phageweb/dron/spec/realna_stavba_dronu/README.md

# Reálná stavba OpenIPC cinewhoopu

Tato větev popisuje fyzickou stavbu plánovaného 3" cinewhoopu. Je oddělená od obecné ROS 2 části, protože hardware má jiné otázky: mechanika, napájení, firmware, pájení, bezpečnost a postupné oživování.

## Cílová konfigurace

- Rám: GEPRC CineLog30 V3
- Typ: 3" ducted cinewhoop
- Konfigurace: quad X
- Motory: 4x GEPRC SPEEDX2 1404 3850 KV
- Vrtule: 3", přibližně 76.2 mm
- FC/ESC: MicoAir H743 V2 45A AIO
- Firmware: cílově ArduPilot
- Baterie: 4S LiHV Tattu 750 mAh
- RC: ExpressLRS, SpeedyBee ELRS Nano RX
- Video: RunCam WiFiLink 2 s OpenIPC
- Indoor senzory: MicoAir MTF-02P optical flow + downward rangefinder/lidar
- Přední obstacle senzor: **LDRobot LD06**, 360° 2D lidar, vybraný kvůli SLAM
  ([rozhodnutí](../../workflow/decisions.md)). Není volitelný a není zadarmo —
  s ním je sestava 294 g a v ní pak není místo na palubní počítač, který by sken
  dostal do ROS 2; rozbor je v
  [Kudy se sken dostane do ROS 2](./09_kudy_do_ros.md)

**Druhý drak.** Ta hmotnost vedla k nacenění alternativního rámu: tentýž náklad
na **BetaFPV Pavo20 Pro** ve 4S provedení vyjde na 219 g a o 3 423 Kč levněji.
Díly z Rotoramy CZ jsou už koupené, viz [Nakoupeno](./13_nakoupeno.md).
Létá v simulaci proti stejným checkům. Viz [Pavo20 jako nosič LD06](./10_pavo20.md)
a [Kusovník Pavo20 Pro](./11_kusovnik_pavo20.md).

## Cíl reálné větve

Postavit fyzický dron tak, aby:

- bezpečně letěl jako ručně ovladatelný cinewhoop
- měl ArduPilot na reálném flight controlleru
- poskytoval data použitelná pro ROS 2 companion computer
- měl stejné nebo snadno remapovatelné ROS topics jako simulace
- umožnil pozdější SLAM, VIO, OpenCV a OpenIPC experimenty

## Co sem nepatří

- obecné učení ROS graphu
- obecné publisher/subscriber demo
- čistě simulační Gazebo fyzika
- Nix flake jako jediný problém

Tyto věci jsou ve větvi [ROS 2 na NixOSu](../ros2_nixos/README.md).

## Bezpečnostní zásada

Všechny bench testy flight controlleru, ESC, motorů, ArduPilot konfigurace a ROS komunikace se dělají bez vrtulí. Vrtule se nasazují až po ověření směru motorů, failsafe, arm/disarm, RC linku a základního režimu letu.

## Dokumenty této větve

- [Plán stavby](./01_plan_stavby.md) - fáze od potvrzení komponent po první let
- [Rozhraní simulace vs. reálný dron](./02_rozhrani_sim_real.md) - co se nesmí lišit
- [Tabulka komponent](./03_komponenty.md) - hmotnosti, napětí, konektory, datová rozhraní
- [Bench checklist bez vrtulí](./04_bench_checklist.md) - celé oživení až po první nasazení vrtulí
- [Díly pro CAD model](./05_cad_dily.md) - geometrie a montáž, na rozdíl od kusovníku
- [Kde se co koupí](./06_nakup.md) - nákupní seznam, ceny a dostupnost
- [Alternativy a zkušenosti](./07_alternativy_a_zkusenosti.md) - k čemu se dá u každého dílu sáhnout a co s tím lidé zažili
- [Kalkulace dopravy](./08_kalkulace_dopravy.md) - co se vyplatí dovézt a co ne, CZ vs AliExpress vs Allegro
- [Kudy se sken dostane do ROS 2](./09_kudy_do_ros.md) - cesty ven, které padly, a co zbývá: OSD na koupených čipech
- [Pavo20 jako nosič LD06](./10_pavo20.md) - co by stálo dostat lidar i video pod 250 g
- [Kusovník Pavo20 Pro](./11_kusovnik_pavo20.md) - co koupit, kde a za kolik, rozdělené na dvě etapy
- [Nakoupeno](./13_nakoupeno.md) - co už je zaplacené, za kolik, a co z kusovníku chybí
- [Postup stavby Pavo20 Pro](./14_postup_stavby_pavo20.md) - od firmwaru po první let, s piny a parametry
- [Test linky pro sken](./15_test_linky_skenu.md) - OSD Walksnailu a Bluetooth modul: co se měří a co kam zapojit; AIO vlastní Bluetooth nemá

## Návaznost na simulaci

Reálná stavba má držet stejné logické rozhraní jako simulace:

```text
/openipc_cinewhoop/imu
/openipc_cinewhoop/range/down
/openipc_cinewhoop/scan/front
/openipc_cinewhoop/camera/image_raw
/openipc_cinewhoop/odom
/ap/*
```

Detaily jsou v [rozhraní simulace vs. reálný dron](./02_rozhrani_sim_real.md).
