phageweb/dron/model/stazene/README.md

# Stažené modely

Podklady pro TPU věž Pavo20 s Walksnail Ascent Lite+ (viz
[kusovník](../../spec/realna_stavba_dronu/11_kusovnik_pavo20.md#co-se-musí-vyrobit)).
Ani jeden nesedí na Lite+ beze změny. Staženo z Printables 12. 10. 2026.
Cockpit (ASCII STL, 43 MB) není v gitu, při potřebě stáhnout znovu z odkazu.
Pořadí a další kandidáti jsou v `nejvhodnejsi_modely.txt`.

| Složka | Model | Autor | Licence | K čemu |
|---|---|---|---|---|
| `pavo20-ascent-cockpit/` | [Pavo20 Ascent Cockpit](https://www.printables.com/model/1689368-pavo20-ascent-cockpit) | Kurukuru | Open Community License v1 | Na rám Pavo20 Pro a kameru Ascent. Díry pro VTX jsou 25 mm (Lite), Lite+ potřebuje 20 × 20. ~8 g, tvrdý plast, 8 M2 zalisovaných vložek. |
| `pavo-20-pro-canopy-fenouil/` | [Pavo 20 pro canopy](https://www.printables.com/model/1577601-pavo-20-pro-canopy) | Fenouil | CC Public Domain | Pro O4 Lite. Obsahuje **STEP**, takže je to základ pro vlastní věž: úchyty k rámu, sklony kamery 7–47°. |
| `walksnail-ascent-lite-tinywhoop-canopy/` | [Walksnail Ascent Lite Tinywhoop Canopy](https://www.printables.com/model/1525645-walksnail-ascent-lite-tinywhoop-canopy) | P3D | CC BY-SA | Obecný pro whoopy, ne pro Pavo20. TPU, 0,76 g, sklon 25°. |
