phageweb/dron/spec/realna_stavba_dronu/14_postup_stavby_pavo20.md

# Postup stavby Pavo20 Pro

Celý postup od krabic na stole po první let, pro díly, které jsou opravdu
koupené — viz [Nakoupeno](./13_nakoupeno.md). Obecná pravidla a stop podmínky
jsou v [bench checklistu](./04_bench_checklist.md); tenhle soubor je jeho
konkrétní pořadí pro tuhle sestavu, s piny a parametry.

Pravidlo platí i tady: **když krok neprojde, další se nezačíná.** A vrtule se
nasazují až v kroku 9.

Parametry jsou ověřené z dokumentace ArduPilotu a karty MicoAir k 2. 10. 2026,
ne na kusu. Kde to tak není, je to napsané.

## Stav na stole k 21. 10. 2026

Deska 2 (`49002F…`), ArduCopter 4.7.1 (git `dbe79216`, ověřeno 21. 10. přes
`AUTOPILOT_VERSION`), zdroj 14–16 V nebo baterie 4S.
Parametry jsou v
[`deska2_na_stole_2026-10-21.parm`](../../firmware/params/deska2_na_stole_2026-10-21.parm),
po motor testu, BDShot, gainech a baterii v
[`deska2_po_motorech_2026-10-21.parm`](../../firmware/params/deska2_po_motorech_2026-10-21.parm).

Hotovo a vyzkoušené:

- **XR1 na UART6** (`SERIAL6_PROTOCOL 23`, `RSSI_TYPE 3`), spárovaný s TX15,
  16 kanálů, RSSI 254. Kalibrace RC v QGC; QGC sám obrátil pitch
  (`RC2_REVERSED 1`).
- **Přepínače na TX15:** **SE** → CH5 → arm/disarm (`RC5_OPTION 153`),
  **SA** → CH6 → režimy (`FLTMODE_CH 6`): nahoře Stabilize, uprostřed
  AltHold, dole Loiter. CH7 a CH8 zatím bez funkce.
- **Akcelerometr** v 6 polohách. `AHRS_TRIM_X` vyšel 3,5°, deska ještě nebyla
  v rámu — **Level Horizon zopakovat po přišroubování**.
- **Arm/disarm** přepínačem SE, motory na volnoběhu (`MOT_SPIN_ARM 0.1`).
- **Failsafe:** vypnutý TX15 → `Radio Failsafe - Disarming`.
- **Baterie 4S:** `BATT_LOW_VOLT 14.0`, `BATT_CRT_VOLT 13.2`,
  `BATT_FS_LOW_ACT 1`, `BATT_FS_CRT_ACT 1`. Battery failsafe zůstává
  zapnutý až do restartu FC, i když napětí vystoupá.
- **ESC (AM32 2.19)** srovnaná na stejné hodnoty a **směry motorů** ověřené,
  viz krok 5.

Dočasně vypnuto, aby šel arm bez GPS a lidaru. Při zapojování vrátit:

| Parametr | Teď | Původně |
| --- | --- | --- |
| `GPS1_TYPE` | 0 | 1 |
| `COMPASS_ENABLE` | 0 | 1 |
| `PRX1_TYPE` | 0 | 15 (lidar přes Lua skript) |
| `EK3_SRC1_POSXY` / `VELXY` / `YAW` | 0 / 0 / 0 | 3 / 3 / 1 |

Bez zdroje polohy poletí jen Stabilize a AltHold, do Loiteru FC nepřepne.

Nesoulad s rozvržením UARTů níže: lidar má Scripting na **SERIAL4**
(`SERIAL4_PROTOCOL 28`), SERIAL5 je vypnutý — UART4 je přitom určený pro
MTF-02P. Ověřit, na kterém padu lidar fyzicky je.

## 0. Příprava

- [ ] Každý díl zvážit (váha s rozlišením 0,01 g) a hmotnost zapsat do
      [Nakoupeno](./13_nakoupeno.md). Žádná hmotnost v projektu ještě zvážená
      není — teď je jediná chvíle, kdy jde vážit díly jednotlivě.
- [ ] Baterie: změřit napětí článků, nabít na storage (LiHV kolem 3,85 V na
      článek), uložit v lipo bagu.
- [ ] Laboratorní zdroj: kabel zakončený XT30 samicí, polarita ověřená
      multimetrem.

## 1. Firmware — jen přes USB

Deska se napájí z USB, baterie ani zdroj nejsou potřeba.

- [ ] Target **`MicoAir743v2`** (MicoAir pro desku *MicoAir743v2-AIO-45A*;
      ArduPilot ho podporuje od 4.6.0). Firmware:
      `firmware.ardupilot.org/Copter/stable-4.7.1/MicoAir743v2/`.
- [ ] Nahrát ArduCopter 4.7.1 podle [`firmware/`](../../firmware/README.md) —
      flake s připnutým firmwarem a nástroji:

      ```sh
      nix run ./firmware#flash      # na desce už je ArduPilot
      nix run ./firmware#flash-dfu  # Betaflight z výroby: držet BOOT, připojit USB
      ```
- [ ] `FRAME_CLASS 1`, `FRAME_TYPE 1` (quad X), restart.
- [ ] Parametry uložit do souboru **před** jakoukoli další změnou.
- [ ] Gyro v klidu kolem nuly, barometr reaguje na zvednutí ze stolu.
      Akcelerometr až v kroku 6, v sestaveném dronu — holá deska na USB se
      do bočních poloh nedá postavit, konektor ji podpírá a vypadává.

## 2. Mechanika nasucho

- [ ] Rám složit bez pájení. **Ověřit, že je to Pavo20 Pro, ne Pro II**
      ([rozdíl](./10_pavo20.md#pro-versus-pro-ii)).
- [ ] Motory A1204 na ramena (díry 9 mm, M2). **Protočit rukou a změřit
      mezeru zvonu proti ductu** — A1204 je o 1,2 mm širší než 1104, na který
      je rám dělaný. Drhne-li, dál se nejde.
- [ ] Délka šroubů motoru: šroub nesmí sáhnout do vinutí. Změřit, ne odhadnout.
- [ ] AIO na soft-mountech, šipkou nahoru. Díry 26 × 26 v karbonu a vložky
      v ductu tvoří kosočtverec (vpředu, vzadu, po stranách), takže deska je
      **natočená o 45°**. USB-C šikmo dozadu vlevo, k motoru 2: pady baterie
      pak míří dozadu vpravo, konektor HD VTX dopředu vpravo a šipka vlevo
      dopředu, tedy `AHRS_ORIENTATION 7` (Yaw315). Odvozeno z výkresů BetaFPV
      a MicoAir, ověřit na kusu. USB-C musí být v sestaveném rámu dostupný.
- [ ] Šroub M2×14 shora: karbon, matka, tlumič AIO delším koncem nahoru, AIO,
      kratší konec, matka, mosazná vložka v ductu. Pod spodní maticí aspoň
      3–4 mm závitu, jinak spodní matku vynechat.
- [ ] Zkusmo umístit: XR1, GPS, MTF-02P (dolů, **mimo půdorys baterie**),
      kameru Lite+ a VTX. Kde co bude, rozhoduje o délkách vodičů v kroku 3.
- [ ] Baterii 750 mAh zasunout do slotu a zkontrolovat, že sedí a nic netlačí.

## 3. Pájení napájení a motorů

- [ ] XT30 přívod a kondenzátor (oboje přibalené k AIO) na hlavní pady.
      Polarita podle desky, ne podle barvy kabelu.
- [ ] Motorové vodiče zkrátit na délku a připájet na pady M1–M4. Pořadí
      vodičů jednoho motoru je jedno — směr se nastaví softwarově v kroku 5.
- [ ] Vizuálně: žádný cínový můstek, nic se nedotýká karbonu.
- [ ] **Multimetrem mezi + a − XT30: žádný zkrat** (pod ~10 Ω = stop).
- [ ] První napájení z **laboratorního zdroje: 16 V, limit 0,3–0,5 A**. Proud
      v klidu jsou desetiny ampéru; skočí-li hned na limit a napětí spadne,
      je zkrat — odpojit a hledat.
- [ ] Změřit **5V BEC** (5,0 V ± 0,2) a **12V BEC**. Hodnotu 12V BEC zapsat —
      podle ní se v kroku 7 rozhodne, jestli na něj smí Lite+ (strop 12,6 V).

## 4. Přijímač XR1 Nano

| XR1 | AIO |
| --- | --- |
| 5V | 5V |
| GND | GND |
| TX | RX6 |
| RX | TX6 |

- [ ] Parametry: `SERIAL6_PROTOCOL 23` (RCIN), `RSSI_TYPE 3`.
- [ ] Stejná hlavní verze ELRS v TX15 a v XR1. Binding phrase nastavit v obou
      (XR1 přes WiFi: ~60 s bez spojení, pak `10.0.0.1`).
- [ ] Kalibrace RC. Roll, pitch, throttle, yaw jdou správným směrem.
- [ ] Kanál na arm/disarm (`RCx_OPTION 153`) a na letové režimy
      (`FLTMODE_CH`): Stabilize, AltHold, Loiter.
- [ ] `FS_THR_ENABLE 1`. **Vypnout TX15 → FC musí hlásit failsafe.** Bez toho
      dál ne.

## 5. Motory bez vrtulí

Teď už z baterie (nebo ze zdroje s limitem zvýšeným na 2–3 A). Dron přidržet.

- [x] `MOT_PWM_TYPE 6` (DShot600). Bidirectional DShot (`SERVO_BLH_BDMASK 15`,
      `SERVO_BLH_POLES 14`) jen pokud ho target na výstupech 1–4 umí —
      počet pólů ještě ověřit spočítáním magnetů ve zvonu. Umí (`BIDIR` na
      TIM1 v hwdef) a funguje, zapnuto 21. 10. Dvě pasti:
      - AM32 pozná bidirectional režim jen při svém startu. Po změně
        `SERVO_BLH_BDMASK` nestačí restart FC, musí se odpojit baterie i USB.
      - Se sinusovým rozběhem hlásí AM32 na nízkém plynu otáčky 0 (motor
        běží naslepo, bez back-EMF). Na 5 % nula, na 15 % motor test
        5 040–5 510 ot./min na všech čtyřech, s nulovou chybovostí v logu
        (`ESC.Err`). Telemetrie v `ESC_TELEMETRY_1_TO_4` je podle výstupů:
        A = 1, C = 2, D = 3, B = 4.
- [x] Motor test v QGC/Mission Planneru, 5–10 % plynu: test A musí roztočit
      **přední pravý**, B zadní pravý, C zadní levý, D přední levý (ArduPilot
      testuje po obvodu). Nesedí-li to, přeházet `SERVO1..4_FUNCTION`
      (33–36), ne pájet znovu. Sedí s výchozími `SERVO1..4_FUNCTION`
      33–36 (21. 10., z baterie 4S, 7 % po 2 s a po 10 s, pymavlink
      `MAV_CMD_DO_MOTOR_TEST`).
- [x] Směry: přední pravý a zadní levý **CCW**, přední levý a zadní pravý
      **CW** (pohled shora). Pravidlo, které platí i při pohledu zespodu:
      lopatky na předku i na zadku dronu jdou **ke středové ose**.
      `SERVO_BLH_RVMASK` na AM32 2.19 nefunguje (zkoušeno 21. 10.), otáčí se
      v ESC: **Reverse Rotation na M3 a M4** (výstup 3 = přední levý D,
      výstup 4 = zadní pravý B).
- [x] ESC srovnaná na výrobní hodnoty + sinusový rozběh, na všech čtyřech:
      Complementary PWM ☑, Stuck Rotor Protection ☑, Sinusoidal Startup ☑,
      Variable PWM ☑, Timing 14,06, KV 5220, 14 pólů, Startup Power 100.
      Dřív se lišila (M2 bez Complementary PWM se točil znatelně rychleji).
      Webové configuratory AM32 2.19 neumí, jen desktopový ESC Config Tool
      1.97 (`appimage-run`); po jeho zavření zůstane FC v passthrough a
      potřebuje restart napájení.
- [x] `MOT_SPIN_ARM` a `MOT_SPIN_MIN` z motor testu: nejnižší hodnota, kdy se
      všechny čtyři točí spolehlivě, + rezerva. Bez vrtulí se to zjistit
      nedá: 21. 10. se všechny čtyři točily plynule i na 1 % (po 6 s), AM32
      se sinusovým rozběhem roztočí motor bez zátěže skoro na čemkoli.
      Zůstává výchozí `MOT_SPIN_ARM 0.10`, `MOT_SPIN_MIN 0.15`; snížit až
      podle logu z letu (klesání, desync).
- [ ] Nic se nepřehřívá, nedrhne, nehrká.

## 6. Senzory

**Akcelerometr** (dron složený, AIO na soft-mountech, bez baterie, jen USB):

- [ ] Kalibrace v 6 polohách na hranách rámu, pak level na rovném stole.
      Bez ní ArduPilot neodjistí (`3D Accel calibration needed`).
- [ ] Natočení desky sedí s `AHRS_ORIENTATION`: při nose-down ukazuje
      umělý horizont nos dolů, při náklonu doprava náklon doprava.

**MTF-02P** (optical flow + dolní rangefinder):

- [ ] Nejdřív v MicoAssistant změnit `mav_id` na 200 — od ArduPilotu 4.5
      ho jinak nemusí poznat.
- [ ] Zapojit na UART4: 5V, GND, TX → RX4, RX → TX4.
- [ ] `SERIAL4_PROTOCOL 1`, `SERIAL4_BAUD 115`, `FLOW_TYPE 5`,
      `RNGFND1_TYPE 10`, `RNGFND1_MIN 0.01`, `RNGFND1_MAX 6`,
      `RNGFND1_ORIENT 25`. Od 4.7 `MAV4_OPTIONS 2`, dřív `SERIAL4_OPTIONS 1024`.
- [ ] Výška nad stolem sedí s pravítkem ve dvou výškách; flow reaguje na ruční
      posun; při točících se motorech (bez vrtulí) nevypadává.

**GPS M181 s kompasem:**

- [ ] UART3: 5V, GND, TX → RX3, RX → TX3; kompas na SDA/SCL.
- [ ] `SERIAL3_PROTOCOL 5`. Kompas nakalibrovat **v sestaveném dronu**.
- [ ] Rozhodnout, co s kompasem uvnitř: checklist říká vypnout, jenže EKF bez
      kompasu nemá yaw pro Loiter na flow. Pro první lety (Stabilize,
      AltHold) to jedno je — **otevřená otázka**, zapsat výsledek.

## 7. Video Walksnail Lite+

- [ ] **Napájení: nikdy z baterie.** 12V BEC jen pokud v kroku 3 naměřil
      nejvýš ~12,3 V. Jinak řešit (dioda, samostatný BEC) dřív, než se pájí.
- [ ] Zapojit na UART2: 12V, GND, TX → RX2, RX → TX2 (OSD).
- [ ] `SERIAL2_PROTOCOL 42` (DisplayPort), `SERIAL2_BAUD 115`, `OSD_TYPE 5`,
      `MSP_OPTIONS 4` (Betaflight fonty).
- [ ] Spárovat s **VRX Pro**, obraz přes HDMI na monitor/brýle. **Anténu
      připojit vždy dřív, než se VTX zapne.**
- [ ] Kameru a VTX upevnit — dočasně, dokud není [TPU věž](./11_kusovnik_pavo20.md#co-se-musí-vyrobit).

## 8. Baterie a failsafe

Hodnoty ze simulace (`ardupilot_params_pavo20.parm`):

- [ ] `BATT_MONITOR 4`; napětí na desce porovnat s multimetrem, případně
      opravit `BATT_VOLT_MULT`. Proud ověřit až za letu.
- [x] `BATT_LOW_VOLT 14.0`, `BATT_CRT_VOLT 13.2`, `BATT_FS_LOW_ACT 1`,
      `BATT_FS_CRT_ACT 1`, `BATT_LOW_TIMER 10` — přistát, ne vracet se.
- [x] Rate gainy ze simulace (`ATC_RAT_RLL/PIT_P 0.060` atd.) brát jako
      **strop**, ne startovní hodnotu: simulace nemá šum gyra ani rezonance
      rámu. **Nepřebírat** `MOT_PWM_MIN/MAX`, `MOT_THST_EXPO 1.0` a `SIM_*` —
      to jsou hodnoty modelu, ne dronu. Nastaveno 21. 10. místo výchozích:
      roll/pitch P 0,060, I 0,060, D 0,0005 (bylo 0,135 / 0,135 / 0,0036),
      yaw P 0,023, I 0,0023 (bylo 0,18 / 0,018).
- [x] `BATT_CAPACITY 750` (bylo 3300; s 550mAh baterií procenta nesedí).
      Kompenzace napětí pro LiHV 4S: `MOT_BAT_VOLT_MAX 17.4`,
      `MOT_BAT_VOLT_MIN 13.2`.
- [x] Pro spektrum po prvním letu: `INS_LOG_BAT_MASK 1`,
      `INS_LOG_BAT_OPT 4` (gyro před filtrem i po něm).

## 9. Vrtule a první let

- [ ] **42g maketa LD06** na místě lidaru — ladí se jednou, s ní.
- [ ] Vrtule Gemfan 2218 podle směrů z kroku 5.
- [ ] Venku nebo ve velké místnosti, nikdo v dosahu. Arm ve Stabilize, krátký
      visení nízko. Kmitá-li, přistát a snížit `ATC_RAT_*_P`.
- [ ] Failsafe znovu za letu: vypnout TX15 v metru nad zemí.
- [ ] Teprve pak AltHold, pak AutoTune, pak Loiter na flow.
- [ ] Po letu: log, harmonic notch (`INS_HNTCH_*`) podle spektra, výdrž proti
      odhadu 4,0 min.

## 10. Etapa B — LD06

- [ ] Kabel ZH1.5T-4P → AIO, jen TX lidaru → RX5 (nebo RX8), 5V, GND.
- [ ] `SERIAL5_PROTOCOL 11` (Lidar360), `SERIAL5_BAUD 230`, `PRX1_TYPE 16`,
      `PRX1_ORIENT 0`.
- [ ] Přeměřit 5V větev při rozběhu lidaru (300 mA).
- [ ] Maketu vyměnit za lidar; hmotnost a těžiště se nemění, gainy zůstávají.

## Rozvržení UARTů

| UART | Výchozí v ArduPilotu | Tady |
| --- | --- | --- |
| 1 | MAVLink2 | volný (telemetrie, palubní počítač) |
| 2 | DisplayPort | Walksnail Lite+ OSD |
| 3 | GPS | M181 |
| 4 | MAVLink2 | MTF-02P |
| 5 | — | LD06 (etapa B) |
| 6 | RCIN | XR1 Nano |
| 8 | — | volný |

Mapování UARTů je z karty MicoAir; **které pady na desce jsou který UART,
ověřit na potisku a pinoutu desky** dřív, než se pájí.
