phageweb/dron/spec/realna_stavba_dronu/11_kusovnik_pavo20.md

# Kusovník Pavo20 Pro

Co koupit na indoor mapovací cinewhoop postavený na rámu **BetaFPV Pavo20 Pro**
ve 4S provedení, se stejnou nosností jako CineLog30 V3 — LD06, MTF-02P — a
s videem **Walksnail Ascent Lite+** místo původního EMAX Wyvern. Úvaha, proč
zrovna tenhle drak a co to stojí, je vedle v
[Pavo20 jako nosič LD06](./10_pavo20.md); tenhle soubor je jen nákupní seznam.

Ceny a skladovost ověřené **13. 9. 2026** přímo z karet zboží. Kurzy ČNB
11. 9. 2026: 1 € = 24,26 Kč, 1 $ = 20,93 Kč. **Hmotnosti jsou publikované,
žádná není zvážená.**

Etapa A jsou **dvě české objednávky plus Walksnail Ascent Lite+**, který
Rotorama CZ k 28. 9. 2026 nevede (má jen obyčejný Ascent Lite Kit) — cena je
zatím výrobcova. Dovoz je jinak potřeba jen na lidar, protože 2D lidar v téhle
váhové třídě se v ČR nevede vůbec.

**Rotorama CZ je zaplacená** a koupila se v ní jiná baterie, než tu stálo —
co přesně přišlo, je v [Nakoupeno](./13_nakoupeno.md). Tabulky níž počítají
s tím, co se opravdu koupilo.

## Etapa A — létající stroj

| Díl | Ks | Hmotnost | Cena | Kde | Stav |
| --- | ---: | ---: | ---: | --- | --- |
| [BetaFPV Pavo20 Pro, rám pro O3](https://www.hobbydrone.cz/cs/frame-betafpv-pavo20-for-o3-air-unit-clear-grey/) | 1 | 28,70 g | 353 Kč | hobbydrone.cz | koupeno |
| [Flashhobby A1204 5200KV](https://www.rotorama.cz/product/flashhobby-a1204-5200kv) | 4 | 24,80 g | 1 076 Kč | Rotorama CZ | koupeno |
| [Gemfan 2218-3, 12 ks](https://www.rotorama.cz/product/gemfan-2218) | 1 | 2,32 g | 179 Kč | Rotorama CZ | koupeno |
| [MicoAir H743 V2 45A AIO](https://www.rotorama.cz/product/micoair-h743-v2-45a-aio-am32) | 1 | 10,00 g | 2 090 Kč | Rotorama CZ | koupeno |
| [Radiomaster XR1 Nano ELRS](https://www.rotorama.cz/product/radiomaster-xr1-nano-elrs-dual) | 1 | 1,60 g | 349 Kč | Rotorama CZ | koupeno |
| MicoAir MTF-02P | 1 | 1,50 g | 499 Kč | Rotorama CZ | koupeno |
| [Walksnail WS-M181 GPS s kompasem](https://www.rotorama.cz/product/walksnail-ws-m181-gps-s-kompasem) | 1 | 4,30 g | 429 Kč | Rotorama CZ | koupeno |
| [Walksnail Ascent HD Lite+ Kit](https://www.caddxfpv.com/products/walksnail-ascent-hd-lite-plus-kit), kamera + VTX | 1 | 10,50 g | 837 Kč | caddxfpv.com | objednáno, 39,99 $ |
| [Tattu R-Line 750 mAh 4S 95C HV, XT30](https://www.rotorama.cz/product/tattu-r-line-750mah-4s-95c-hv) | 1 | 69,00 g | 529 Kč | Rotorama CZ | koupeno |
| [Tattu 550 mAh 4S 95C HV, XT30](https://www.rotorama.cz/product/tattu-550mah-4s-95c-hv), záložní | 1 | — | 419 Kč | Rotorama CZ | koupeno |
| TPU věž pro Lite+ a stožár lidaru | 1 | 11,00 g | — | tiskárna | odhad |
| Kabeláž, šrouby, pásek | — | 13,36 g | — | dílna | odhad |
| **Etapa A** | | **177,08 g** | **6 760 Kč** | 3 zásilky | |

Hmotnost počítá s 750mAh packem, protože se s jedním letí. Cena je za oba.
Původně tu byly tři 850mAh packy po 76 g; koupené jsou dva různé. S LD06 dá
750 mAh zhruba **4,0 minuty** užitečného letu, 550 mAh (57 g) **3,2 minuty** —
stejná metoda jako v [Pavo20 jako nosič LD06](./10_pavo20.md#tah-a-výdrž).
Při téhle výdrži je jeden pack jeden pokus, takže **třetí pack ještě chybí**.
Packy se liší o 12 g a tvarem, tedy i těžištěm — ladit na 750, na 550 jen
ověřit, že stroj drží.

## Etapa B — lidar, až stroj létá

| Díl | Ks | Hmotnost | Cena | Kde | Stav |
| --- | ---: | ---: | ---: | --- | --- |
| [LDRobot LD06](https://sunhokey.cn/products/dtof-lidar-ld06) | 1 | 42,00 g | 1 580 Kč | dovoz CN | až po kontrole štítku |
| **Finální stroj** | | **219,08 g** | **8 340 Kč** | 4 zásilky | |

**Do etapy A patří 42g maketa lidaru.** Bez ní letí stroj na 177,1 g s tahem
k váze 4,6; s lidarem na 219,1 g a 3,7. To je o pětinu jiný stroj, jiné
těžiště, jiná setrvačnost, jiné gainy. S maketou se ladí jednou.

## Textově za sebou

Rám Pavo20 Pro bez držáku O3 28,70 g · motory 4× Flashhobby A1204 5200KV
24,80 g · vrtule Gemfan 2218 (sada) 2,32 g · MicoAir H743 V2 45A AIO 10,00 g ·
Walksnail Ascent Lite+ 10,50 g · Radiomaster XR1 Nano ELRS 1,60 g ·
MicoAir MTF-02P 1,50 g · Walksnail WS-M181 GPS 4,30 g · TPU věž a stožár
11,00 g · kabeláž, šrouby a pásek 13,36 g · baterie Tattu 750 mAh 4S LiHV
69,00 g — **etapa A 177,08 g**; plus LDRobot LD06 42,00 g —
**celkem 219,08 g**.

## Objednávky

| Zásilka | Co v ní je | Zboží | Doprava | Sazba |
| --- | --- | ---: | ---: | --- |
| Rotorama CZ | motory, vrtule, AIO, přijímač, MTF-02P, GPS, 2× baterie | 5 570 Kč | 49 Kč | **zaplaceno** |
| caddxfpv.com | Walksnail Ascent Lite+ | 837 Kč | ? | **objednáno**, doprava neznámá |
| hobbydrone.cz | rám Pavo20 Pro | 353 Kč | 99 Kč | odhad |
| Sunhokey, CN (etapa B) | LDRobot LD06 | 1 580 Kč | 419 Kč | odhad |
| **Celkem** | 4 zásilky, z toho 3 hned | **8 340 Kč** | **567 Kč** + Caddx | **8 907 Kč** + doprava Caddx |

Proti CineLogu, který v konsolidované variantě vychází na 12 330 Kč v **pěti**
zásilkách, je to o **3 423 Kč méně** (bez dopravy od Caddx) a o jednu zásilku. Těch
12 330 Kč je i s dopravou, takže se porovnávají s 8 907 Kč, ne se zbožím.
Vybavení dílny z téže objednávky (1 975 Kč) v tom není. Kusovník CineLogu tak, jak
byl napsaný, stojí 12 548 Kč v šesti — varianty a jejich rozpad jsou
v [Kalkulaci dopravy](./08_kalkulace_dopravy.md).

## Co se musí vyrobit

- **TPU věž** nesoucí Walksnail Lite+ a nahoře plošinu pro LD06: vpředu klec
  pro 14mm nano kameru se sklonem, uprostřed sloupky 20 × 20 M2 pro VTX, úchyt
  IPEX antény. Místo klece jde i hotový adaptér 14 → 19 mm do stock držáku
  kamery (19/20 mm). Nahrazuje 4,6g držák
  O3, který se stejně nepoužije. **Navrhnout dřív, než se cokoli objedná** — je
  to jediná věc, která o téhle stavbě ještě rozhoduje.
- **Maketa LD06** 38,6 × 38,6 × 33,3 mm dovážená na 42 g, pro etapu A.
- **Kabel LD06** z konektoru ZH1.5T-4P (rozteč 1,5 mm) na JST-SH 1,0 mm nebo
  přímo na pájecí plošky. Koupit protikus s vodiči a zakončení upravit.
- **Spodní držák MTF-02P** mimo půdorys baterie — ta visí zespodu ve slotu a
  18 mm široká by senzoru stála přesně ve výhledu dolů.

## Co nekupovat

- **Hotový Pavo20 Pro.** Stock F4 je 2-3S a AP_DDS na něm neběží. Kupuje se rám.
- **Motory 7200KV ani 7500KV.** Jsou na 3S; na 4S je upálíš a 3S stojí třetinu
  doletu.
- **1104 motory s roztečí 8,5 mm.** DarwinFPV Bling 1104 5000KV je skladem a KV
  sedí, ale má díry 8,5 mm M1,6 proti rámovým **9 mm M2**. Nepřišroubuje se.
- **Díly z Pavo20 Pro *II* k tomuhle rámu.** Je to jiný rám — rozvor 93,9 mm
  proti našim 93,7 — a BetaFPV sám píše, že s deskou z Pro II *„may cause the
  propellers to contact the duct during flight"*. Rozteč FC 26 × 26, motory
  9 mm M2 i slot baterie 20 mm mají oba stejné, takže se to plete snadno;
  u ductů a horní desky se to ale plést nesmí. Srovnání obou rámů je v
  [Pavo20 jako nosič LD06](./10_pavo20.md#pro-versus-pro-ii).
- **Palubní počítač** zatím ne — ale pozor: s Walksnailem **padá cesta poslat
  UART z LD06 dolů přes video jednotku**. Ascent přenáší jen obraz a OSD, IP ani
  datový kanál nemá. Zbývají znaky v OSD Walksnailu — na koupených
  čipech — nebo přikoupený Bluetooth modul — viz [Test linky pro sken](./15_test_linky_skenu.md) a
  [Kudy se sken dostane do ROS 2](./09_kudy_do_ros.md).
- **LD19 ani D300.** Ověřeno: LD19 je tentýž senzor jako LD06, jen s montážní
  deskou navíc — o 5 g těžší, jinak beze změny, a doběhový. D300 je LD19 plus
  USB deska. Ani jedno nepřináší nic.
  **Co koupit místo toho zvážit, je D500 (STL-19P)**: za stejnou cenu novější
  senzor, stejný půdorys i konektor, +4 g. Viz
  [alternativy](./07_alternativy_a_zkusenosti.md#lidar-rodina-ldrobot--ld06-ld19-d300-d500).

## Vybavení mimo letovou hmotnost

Balanční nabíječka s režimem **LiHV 4S** (koncové napětí 17,4 V) je koupená —
ToolkitRC M6AC umí LiHV 1–6S. Vysílačka taky: Radiomaster TX15 s vnitřním ELRS. Zbývá smoke stopper,
multimetr, páječka s tavidlem a tenkými vodiči a pozemní příjem
Walksnail Ascent: [Ascent VRX](https://www.rotorama.cz/product/walksnail-ascent-vrx)
za 2 549 Kč nebo Ascent Goggles za 3 990 Kč, obojí Rotorama CZ skladem k 28. 9.
2026. Starší brýle Walksnail Avatar s Ascentem nefungují. **Objednaný je
Ascent VRX Pro** od Caddx za 149 $, spolu s Lite+. Nic z toho není
započítané do ceny dronu.

**Lite+ nesmí na baterii.** Snese 3–12,6 V, tedy nejvýš nabitou 3S; 4S LiHV má
17,4 V. Napájet z **12V BEC H743** (2 A, podle karty MicoAir pro O3/O4) —
9–10V výstup deska nemá. 12 V je v rozsahu Lite+, ale jen 0,6 V pod jeho
stropem, takže před připojením VTX změřit, kolik BEC skutečně dává.

## Co je ověřené a co ne

| | |
| --- | --- |
| **Koupeno** | Všechno z Rotoramy CZ, viz [Nakoupeno](./13_nakoupeno.md). Hmotnost a rozměry 750 a 550mAh packu z jejich karet zboží k 2. 10. 2026. |
| **Ověřeno** | Ceny, skladovost, hmotnosti a rozměry z karet zboží Rotorama CZ a hobbydrone.cz k 13. 9. 2026, rám hobbydrone.cz znovu 29. 9. 2026. Sazba dopravy Rotoramy. Rozteč FC 26 × 26 ze tří nezávislých zdrojů. Že tenhle rám je **Pavo20 Pro, ne Pro II**, a v čem se ty dva liší — z katalogu BetaFPV a karty hobbydrone.cz k 14. 9. 2026. |
| **Publikováno** | Všechny hmotnosti jsou vendorové nebo prodejcovy, žádná zvážená. |
| **Odvozeno** | Tah 202 g/motor Flashhobby nepublikuje. Dopočítaný stejnou metodou jako v modelu: stejný Ct vrtule 2218, otáčky z KV při 61 % nezatížených. |
| **Odhad** | Doprava mimo Rotoramu, u Caddx neznámá. Cena Lite+ je výrobcova v dolarech, ne česká. TPU věž 11 g a kabeláž 13,36 g. |
| **Otevřené** | TPU věž není navržená. Kudy teď sken z LD06 do ROS 2, když Walksnail datový kanál nemá — kandidát OSD, záloha přikoupený Bluetooth, [test](./15_test_linky_skenu.md) neproběhl. Kolik skutečně dává 12V BEC H743, Lite+ má strop 12,6 V. Výdrž 4,0 a 3,2 min je ideální výkon poměrem proti referenci, bez spotřeby Lite+. A1204 je o 1,2 mm širší než 1104, na který je rám dělaný — patka sedí, zvon je potřeba přeměřit. Baterie trčí 28 mm pod ducty, takže na ní dron přistává; stock pack je menší. Těch 28 mm platilo pro 850mAh pack vysoký 32 mm — 750 má 28 mm, a 77 mm délky proti 73. |
| **Nezměřeno** | Spotřeba Walksnail Ascent Lite+ — Caddx ji nepublikuje a je to největší spotřebič mimo motory. |
