phageweb/dron/spec/realna_stavba_dronu/13_nakoupeno.md

# Nakoupeno

Co už je doma, nebo na cestě, k [Kusovníku Pavo20 Pro](./11_kusovnik_pavo20.md).
Ceny jsou z faktury, s DPH. Recyklační příspěvky (0,84 a 3,36 Kč/ks) jsou
v cenách už obsažené. **Hmotnosti jsou pořád publikované, ne zvážené.**

## Rotorama CZ — první objednávka

| Položka | Ks | Cena s DPH | Hmotnost | Patří do |
| --- | ---: | ---: | ---: | --- |
| Flashhobby A1204 5200KV | 4 | 1 076 Kč | 24,80 g | dron |
| Gemfan 2218-3, 12 ks, šedá | 1 | 179 Kč | 2,32 g | dron |
| MicoAir H743 V2 45A AIO AM32 | 1 | 2 090 Kč | 10,00 g | dron |
| Radiomaster XR1 Nano ELRS, 2,4 GHz | 1 | 349 Kč | 1,60 g | dron |
| MicoAir MTF-02P, optical flow a lidar 6 m | 1 | 499 Kč | 1,50 g | dron |
| Walksnail WS-M181 GPS s kompasem | 1 | 429 Kč | 4,30 g | dron |
| [Tattu R-Line 750 mAh 4S 95C HV](https://www.rotorama.cz/product/tattu-r-line-750mah-4s-95c-hv), XT30, 77 × 18 × 28 mm | 1 | 529 Kč | 69,00 g | dron |
| [Tattu 550 mAh 4S 95C HV](https://www.rotorama.cz/product/tattu-550mah-4s-95c-hv), XT30, 68 × 16 × 26 mm | 1 | 419 Kč | 57,00 g | dron |
| **Díly dronu** | | **5 570 Kč** | | |
| ToolkitRC M6AC 100/300 W, nabíječka | 1 | 1 529 Kč | — | dílna |
| Readytosky Lipo bag | 1 | 169 Kč | — | dílna |
| TESA textilní izolační páska | 1 | 139 Kč | — | dílna |
| Stahovací pásky 2,5 × 150 mm, 100 ks | 1 | 79 Kč | — | dílna |
| Rotorama štípací kleště | 1 | 59 Kč | — | dílna |
| **Vybavení** | | **1 975 Kč** | | |
| GLS Parcelshop/Alzabox | 1 | 49 Kč | — | doprava |
| **Celkem** | | **7 594 Kč** | | bez DPH 6 276,03 Kč, DPH 1 317,97 Kč |

## Caddx — video

Účtované v dolarech; v korunách přepočtené kurzem ČNB z 11. 9. 2026
(1 $ = 20,93 Kč), ne skutečnou částkou z výpisu. Doprava a případné DPH
a clo při dovozu nejsou známé.

| Položka | Ks | Cena | V Kč | Hmotnost | Patří do |
| --- | ---: | ---: | ---: | ---: | --- |
| Walksnail Ascent HD Lite+ Kit, kamera + VTX | 1 | 39,99 $ | 837 Kč | 10,50 g | dron |
| Walksnail Ascent FPV VRX Pro | 1 | 149,00 $ | 3 119 Kč | — | pozemní příjem |
| **Celkem** | | **188,99 $** | **3 956 Kč** | | + doprava, DPH |

## hobbydrone.cz — rám

| Položka | Ks | Cena | Hmotnost | Patří do |
| --- | ---: | ---: | ---: | --- |
| BetaFPV Pavo20 Pro, rám pro O3 | 1 | 353 Kč | 28,70 g | dron |

Přišel za cenu z kusovníku; dopravu neznám.

## Mimo objednávky

| Položka | Cena | Patří do |
| --- | ---: | --- |
| Radiomaster TX15, vnitřní ELRS 2,4 GHz | 4 000 Kč | vysílačka |
| Laboratorní zdroj, páječka, cín | už v dílně | dílna |

**Utraceno celkem zhruba 15 903 Kč** bez dopravy rámu a bez dopravy a DPH od
Caddx, z toho 6 760 Kč za díly dronu — přesně etapa A kusovníku.

## Co z kusovníku ještě chybí

| Díl | Cena | Kde | Poznámka |
| --- | ---: | --- | --- |
| LDRobot LD06, nebo D500 | 1 580 Kč | dovoz CN | etapa B |
| **Zbývá za díly** | **1 580 Kč** | | |

Vysílačka je doma: **Radiomaster TX15** s vnitřním ELRS 2,4 GHz, se kterým
se XR1 spáruje přes binding phrase — hlavní verze ELRS musí být na obou
stranách stejná. Pozemní příjem je objednaný taky (VRX Pro), takže na zemi
nechybí nic kromě obrazovky nebo brýlí, do kterých VRX pošle obraz.
Do příští objednávky do dílny:

- **Redukce XT60 → XT30** (samice XT60 na samec XT30), aby šel dron napájet
  z nabíječky M6AC v režimu zdroje — výstup nabíječky je XT60, ověřit na kusu.
- **Smoke stopper s XT30.** Laboratorní zdroj s proudovým limitem ho na stole
  zastoupí; vlastní stopper je pro první zapojení **baterie** po pájení.
- K laboratornímu zdroji **kabel s XT30 samicí** na banánky nebo krokosvorky.

## Kde se nákup od kusovníku liší

- **Baterie.** Kusovník chtěl 3× Tattu 850 mAh (76 g, 1 647 Kč). Koupeno je
  1× 750 mAh (69 g) a 1× 550 mAh (57 g) za 948 Kč. Lehčí stroj, kratší let a
  dva různé packy — viz přepočet v kusovníku. Třetí pack chybí.
- **Doprava Rotoramy** stála 49 Kč (GLS Parcelshop), ne 89 Kč.
- **Nabíječka** M6AC umí LiHV 4S, takže požadavek na koncové napětí 17,4 V
  je splněný.
