phageweb/dron/spec/realna_stavba_dronu/10_pavo20.md

# Pavo20 jako nosič LD06 a Wyvernu

[Rozhodnutí o H7](../../workflow/decisions.md) z 10. 9. 2026 nechalo Pavo20 Pro
zapsané jako cenu, kterou volba CineLogu stojí: *„asi 148 g proti 252 až 264 g,
zůstal by uvnitř 250g třídy. Zapsáno pro případ, že se odhad hmotnosti ukáže
jako problém."* Ten odhad se jako problém **ukázal** — s LD06 míří sestava na
294 g. Tohle je ta předpokládaná revize, spočítaná do konce.

Rešerše je z **13. 9. 2026**, značky důkazu stejné jako v
[Alternativách](./07_alternativy_a_zkusenosti.md): **[repo]** ověřeno tady,
**[dok]** výrobce, **[fórum]** zkušenost uživatelů.

## Odpověď napřed

**Ano, unese to — LD06 i Wyvern.** Tah ani 5V větev nejsou překážka. Co se za to
platí, je **výdrž**: na 3S, se kterým Pavo20 Pro počítá, vyjde zhruba **2,4
minuty** užitečného letu proti 3,5 minuty na CineLogu.

Jedna varianta ale mění zadání: **Pavo20 na 4S** unese stejnou 750mAh LiHV
baterii jako CineLog, vyjde na **239 g** a doletí **přesně stejně daleko**.

> **Pozor na jméno.** Tenhle odstavec původně říkal „Pavo20 Pro II ve 4S
> provedení", protože Pro II je hotový stroj, který se prodává jako 4S (LAVA
> 1104 5500KV), zatímco stock Pro je 2-3S na F4. Jenže se kupuje **jen rám** a
> celá elektronika se vyhazuje, takže 4S je vlastnost *téhle stavby*, ne toho
> rámu. Kusovník, model i CAD stojí na rámu **Pavo20 Pro** (rozvor 93,7 mm),
> který je skladem v ČR. Rozdíly obou rámů jsou [níž](#pro-versus-pro-ii). Menší disk a nižší hmotnost se v rovnici výdrže vyruší na tři platné
číslice. To je jediná konfigurace v celém projektu, která dostane lidar, video
i optický tok **pod 250 g** bez ztráty doletu.

A jakmile ze zadání vypadne simulace, **je to i lepší stavba než CineLog** —
levnější o 1 000 Kč, užší o 45 mm, lehčí o 55 g, se stejným doletem. Visí to na
jediné neověřené věci: jestli se 36mm deska vejde do rámu s 93,7mm rozvorem.
Proč to není jistota a co všechno se muselo opravit, než to takhle vyšlo, je
níž.

## Hmotnostní rozpočet

Základ je Oscarem **změřených 70,1 g** Pavo20 Pro bez baterie a bez FPV [fórum]
— na rozdíl od čísel v [tabulce komponent](./03_komponenty.md), která jsou
vendorová. Od nich se odečte stock deska a přičte to, co projekt potřebuje:

| Položka | Gramy |
| --- | ---: |
| Pavo20 Pro bez baterie a bez FPV, změřeno | 70,10 |
| − stock BetaFPV F4 2-3S 20A AIO V1 | −5,92 |
| + MicoAir H743 V2 45A AIO | +10,00 |
| + SpeedyBee ELRS Nano a anténa (stock deska měla RX v sobě) | +1,30 |
| + MicoAir MTF-02P | +1,50 |
| + EMAX Wyvern Link Alpha 200 mW | +13,76 |
| + LDRobot LD06 | +42,00 |
| + TPU stožár, držáky, kabeláž, šrouby (odhad jako u CineLogu) | +22,00 |
| **Nasucho** | **154,74** |
| + 3S 550 mAh | +50 |
| **Vzletová** | **≈ 205 g** |

## Tah a výdrž

LAVA 1104 7200KV s Gemfan 2218 dává **přes 230 g tahu na motor** [dok], tedy
920 g na stroj. Výdrž je počítaná stejnou metodou jako
[u CineLogu](./07_alternativy_a_zkusenosti.md#výdrž-kolik-toho-vlastně-nalítá):
ideální indukovaný výkon `W^1,5 / sqrt(2ρA)`, poměrem proti referenci, při stejné
účinnosti vrtulí a stejné avionice.

| Sestava | Vzletová | Disk | Energie | Ideální výkon | Tah/váha | Užitečný let |
| --- | ---: | ---: | ---: | ---: | ---: | ---: |
| **CineLog30 V3**, 4S LiHV 750 | 294 g | 182 cm² | 11,4 Wh | 23,2 W | 4,8 | **3,5 min** |
| Pavo20 Pro, 3S 550 | 205 g | 98 cm² | 6,1 Wh | 18,4 W | 4,5 | **2,4 min** |
| Pavo20 Pro, 3S 680 | 215 g | 98 cm² | 7,5 Wh | 19,8 W | 4,3 | **2,7 min** |
| **Pavo20 Pro, stavěné 4S**, LiHV 750 | 239 g | 98 cm² | 11,4 Wh | 23,2 W | 3,9 | **3,5 min** |

Dvě věci z té tabulky stojí za vytažení:

1. **Úspora 89 g nekoupí skoro žádnou výdrž.** Disk je poloviční (98 proti
   182 cm²), takže ideální výkon klesne jen o 21 %, zatímco baterie ubere 46 %
   energie. Menší dron s menší baterií neletí déle, letí kratčeji.
2. **Rozhoduje baterie, ne rám.** Jakmile Pavo20 dostane stejných 11,4 Wh, doletí
   stejně daleko. Celé „Pavo20 je kratší let" je ve skutečnosti „3S 550 mAh je
   půlka energie".

Fixní odběr to ještě zhoršuje: video a lidar stojí stejné watty na obou strojích
(RunCam u srovnatelné jednotky uvádí až **15 W** [dok]), ale na 6,1Wh baterii je
to dvojnásobný podíl.

## Co se musí přestavět

Pavo20 Pro se prodává s **F4 2-3S 20A AIO V1** [dok]. AP_DDS potřebuje H7, takže
ta deska musí ven — a s ní i integrovaný ELRS přijímač, který je na ní. To není
úprava, to je nová stavba kolem zakoupených ductů a motorů.

Přitom platí, že žádný **lehký** ArduPilotem podporovaný H7 AIO neexistuje.
Pravidlo H7 nutí na rám stavěný kolem 5,92g desky nasadit **10g desku s 45A ESC**
na motory, které berou špičkově 10,2 A [dok]. Sedmkrát předimenzovaný ESC se
tady platí gramy.

### Oprava proti tomu, co je zapsané v rozhodnutí

`workflow/decisions.md` tvrdí, že stock F4 sedí na *„stejné rozteči 25,5 × 25,5
jako několik ArduPilotem podporovaných H7 AIO"*. BetaFPV publikuje u desky
i u rámu Pavo20 Pro II rozteč **26 × 26 mm** [dok], stejně tak český prodejce
u rámu Pavo20 Pro, a MicoAir 25,5 × 25,5 s dírami ⌀3 mm [dok]. Prakticky to vyjde — 0,25 mm na stranu se v třímilimetrové díře
s silentblokem ztratí — ale **je to jiné číslo, ne stejné.**

## Tři věci, které to můžou zabít

1. **Vejde se 36 × 36 mm deska do rámu se 93,7mm rozvorem?** MicoAir H743 V2 má
   obrys 36 × 36 mm [dok], stock BetaFPV deska je kolem 30 mm.
2. **Kam LD06**, když je 38,6 × 38,6 mm a musí být celý nad rovinou vrtulí.
3. **Vyvážení.** LD06 je 20 % vzletové hmotnosti proti 14 % na CineLogu.

Všechny tři jsou dořešené [níž](#tři-otevřené-body-dořešené) — zbyl z nich
jeden a půl. Tenhle seznam tu zůstává proto, aby bylo vidět, s čím se začínalo.

Dva mechanické detaily naopak vycházejí **líp**, než se čekalo. Rám má držák
kamery s roztečí **Micro 19 mm** [dok], což je přesně rozměr objektivového modulu
Wyvernu z [dílů pro CAD](./05_cad_dily.md) — kamera se tedy uchytí bez
vymýšlení. A držák VTX bere Wyvernovu rozteč taky, viz
[jak je ten rám udělaný](#wyvern-se-uchytí-do-stock-držáku) — tvrzení o nutném
TPU adaptéru, které tu stálo dřív, bylo špatně.

Naopak **elektricky problém není.** MicoAir je 2-6S, takže 3S zvládne; 5V/2A
větev nese LD06, tok i přijímač se stejnou rezervou jako na CineLogu; Wyvern je
2-6S a 3S je uvnitř — a ve 4S provedení platí totéž s rezervou.

## Co to stojí mimo dron

První verze téhle úvahy tvrdila, že nejdražší položkou je **překalibrování
simulace** — rozvor 128 mm v URDF i SDF, tah z 1404 3850KV, gainy z poměru
autority 7,7, hmotnost 0,306 kg a `scripts/check_model_consistency.py`, který tu
shodu hlídá. **To bylo přeceněné a stálo za to si to přepočítat** [repo].

Celý demo stack je totiž na draku **nezávislý**. Uzly konzumují `LaserScan`
a publikují `cmd_vel`; napříč `obstacle_monitor`, `occupancy_mapper`,
`frontier_explorer` a `simple_indoor_autonomy` je jediný parametr, který o draku
skutečně něco ví, **`rotor_tip_half_width_m`**. Zbytek je buď mise (rychlosti,
vzdálenosti), nebo geometrie uchycení senzorů, která se musí změřit tak jako tak
— stožár pro lidar je otevřená otázka na **obou** rámech.

| | CineLog30 V3 | Pavo20 Pro |
| --- | ---: | ---: |
| Rozvor | 128,0 mm | 93,7 mm |
| `arm_xy_m` | 0,04525 | 0,03313 |
| Poloměr vrtule | 0,0381 | 0,02794 |
| **`rotor_tip_half_width_m`** | **0,08335** | **0,06107** |
| Šířka stroje | 166,7 mm | **122,1 mm** |
| Koridor, který si demo nárokuje | 667 mm | 622 mm |

Bez simulace je tedy změna draku **jeden řádek v `physical_params.yaml`, jeden
parametr ve dvou uzlech a nové naladění ArduPilotu na stole** — a to se dělá na
každém novém stroji tak jako tak, sim gainy jsou startovní bod, ne finální tuning.

A vypadl z toho nález, který mluví pro Pavo20: stroj je **o 45 mm užší**,
122 proti 167 mm. Koridor to zúží jen o 45 mm, protože v něm dominuje
`corridor_margin_m` 0,25 — ale fyzicky proletět dveřmi je s o čtvrtinu užším
strojem jiná úloha, a [coverage let](../../workflow/backlog.md) ukázal, že úzká
místa jsou skutečná překážka, ne baterie.

> **Doplněno po proletění v simulaci:** na dnešní pravidlo, kudy letět, je ten
> rozdíl marginální — oba stroje se do výklenku dostaly a dělí je 7 cm hloubky.
> Výhoda šířky je fyzická, ne algoritmická. Čísla jsou [níž](#naměřené-výsledky).

Peněžně naopak Pavo20 **není překážka, a to je oprava proti první verzi téhle
úvahy.** Hotové stroje jsou skutečně buď vyprodané, nebo v balíku s DJI O4 Pro
za 487,69 € [Rotorama] — což je video, které by se rovnou vyhodilo. Samotný rám
ale **je skladem v ČR**: hobbydrone.cz vede Pavo20 Pro rám pro O3 za **352 Kč**,
přes 5 kusů. A protože se stejně staví od nuly, je rám to jediné, co se z Pavo20
kupuje.

Rozdíl proti CineLogu je pak jen v rámu, motorech a vrtulích, zbytek košíku je
identický:

| | CineLog30 V3 | Pavo20 Pro, 4S |
| --- | ---: | ---: |
| Rám | 1 490 Kč | **352 Kč** |
| Motory 4× | 1 516 Kč (SPEEDX2 1404) | ~1 590 Kč (LAVA 1104 5500KV, 15,90 €/ks) |
| Vrtule, 3 sady | 237 Kč | ~300 Kč (Gemfan 2218) |
| **Celkem** | **3 243 Kč** | **~2 240 Kč** |

Pavo20 tedy vyjde asi o **1 000 Kč levněji**, ne dráž. Ale motory na 4S
(**LAVA 1104 5500KV**, ne 7200KV ze 3S provedení) se při kontrole v ČR nenašly —
nejbližší nabídka byla francouzská, takže se přičte doprava. Cena rozhodnutí
nemění, jen přestává být argumentem proti.

## Pro versus Pro II

Jsou to **dva různé rámy** a snadno se pletou, protože se shodují přesně v tom,
na čem tahle stavba visí. Ověřeno 14. 9. 2026 z katalogu BetaFPV a z karty
zboží hobbydrone.cz:

| | Pavo20 Pro *(kupuje se)* | Pavo20 Pro II |
| --- | --- | --- |
| Rozvor | **93,7 mm** | 93,9 mm |
| Rozteč FC | 26 × 26 mm | 26 × 26 mm |
| Motory | 4× M2, ⌀9 mm | 4-M2-⌀9 mm |
| Slot baterie | 20 mm | 20 mm |
| Hmotnost | 33,3 g s držákem O3 | 35,7 g s držákem O4 Pro |
| Dostupnost | hobbydrone.cz, 352 Kč, skladem >5 | BetaFPV, 11,99 $, dovoz |

Rozteč desky, vzorec motorů i slot baterie jsou **stejné**, takže volba
A1204 s roztečí 9 mm M2 i varování před 1104 s 8,5 mm platí pro oba rámy.

Co stejné není, a co BetaFPV píše samo:

> „Due to a slight wheelbase difference, using the Pavo20 Pro II carbon plate
> with the previous whoop duct may cause the propellers to contact the duct
> during flight." [dok]

Těch 0,2 mm tedy stačí na to, aby vrtule dřely o duct. **Ducty a horní desku
mezi Pro a Pro II nekřížit** — což je přesně ta chyba, která se udělá při
shánění náhradního dílu, ne při první objednávce.

Tohle není první záměna mezi oběma katalogy: oprava o 18 gramech v
[Bod 1 byl špatně položená otázka](#bod-1-byl-špatně-položená-otázka) vznikla
tím, že se horní deska a držák z katalogu Pro II započítaly k rámu Pro.

## Kdy Pavo20 vyhraje

Pavo20 je správná odpověď na **jednu** otázku: *„má stroj zůstat pod 250 g i
s lidarem?"* Tam vyhraje jasně, a ve 4S provedení bez ztráty doletu. CineLog se
294 g tam nedosáhne.

A [rozhodnutí z 10. 9. 2026](../../workflow/decisions.md) říká, že **žádná
váhová třída se nedrží** — hmotnost je cíl a rozhodčí mezi rovnocennými
variantami, ne limit. Jenže ve 4S provedení jsou ty dvě varianty **rovnocenné**:
stejný dolet, srovnatelný tah, stejná avionika. A tam, kde si jsou rovné,
rozhoduje podle toho pravidla hmotnost — a k ní se přidává, že Pavo20 je
o 1 000 Kč levnější a o 45 mm užší.

**Za předpokladu, že se 36mm deska do rámu vejde, je Pavo20 Pro na 4S lepší
stavba než CineLog30 V3.** To je obrat proti tomu, jak tenhle dokument začal,
a stojí za ním dvě opravy: rám je skladem v ČR za 352 Kč, ne vyprodaný, a změna
draku nestojí překalibrování celého projektu, ale jeden parametr.

## Tři otevřené body, dořešené

### 1. Deska se vejde — ale je to jiná deska

První verze tvrdila, že v 25,5 × 25,5 žádný jiný ArduPilotem podporovaný H7 AIO
není. **To bylo špatně.** Je:

| | MicoAir H743 V2 | **iFlight Beast H7 55A AIO** |
| --- | ---: | ---: |
| Obrys desky | 36 × 36 mm | **32,5 × 32,5 mm** |
| Rozteč | 25,5 × 25,5 | 25,5 × 25,5 |
| Hmotnost | 10 g | **8,5 g** |
| Vstup | 2-6S | 2-6S |
| BEC 5 V | 2 A | 2,5 A |
| UARTy | 7 | 5 |
| ESC | 45 A, AM32 | 55 A, BLHeli_S |

Beast H7 je **o 3,5 mm menší na stranu a o 1,5 g lehčí**, a pět UARTů proti našim
čtyřem potřebným (RX, MTF-02P, LD06, telemetrie k videu) vyjde s jedním volným
[dok]. Co se platí: BLHeli_S místo AM32 a ESC předimenzovaný pětinásobně místo
čtyřnásobně, což jsou obě věci, na kterých na tomhle stroji nesejde.

Jistotu to pořád nedává — je to **zmenšení rizika, ne důkaz**. Dva argumenty
navíc pro to, že rám tuhle třídu modulů nese: BetaFPV ho prodává s držákem
**DJI O3 Air Unit**, což je modul srovnatelné velikosti, a rozteč 26 × 26 se
s 25,5 × 25,5 v třímilimetrových dírách se silentbloky potkává.

**Rozhodne pořád maketa v ruce.** Ale pokud 36 mm nevyjde, není konec: zbývá
32,5 mm.

### 2. Termika není rozdíl mezi rámy

EMAX spotřebu **pořád nepublikuje** — manuál, prodejní stránka ani OpenIPC wiki
ji neuvádějí a ta otevřená položka platí dál. Ale otázka „unese to tepelně
2,2" duct" má odpověď i bez toho čísla, z toho, na co je rám stavěný:

| | Zátěž | Teplo | Bez ofuku |
| --- | ---: | ---: | --- |
| **DJI O3 Air Unit** (na co je rám navržený) | 12–16 W | 8–12 W | tepelná ochrana za 3–5 min [fórum] |
| **Náš Wyvern**, 200 mW OpenIPC | ~2W třída | — | neměřeno |

Srovnatelné SSC338Q jednotky se prodávají jako **2W** třída a váží 8,8 g bez
chladiče a 13,4 g s ním (Thinker), respektive 9,86 + 7,36 g chladič + 5,37 g
ventilátor (Mario) [dok]. Tepelná návrhová zátěž té šachty je tedy zhruba
**pětinásobek až osminásobek toho, co do ní dáme.** Šachta, která udrží O3
naživu, udrží 200mW OpenIPC.

A varování „přes 100 °C" z fóra je o provozu **na stole bez ofuku** — to platí
na CineLogu úplně stejně. Je to položka bench checklistu, ne argument pro volbu
draku. **Bod 2 se tím jako rozdíl mezi rámy ruší**; zůstává jako stejná otevřená
položka na obou, kterou zavře multimetr na stole.

### 3. Lidar se vejde a vyváží — se dvěma kompromisy

Spočítáno metodou z `cad_codex/drone.scad`, ověřenou tím, že na CineLogu
reprodukuje jeho vlastní výsledek (294,0 g a těžiště `z = 17,08` proti 17,1
v CADu) [repo].

| | CineLog30 V3 | Pavo20 Pro, 4S |
| --- | ---: | ---: |
| LD06 střed | x = +47 mm | **x = +36,4 mm** |
| LD06 spodek | z = 22 mm | **z = 18 mm** |
| Nad rovinou vrtulí | +7,2 mm | +5,5 mm |
| Optické okno nad deskou | 44,7 mm | 40,7 mm |
| Baterie střed | x = −28 mm | **x = −20,9 mm** |
| Těžiště | `[0, 0, 17,1]` | `[0, 0, 21,3]` |
| Celkem | 294 g | **221,6 g** |

Ta poslední hodnota je hmotnost modelu z téhle úvahy. Stroj, který se podle
[kusovníku](./11_kusovnik_pavo20.md) skutečně kupuje, váží **229,34 g** — rozdíl
jsou těžší díly, které jsou v ČR skladem. Geometrie výš tím dotčená není.

Vyváží se to přesně na osu. **Ale dvě věci jsou horší než na CineLogu:**

1. **Půdorysy lidaru a baterie se přesně dotýkají.** Lidar sedí od +17,1 do
   +55,6 mm, baterie od −58,9 do +17,1 mm. Na CineLogu je mezi nimi 17,7 mm
   rezervy, tady **nula** — a to znamená, že tlustší držák nebo o pár milimetrů
   delší baterie tu rovnici rozbijí a bude se muset couvnout s baterií a dovážit
   jinde.
2. **Těžiště je 8,8 mm nad rovinou vrtulí** proti 2,3 mm na CineLogu. To není
   blokátor — ArduPilot to uletí — ale je to tvrdší vazba mezi náklonem
   a posuvem a ostřejší tune. Je to další důvod, proč se gainy stejně budou
   ladit na stroji, ne přenášet.

Co se tím **nevyřešilo a ani vyřešit nedá:** čistých 360° nebude ani tady.
Okno je 40,7 mm nad deskou, baterie sahá od 24 do 52 mm — **zadní sektor stíní
baterie**, přesně jak to CAD README píše o CineLogu. Zvednout lidar nad baterii
by znamenalo okno ve výšce 76,7 mm a těžiště úplně jinde. Pro dnešní demo, které
se dívá do 60° dopředu, to nevadí; **pro SLAM, kvůli kterému byl LD06 vybraný,
to je skutečné omezení — a je stejné na obou rámech.**

## Jak je ten rám doopravdy udělaný

Body 1 a 3 stály na odhadech, protože nikdo se nepodíval, jak je Pavo20 Pro
postavený. Rozebrané fotky z recenze a katalogové řezy to mění — **a jedna věc
se tím zlepšila, jedna zhoršila a jedna se ukázala být špatně položená otázka.**
Zdroj jsou fotky Oscara Lianga z teardownu a boční pohled na osazený stroj,
plus katalogový rozpis rámu [fórum][dok].

### Není to placatý whoop

Skladba zezdola nahoru, jak ji ukazuje teardown:

1. **Sestava ductů** je samostatný vystřelený plastový díl — čtyři tenké
   prstence spojené do jednoho kusu, pásek baterie protažený skrz. Je úplně
   dole.
2. **Karbonová X deska** leží nad nimi a nese motory.
3. **FC** sedí uprostřed té desky na **silentblocích ⌀8 mm** — BetaFPV jich
   k rámu přikládá šest [dok]. Vrtule se nad ním **přetáčejí**.
4. **Plastová věž** nahoře nese kameru vpředu a HD VTX; na CineLogu je kamera
   drobný modul na nose, tady je to nosná konstrukce přes celý střed.
5. **Baterie se pásá navrch věže**, podélně po ose, nad rovinou vrtulí.

### Bod 1 byl špatně položená otázka

Ptal jsem se, jestli se 36mm deska „vejde". Geometrie říká, že se **žádná
nevejde**, a nevadí to. Motory jsou 46,85 mm od osy, vrtule mají poloměr
27,94 mm, takže střed má bez zametání vrtulí jen **kruh o poloměru 18,91 mm**:

| Deska | Poloviční úhlopříčka | Zásah pod disky |
| --- | ---: | ---: |
| stock BetaFPV F4, ~29 mm | 20,51 mm | +1,60 mm |
| iFlight Beast H7, 32,5 mm | 22,98 mm | +4,07 mm |
| MicoAir H743 V2, 36 mm | 25,46 mm | +6,55 mm |

**I stock deska má rohy pod vrtulemi** — a na fotce je přesně vidět, jak listy
přes FC přecházejí. Zástavba tedy není ano/ne otázka půdorysu, ale **výšky**.
A ta se ptá jinak: silentblok je 8 mm, MicoAir je 8 mm tlustý proti zhruba 6 mm
stock desky, takže jde o **2 mm navíc**, ne o 7 mm na stranu. To je mnohem menší
otázka, než na jakou to vypadalo, a Beast H7 zůstává zálohou pod ní.

### Wyvern se uchytí do stock držáku

Oprava proti tomu, co jsem psal výš o TPU adaptéru. BetaFPV u držáku pro O3
výslovně uvádí kompatibilitu s **Caddx Vista a RunCam Link** [dok] — což jsou
obě jednotky s roztečí 25,5 × 25,5, tedy přesně Wyvern. Držák je navíc dělaný
na modul **32,5 × 30,5 × 14,5 mm o 28 g** (rozměry O3 [dok]); Wyvern je menší
i lehčí. Těch 20 mm z katalogu je rozteč **kamery**, ne VTX.

### Bod 3 je horší, než model věděl

**Věž stojí přesně tam, kam výpočet posadil lidar.** Těžišťová rovnice dává LD06
střed na x = +36,4 mm, tedy tělo od +17 do +56 mm — a to je půdorys kamerové
věže. V modelu je kamera krabička 26 × 22 × 20 mm na nose, protože takhle
vypadá na CineLogu. Na Pavo20 to je nosník přes celý střed a **lidar by byl
uvnitř něj.**

Řešení z toho plyne samo a není to jen záplata: **Wyvern nahrazuje 28g O3 asi
14gramovou deskou, takže stock držák stejně odchází.** Místo něj TPU věž, která
nese Wyvern níž a **nahoře rovnou plošinu pro LD06**. Je to díl, který se musí
navrhnout tak jako tak — stožár lidaru je otevřená položka i na CineLogu.

**Oprava:** tvrdil jsem tu, že se tím z rámu sundá zhruba 18 g. To bylo špatně —
18 g je horní deska *plus* držák z katalogu Pro II. Karta zboží u rámu Pavo20 Pro
rozepisuje **duct 17,8 g a držák O3 jen 4,6 g** [dok]. TPU věž, která má nést
Wyvern i plošinu pro lidar, bude spíš 10 g, takže to není úspora, ale
**přírůstek kolem 5 g**.

**Co tím pořád není vyřešené:** jak vysoko ta plošina vyjde a co to udělá
s těžištěm. Model drží lidar 43,2 mm nad středem desky, což je číslo z výpočtu
vůle nad vrtulemi, ne z výšky věže. Výšky ductů jsou placeholder na **obou**
strojích a tohle je další v té řadě.

## A pak to skutečně letělo

Po tom všem se varianta postavila v simulaci a proletěla stejnými checky jako
CineLog. Model je `models_pavo20/`, parametry `ardupilot_params_pavo20.parm`,
spouští se přes `OPENIPC_AIRFRAME=pavo20` [repo].

### Co si simulace vyžádala

Překvapivě málo, a jedna věc z toho je výsledek sama o sobě.

**Gainy se přenesly beze změny.** Ladí je poměr momentu k setrvačnosti:

| | Moment při plném náklonu | Setrvačnost | Autorita |
| --- | ---: | ---: | ---: |
| CineLog30 V3 | 2 × 3,485 N × 0,04525 m = 0,3154 N·m | 0,000458 | 689 rad/s² |
| Pavo20, model z téhle úvahy | 2 × 2,253 N × 0,03313 m = 0,1492 N·m | 0,000218 | 684 rad/s² |
| Pavo20, model podle kusovníku | 2 × 1,980 N × 0,03313 m = 0,1312 N·m | 0,000225 | 583 rad/s² |

Z celého parametrového souboru se liší jediná hodnota, `MOT_THST_HOVER`.

> **Oprava, 14. 9. 2026.** Tenhle odstavec původně končil tím, že poměr autorit
> je **0,99**, a z toho vyvozoval, že se gainy přenesly shodou. Platilo to pro
> model postavený na téhle úvaze — LAVA 1104 5500KV, Beast H7, 750mAh pack,
> 221,6 g. Kusovník ale LAVA v ČR nenašel a kupuje **Flashhobby A1204 5200KV**,
> MicoAir H743 a 850mAh pack, tedy 229,34 g. Model teď sleduje kusovník, ne
> tuhle úvahu, a poměr autorit je **0,85**: A1204 je o 12 % slabší a díly
> skladem jsou těžší, takže moment klesl víc než setrvačnost.
> `MOT_THST_HOVER` je tím pádem **0,53** proti CineLogovým 0,46, ne 0,49.
>
> Gainy na 0,040 zůstaly, a teď je to **změřené, ne odvozené**:
> `OPENIPC_AIRFRAME=pavo20 scripts/sweep_rate_gains.sh` klade práh rozkmitání
> mezi 0,065 (přestřelení 4,3 %, 4 změny znaménka) a 0,080 (49,6 %, 162) — tedy
> do stejného pásma jako na CineLogu. Předpoklad, že o 15 % nižší autorita ten
> práh posune zhruba o tolik výš, se **nepotvrdil**; mřížka na to ale nestačí,
> jeden její krok je 23 %.

### Naměřené výsledky

| Check | CineLog30 V3 | Pavo20 Pro 4S |
| --- | ---: | ---: |
| Tahový stav, výstup na 5,0 m | 5,01 m | **5,04 m** |
| Guided takeoff, vrchol / ustálení | 2,08 / 2,02 m | **2,08 / 2,01 m** |
| Guided takeoff, nejhorší náklon | 15,6° | **15,5°** |
| Dopředný let, drží od zdi | 1,36 m | **1,39 m** |
| Dopředný let, vůle vrtule | 0,90 m | **0,93 m** |
| Coverage, volná podlaha pokoje | 93 % | **92 %** |
| Coverage, vnitřek výklenku | 92 % | **93 %** |
| Poloh uvnitř výklenku | 556 z 3664 (15 %) | **604 z 3654 (17 %)** |
| Jak hluboko dovnitř dolétl (x) | −2,42 m | **−2,49 m** |

Všechny checky prošly a baseline CI zůstala zelená.

### Co z toho plyne, včetně jedné opravy

**Letí to stejně.** Náklon 15,5 proti 15,6 stupně je ta nejsilnější věc v téhle
tabulce: potvrzuje výpočet autority na desetinu stupně, a to znamená, že
tvrzení „gainy se přenesou" není odhad, ale měření.

**Ale ten užší stroj coverage nepředělá, a to je oprava proti tomu, co jsem
u bodu o šířce tvrdil dřív.** Psal jsem, že proletět dveřmi je s o čtvrtinu
užším strojem „znatelně jiná úloha". Simulace říká, že není: dovnitř výklenku
šly oba, Pavo20 dolétlo o 7 cm hlouběji a strávilo uvnitř o 2 procentní body
letu víc. To je přesně to, co předpovídala geometrie — koridor je 622 proti
667 mm, protože v něm dominuje `corridor_margin_m` 0,25, ne šířka draku.
**Šířka je skutečná výhoda pro fyzický průlet dveřmi, ne pro dnešní pravidlo,
kudy letět.**

A protože jsou to jednotlivé běhy, rozdíl 15 proti 17 procentům poloh je nejspíš
uvnitř rozptylu mezi běhy. **Netvrdit z toho, že Pavo20 mapuje líp.** Tvrdit se
z toho dá to opačné a užitečnější: **nic se nezhoršilo.**

### Co simulace neuzavřela

- **Sweep gainů na tomhle draku.** Přenos je argument podepřený jedním měřením
  náklonu, ne `sweep_rate_gains.sh` proběhlý znovu.
- **Nic z bodu 1 a 3.** Simulace nezná obrys desky ani tloušťku držáku — ta
  nulová rezerva mezi lidarem a baterií je v modelu zadaná, ne ověřená. Výšky
  ductu jsou pořád placeholder na obou strojích.
- **Výdrž.** V simulaci není baterie, takže těch 3,5 minuty je pořád výpočet.

## Kde to po všem stojí

Ze tří bodů zbyl **jeden**, a je to jiný než ten, se kterým se začínalo.

- **Bod 1 se rozpustil.** Nebyla to otázka, jestli se deska vejde — pod
  vrtulemi je i ta stock. Je to otázka **dvou milimetrů výšky** proti 8mm
  silentbloku, a pod ní leží Beast H7 jako lehčí a nižší záloha.
- **Bod 2 přestal být argumentem.** Rám je stavěný na pětinásobnou tepelnou
  zátěž, než mu dáme, a ta otevřená otázka je stejná na obou strojích.
- **Bod 3 zůstal a fotky ho zhoršily.** Nejen že se půdorys lidaru a baterie
  dotýká bez rezervy — ještě tam stojí kamerová věž. **Tohle je jediná věc,
  která u Pavo20 zůstává objektivně horší než u CineLogu**, a je to důsledek
  toho, že stejně velký senzor jede na o 34 mm kratším rámu s vyšší nástavbou.

Zároveň se to ale změnilo z „neznámé" na **konkrétní kus práce**: TPU věž, která
nese Wyvern níž a lidar nahoře, místo stock držáku pro O3. Ten se stejně
nepoužije — ale váží jen 4,6 g, takže ta věž rozpočet o pár gramů zdraží, ne
zlevní.

**Co udělat dřív, než se cokoli objedná, se tím posunulo.** Maketa desky už není
první — geometrie ji odsunula. První je **výška věže a kam na ní sedne LD06**,
protože to je jediné, co pořád rozhoduje, a jediné, co se z fotek vyčíst nedá.
Pak teprve rám za 352 Kč, aby se to dalo změřit na plastu.

Simulace mezitím ukázala, že po letové stránce je Pavo20 rovnocenná náhrada —
stejné gainy, stejný náklon na desetinu stupně, stejné chování dema. **To, co ji
může zabít, je pořád mechanika, a je to teď jedna konkrétní mechanická otázka
místo tří mlhavých.**

## Zdroje

- [Oscar Liang: BetaFPV Pavo20 Pro review](https://oscarliang.com/betafpv-pavo20-pro/) — 70,1 g bez baterie a FPV, 108 g s O3
- [Oscar Liang: BetaFPV Pavo20 review](https://oscarliang.com/betafpv-pavo20-cinewhoop/) — 55 g rám, visení na 30 % plynu
- [BETAFPV: Pavo20 Pro](https://betafpv.com/products/pavo20-pro-brushless-whoop-quadcopter) — F4 2-3S 20A AIO, 3S, slot baterie 20 mm
- [BETAFPV: Pavo20 Pro II](https://betafpv.com/products/pavo20-pro-ii-brushless-whoop-quadcopter) — 4S provedení s LAVA 1104 5500KV
- [BETAFPV: Pavo20 Pro II frame](https://betafpv.com/products/pavo20-pro-ii-brushless-whoop-frame) — 93,9 mm rozvor, rozteč FC **26 × 26 mm**, 35,7 g, 11,99 USD
- [BETAFPV: LAVA 1104 motors](https://betafpv.com/products/lava-series-1104-brushless-motors) — přes 230 g tahu, špička 10,2 A
- [BETAFPV: F4 2-3S 20A AIO FC V1](https://betafpv.com/products/f4-2-3s-20a-aio-fc-v1) — 5,92 g, rozteč 26 × 26, BEC 9V/2A a 5V/3A
- [MicoAir743v2-AIO-45A](https://micoair.com/flightcontroller_micoair743v2_aio_45a/) — 36 × 36 × 8 mm, rozteč 25,5 × 25,5, 10 g
- [ArduPilot: iFlight Beast H7 55A AIO](https://ardupilot.org/copter/docs/common-iflight-beasth7AIO.html) — **32,5 × 32,5 mm**, rozteč 25,5 × 25,5, 8,5 g, 2-6S, 5 UARTů
- [OpenIPC: Thinker Air Unit](https://docs.openipc.org/hardware/openipc/vtx/fpv-thinker-aio/) — 8,8 g bez chladiče, 13,4 g s ním, 2-6S
- [Mads Tech Wiki: OpenIPC Mario AIO](https://fpvwiki.co.uk/openipc-mario-aio) — 9,86 g deska, 7,36 g chladič, 5,37 g ventilátor
- [Oscar Liang: DJI O3 Air Unit](https://oscarliang.com/dji-o3-air-unit-fpv-goggles-2/) — 12–16 W, tepelná ochrana bez ofuku za 3–5 min
- [Rotorama: Pavo20 Pro II O4 Pro 3S ELRS](https://www.rotorama.com/product/betafpv-pavo20-pro-o4-pro-2) — 487,69 €, vyprodáno
- [hobbydrone.cz: rám Pavo20 Pro pro O3](https://www.hobbydrone.cz/cs/frame-betafpv-pavo20-for-o3-air-unit-clear-grey/) — **352 Kč, skladem**, 33,3 g, rozteč FC 26 × 26, kamera Micro 19 mm, deska VTX 20 × 20
- [La Camera Embarquée: LAVA 1104 5500KV](https://www.lacameraembarquee.fr/en/motors/20496-motor-betafpv-lava-1104-5500kv-24mm-0795986632429.html) — 15,90 €/ks, 4S varianta motoru
- [Oscar Liang: Pavo20 Pro, teardown a boční pohled](https://oscarliang.com/betafpv-pavo20-pro/) — fotky, ze kterých je skladba rámu odečtená
- [DJI O3 Air Unit specifikace](https://www.dji.com/support/product/o3-air-unit) — vysílací modul **32,5 × 30,5 × 14,5 mm, 28 g**, na což je držák stavěný
