phageweb/dron/workflow/backlog.md

# Backlog

## Milestone 1: Generic ROS 2 Shell on NixOS

- [x] Create `flake.nix`
- [x] Add initial CI/CD pipeline
- [x] Verify `nix develop`
- [x] Verify `ros2 --help`
- [x] Verify `colcon --help`
- [x] Verify `gz sim --versions`
- [x] Verify `rviz2 --help`
- [x] Verify `python3 -c "import rclpy"`

## Milestone 2: Generic ROS 2 Demo

- [x] Create `ros_ws/src`
- [x] Create the first Python ROS 2 package
- [x] Add unit tests for the first Python package
- [x] Run Python tests in CI
- [x] Add a publisher
- [x] Add a subscriber
- [x] Verify `ros2 node list`
- [x] Verify `ros2 topic list`
- [x] Verify `ros2 topic echo`

## Milestone 3: TF and RViz2

- [x] Create a simple TF tree
- [x] Run `robot_state_publisher`
- [ ] Run RViz2 (launched by `display.launch.py`; needs a screen to confirm)
- [x] Save an RViz configuration (`cinewhoop.rviz`; visual check still needs a GUI)
- [x] Verify `tf2_tools view_frames`

## Milestone 4: Gazebo Harmonic

- [ ] Run `shapes.sdf`
- [x] Add a headless Gazebo CI smoke test
- [x] List `gz topic -l` (needs `GZ_PARTITION=openipc_cinewhoop`)
- [x] Create a small custom world
- [x] Add a simple sensor topic
- [x] Bridge sensor topics into ROS 2 with `ros_gz_bridge`

## Milestone 5: Cinewhoop Model

- [x] Enforce that the URDF and the SDF describe the same drone
      (`scripts/check_model_consistency.py`, in baseline CI). The airframe is
      written down twice and nothing linked the two files; the `rangefinder_link`
      rotation had already drifted between them

- [x] Create ROS package `openipc_cinewhoop_description`
- [x] Create ROS package `openipc_cinewhoop_gazebo`
- [x] Create ROS package `openipc_cinewhoop_demo`
- [x] Create a URDF/Xacro model for RViz2
- [x] Create an SDF model for Gazebo
- [x] Add `base_link`, sensors, and motors
- [ ] Verify scale and the TF tree

## Milestone 6: Sensors

- [x] Explain the static front-lidar reading: parked, the lidar sits 37 mm above
      the floor and the fan's lowest rays graze it, giving a constant-depth plane
      at h/phi. In flight the floor is out of range, so nothing is affected. The
      demo's 1.40 m stop distance and the 1.412 m floor return are closer than
      they look, which constrains raising either
- [x] Give the front lidar more ground clearance: the LD06's mast did it. Parked,
      it now reports the wall at 4.39 m rather than the floor at 1.41 m, so the
      stop distance is no longer bounded by an artefact

- [x] Add IMU
- [x] Add downward rangefinder
- [x] Add front lidar
- [x] Add camera
- [x] Verify ROS topics
- [ ] Verify RViz visualization

## Milestone 7: ArduPilot SITL

- [x] Verify SITL without Gazebo
- [x] Add repeatable local SITL/Gazebo smoke test (upstream build remains opt-in)
- [x] Verify the Iris smoke test with the Gazebo plugin
- [x] Connect the custom cinewhoop model
- [x] Verify motor mapping (matches the Iris reference; thrust path proven by `scripts/check_thrust_stand.sh`)
- [x] Redesign the rotor drive onto `MulticopterMotorModel` fed from the plugin's `COMMAND` type
- [x] Fix the ground-truth attitude offset: the IMU sensor was missing the 180 degree roll into aircraft convention
- [x] Track down the intermittent NaN that crashed SITL (gone with the force PID removed)
- [x] Raise rotor speed and thrust so the controller has attitude margin
- [x] Calibrate `motorConstant` and `momentConstant` against real 3 in propeller
      data; thrust to weight is now 5.9 instead of 3.0 by construction
- [x] Scale the attitude rate gains to this airframe's authority, which is 7.7
      times a ten-inch quad's; stock gains saturated the rate loop
- [ ] Confirm the calibration on a thrust stand with the exact ducted propeller,
      rather than from published motor figures and textbook coefficients
- [x] Tune the rate gains by a sweep rather than one authority-ratio calculation.
      Eleven flights put the oscillation onset between 0.044 and 0.05, where
      ringing goes from 5 sign changes per run to 141. `ATC_RAT_RLL_P` is 0.027,
      a little over half the onset (`scripts/sweep_rate_gains.sh`)
- [ ] Re-measure the onset on hardware. The simulation has no gyro noise, no
      frame resonance and no ESC lag beyond the motor model, so 0.027 is a
      ceiling to approach rather than a value to fly off the bench
- [x] Fly the Pavo20 variant with the parts that can actually be bought. The
      model was built from the airframe study in `10_pavo20.md`, which chose
      LAVA 1104 5500KV, an iFlight Beast H7 and a 750 mAh pack and worked out to
      0.2216 kg. Costing it found the LAVA is not sold in this country at all,
      so the bill of materials in `11_kusovnik_pavo20.md` buys Flashhobby A1204
      5200KV, a MicoAir H743 and an 850 mAh pack, and the machine is 0.22934 kg.
      The model now follows the bill of materials: `maxRotVelocity` 5950 -> 5580
      (5200 KV at the same 61 per cent loaded fraction), per-link masses off the
      itemised budget, and `MOT_THST_HOVER` 0.49 -> 0.53. Every figure the
      published parts list quotes now comes out of the model too - 202 g per
      motor, 808 g of thrust, thrust to weight 3.52, hover at 53 per cent.
      `check_model_consistency.py` passes for both airframes, and
      `check_guided_takeoff.sh` flies it: peak 2.08 m, settled 2.01 m against a
      2.00 m target, worst tilt 15.5 degrees. Those are the LAVA model's numbers
      to a tenth, which is a result rather than a stale run - the altitude
      controller holds the climb, not the thrust surplus, so this manoeuvre
      cannot see 15 per cent less authority. A rate sweep would
- [x] Sweep the Pavo20's rate gains rather than carrying the CineLog's answer
      across. `sweep_rate_gains.sh` was hardcoded to one airframe - the base
      parameter file and the model directory both - which is the substitution the
      parameter file was making an argument for; it now takes `OPENIPC_AIRFRAME`
      the same way `check_guided_takeoff.sh` does, and writes into
      `logs/rate_sweep/<airframe>-<stamp>/` so two frames' runs cannot be read as
      one. Its default gains were also centred on "the current 0.018" long after
      both files went to 0.040, so the default sweep could not have found an
      onset above the flown value. Measured on the pavo20: 0.065 is clean
      (overshoot 4.3 per cent, 4 sign changes), 0.080 is gone (49.6 per cent, 162),
      so the onset is in the same bracket as the CineLog's and 0.040 keeps the
      same 0.62 margin. **The prediction this was run to test did not survive:**
      15 per cent less authority should have moved the onset up by about as much,
      and it did not measurably - though one step of the grid is 23 per cent,
      wider than the 18 per cent being looked for, so this is a grid too coarse
      rather than evidence against. Nothing depends on which it is
- [x] The Pavo20's rate gains no longer transfer by a matching authority, which
      is what sent the sweep above looking. Roll authority is 583 rad/s^2 against
      the CineLog's 689, a ratio of **0.85** where it used to be 0.99: the A1204
      is 12 per cent weaker than the LAVA and the in-stock parts are heavier, so
      the moment fell further than the inertia did. The gains stay at 0.040, and
      the sweep rather than the ratio is now the reason
- [x] Verify guided arm/takeoff (`scripts/check_guided_takeoff.sh`)

## Milestone 8: ArduPilot DDS

- [x] Build and run Micro XRCE-DDS Agent (local source workspace; not packaged in current Nixpkgs)
- [x] Build SITL with `--enable-DDS` (local source workspace)
- [x] Verify `/ap/*` topics
- [x] Verify `/ap/*` services
- [x] Verify arm/mode/takeoff through ROS 2 services

## Milestone 9: Demo Nodes

- [x] Compensate the front scan for vehicle attitude in `simple_indoor_autonomy`.
      Returns are projected into a gravity-aligned frame using the pose's roll
      and pitch, and dropped when they work out to be the floor. The height comes
      from the downward rangefinder, and an unknown height discards nothing
- [ ] Decide where the ROS 2 nodes run, which is now a purchase and not only a
      question. AP_DDS publishes no LaserScan and no proximity topic at all, so
      on real hardware the scan has no way into ROS. The simulation hides it:
      there the scan comes from Gazebo straight into ROS through ros_gz_bridge.
      The four ways out are written up in `spec/realna_stavba_dronu/09_kudy_do_ros.md`;
      two of them are now closed on evidence rather than open:
      **the AP_DDS fork cannot reach SLAM** - `AP_Proximity` exposes eight
      distances 45 degrees apart, under a `static_assert(PROXIMITY_NUM_SECTORS == 8)`,
      so a publisher over it would carry eight numbers, not a scan; and
      **ROS on the ground on its own is not a path at all**, because nothing
      onboard can send the raw scan down once the autopilot only offers those
      eight sectors. The video-unit option fell with the Walksnail purchase.
      What is left is a companion computer, or the one link on parts already
      bought - the Walksnail OSD, below; the AIO has no Bluetooth after all -
      with a bought Bluetooth module behind it. An ESP32 bridge is out for
      good (2026-10-12): Wi-Fi range is too small.
      The bill of materials cannot be finished before this is decided
- [x] Check for Bluetooth on the MicoAir AIO. It has none. A seller listing
      said it does, and the MicoAir743v2 manual describes a module on UART8,
      but that manual is for the stand-alone FC; the AIO shares only the
      firmware target, which is why `SERIAL8` defaults to MAVLink2 at 115200.
      Two `bluetoothctl` scans on 2026-10-07 next to the board, one with BOOT
      held, found nothing, and MicoAir's own AIO page lists one BOOT0 button
      and UART8 on pads. Those pads are where a bought serial Bluetooth module
      would go if the OSD route below fails
- [ ] Test the Walksnail OSD as a downlink for the scan - the only link on parts
      already bought.
      The VTX relays MSP DisplayPort characters and the VRX Pro renders them, so
      a strip of OSD rows can carry a binned scan that a decoder reads back from
      the VRX Pro's UVC output. Estimate 4-8 scans/s at 2.5 degrees on the 50 x
      18 canvas ArduPilot reports. Downlink only, and `osd:write` for Lua is in
      master, not 4.7.1. Phase 2 of `15_test_linky_skenu.md` measures it with
      the notebook emulating the FC; it decides on whether the OSD reaches UVC
      at all
      15. 10. 2026, on the bench with the real FC, Lite+ and VRX Pro: it does.
      `osdvideo.py` reads 479 of 479 pictures with the rows, but only 1.9
      turns/s: the VRX shows ~5.7 distinct frames/s and a third of the
      pictures lack our rows (the second DRAW). Left: in flight, and faster.
- [ ] Fly or walk with the heading on: `scan_osd.lua` (81-character frames)
      is not on the board yet, so no recording has it
- [x] Send the vehicle's heading (and roll, pitch) with every turn, so the
      ground can stitch turns into a floor plan. 4 characters before the CRC,
      both lengths read; SITL 0 bad frames, and on a made-up flat the path
      with the heading comes back within 3.3 mm against 4.3 m without. A 51 s walk through the flat
      (VRX recording of 15. 10. 2026 01:51, 96 turns) stitched by ICP alone
      shows the path but the rooms in several rotated copies: between turns
      the heading changes by 30-100 degrees, with gaps of up to 3 s. With the
      FC's yaw only the translation is left to ICP
- [x] Put the stitching into the repo: `lidar/osd/stitch.py`, `nix run
      .#lidar-map`, point to line ICP. The lidar page's floor plan still has
      its own, without the heading, and drops points closer than 0.5 m
- [ ] Get more turns through: the VRX shows ~5.7 distinct frames/s, a third
      of the pictures lack our rows, and one lost frame loses the whole turn.
      Write the rows in the first DRAW too, or assemble turns from parts of
      neighbouring turns
- [ ] Read pictures with a bright background (the camera on a lit ceiling or
      the laptop screen): treat a cell unlike every glyph as an erasure, six
      unknown bits the CRC can solve for, instead of losing the picture
- [ ] Make `vrx.py` notice a capture that delivers no frames (the VRX's UVC
      wedged, `probe control -71`) and say so in the window, instead of a
      frozen picture
- [ ] Why the VRX switched to the Betaflight font after a restart on
      15. 10. 2026 is not known; `MSP_OPTIONS 4` pins it. An ArduPilot font
      on an SD card in the VRX (`userfont/`) is the other way, untried: the
      VRX has no card
- [x] Read the scan out of the VRX picture (`lidar/osd/osdvideo.py`, live in
      `vrx.py`, recordings into the lidar page with `--session`). The
      alphabet lost s-y, which the Walksnail font draws like b, d, f, h, j,
      l, n; the decoder fits an unknown font from the CRC alone
- [x] Write both ends of the OSD link before the VTX arrives (`lidar/osd/`).
      `scan_osd.lua` bins each turn into 144 x 2.5 degrees, codes the distance
      in 9 logarithmic bits and writes three 77-character CRC-checked frames a
      turn; `osdscan.py` reads them back from MSP DisplayPort. On real D500
      bytes the Lua frames equal the Python ones character for character, and
      the recorded sessions come back within 10 mm for 95 per cent of bins. In
      SITL the whole chain carries 3.17 turns/s of 3.33 possible, with no bad
      frames. Needs master for `osd:write`; reading the frames from UVC video
      waits for the VTX
- [x] Lean the vehicle in the simulator and assert the floor is not reported
      (`scripts/check_leaning_scan.sh`, in baseline CI). `leaning_test.sdf` holds
      the model static at 30 degrees nose-down and 0.60 m up, where the forward
      beams meet the floor at 1.17 m - inside the demo's 1.40 m stop threshold.
      Both nodes are run again with the rangefinder topic pointed at nothing,
      and that blind pair must stop for the floor; without that control the
      check would pass over an empty scan
- [x] Give `obstacle_monitor` the same compensation, so it no longer reports the
      floor as the nearest obstacle while the autonomy node ignores it
- [x] Make the demo latch why it is holding rather than that it is holding. A
      vehicle that stopped for a stale scan and then stayed stopped for a wall
      logged only the first reason, so the log said the lidar was dead long
      after it had recovered
- [x] Check that AP_DDS reports the attitude the vehicle really has, which the
      floor rejection trusts and nothing tested. `ramp_test.sdf` parks the
      vehicle on a slope tilted in both axes, and
      `scripts/check_attitude_estimate.sh` compares the world file, Gazebo's
      ground truth and `/ap/pose/filtered`: all three agree to 0.01 degrees.
      Parked rather than flying, because a steady attitude is two numbers
      instead of two streams to align during a transient
- [x] Stop the model pinning itself to one world. Its five sensors declared
      topics containing `/world/indoor_test/`, so in any other world
      `ArduPilotPlugin` could not find the IMU, never sent SITL a state frame,
      and SITL resent servos forever saying only "No JSON sensor message
      received". Sensors now declare no topic, `gz_bridge.yaml` is a template
      rendered from the launched world's own name, and
      `check_model_consistency.py` fails if a world name reappears in one
- [x] Guard the floor rejection's own two inputs for freshness. The scan had a
      staleness guard and the attitude and height did not, although neither
      arrives with the scan: the pose comes from the flight controller over DDS
      and the height from a different sensor, so either can stop while the lidar
      stays healthy. Both nodes now switch the rejection off and say why
      (`compensation_height`, `compensation_timeout_s`, default 0.5 s against a
      30 Hz pose and a 20 Hz rangefinder)
- [x] Correct the downward rangefinder for lean. It reports slant range, so at
      30 degrees it read 0.639 m where the sensor was 0.551 m up - 16 per cent,
      growing as 1/cos. `height_from_slant_range` undoes it, and
      `check_leaning_scan.sh` checks the result against where Gazebo says the
      link is rather than against the formula: 0.554 m against 0.551 m, inside
      the sensor's own 0.01 m range resolution
- [x] Exercise the roll term of the projection on a scan Gazebo produced.
      `banked_test.sdf` holds the vehicle at 25 degrees of roll and 20 of pitch,
      0.60 m up, where the floor arrives in the forward sector at 1.21 m off the
      right wing and 6.2 m off the left. `leaning_test.sdf` could not do this:
      the pitch term is even in the bearing, so a scan indexed the other way
      round the circle gives identical numbers there, while the roll term is odd
      and does not. With the roll sign flipped, `leaning_test` still passes and
      `banked_test` fails
- [x] Fly a circuit of the room. `simple_indoor_autonomy` gained a `TURN`
      state: blocked ahead, it yaws towards whichever side has more room and
      goes on. Off by default, because stopping for the wall is the behaviour
      `check_forward_flight.sh` verifies and flying past it is a second thing to
      ask for. `room_test.sdf` is a closed 8 by 6 m room and
      `scripts/check_room_circuit.sh` flies it: 630 degrees of turning, closest
      approach to a wall 0.75 m
- [x] Give the circuit something to produce. It flew a room and kept nothing;
      `occupancy_mapper` turns the scans into a 2D occupancy grid in the flight
      controller's local frame, published as `nav_msgs/msg/OccupancyGrid` on
      `/openipc_cinewhoop/map`. Log-odds rather than a flag, so repeated
      evidence accumulates and a single spurious return is not permanent, and
      unknown is kept distinct from fifty-fifty - which is the only thing that
      says where the vehicle has actually been. It skips a scan outright when
      the pose is stale or the floor rejection is off: the other two nodes can
      fall back on holding, and a wall drawn in the wrong place stays there
- [x] Check the map against the room rather than against itself.
      `scripts/check_room_mapping.sh` flies the same circuit with the mapper
      running and measures the result against the walls read out of the world
      file: all four walls mapped along 100 per cent of their length, wall cells
      0.050 m off the wall at the median and the 90th percentile - exactly the
      half-cell that quantisation costs - and no occupied cell anywhere in the
      middle of an empty room. That one comparison covers the scan's angular
      convention, the yaw the returns are turned by, the ray casting and the
      EKF's own position, which nothing had checked before: every earlier check
      asked about attitude or about a distance the vehicle did not need to know
      where it was to get right
- [x] Root the TF tree in the world. `pose_tf_broadcaster` publishes
      `map` -> `base_link` from `/ap/pose/filtered`, which is what the occupancy
      map was stamped in and nothing reached. `sitl_gazebo.launch.py` starts it
      and `check_unified_launch.sh` fails without it, so the launch that claims
      to serve TF now serves a tree attached to something
- [x] Ignore `/ap/pose/filtered`'s own `header.frame_id`, which says `base_link`
      and is wrong: AP_DDS fills the body from
      `get_relative_position_NED_home` swapped into ENU, so the content is where
      base_link is relative to home. A pose saying where base_link is cannot be
      expressed in base_link or it would be zero for ever, and anything
      believing the label pins every mapped return to the vehicle
- [x] Check the EKF's position and yaw against ground truth, neither of which
      anything had done. `check_attitude_estimate.sh` parks the vehicle on a
      ramp, and a parked vehicle at the origin says nothing about position;
      a ramp cannot be tilted in yaw either, so yaw was the one axis never
      compared against truth. `scripts/check_map_frame.sh` flies the circuit and
      compares `map` -> `base_link` against Gazebo: 0.012 m at the median,
      0.046 m at worst, yaw 0.01 degrees at the median. With the yaw sign
      flipped it fails at 179.5 degrees while the position half still passes
- [ ] Run the simulation on one clock. There are two: Gazebo's `/clock`, and
      every sensor message the bridge carries, count seconds from when the
      simulator started, while AP_DDS stamps `/ap/pose/filtered` with
      ArduPilot's UTC. Measured in the same instant: `/clock` 22.3 s, the front
      scan 22.3 s, the pose 1789156172. Nothing compares stamps across the two
      today - every node takes its ages from its own clock at the moment a
      message arrives - so nothing is broken, but anything that did would be
      wrong by 56 years. **Found, and it is one flag.** The `"/clock"` versus
      `"clock"` asymmetry this list used to point at is deliberate, not the bug:
      `AP_DDS_Client.cpp:1545` special-cases a leading slash to mean "skip the
      `ap` namespace", so the publisher lands on `/ap/clock` and the subscriber
      listens on the global `/clock` where Gazebo publishes. Both names are
      right. The real gate is `AP_DDS_Client.cpp:1601`, which skips creating the
      subscription unless `sitl->use_dds_sim_time`, and that is not an AP
      parameter - it defaults false in `SITL.h:287` and is written only from the
      SITL command line (`SITL_cmdline.cpp:399`). It cannot go in
      `ardupilot_params.parm`; it has to be `--use_sim_time true` on the launch
      line, which `build/sitl/bin/arducopter --help` confirms the built binary
      accepts. Downstream is already wired: `update_topic(Time&)` short-circuits
      to the external clock as soon as one arrives, so the flag is the whole fix.
      The skip prints a statustext, so the SITL log says which state you are in.
      Not applied yet - every script under `scripts/` launches without it, and
      turning it on moves every AP_DDS stamp from UTC to simulator seconds across
      the baseline, which wants a full CI run rather than a blind edit. Details
      in `workflow/troubleshooting.md`
- [ ] Confirm on a screen that RViz draws the occupancy map. The config has the
      display and the transform now exists, but the Fixed Frame is `base_link`
      so the room moves with the vehicle rather than standing still; `map` is
      the frame to watch it in, and changing the default would break
      `display.launch.py` on its own, where no `map` frame exists
- [x] Ask the coverage question somewhere it is a question. An empty convex room
      is the easy case: the LD06 sweeps the whole circle and reaches 12 m, so
      the vehicle maps 96 per cent of an 8 by 6 m room almost as soon as it is
      airborne, whatever path it flies. `cluttered_room.sdf` puts two things in
      the way - a pillar whose shadow sweeps across the room and fills itself in,
      and a dogleg enclosure whose pocket no ray through its door can reach - and
      `scripts/check_room_coverage.sh` flies the circuit and measures the
      enclosure's inside separately from the room. The current rule reads 90 per
      cent of the room and 77 to 80 of the enclosure, having never once gone
      inside it: closest approach 0.60 m in every run
- [x] Make that world actually occlude, which took three shapes and two
      measurements to get right. An alcove 4.5 m wide and 1.45 m deep read 94
      against the room's 96; a plain 2.8 m enclosure behind a 1.6 m door read 97
      against 94, *better* than the room it stands in, on a flight that never
      approached it. A doorway is an aperture rather than a pinhole: each point
      outside admits a different wedge, and their union over a circuit is very
      nearly everything. `inner_baffle` turns the inside into a dogleg and the
      figure falls to 77. The check asserts that too now - an enclosure over
      88 per cent on a flight that stayed outside fails, because the vehicle
      cannot have got better and the geometry can only have stopped hiding
- [x] A rule for where to fly that is better than "turn towards the roomier
      side". `frontier_explorer` reads the map for floor that touches unknown
      space and says which opening to head for; the demo steers at it and is
      otherwise unchanged. 96 per cent of the enclosure on both flights with it,
      against 80 for the reactive rule, which never went in at all. It took two
      further pieces, and each was named by the flight that failed without it:
      the clearance rule had to stop being a cone, and the explorer had to say
      how to get there rather than only where to go
- [x] Decide what is in the way by the swath the vehicle flies rather than by a
      cone. A 60 degree cone at the 1.7 m the demo wants clear is 1.7 m across,
      so no opening narrower than that could ever read clear - on a vehicle
      0.167 m wide. The explorer chose the 1.6 m door eight times in one flight
      and the demo turned away at 1.35 to 1.40 m every time, which was
      arithmetic and not bad luck. `nearest_in_corridor` reports the along-track
      distance of what lies within the rotor tips plus a margin, so a wall still
      stops the vehicle at the same distance and a doorjamb it would pass
      cleanly no longer does. The width is the model's own and
      `check_model_consistency.py` fails if either node's copy drifts from it
- [x] Give the explorer a way there, not only a destination. Publishing the
      frontier itself put the vehicle's nose on a line that crosses the wall
      beside the door, so it entered the enclosure in one flight out of two and
      that one was the line happening to pass through the opening. One
      breadth-first sweep over free cells, with the walls grown by what the
      vehicle needs, ranks openings by the distance actually flown and rules out
      the ones there is no way to; the published point is one stopping distance
      along the route. It also retired the timeout that used to guess an opening
      was "probably behind a wall", because the sweep answers that outright
- [x] Measure what the demo makes of a table, which is the everyday shape of
      what one scan plane misses. `table_room.sdf` and
      `scripts/check_table_height.sh`: the table is never a surface in the map -
      four to seven of the 126 cells it stands on, at either height - and what
      does come back is its outline, because a slice of a table is where the
      plane crosses its legs and its rim. The expected story, unseen at 1.00 m
      and seen at 0.50 m, is not what happens: the plane tips with the airframe,
      so at 0.90 m range 18 degrees of nose-down reaches a table the level plane
      passes 0.28 m over, and braking does that
- [ ] Give the vehicle a way to know a table is a table, which one plane cannot.
      A tilted or nodding lidar, or a depth camera, plus a map with more than
      one layer, plus frontier and clearance reasoning that works in it. That is
      a milestone rather than a task, and until it exists the demo can only say
      something stands about there
- [x] Make the floor rejection's margin an error bar rather than a flat
      clearance. It asked whether a return was low when the question is whether
      it is on the floor, and the two differ wherever a beam strikes something
      tall near its foot - which is what a leaning vehicle's forward beams do.
      It is now 0.10 m for what is wrong here plus two degrees of lean, which is
      0.035 m per metre of range. Measured on the way: the same flight puts
      fourteen cells of a table into the map where the flat bar put four, most
      of it having been discarded as ground
- [x] Put the vehicle down when the pack runs out. Nothing watched the battery
      at all and ArduPilot's own failsafe sat at its default, which is to do
      nothing, so a flight that ran the pack flat would have gone on hovering
      until it fell. The demo now lands deliberately at 3.5 V per cell and says
      why, and `BATT_FS_LOW_ACT` is the layer underneath that works whether or
      not ROS is alive. `scripts/check_low_battery_landing.sh` flies it
- [x] Write a document this could be rebuilt from.
      `spec/10_implementation_spec.md` carries every rule, constant and edge
      case, self-contained on purpose: `spec/05_demo_nody.md` was two nodes
      behind and named parameters the code never used, and the algorithms in
      the helper modules were in no document at all
- [x] `/ap/battery` was never being published and nobody noticed, because
      AP_DDS only publishes it for an instance the battery library calls
      healthy and `BATT_MONITOR` was unset. `BATT_MONITOR 4` is set now. Asked
      of every other publisher: exactly one more can go silent the same way.
      `/ap/navsat` is guarded by `if (update_topic(nav_sat_fix_topic, instance))`
      and that returns false whenever `gps.is_healthy(instance)` is false, which
      indoors is permanent - so anything that ever waits on it waits forever.
      Every other AP_DDS publisher writes unconditionally on its timer, so it is
      either present or the whole session is down, which is loud. Details in
      `workflow/troubleshooting.md`
- [x] Fix the header of `ardupilot_params.parm`, which said everything not set
      there comes from `copter.parm`. It does not - SITL is started with
      `--defaults` naming only our two files, so unset parameters sit at
      firmware defaults. **Audited: the claim is wrong but almost nothing is
      missing.** Of the 65 parameters `copter.parm` sets and we do not, the RC,
      compass, flight-mode and airspeed groups are irrelevant to a vehicle flown
      GUIDED over DDS; `FS_THR_ENABLE` is already 1 by firmware default;
      `FENCE_RADIUS` is inert with `FENCE_ENABLE` at 0; and `SIM_BARO_RND` has
      no definition anywhere in this checkout. Two things are worth knowing:
      **`MOT_BAT_VOLT_MIN/MAX` must not be inherited** - firmware default is 0.0,
      meaning voltage thrust-limiting off, while `copter.parm` carries 3S values
      of 9.6 and 12.8 that would be applied to this 4S pack, so making the header
      true requires pinning these two in the same commit; and the 18 `INS_ACC*`
      parameters are supplied by `libraries/SITL/SIM_JSON.cpp`'s `sim_defaults[]`
      table, not by any parm file, so **arming depends on `--model JSON`** and
      changing the model would fail with an INS error that does not mention the
      model. The header now says all of that. Details in
      `workflow/troubleshooting.md`
- [ ] Settle the two degrees on hardware. It is the whole error bar at range -
      0.28 m of the 0.38 m at 8 m - and SITL's EKF is fed a noiseless IMU, so
      the simulation would accept a tenth of it and prove nothing. This is the
      same open question as the attitude check being simulation agreeing with
      simulation, and the same flight would answer both
- [ ] The corridor is the swath of a vehicle going forwards, which is all this
      demo ever does. A sideways or diagonal command would need it pointed along
      the commanded velocity rather than along the nose, and nothing currently
      says so out loud
- [ ] `obstacle_monitor` still reports the nearest return in a cone while the
      demo decides on the corridor. That is defensible - one is a proximity
      warning and the other is a decision - but it means the log can say an
      obstacle is 0.9 m away while the vehicle correctly flies past it, and
      nothing in the monitor's output explains why
- [ ] Place each return with the pose the scan was taken at. The mapper uses the
      latest pose when the message arrives, and the two are tens of milliseconds
      apart; turning at 0.4 rad/s that is a couple of degrees, which at 4 m is
      the 0.15 m by which the worst wall cells overshoot while the median stays
      at the half-cell. Harmless in an empty room and the thing that smears a
      map built while turning faster
- [x] Give the rejection the lidar's height rather than the rangefinder's. The
      two are 26 mm apart along x and 66 mm along z, which level was 66 mm of
      height thrown away and leaning is less, because the offset rotates with
      the airframe. `body_point_height` is the third row written once and used
      twice, for a return in the scan plane and for the offset. The numbers are
      parameter defaults rather than a TF lookup, and
      `check_model_consistency.py` reads them out of the nodes and fails if the
      model moves either sensor - the same guard that keeps the URDF and the SDF
      together. Both worlds now assert the height against `front_lidar_link`
      rather than `rangefinder_link`, which is the property itself
- [x] Start `range_adapter` in the flight checks. Neither
      `check_forward_flight.sh` nor `check_room_circuit.sh` ever did, so
      `/openipc_cinewhoop/range/down` had no publisher, the demo node had no
      height, and every one of those flights ran with the floor rejection off.
      The forward flight check asserted the rejection never switched off during
      the flight and passed, because a rejection that was never on cannot be
      seen switching off; it now asserts it switched on first
- [ ] The attitude check is still simulation agreeing with simulation: SITL's
      EKF is fed a noiseless IMU, so it proves the convention rather than the
      accuracy. A real flight controller on a real ramp is what would test the
      estimate itself

- [x] Implement `obstacle_monitor.py`
- [x] Verify subscriber behavior on the front lidar (`scripts/check_front_lidar.sh`, now in CI)
- [x] Implement `trajectory_publisher.py`
- [x] Implement `simple_indoor_autonomy.py`
- [x] Guard against a stale scan; a dead lidar used to leave the last range in place
- [x] Give the demo node its own arm/mode/takeoff through the ArduPilot services
- [x] Verify slow 0.5 m/s forward flight (`scripts/check_forward_flight.sh`)
- [x] Find why DDS control cannot move the cinewhoop while MAVLink can and the Iris can
      (an orphaned demo node's `/ap/cmd_vel` replaced the GUIDED takeoff submode)
- [x] Stop with real clearance: the demo now decides at the wanted clearance plus
      the measured 0.6 m braking distance, which took the margin to the wall from
      0.16 m to 0.82 m. The braking itself is ArduPilot's deliberate motion
      shaping, so the decision moves earlier rather than the braking getting harder
- [x] Verify stop behavior below 0.8 m from an obstacle

## Milestone 11: Unified Launch

- [x] Bring Gazebo, both bridges, `robot_state_publisher`, RViz2, the Agent and
      SITL up from `sitl_gazebo.launch.py`
- [x] Make `sitl:=false` print how to run SITL in a separate terminal
- [x] Fix `display.launch.py`, where `rviz:=false` did not actually stop RViz2
- [x] Verify Gazebo and ArduPilot topics plus TF from one launch
      (`scripts/check_unified_launch.sh`)
- [ ] Confirm on a screen that RViz shows the model, TF and the lidar correctly

## Milestone 12: Swarm in Simulation

The task is `spec/roj/`, the plan is `spec/roj/07_plan_a_milniky.md`, and
these are the pieces of it that are not done. M0, M1, M3 and M4 are closed;
M2 is closed except the two items below; M5 is where the work is.

### Open, and blocking M5

- [x] Add each agent's start offset to the pose the coordinator reads.
      AP_DDS publishes a pose relative to that vehicle's own origin, so three
      machines 2 m apart report the same position and the safety filter stops
      them for ever. The offsets are in `generate_agent_models.py`
      (`START_POSES`); pass them to the coordinator as a parameter.
      Done in `openipc_swarm/frames.py`: `start_offsets` is required, the
      generator prints it and `check_swarm_mapping.sh` passes it on. Targets
      go back out in each agent's own frame.
- [x] Shift each agent's grid by the matching number of cells before merging,
      for the same reason: three grids centred on three different physical
      places are being overlaid as if they were one room, so the 83 to 84 per
      cent coverage reported so far is that overlay and not a measurement.
- [x] Re-fly `check_swarm_mapping.sh 3` once both are in, and compare against
      the baseline honestly: 89 to 93 per cent of the room, 92 to 94 of the
      enclosure, with a noise floor of 4 points on the room and 14 on one
      wall. **Bimodal, 2026-10-03.** With offsets, backoff and the agents
      cleared out of the planning map, four flights came out 92/94, 85/59,
      92/93 and 86/58 (room/enclosure). The good mode is the baseline, not
      better; the bad mode is the swarm in a jam - two agents without a
      target wander reactively into the same corner, stop each other, and
      the one let back off creeps without getting out. Clearing the agents
      out of the map is right in principle and made no measurable difference.
- [x] Decide what an agent without a target does: R5a, sent away from the
      others (`assignment.spread_targets`), never past a close neighbour.
- [x] Unjam the swarm. It took six things, each found in a flight's trace:
      every jammed group gets a backer, not only the first pair; a backer
      moves only if its target leads away from its neighbours (moving in any
      direction, v1 flew into v3 under d_safe); a backer headed away has the
      room to contact, not to d_safe; the slow band brakes only a pair
      closing faster than 5 cm/s (it held two hovering agents at 0.04 m/s for
      a whole flight); a held agent turns in place towards its target
      (`simple_indoor_autonomy` `constraint_topic`); and an agent held 2 s is
      sent away and stays so until it is clear of everyone, rather than
      flipping back to its opening after one tick.
- [x] Launch the swarm from one spot (R15 amended): a row 0.8 m apart, just
      outside d_safe, so the swarm has to spread itself out.
- [x] Let targets lie 0.2 m off a wall instead of 0.3 m, so the agents can
      look into the 0.5 m alley behind the enclosure.
- [x] Record a trace from the ground up (`trace_path`: positions, limits,
      targets every tick, map changes every second) and replay it
      (`scripts/replay_swarm_run.py`: slider, map discovered over time and
      scored against the world file). `scripts/watch_sim.sh` opens a Gazebo
      window onto a running flight once it is airborne.
- [ ] Thin walls get erased. A one-cell wall (the enclosure's, the pillar's
      middle) is marked free by rays whose end lands a few cm past its face;
      the replay shows them red. The mapper should not clear the cell a ray
      ends in, or should stop clearing a cell already well evidenced as
      occupied.
- [ ] The coverage figure counts the floor cell in front of every wall as
      floor, and the map draws the wall's face into it: about 6 points of
      the room that were seen. Count "seen" (free or occupied) as well as
      "free", or drop the cells a face runs along, and re-take the baseline
      the same way.
- [x] Measure time to coverage, not coverage at a fixed time:
      `replay_swarm_run.py` writes T50/T80/T90 for the room and the
      enclosure from the trace (`time_to_coverage.json`), on the floor-only
      mask, so the cells a wall's face runs along do not cap it.
- [x] Viewpoints instead of openings, and the allocators of reserseRoju 06
      and 07 behind one parameter (R5b, `allocation.py`): `iterative`,
      `hungarian`, `minpos`, `utility` (default), with `clusters` as the
      old R5. The point sent is the cell costed, the turn uses the real yaw,
      and changing target costs 1 m.
- [x] Compare the allocators and the filters on the same flights: 48
      flights on 2026-10-05 in three worlds, every seed by `Gus/Guv/Gis/Giv`
      (`swarm_batch.py`). `utility` beat `iterative` to the enclosure's T90
      in 14 of 21 pairs (median 9 s, sign test p ~ 0.03) and stays the
      default; vector and scalar were level (10 to 8) and vector kept every
      pair at d_safe, so vector is the default now (R19a). Metres flown and
      ticks held were not compared.
- [x] Door reservation: off by default since 2026-10-05 (coordinator
      `reserve_passages`, `OPENIPC_RESERVE_PASSAGES`). In 43 valid
      flights with it and 4 without, two agents were never at one narrow
      place at once; in one it hurt - the holder dithered between two
      targets inside, a holder inside has no lease, and the other two stood
      outside for the rest of the flight (enclosure 69 %).
- [ ] Before reservation is switched on again: a holder that makes no
      progress inside a passage loses it; the detector stops calling
      everything under ~1.58 m narrow (clearance is 0.4 m, not 0.25) and
      stops merging a door with the corridor behind it. Then fly it in a
      world where the work behind a 1.2 m door needs more than one agent.
- [ ] An agent occasionally drifts to 0.10-0.20 m of a wall with no
      neighbour near: into the pillar while turning in place after
      overshooting its target, round the enclosure's corner (one flight in
      ~100, scalar and vector alike; `wall_m` in the batch results).
- [ ] Record which agent saw which cell first, so overlap and each agent's
      share can be measured (07 section 6); the merged map alone cannot say.
- [x] Door reservation and waiting outside it (07 section 4.3, E3):
      `passages.py`, `reserve_passages:=true`. Not flown where it matters:
      the test world's doors are 1.6 m and two agents pass in them.
- [x] A world with a door narrower than ~1.3 m, to fly the reservation:
      `cluttered_room_narrow_doors.sdf`, the enclosure's door and the gap
      past its baffle both 1.0 m, the enclosure region unchanged.
      `scripts/door_conflicts.py` says how long two agents were at one
      narrow place at once.
- [x] Check the barrier's sideways motion against walls: the arbiter makes
      a half-plane of each nearby wall from the agent's 360° scan
      (`velocity_barrier.wall_half_planes`), loosened to whatever the
      autonomy itself asked for, and the sideways allowance goes from 0.15
      to 0.25 m/s while the scan is fresh. The batch records the closest
      any agent came to a wall (`wall_m`).
- [x] Barrier filter (CBF, right-hand rule) as R19a, opt-in:
      `velocity_barrier.py`, arbiter `filter_mode:=vector`, coordinator
      `safety_filter:=vector`. Found AP_DDS reads base_link y as right.
- [x] The scalar filter let a backer creep along its nose into its
      neighbour (0.07 m). A backer now moves only if its target and its nose
      both lead away: 8 valid flights, none under 0.77 m.
- [x] Barrier gamma 2 closed a head-on pair to 0.39 m in flight (latency and
      lag); 0.7: 6 valid flights, never under 0.75 m, enclosure mean 86 %.
- [x] One agent fails to arm in SITL in about one flight in four (7 of 28
      on 2026-10-03, always "waiting for the vehicle to become armable").
      It never asked: ArduPilot's STATUSTEXT (now logged per agent,
      `v<i>/statustext.log`) has no arming attempt and no PreArm refusal
      from the agent that stayed down. A prearm_check request or reply lost
      over XRCE-DDS left the autonomy's one pending call pending for good.
      Calls unanswered for `service_timeout_s` (3 s) are now dropped and
      asked again; the first flight after the fix lost one and flew.
- [x] The check now fails a run in which not every agent got airborne,
      instead of measuring the agents that did.
- [ ] Altitude sags during a swarm flight, from about 0.97 m to 0.45 m over
      200 s. Find out whether it is the SITL battery or the commands.
- [x] The swarm check timed 130 s after a fixed 90 s wait, while the agents
      are up in 10 s: every swarm figure before this afternoon is after some
      220 s. It now starts at take-off (R3 amended).
- [ ] Re-take the single-drone baseline and the swarm the same way: the
      baseline's 130 s include its take-off, the swarm's do not.
- [x] Work out why no agent is ever assigned a target. It was the frame bug:
      with the offsets in, one agent is assigned on every tick. Only one,
      because of 13 openings in the merged map only one was reachable at
      flying clearance - the enclosure door - and greedy gives one opening
      to one agent. That is the rule working, not a bug; the coordinator log
      now carries the opening count and every agent's cell to tell the two
      apart (`frontier_clusters`, `agent_cells`), and the check saves the
      last merged map as `merged_map.json` for an offline replay.
- [x] Break the stop deadlock. A stop is a scalar speed limit of zero, so a
      pair inside the stop line could never open the gap: v2 and v3 stood
      1.39 m apart against a 1.41 m line on every tick of the first flight
      with offsets, 1901 stops. `deadlock_backoff` already picked who gives
      ground and nothing called it; `backoff_limit` now lets that one move as
      fast as still stops it short of d_safe from everyone, who are stopped.

### Open, not blocking

- [ ] Per-agent acceptance runs: fly each of the three through the
      single-drone checks rather than trusting that three work because one
      does. `spec/roj/02_vrstva_drona.md` section 4 lists them.
- [ ] TF prefixes: `map -> v<i>/base_link`, one `pose_tf_broadcaster` per
      agent. Nothing consumes them yet, which is why this is not blocking.
- [ ] Contract tests from `spec/roj/04_rozhrani.md` section 6 - swapped
      identities, a coordinator that goes quiet, a stale state, a restarted
      instance. These need machines running, which they now are.
- [ ] Decide the conflict-cell threshold before the first scored swarm run,
      as R17 asks. The merge already counts conflicts and the log carries the
      fraction; nobody has said what value is too many.
- [ ] Re-measure the CineLog's coverage baseline. Everything recorded for it
      was measured while it was standing in for the Pavo20, so its own
      numbers are sound, but they were taken with the old guided timeout.

### Follow-ups from what was found on 2026-09-20

- [ ] `check_room_coverage.sh` still derives the room geometry inline, while
      `scripts/room_geometry.py` now holds the same derivation for the swarm
      check. Point the older check at the module so the two cannot drift.
- [ ] `check_model_consistency.py` compares geometry, mass, the throttle
      scale and the hover throttle. It does not compare the rate gains in the
      parameter file against anything, and the gains are now per airframe.
- [ ] The swarm runs leak nothing now, but the leak that was found - one
      `parameter_bridge` per agent surviving every run, two hours' worth of
      them - suggests every opt-in check deserves the same audit.

## Milestone 10: Real Drone Build

- [x] Fill in the exact component table, and do it for three airframes rather than
      one, so the choice is a comparison instead of an assumption
      (`spec/realna_stavba_dronu/03_komponenty.md`)
- [x] Settle the airframe: CineLog30 V3 with the MicoAir H743 V2 stands, after
      comparing lighter alternatives. AP_DDS needs an H7 and no OpenIPC air unit
      runs on 1S. The project has no lightweight fallback as a result
- [x] Verify connectors and supply voltages from the datasheets; physically
      measuring them is step 2 of the bench checklist
- [x] Prepare a bench checklist without propellers
      (`spec/realna_stavba_dronu/04_bench_checklist.md`)
- [ ] Weigh individual components, which needs the parts on a scale. The
      Rotorama CZ half of the Pavo20 list has arrived
      (`spec/realna_stavba_dronu/13_nakoupeno.md`); the frame, the Walksnail
      Lite+ and the lidar have not
- [ ] Bring `models_pavo20/` down to what was bought. The model flies the
      850 mAh pack at 0.22934 kg; the order brought a 750 mAh pack at 69 g
      instead of 76, and the video unit is now the 10.5 g Walksnail Lite+
      rather than the 13.76 g Wyvern. The bill of materials says 0.21908 kg,
      thrust to weight 3.7. Hover throttle and gains need re-running, and the
      57 g 550 mAh spare should at least be checked to hold altitude
- [ ] Plan mechanical sensor placement, which needs the frame dry-fitted
- [x] Choose the front obstacle sensor: LDRobot LD06, imported. Nothing else in the build is blocked on a
      single decision this hard: LD06 is the only candidate that gives a real
      `LaserScan` but weighs about as much as half the airframe, while a
      VL53L5CX-class sensor keeps the mass but halves the range. The simulated
      front lidar has to be re-specified to it. Czech shops stock 360 degree
      lidars only in the RPLidar class, which starts at 110 g, so it is an import
- [x] Re-specify the simulated `front_lidar` to the LD06: the full 360 degrees at
      1 degree resolution, 10 Hz, 0.02 to 12 m, on a mast above the propellers.
      The demo nodes take a forward sector instead of the whole scan, because
      the real sensor reports what is behind the vehicle too
- [x] Raise the model mass to match the bill of materials: 0.306 kg, with the
      LD06's 42 g on `front_lidar_link` where it actually hangs. Hover throttle
      went to 0.46 and the rate gains had to be measured again, because the mast
      roughly doubles the pitch inertia
- [ ] Re-measure the gains once more if the video unit changes. The 0.306 kg
      assumes a RunCam WiFiLink 2; the EMAX Wyvern Link Alpha would make it
      about 294 g
- [ ] Dry-fit the LD06. It has to see forward past the ducts without meeting a
      propeller on a 128 mm frame, and that can still kill the choice
- [x] Revisit the 0.240 kg the simulation flies on. The published bill of
      materials sums to 238 g, but that omits wiring, screws and TPU, and the
      stock airframe's own dry weight puts the real figure nearer 264 g before
      any front sensor. Thrust to weight would go from 5.9 to about 5.3
- [x] Reconcile the wheelbase: 126 mm was an assumption, GEPRC publish 128 mm.
      Motor coordinates moved from 0.04455 m to 0.04525 m in both model files.
      The rate gains were deliberately not re-derived: the authority ratio moves
      from 7.7 to 7.8, which is inside the accuracy of the method that set them
- [ ] Order a ZH1.5T-4P to JST-SH adapter with the LD06, or plan to reterminate
      its cable. The lidar's connector is 1.5 mm pitch and AIO UART headers are
      usually 1.0 mm
- [ ] Watch the 5 V rail. The LD06 is a brushed motor drawing 300 mA at startup
      on the same BEC as the flow sensor and the receiver. Current is not the
      problem; noise might be
- [ ] Settle whether ArduPilot's LD06 driver takes the STL-19P. The D500 kit's
      sensor speaks the same frame (0x54, 12 points, same CRC) at the same
      230400, and the ROS 2 package runs it off `ld19.launch.py` - so Lidar360
      with `PRX1_TYPE` 16 should just work. Should is doing the work in that
      sentence; nobody has plugged one in. This is the last thing between the
      comparison and buying the D500 instead of the LD06
- [ ] Re-do the 5 V budget if the D500 is bought. STL-19P draws 540 mA at
      startup and 290 mA running, against the LD06's 300 and 180. Still under a
      third of the 2 A BEC, but the capacitor that was already advised stops
      being optional
- [x] Verify LD19 against LD06, which the alternatives chapter had recommended
      as the newer and cheaper default. It is neither: LD19 is the same sensor
      with a bottom mounting plate, 5 g heavier, and youyeetoo list it as
      discontinued. Its own spec table maps `FHL-LD19` to device `LDS06`. D300
      is that same LD19 plus a CP2102 USB board, which is dead weight when the
      scan goes out over UART. The one genuinely different sensor of the four is
      the D500's STL-19P
- [ ] Confirm the EMAX Wyvern Link Alpha over the RunCam WiFiLink 2. It is 11 to
      16 g lighter for the same job, which the mass goal prefers, but EMAX publish
      neither power draw nor range where RunCam quote up to 15 W. Those two
      figures are what is missing
- [x] Decide what to do about the 250 g class: there is no class to stay inside.
      Mass is a standing goal and a tie-breaker between equals, not a gate. It
      was silently deciding the front sensor by arithmetic, which is the wrong
      way round
- [ ] Close build phase 8, OpenIPC stream to `sensor_msgs/msg/Image`, with the
      WiFiLink 2 on a desk rather than on an airframe
- [x] Prepare mapping from simulation topics to real sensors; the mapping was
      already specified, so this verified it against the implementation
      (`scripts/check_topic_remap.sh`, in baseline CI)
- [x] Make the ArduPilot service names parameters, which the build spec requires
      and the node had hardcoded
- [x] Fix `trajectory_publisher`'s QoS: a RELIABLE subscription never matched
      AP_DDS's BEST_EFFORT pose publisher
- [x] Close the rest of the sim-to-hardware transition checklist, which turned up
      four defects that only real hardware would have shown
- [x] Give the Gazebo sensors `gz_frame_id`: the lidar, rangefinder and camera
      stamped scoped names that are not in the TF tree, so RViz could not draw
      them and a real driver would publish something else
- [x] Publish `/openipc_cinewhoop/range/down` as `sensor_msgs/msg/Range` through
      `range_adapter`, and make the simulated sensor a 15 degree fan, since a
      time-of-flight rangefinder returns the nearest surface in its cone
- [x] Bridge an unrotated IMU: the ArduPilot-facing sensor is in aircraft
      convention, so ROS was reading -9.81 on z where REP 103 and AP_DDS give
      +9.81
- [x] Make `use_sim_time` a launch argument; hardcoded true would have frozen
      the demo nodes' clocks on hardware and silently disabled the stale-scan guard
- [x] Verify the safe state on sensor dropout (`scripts/check_sensor_dropout.sh`)
- [x] Add `scripts/check_sensor_interface.sh` to baseline CI, which checks the
      shape of the sensor data rather than the names on the graph
