phageweb/dron/workflow/research_rotor_simulation.md

# Research: Simulating Small Rotors for ArduPilot SITL in Gazebo

Written 2026-09-10 while the custom cinewhoop would arm and produce thrust but
flip within about 1.5 s of throttle-up. Everything below is external material
plus arithmetic against our own measurements; anything not verified in this
repository is marked as such.

## The question

Our rotors are driven by `ArduPilotPlugin`'s `<control>` blocks with
`type=VELOCITY` and `useForce=1`, and lift comes from eight `LiftDrag` surfaces,
copied from the Iris reference. At the real inertia of a 3 in propeller
(izz 8.0e-07) that velocity loop changes rotor speed by 168 % of its target in a
single physics step. Raising the inertia stabilises the loop but stores real
angular momentum, so spin-up reaction yaws our 0.00038 kg m^2 airframe at
thousands of deg/s. Is there a better primitive?

## Finding 1: Gazebo has a purpose-built rotor system

`gz-sim` ships `MulticopterMotorModel`, which is designed for exactly this and
avoids the velocity PID entirely. It commands the joint velocity directly and
computes thrust and reaction torque analytically:

```
realMotorVelocity = jointVelocity * rotorVelocitySlowdownSim
thrust            = turningDirection * sign(v) * v^2 * motorConstant
dragTorque        = -turningDirection * thrust * momentConstant
```

The reaction torque is applied to the parent link, so yaw authority is explicit
and always consistent with thrust, rather than emerging from blade drag.

### Parameters, with defaults from the implementation

| Parameter | Default | Meaning |
|---|---|---|
| `motorConstant` | 8.54858e-06 | thrust coefficient, N/(rad/s)^2 |
| `momentConstant` | 0.016 | reaction torque per unit thrust, m |
| `maxRotVelocity` | 838.0 | command saturation, rad/s |
| `timeConstantUp` | 1/80 s | first-order spin-up lag |
| `timeConstantDown` | 1/40 s | first-order spin-down lag |
| `rotorDragCoefficient` | 1.0e-4 | air drag scaling |
| `rollingMomentCoefficient` | 1.0e-6 | rolling moment scaling |
| `rotorVelocitySlowdownSim` | 10.0 | velocity rescale for numerical stability |
| `turningDirection` | required | `cw` or `ccw` |
| `actuator_number` | required | index into the `Actuators` velocity array |

### `rotorVelocitySlowdownSim` is the answer to our stability problem

The joint turns ten times slower than the modelled rotor, and the thrust
computation multiplies the speed back up before squaring. Physics therefore
never sees the high angular rate that makes our loop diverge, while thrust and
torque stay correct. This is a default, not an exotic setting, which suggests
everyone building small rotors in Gazebo hits our problem.

Note that `ArduPilotPlugin` reads the same-named `<rotorVelocitySlowdownSim>`,
while both Iris and our model write `<controlVelocitySlowdownSim>`. The plugin
therefore silently uses its default of 1. Harmless today because 1 is what those
models want, but it means the knob we needed was never actually connected.

## Finding 2: `ArduPilotPlugin` can drive a topic instead of a joint

Alongside `VELOCITY`, `POSITION` and `EFFORT`, the plugin supports
`type=COMMAND`, which publishes a `gz.msgs.Double` to `cmd_topic` and touches no
joint at all. Verified in our own checkout at `src/ArduPilotPlugin.cc:629` and
`:1317`. Community examples point `cmd_topic` at things like
`/model/<name>/joint/<joint>/cmd_vel` and at thruster topics for underwater
vehicles.

This gives two clean architectures that both remove the PID:

- **COMMAND to `JointController`** - kinematic velocity, exact tracking, but no
  motor reaction torque, so yaw authority would have to come from blade drag
  alone. We measured that a kinematic velocity command does drive our rotors to
  exactly the commanded speed and lifts the airframe on the thrust stand.
- **COMMAND to `MulticopterMotorModel`** - needs a small adapter, because the
  plugin publishes one `Double` per joint while the motor model subscribes to a
  single `Actuators` array indexed by `actuator_number`. Roughly thirty lines of
  Python or a tiny Gazebo system.

The second is the better target: it gives thrust, explicit yaw torque and motor
lag, with no joint force loop anywhere.

## Finding 3: ArduPilot's default gains are for a much larger vehicle

The ArduPilot MethodicConfigurator tuning guide states plainly that the default
PID gains target a **9 to 12 inch propeller** vehicle, and that smaller props
need lower than default rate gains. Our `ardupilot_params.parm` sets only
`FRAME_CLASS` and `FRAME_TYPE`, so every gain is a default meant for a vehicle
roughly five times our size.

Concrete anchors from the official tuning page:

- `INS_GYRO_FILTER` 80 Hz for 5 in props (higher for smaller)
- `MOT_THST_EXPO` 0.55 for 5 in props
- `ATC_RAT_*_FLTD` and `ATC_RAT_*_FLTT` at `INS_GYRO_FILTER / 2` on roll and
  pitch, `INS_GYRO_FILTER / 4` on yaw

The LiftDrag thread on ArduPilot Discourse ends with the reporter resolving very
similar instability purely by iterating `ATC_RAT_RLL_P/I`, `ATC_RAT_PIT_P/I` and
`ATC_RAT_YAW_P/I`, which supports tuning as a real part of the fix rather than a
distraction from the model.

## Finding 4: `AHRS_EKF_TYPE 10` separates vehicle dynamics from estimation

Recommended on the same thread and documented as the SITL AHRS type, this makes
ArduPilot use simulator ground truth instead of running the EKF. It removes the
whole class of failures we burned time on today - "Check mag field", "Accels
inconsistent", "Gyros inconsistent" and repeated EKF resets - none of which were
what we were trying to measure. It should be the default for any run whose
purpose is validating the airframe rather than the estimator.

**Tried here, and it does not work yet.** With `AHRS_EKF_TYPE 10` the estimator
noise does disappear - reported gyro rates drop to zero and the EKF messages
stop - but ArduPilot then reports the airframe as pitched about -90 degrees
while it sits level in Gazebo, and prearm refuses to arm a vehicle it believes
is on its side. Our `modelXYZToAirplaneXForwardZDown` and `gazeboXYZToNED` are
identical to the Iris reference, and the plugin does send ground-truth pose
through those transforms (`CreateStateJSON`), so the fault is somewhere in that
composition rather than in the parameter. The parameter is deliberately not in
`ardupilot_params.parm`; resolving the attitude offset is its own task, and the
Iris reference is the obvious control experiment.

## Finding 5: this is a known hard spot with no published answer

Two Discourse threads describe our exact situation on custom ardupilot_gazebo
models: one where the model arms but will not take off, and one where it arms
and then flips during takeoff. Neither received a working answer. There is also
an open `gz-sim` issue (#2657, October 2024) reporting that yaw direction is
inverted in `MulticopterVelocityControl`, so sign conventions around
`turningDirection` deserve an explicit test rather than trust.

Practical consequence: verify rotation sense by measurement on our own rig
before assuming any convention, and keep the Iris reference run as the control.
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
