phageweb/dron/dps/aio/AUTOMATIZACE.md

# Automatický postup a reference MicoAir V2

**Aktuální směr 21. 10. 2026:** rešerše a návrh přesunů jsou v
[RESERSE_LAYOUTU_V2.md](./RESERSE_LAYOUTU_V2.md), provedení v
[PREDAVKA_LAYOUTU_V2.md](./PREDAVKA_LAYOUTU_V2.md). Níže popsané nástroje zůstávají
k dispozici, ale před dalším trasováním je nutné řešit rozmístění a uvedené
limity kontrol, zejména chybějící courtyard a zúžení silových spojů routerem.

Rozhodnutí uživatele z 19.–20. 10. 2026: znovu projít vznik DPS, co nejvíc kroků
automatizovat a co nejvíc se řídit **MicoAir743v2-AIO-45A**. Rozmístění ani měď ESC
nejsou nedotknutelné; změna má mít technický důvod a ověřený výsledek. Starý cíl
„za každou cenu dokončit zbývajících 22 spojů na stávajícím layoutu“ tomu ustupuje.
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
