phageweb/dron/cad_claude/drone.png

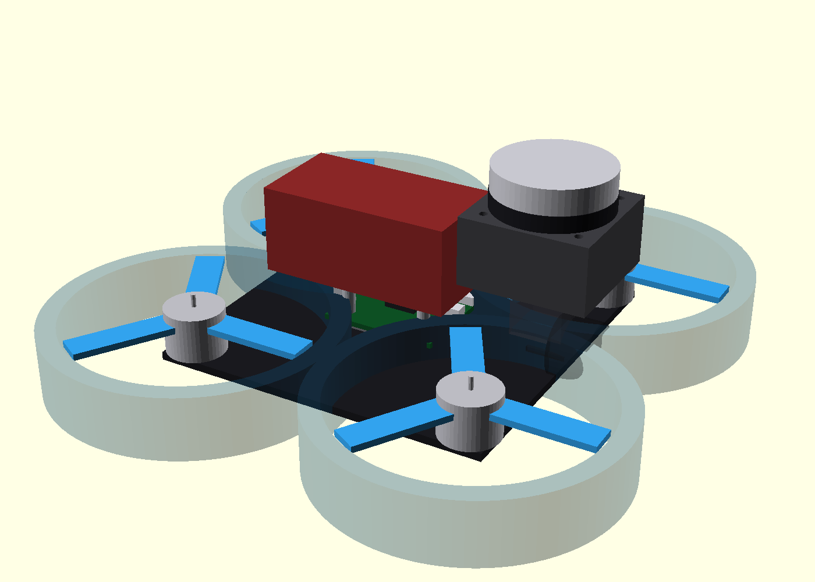
cad_claude/drone.png
