phageweb/dron/cad_claude/drone_side.png

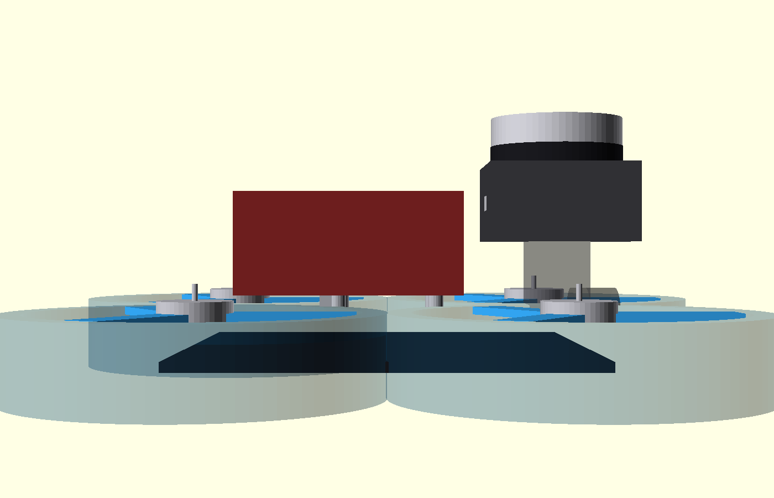
cad_claude/drone_side.png
