phageweb/dron/cad_claude/drone_top.png

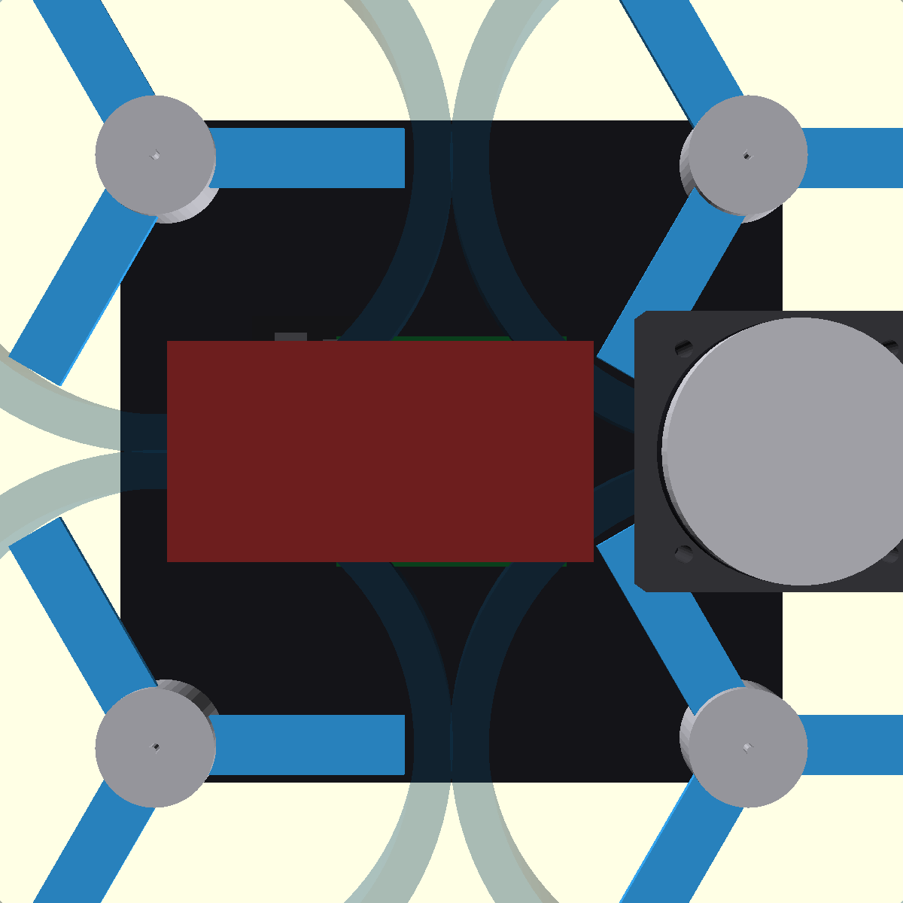
cad_claude/drone_top.png
