phageweb/dron/cad_claude/electronics.png

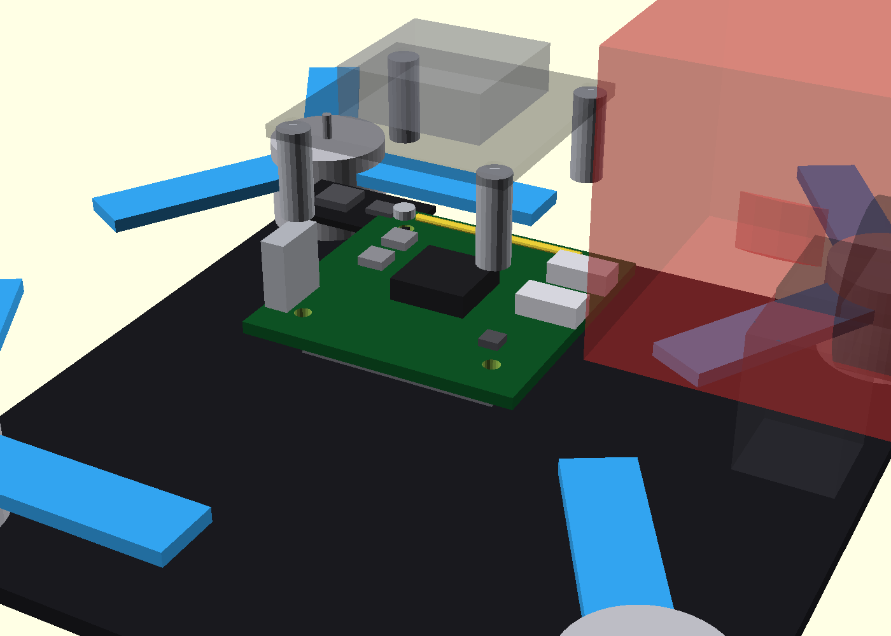
cad_claude/electronics.png
