phageweb/dron/cad_codex/isometric.png

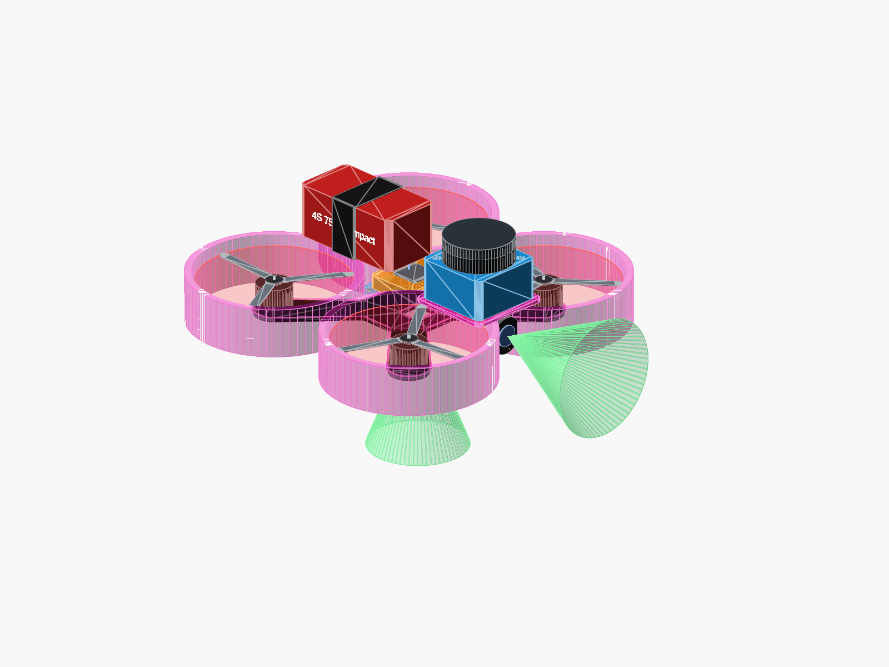
cad_codex/isometric.png
