phageweb/dron/cad_codex/side.png

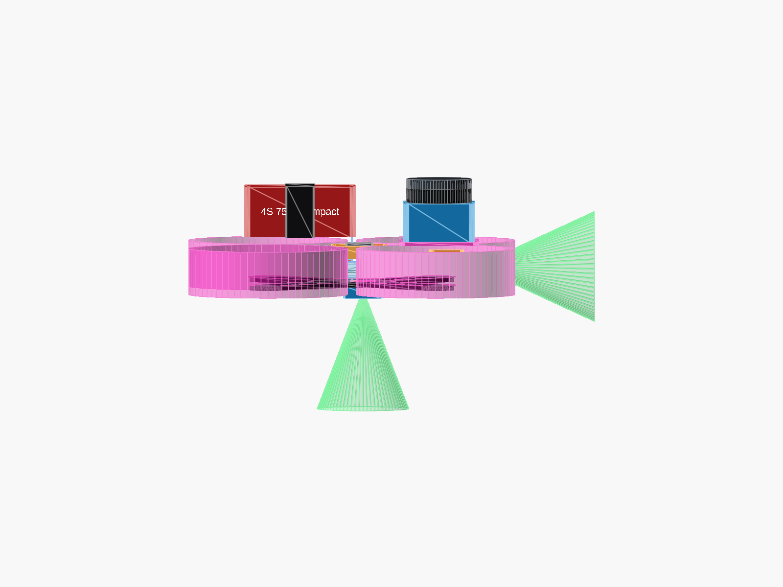
cad_codex/side.png
