phageweb/dron/cad_codex/top.png

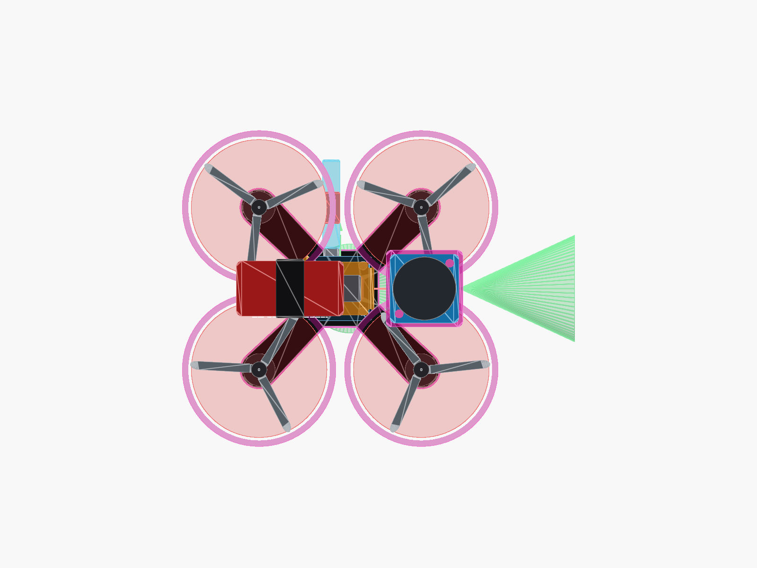
cad_codex/top.png
