phageweb/dron/dps/aio/reference/H743V2-AIO.webp

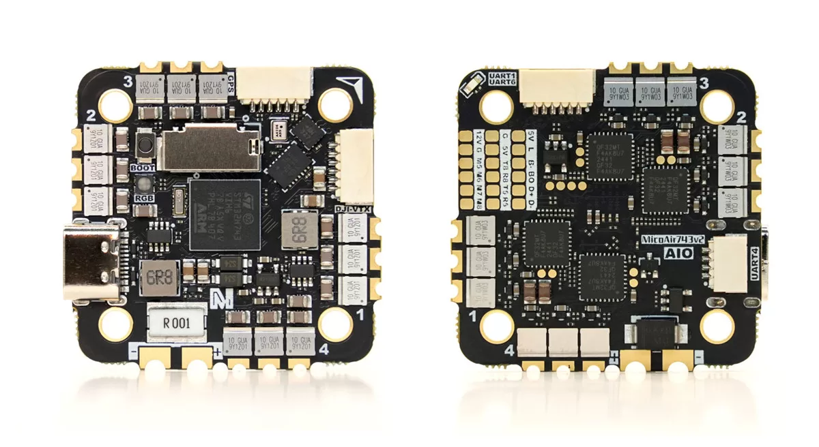
dps/aio/reference/H743V2-AIO.webp
