phageweb/dron/model/drone_without_d500.png

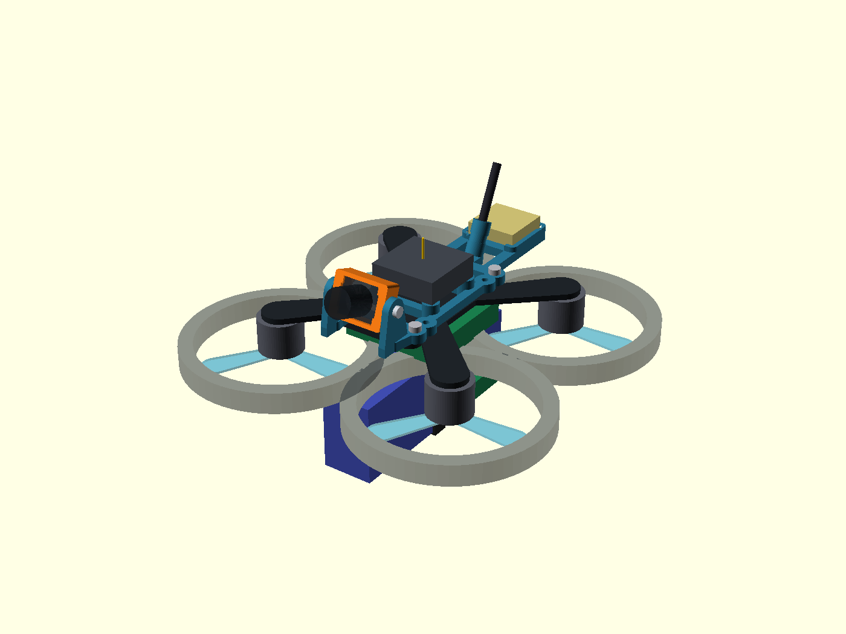
model/drone_without_d500.png
