phageweb/dron/model/holder_rear.png

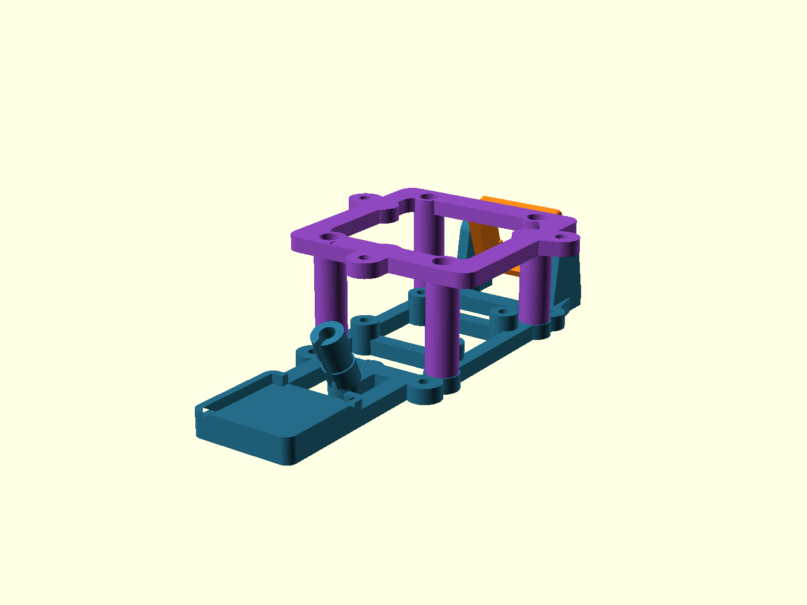
model/holder_rear.png
