phageweb/dron/model/2-camera_insert.stl

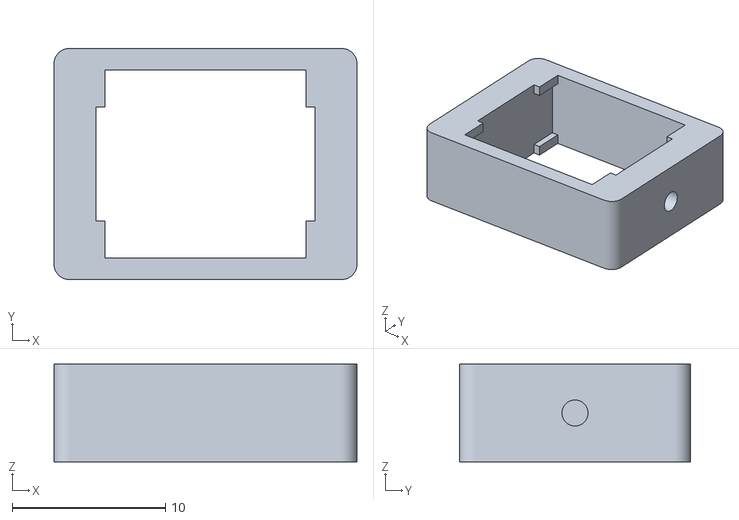
[picture p12: CAD file, 2026-10-13]
model/2-camera_insert.stl
19.8 x 15.1 x 6.40
