phageweb/dron/model/stazene/pavo-20-pro-canopy-fenouil/canopy-pavo20pro.step

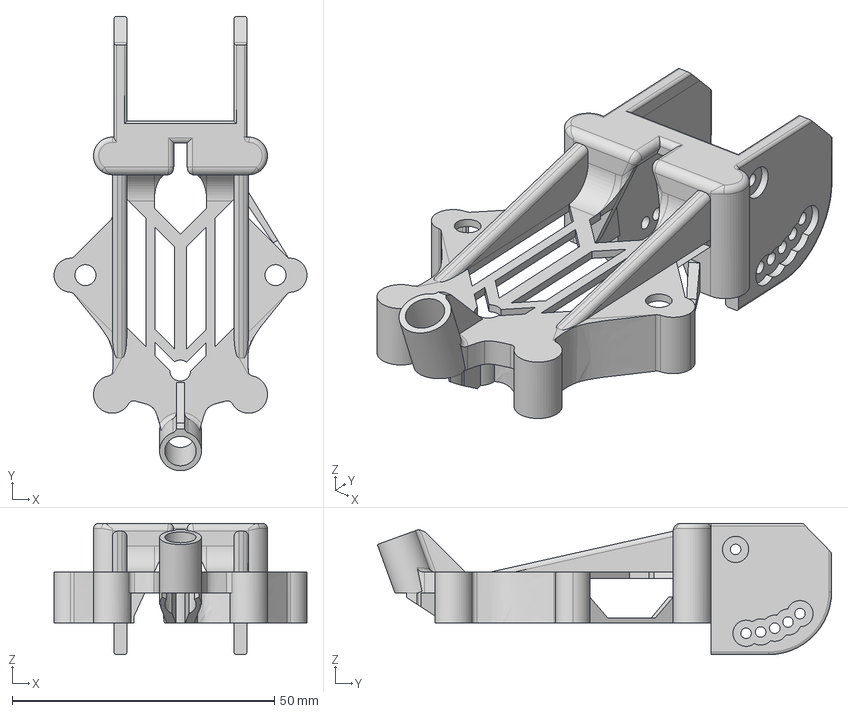
[picture p13: CAD file, 2026-10-13]
model/stazene/pavo-20-pro-canopy-fenouil/canopy-pavo20pro.step
48.3 x 86.7 x 25.1 mm
