phageweb/dron/model/stazene/walksnail-ascent-lite-tinywhoop-canopy/walksnail_ascent_lite_canopy.stl

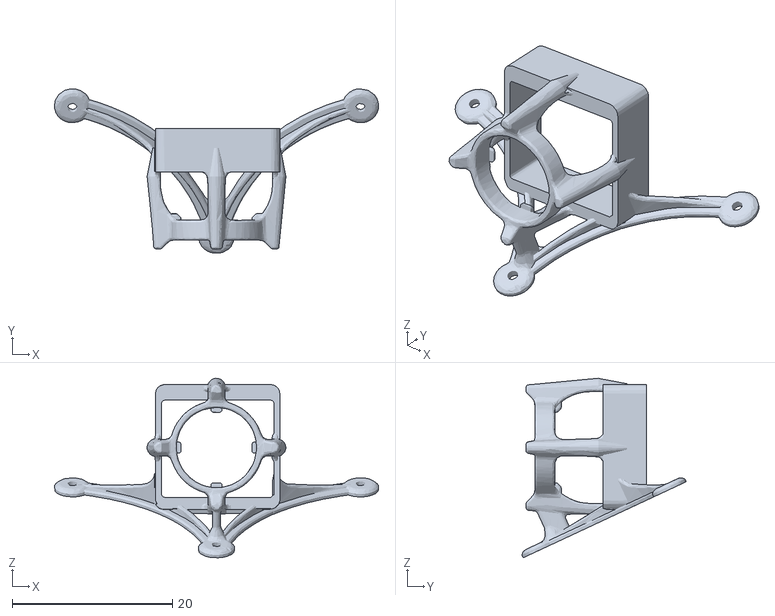
[picture p14: CAD file, 2026-10-13]
model/stazene/walksnail-ascent-lite-tinywhoop-canopy/walksnail_ascent_lite_canopy.stl
40.4 x 20.5 x 22.4
