phageweb/dron/model/1-base.stl

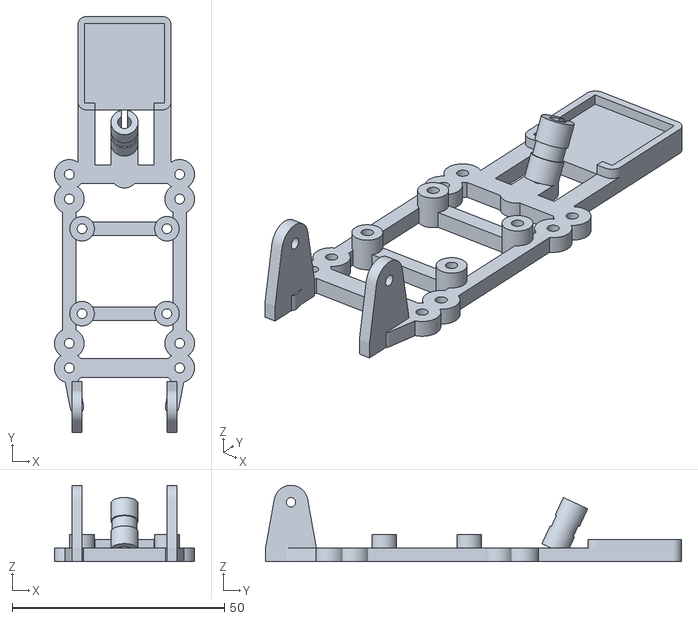
[picture p15: CAD file, 2026-10-13]
model/1-base.stl
33.0 x 98.0 x 18.0
