phageweb/dron/model/stazene/pavo-20-pro-canopy-fenouil/canopy-pavo-20-provrom.stp

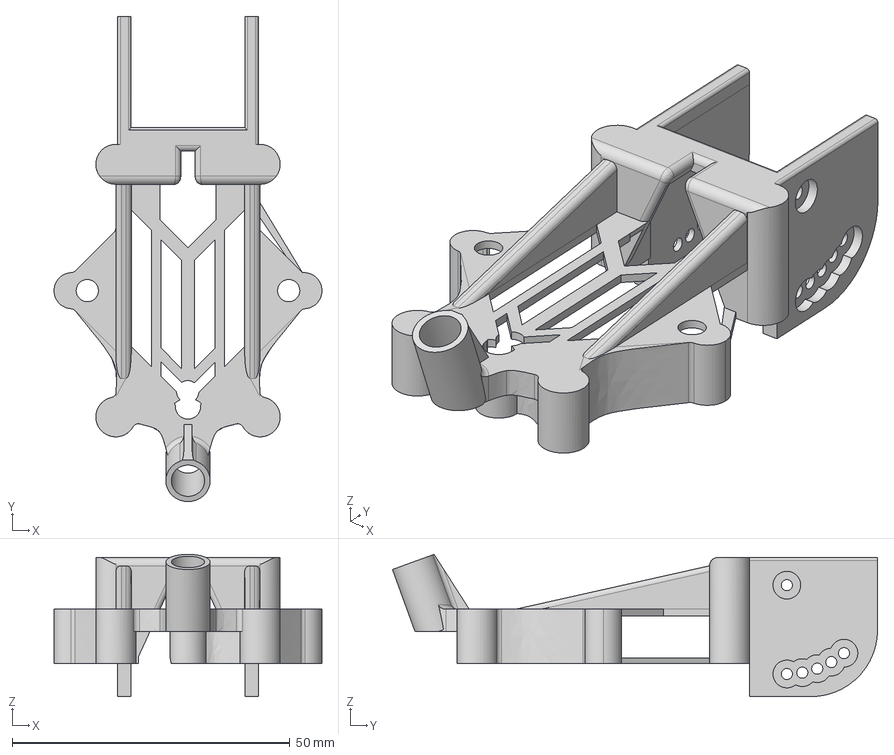
[picture p16: CAD file, 2026-10-13]
model/stazene/pavo-20-pro-canopy-fenouil/canopy-pavo-20-provrom.stp
48.3 x 87.4 x 25.6 mm
