phageweb/dron/model/3-d500_module.stl

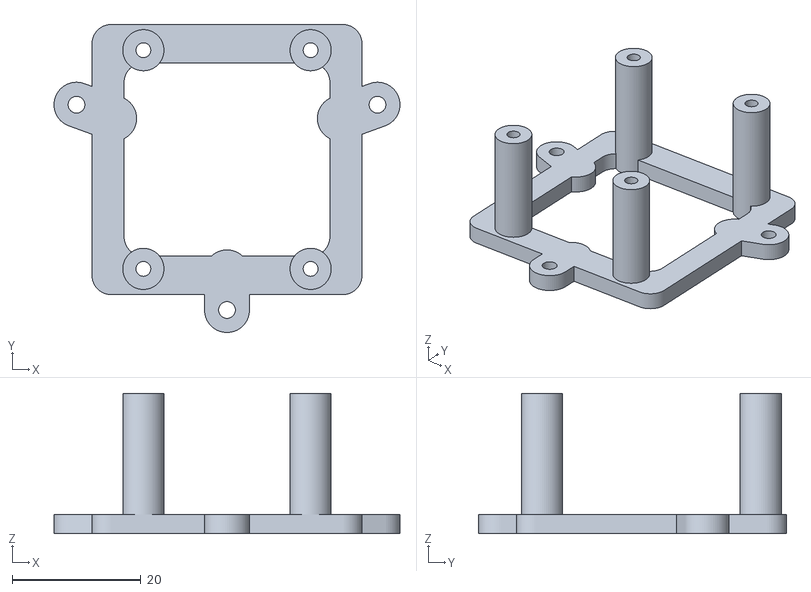
[picture p17: CAD file, 2026-10-13]
model/3-d500_module.stl
53.8 x 47.9 x 21.8
