phageweb/dron/model/archiv/pavo20_pro_walksnail_lite_plus_19mm.stl

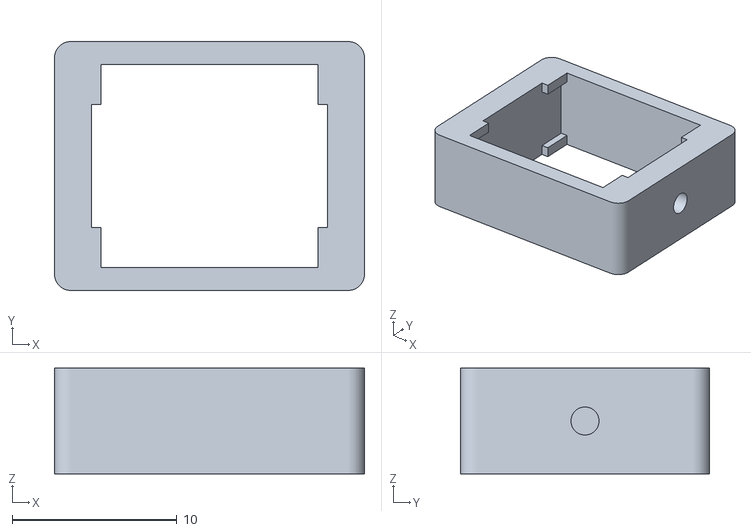
[picture p18: CAD file, 2026-10-13, an earlier design]
model/archiv/pavo20_pro_walksnail_lite_plus_19mm.stl
18.8 x 15.1 x 6.40
