phageweb/dron/model/pavo20_pro_walksnail_lite_plus.scad

// Main entry point: complete Pavo20 Pro, Lite+ and removable D500.
include <pavo20_pro_assembly.scad>
-
