phageweb/dron/model/print_mass_properties.scad

// Generated by refresh_model.py; do not edit. STL print coordinates.
base_volume_mm3 = 5908.3274;
base_print_cg = [0.0, 13.72201, 2.98528];
insert_volume_mm3 = 784.2796;
insert_print_cg = [0.0, 0.0, 3.2];
lidar_volume_mm3 = 4790.8959;
lidar_print_cg = [-0.0, -0.08474, 6.29451];
