phageweb/dron/(list of files, cad)

Other CAD files:
model/archiv/pavo20_pro_walksnail_lite_plus_20mm.stl
model/stazene/pavo-20-pro-canopy-fenouil/canopy-pavo-20-pro-vrom.3mf
model/stazene/pavo-20-pro-canopy-fenouil/canopy-pavo20pro.3mf
