phageweb/dron/dps/aio/reference/WiringDiagram.webp

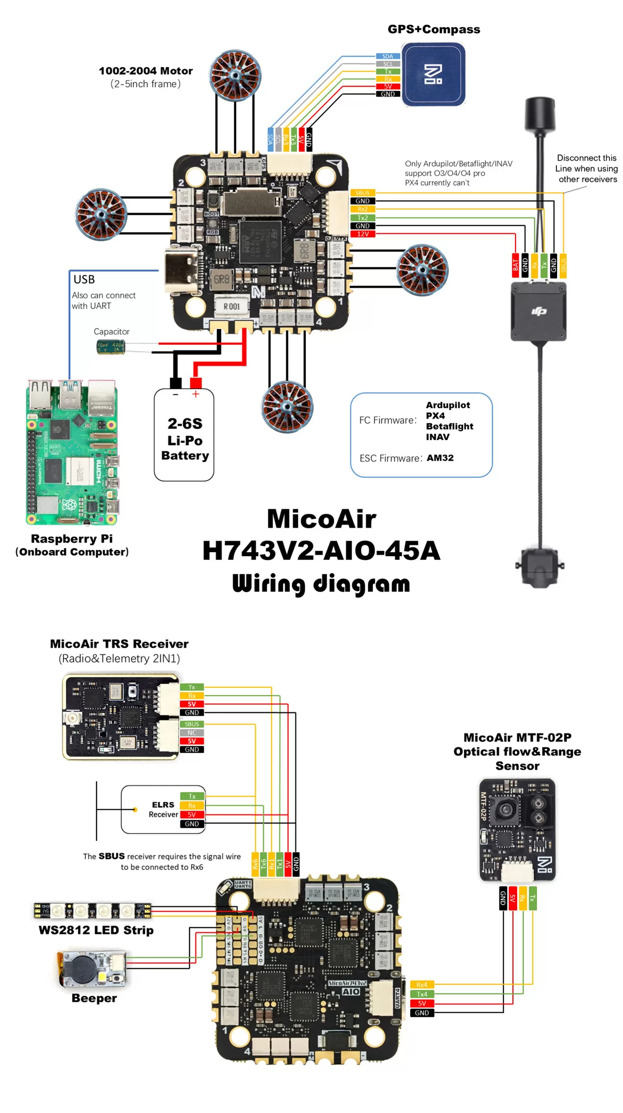
dps/aio/reference/WiringDiagram.webp
