phageweb/dron/workflow/troubleshooting.md

# Troubleshooting

This file will be updated continuously during implementation.

## Template

```text
Problem:
Symptom:
Where it appeared:
Diagnostic commands:
Root cause:
Fix:
Verification after fix:
```

## Gazebo Transport Returns Nothing

Symptom:

- `gz topic -l` lists no topics at all while Gazebo is demonstrably running
- `gz topic -e -t <topic>` blocks and never delivers a message
- the ROS bridge works, so the simulation looks healthy from ROS

Root cause:

`gazebo.launch.py` pins the simulator and the bridge to `GZ_PARTITION=openipc_cinewhoop`
so that Transport discovery stays reliable on a host with several interfaces.
Gazebo Transport only discovers peers inside the same partition, so a CLI started
from an ordinary shell sees an empty graph. This is a configuration mismatch, not
a headless or rendering limitation.

Fix:

```bash
GZ_PARTITION=openipc_cinewhoop GZ_IP=127.0.0.1 gz topic -l
GZ_PARTITION=openipc_cinewhoop GZ_IP=127.0.0.1 gz topic -e -t <topic> -n 1
```

Verification after fix:

Without the partition `gz topic -l` returned 0 topics; with it the same command
returned 25, including `/world/indoor_test/model/openipc_cinewhoop/joint_state`
and the front-lidar scan topic.

## Readings Taken From a Crashed Vehicle Are Not Evidence

Symptom:

- `joint_state` reports rotor speeds that look wrong: reversed signs, one joint
  frozen at a constant value, or all four alternating between the same small
  positive and negative number
- the numbers do not change when model parameters change

Root cause:

The vehicle had already tipped over and crashed before the sample was taken.
A free quadrotor that cannot hold attitude flips within one to two seconds of
throttle-up, so anything measured after that describes a wreck. The recurring
`+-61.8 rad/s` alternation is a sampling artefact of this state, not a speed.

Fix:

Measure thrust with the airframe on the virtual thrust stand, where attitude
cannot change and the reading means something:

```bash
nix develop -c scripts/check_thrust_stand.sh
```

Correlate any free-flight rotor reading with attitude and time. A sample taken
more than about a second after throttle-up on a free airframe is worthless
until attitude control is working.

Verification after fix:

The stand check measures a 60 m climb, so the servo path, rotor joints and lift
surfaces all work. That result held both before and after an earlier change to
the rotor damping and torque ceiling, which is how the change was shown to be
unnecessary and, because it lowered the torque ceiling, actively worse.

## Vehicle Flips Immediately After Throttle-Up

Symptom:

- ArduPilot arms, GUIDED and takeoff are accepted
- the airframe rolls or pitches past 40 degrees within about 1.5 s and crashes
- with the same model on the thrust stand, the climb is fine

Diagnostics so far:

Two prerequisites were found and fixed while investigating. ArduPilot's output
range defaulted to 1000-2000 while the SDF maps 1100-1900, so a disarmed
vehicle drove its rotors backwards, turned slowly on the floor and failed the
compass check; `MOT_PWM_MIN`/`MOT_PWM_MAX` now match the model. `MOT_THST_EXPO`
is 1.0 because the simulated thrust curve is exactly quadratic.

The actuation and aerodynamics are not the cause. On the stand the same model
climbs 60 m under real ArduPilot control with symmetric throttle. The channel
map, rotation directions, `modelXYZToAirplaneXForwardZDown` and `gazeboXYZToNED`
are all identical to the Iris reference that flies.

The rotor model itself is the obstacle, and parameter nudging does not resolve
it. Three constraints conflict:

- The physical inertia of a 3 in propeller (izz 8.0e-07) makes the plugin's
  explicit velocity loop change rotor speed by 168 % of its target in a single
  step at the configured torque ceiling. The disarmed airframe tumbles at over
  1000 deg/s from that alone.
- Raising the rotor inertia stabilises the loop, but the rotor then stores real
  angular momentum: spin-up reaction reaches 0.36 N m per rotor, and a ten per
  cent asymmetry gives the 0.00038 kg m^2 airframe 5500 deg/s^2 in yaw.
- Lowering the joint damping twentyfold to cut yaw authority does not help,
  because the reaction above comes from inertia rather than damping.

A coherent redesign of the rotor drive is needed rather than further tuning.
The most promising direction is kinematic velocity control (`useForce` 0), which
removes the PID and its reaction torque entirely, paired with explicit yaw
torque so the airframe still has authority about the vertical axis.

What also remains is attitude tuning. `ardupilot_params.parm` sets only `FRAME_CLASS`
and `FRAME_TYPE`, so every gain comes from `copter.parm`, which targets a
vehicle of one to two kilograms. This airframe is 0.240 kg with a roll inertia
of 0.00022 kg m^2. Open item; see the backlog.

> **Two things in that paragraph stopped being true, and both are written up
> below.** Nothing is inherited from `copter.parm` at all - SITL is launched
> with `--defaults` naming only our own files, which the audit in
> [What the Parameter File Only Claims to Inherit](#what-the-parameter-file-only-claims-to-inherit)
> works through parameter by parameter. And the airframe is no longer 0.240 kg:
> with the LD06 on its mast the CineLog is **0.306 kg** and the Pavo20 variant
> **0.229 kg**. The gains were tuned by a measured sweep rather than left at
> defaults; the parameter files carry the numbers and the reasoning.

## AP_DDS Topics Never Appear in ros2

Symptom:

- the Agent log shows AP_DDS connecting and creating publishers and repliers
- `ros2 topic list` shows only `/parameter_events` and `/rosout`
- the check fails with "AP_DDS services did not appear"

Root cause:

`micro_ros_agent` has no domain option and does not follow `ROS_DOMAIN_ID`, so
it always joins the default domain. Setting `ROS_DOMAIN_ID` for a DDS test only
moves `ros2` away from the Agent and hides every `/ap/` topic.

Fix:

Do not set `ROS_DOMAIN_ID` in a test that talks to the Agent. Isolate concurrent
runs with the Agent's UDP port instead (`DDS_UDP_PORT`, see `dds_smoke.parm`).

Verification after fix:

`scripts/check_iris_dds_control.sh` had been given a ROS domain for isolation
and could no longer see the services. With the domain removed it passes again
and measures 584.19 m to 586.18 m.

## DDS Control Accepts Everything and the Cinewhoop Stays Put

Symptom:

- `/ap/prearm_check`, `/ap/mode_switch`, `/ap/arm_motors` and
  `/ap/experimental/takeoff` all return success
- `/ap/status` confirms `armed: true`
- commanded rotor speed reaches only the arm idle (260 rad/s) and falls back to
  zero, and Gazebo ground truth shows the airframe never leaves z = 0.03 m
- the same airframe takes off over MAVLink, and the Iris takes off over these
  same DDS services

Cause:

A leftover `simple_indoor_autonomy` node from an earlier run was still
publishing `/ap/cmd_vel`. `ros2 run` is a wrapper whose child does not die with
it, so killing the recorded PID left the node alive; it then commanded GUIDED
velocity into the *next* run's vehicle.

That is enough to prevent takeoff entirely. A velocity command replaces the
GUIDED TakeOff submode, and the position-control submodes call
`make_safe_ground_handling()` while `land_complete` is still true, so throttle
output stays at exactly zero. Every service still answers success, which is why
this reads as a vehicle or DDS fault rather than a stray process.

Diagnostics that settle it:

```bash
# Is anything already driving the vehicle?
ros2 node list | grep simple_indoor_autonomy
ros2 topic echo /ap/cmd_vel --once
```

The decisive evidence is in SITL's own dataflash log, which records the guided
target every cycle:

```bash
# GUIP Type=4 with a non-zero vX/vY is a velocity target, not a takeoff.
# CTUN ThO=0.000 with DAlt pinned at the ground altitude confirms the
# position controller was never given a climb.
python3 - external/ardupilot/ArduCopter/logs/<latest>.BIN <<'EOF'
from pymavlink import mavutil
m = mavutil.mavlink_connection(__import__("sys").argv[1])
while (msg := m.recv_match()) is not None:
    if msg.get_type() in ("GUIP", "CTUN", "MSG"):
        print(msg)
EOF
```

Fix:

- `scripts/check_forward_flight.sh` now `pkill`s the node and the ROS/Gazebo
  bridge by their full install paths, and refuses to start while a
  `/simple_indoor_autonomy` node is still in the ROS graph.
- `scripts/check_ros_graph.sh` had the same leak with `trajectory_publisher`.
  It was harmless in itself but ran in baseline CI, leaving one orphan per run.

Do not trust a service reply as proof that a command took effect. The demo node
now re-requests takeoff when the altitude does not actually rise, which is also
what finally made the sequence survive a slow EKF start.

## A Level Lidar Sees Nothing Above a Low Obstacle

Symptom:

- the autonomy demo takes off and then logs `Holding: no valid range in the scan`
- the bridged `LaserScan` is all `inf` in flight, but reads correctly on the ground

Cause:

`front_obstacle` stood exactly 1.0 m tall while the demo cruises at 1.0 m, so
the level front lidar passed over its top, and the world has no walls inside the
8 m maximum range. The node was right to hold: it genuinely could not see.

Fix:

Both obstacles in `indoor_test.sdf` now stand taller than the cruise altitude.
When adding geometry to that world, check it against the flight altitude rather
than only against the vehicle's resting height.

## A Healthy Sensor Topic That RViz Refuses to Draw

Symptom:

- `ros2 topic echo` on a bridged sensor shows real data at the expected rate
- the matching RViz display stays empty, with no error on the topic itself

Cause:

A Gazebo sensor stamps its messages with its own scoped name unless the model
sets `gz_frame_id`, so the front lidar published
`openipc_cinewhoop/front_lidar_link/front_lidar`. That frame is not in the tree
`robot_state_publisher` serves from the URDF, so every TF-using consumer has
nothing to transform into the fixed frame and quietly shows nothing.

The same mismatch is a simulation-only behaviour: a real driver publishes URDF
link names, so a node tuned against the simulation would meet a different frame
on hardware.

Fix:

Every sensor in `model.sdf` sets `gz_frame_id` to its URDF link, and
`scripts/check_sensor_interface.sh` fails if a bridged frame cannot be
transformed into `base_link`. Check the frame before the display settings:

```bash
ros2 topic echo --once --field header /openipc_cinewhoop/scan/front
ros2 run tf2_tools view_frames
```

## A Rotated Sensor Frame Points the Measurement the Wrong Way

Symptom:

- a downward rangefinder's reading appears in front of the drone in RViz
- the IMU reads -9.81 m/s^2 on z at rest instead of +9.81

Cause:

Two different conventions meet in this model. ArduPilotPlugin reads its IMU in
aircraft convention, x forward, y right, z down, so the sensor carries a 180
degree roll; ROS and AP_DDS use REP 103, x forward, y left, z up. Bridging the
aircraft-convention sensor gave ROS an inverted y and z that only hardware would
have revealed. Separately, both downward sensors measure along +X of their own
frame, so a frame left level with `base_link` describes a beam pointing forward.

Fix:

The model carries a second, unrotated `imu_ros` sensor for the bridge, and
`rangefinder_link` and `optical_flow_link` are pitched 90 degrees in the URDF to
match the SDF. Gravity at rest is the cheap test, and the interface check makes
it:

```bash
ros2 topic echo --once --field linear_acceleration /openipc_cinewhoop/imu
```

## A Parked Front Lidar Measures the Floor, Not the Room

Symptom:

- with the vehicle parked at the origin and no ArduPilot running, the front lidar
  reports 1.41 m straight ahead
- the world's only thing ahead is the front obstacle, whose face is 4.37 m from
  the lidar
- the same 1.41 m was reported before that obstacle was moved from x = 1.8 to
  x = 4.5, when its face was 1.67 m away, so the reading does not track the wall

Cause:

The lidar is grazing the floor. Parked, `front_lidar_link` sits 37 mm above the
floor surface, and the rendered fan is not perfectly flat: its lowest rays fall
by a small angle. For a sensor at height h whose rays depress by an angle phi,
the floor is struck at range `r = (h / phi) / cos(theta)`, which is a plane of
constant depth - exactly the shape measured. From h = 0.037 m and a depth of
1.412 m, phi comes out at 0.026 rad, about 1.5 degrees.

Evidence, in the order that settled it:

- the returns lie on a plane of constant depth, not at a constant range, so it
  is a surface perpendicular to the view axis rather than a ring
- the vehicle really is at the origin and level, and `gz model` confirms the
  loaded scene has the wall at x = 4.5 with the floor at the origin
- the reading is identical at 5 s and at 25 s, so it is not a half-loaded scene
- an obstacle moved to x = 1.0 is measured exactly right, at 0.867 m, which is
  1.0 less the 0.06 half-thickness and the lidar's own 0.073 m offset. Near
  geometry is fine; the floor return simply arrives before anything further
- spawning the vehicle higher moved the plane from 1.412 m to 1.267 m rather
  than removing it, which is `h / phi` changing, not a fixed clip distance

Consequences:

- **In flight nothing is affected.** At the demo's 1 m altitude the floor would
  be struck at about 38 m, far past the sensor's 8 m maximum, so no return comes
  back at all. `check_forward_flight.sh` measures a stop at x = 3.37 m with
  0.99 m of rotor clearance, summing to the 4.44 m where the world puts the wall.
- `scripts/check_front_lidar.sh` runs parked, so the range it sees is the floor.
  It proves the bridge delivers a finite range to the demo node, which is what it
  was written for, and it is not evidence about the room.
- The margin is thinner than it looks. The demo stops below 1.40 m and the parked
  floor return sits at 1.412 m. Raising the stop distance, or hovering much below
  0.3 m, would let the floor read as an obstacle.

Resolved, and by something else entirely. Choosing the LD06 put the sensor on a
mast above the propeller plane, 50 mm up instead of 2 mm, and `h / phi` grew with
it until the floor return fell past the sensor's range. Parked, the front lidar
now reports 4.39 m, which is the wall face at 4.44 m less the sensor's own 46 mm
offset. The diagnosis is left here because it predicts the same thing on
hardware: LDROBOT give the LD06 a pitching angle of 0 to 2 degrees, so a real
unit sitting 35 mm off the ground will see the floor somewhere between 1 and 4 m,
and only altitude takes it out of range.

## In Flight the Floor Becomes a Wall When the Drone Leans

The parked case above has a sibling that has not been dealt with, and it is the
more dangerous one. The LD06 is bolted to the airframe, so its scan plane leans
with the vehicle. Nose down by an angle, and the forward beams point at the
floor; the floor then returns a range like any wall would.

Where that lands, for a scan plane pitched by theta at height h, is the slant
range `h / sin(theta)` - the sensor reports distance along its own beam, which
is what the demo's threshold is compared against:

| Lean | at 1.0 m | at 0.5 m | at 0.3 m |
| ---: | ---: | ---: | ---: |
| 5° | 11.5 m | 5.7 m | 3.4 m |
| 10° | 5.8 m | 2.9 m | 1.7 m |
| 20° | 2.9 m | **1.5 m** | 0.9 m |
| 30° | 2.0 m | 1.0 m | 0.6 m |
| 35° | 1.7 m | 0.9 m | 0.5 m |

The demo stops below 1.40 m, so the bold cell is where the vehicle stops for the
ground. At its 1 m cruise it takes about 45 degrees of lean to get there, which
is far more than 0.5 m/s asks for. **Halve the altitude and 22 degrees is
enough**, and 22 degrees is not an aggressive manoeuvre.

The simulation reproduces it faithfully, because the Gazebo sensor is rigidly
attached in exactly the same way, which made it testable before it was ever
flown. `leaning_test.sdf` holds the model static at 30 degrees nose-down with the
lidar 0.588 m above the floor, and the simulated LD06 reports the floor straight
ahead at 1.175 m, rising to 1.352 m at the edge of the 60 degree forward sector -
close to the 1.18 m the table's `h / sin(theta)` predicts, and inside the demo's
1.40 m stop threshold. `scripts/check_leaning_scan.sh` asserts both that and the
rejection.

What the options were, worst to best; the last one is what was built:

- **A gimbal.** Correct, and out of the question at 42 g of lidar on a 306 g
  aircraft.
- **Cap the lean angle.** Cheap, and it only moves the problem: it caps speed
  too, and says nothing about flying low.
- **Tilt the mount up a few degrees.** Buys margin nose-down and spends it
  nose-up, where the ceiling then arrives instead.
- **Transform the scan and filter by height.** Every return becomes a point in a
  gravity-aligned frame using the vehicle's attitude, and anything below a
  height threshold is dropped as ground. This is the real answer, it handles
  roll as well as pitch, and the pieces already existed: the TF tree is correct
  and verified, and `/ap/pose/filtered` carries the orientation that
  `trajectory_publisher` already subscribes to. `scan_helpers.is_ground_return`
  does it, both demo nodes apply it, and the height comes from the downward
  rangefinder.

Two things about that answer are worth keeping in mind rather than forgetting:

- **An unknown height rejects nothing.** Without a rangefinder reading there is
  no way to tell a floor return from a wall, so the filter switches itself off
  rather than guessing. A dead MTF-02P therefore brings the leaning problem
  straight back, and the demo will stop for the ground again.
- **Low and leaning, a wall and the floor are the same measurement.** At 0.5 m
  and 20 degrees, a return 1 m out is aimed at a point 16 cm above the floor,
  which is both the floor and the base of a wall. No filter fixes that; the
  answer is to not fly like that.

Note that ArduPilot compensates proximity data with attitude in its own
avoidance layer, so if the LD06 is also wired to the flight controller, that path
and the ROS path handle this separately and can disagree.

## SITL Says "No JSON Sensor Message Received" Forever

Symptom:

- Gazebo starts, loads the model and reports no errors
- SITL starts and prints `No JSON sensor message received, resending servos`
  without stopping
- the Gazebo log fills with `ArduPilotPlugin: Duplicate input frame`
- no `/ap/` topic ever appears, so it looks like the Agent or the network

Cause:

The world is not called `indoor_test`.

A Gazebo sensor may declare its own `<topic>`, and the obvious thing to write
there is the name Gazebo would have generated - which contains the world's name.
The model's five sensors all did. Under any other world the sensors keep
publishing under the written name, while `ArduPilotPlugin` looks up the IMU and
subscribes to the topic the real world scopes it to. It finds nothing, so it
never sends SITL a state frame; SITL resends the same servo frame, the plugin
discards it as a duplicate, and the two sit there.

Nothing about the message points at a name. It was found by writing a second
world and then bisecting: the identical world file passed with
`<world name="indoor_test">` and deadlocked with `<world name="ramp_test">`.

Fix:

Declare no `<topic>` on any sensor and let Gazebo scope it. The generated names
are byte-identical to what was written, with the real world substituted, so
nothing changed for `indoor_test`. `config/gz_bridge.yaml` became a template
with `@world@` in it, rendered by `gazebo.launch.py` from the `<world name>` in
the world file actually being launched - read from the file rather than guessed
from its name, so a file and world that disagree fail loudly instead of bridging
nothing.

`scripts/check_model_consistency.py` now fails if any sensor topic in the SDF
names a world, which is the cheap guard against writing it back.

A related trap, in case a static model looks like a way to hold an attitude:
`ArduPilotPlugin` cannot produce state for a static model either, and the
symptom is exactly the same. `leaning_test.sdf` is static and deliberately runs
without SITL; `ramp_test.sdf` parks a live vehicle on a slope instead.

## A Velocity Command Is Not a Brake

Symptom:

- the autonomy demo stops for the wall exactly as designed, yet ends up far
  closer to it than the configured stop distance
- measured: it held 0.80 m from the obstacle and came to rest 0.16 m from it

Cause:

ArduPilot shapes horizontal motion on purpose. `PSC_NE_VEL_P` defaults to 2.0,
the acceleration limit `WPNAV_ACCEL` to 2.5 m/s^2 and the jerk limit to
5 m/s^3, which together coast about 0.6 m when a 0.5 m/s command drops to zero.
Measured from Gazebo ground truth at 59 Hz: speed decayed 0.50 to 0.15 m/s over
1.1 s, an effective 0.3 m/s^2, nowhere near the 2.5 m/s^2 limit.

This is not a defect. Smooth stops are the point of a camera platform, so the
fix is to decide earlier rather than to brake harder. `safe_forward_speed` now
takes a braking distance and stops at clearance plus braking distance, which
took the measured margin from 0.16 m to 0.82 m.

Worth knowing when measuring this: the vehicle also drifts about 0.35 m forward
during the guided takeoff itself, before any velocity command is published, so a
trajectory read after takeoff does not start at the origin.

## AP_DDS Ignores Gazebo's Clock and Nobody Says Why

Symptom: `/clock` and every bridged sensor topic count seconds from when the
simulator started, while `/ap/pose/filtered` carries ArduPilot's UTC. Measured
in the same instant: `/clock` 22.3 s, the front scan 22.3 s, the pose
1789156172 - a 56 year gap. `AP_DDS_CLOCK_SUB_ENABLED` defaults on for SITL, so
the subscription looks like it should be happening.

**The `"/clock"` versus `"clock"` asymmetry in `AP_DDS_Topic_Table.h` is not the
bug.** It is deliberate. `AP_DDS_Client.cpp:1545` special-cases a leading slash:

```cpp
if (topics[i].topic_name[0] == '/') {
    snprintf(topic_name_buf, AP_DDS_MAX_NAME_LEN, "rt%s", topics[i].topic_name);
} else {
    dds_format_name(topic_name_buf, dds_pubsub_prefix, sysid, topics[i].topic_name, use_sysid_ns);
}
```

`dds_format_name` builds `rt/ap/<name>`, so a bare name lands in the vehicle's
own namespace. The publisher `"clock"` becomes `/ap/clock`; the subscriber
`"/clock"` skips the namespace and listens on the global `/clock`, which is
exactly where Gazebo publishes. Both names are right.

The actual gate is a runtime skip in `AP_DDS_Client.cpp:1601`:

```cpp
SITL::SIM *sitl = AP::sitl();
if (strcmp(topics[i].topic_name, "/clock") == 0 && !sitl->use_dds_sim_time) {
    GCS_SEND_TEXT(MAV_SEVERITY_INFO, "%s Skipping subscription to /clock because use_sim_time is false", msg_prefix);
    continue;
}
```

The subscription is never created. `use_dds_sim_time` is **not an AP parameter**
- it is a plain member defaulting to false (`SITL.h:287`), written only from the
SITL command line (`SITL_cmdline.cpp:399`, `604`). So it cannot be set in
`ardupilot_params.parm` or `dds_params`; it has to go on the launch line:

```
--use_sim_time true
```

Confirmed against the binary this project actually runs:
`build/sitl/bin/arducopter --help` lists
`--use_sim_time <true|false>  use ROS2 simulation clock for DDS topics. Defaults to false`.

Downstream the mechanism is complete, so the one flag is the whole fix.
`AP_DDS_Client::update_topic(builtin_interfaces_msg_Time&)` is the single stamp
source for every published message, and it short-circuits to the external clock
the moment one arrives (`AP_DDS_Client.cpp:275-282`).

How to tell which state you are in: the skip prints a statustext. If the SITL log
carries "Skipping subscription to /clock because use_sim_time is false", the
vehicle is stamping UTC and no amount of ROS-side `use_sim_time:=true` changes
it - that parameter governs the ROS node's own clock, not the autopilot's.

**Not yet applied to this project's scripts.** Every script under `scripts/`
launches SITL without the flag; `use_sim_time` appears there only as a ROS node
parameter. Adding it flips every AP_DDS stamp from UTC to simulator seconds
across the whole baseline, which wants one full CI run to confirm, not a blind
edit.

## What the Parameter File Only Claims to Inherit

The header of `ardupilot_params.parm` says everything not set there comes from
`copter.parm`. It does not: SITL is launched with `--defaults` naming only our
two files, so unset parameters sit at **firmware defaults**, not at autotest's.
Audited 2026-09-13 against `copter.parm` in the checkout.

Our two files set 22 parameters. `copter.parm` sets 72. Of those, 65 are ones we
do not set, and they sort into one real trap and a lot of noise:

| Group | Count | What it means here |
| --- | ---: | --- |
| `INS_ACC*` | 18 | **Covered, but not by the parm file.** See below |
| `RC*_MIN/MAX/TRIM` | 25 | No RC in these runs; the vehicle flies GUIDED over DDS |
| `COMPASS_OFS*` | 9 | Cosmetic in SITL |
| `FLTMODE1-6` | 6 | RC switch positions; mode comes from DDS, not a switch |
| `MOT_BAT_VOLT_MIN/MAX` | 2 | **Do not "fix" this one.** See below |
| `ARSPD_PIN/BUS` | 2 | Airspeed on a copter |
| `FS_THR_ENABLE` | 1 | Firmware default is already 1 (`ALWAYS_RTL`) - identical, no gap |
| `FENCE_RADIUS` | 1 | `FENCE_ENABLE` defaults to 0, so the radius is inert either way |
| `SIM_BARO_RND` | 1 | That literal name has no definition anywhere in this checkout |

Five more we both set, and every difference is deliberate airframe tuning:
`FRAME_TYPE` 1 not 0, `MOT_THST_EXPO` 1.0 not 0.65, `MOT_THST_HOVER` 0.46 not
0.39, `ATC_RAT_YAW_P` 0.023 not 0.3, `ATC_RAT_YAW_I` 0.0023 not 0.02.

**`MOT_BAT_VOLT_MIN/MAX` is the one to leave alone.** The firmware default is
`0.0` for both, which means voltage-based thrust limiting is *disabled*.
`copter.parm` sets 9.6 and 12.8 - three-cell numbers. This airframe runs four
cells at `SIM_BATT_VOLTAGE 16.4`. So not inheriting is not an oversight here, it
is the correct outcome: making `copter.parm` load, as the header implies it
does, would apply a 3S compensation curve to a 4S pack and quietly change thrust
across every flight test. If the header is ever made true, these two have to be
pinned at the same time.

**Why arming works without the INS group.** `copter.parm` carries a comment that
small accel offsets are needed "so INS is recognised as being calibrated", and
that is real: `AP_InertialSensor::accel_calibrated_ok_all()` rejects an exactly
zero offset - "exactly 0.0 offset is extremely unlikely" - and the firmware
default is zero. We inherit nothing and set none of them, yet the vehicle arms.
The reason is the model, not the parameters: `libraries/SITL/SIM_JSON.cpp` has a
`sim_defaults[]` table that sets `INS_ACCOFFS_*` to 0.001, `INS_ACCSCAL_*` to
1.001, the matching `INS_ACC2*` pair, plus `INS_GYR_CAL 0` and `BRD_OPTIONS 0`.
We launch with `--model JSON`, so that table applies. **Switching the SITL model
away from JSON would break arming**, and the error would name the INS, not the
model.

### Which topics go silent rather than wrong

The battery taught this once: `/ap/battery` was absent for a year because
`BATT_MONITOR` was unset and AP_DDS skips an instance the battery library does
not call present. Asked of every other publisher, only one more behaves that way.

- `/ap/battery` - `update_topic()` fills the message, then
  `if (battery_state_topic.present) write_battery_state_topic();`. No monitor,
  no topic, no complaint. `BATT_MONITOR 4` is set now, so this one is closed.
- `/ap/navsat` - `if (update_topic(nav_sat_fix_topic, gps_instance))` guards the
  write, and `update_topic` returns false when `gps.is_healthy(instance)` is
  false. Indoors with no GPS that is permanent and expected, but anything that
  ever waits on `/ap/navsat` waits forever.

Every other AP_DDS publisher writes unconditionally on its timer, so it is
either there or the whole DDS session is down - which is loud. Those two are the
only ones that can be quietly missing.

## A Second Run Refuses to Start Because of a Node That Has Already Died

Symptom:

- `check_room_coverage.sh` runs green, and a second run started 16 s later
  refuses with "A simple_indoor_autonomy node is already running; it would
  command /ap/cmd_vel into this run's vehicle and prevent takeoff."
- `ps` shows no such process, and none of the run's other processes either

Cause:

The guard asks `ros2 node list`, which asks the `ros2` CLI daemon rather than
the network. That daemon caches the graph and keeps serving names for a while
after the node behind them is gone, so a back-to-back run reads the corpse of
the one before it. The guard itself is right and worth keeping: two autonomy
nodes on one `/ap/cmd_vel` would fight over the vehicle.

Fix: between sequential runs, `ros2 daemon stop` and wait. Measured: with a
stop and 20 s, three runs of the coverage check went through in a row; without
it, the second run died in 16 s.

Worth knowing before the swarm work: three agents mean three sets of nodes
appearing and disappearing in one graph, and the check for "is my agent
already flying" cannot be a question to a cache. See
[the swarm task](../spec/roj/README.md).

## A Velocity Command Cancels the Takeoff, and Nothing Says So

Symptom:

- a script arms, commands a guided takeoff, and every call reports success
- the vehicle stays on the ground at zero throttle, and a whole measurement
  sortie produces a table of zeros rather than an error

Cause:

In GUIDED, a velocity command replaces the takeoff submode. A node that starts
publishing `/ap/cmd_vel` the moment it is constructed - even zeros, even a
timer that has nothing to say yet - therefore cancels the climb it was about to
measure. `check_forward_flight.sh` already guards against the other shape of
this, a leftover node from an earlier run; this is the same mechanism arriving
from the script's own process.

Fix: publish nothing until the climb is confirmed. `measure_dynamic_limits.py`
keeps its publisher silent until `start()`, and watches Gazebo ground truth for
80 per cent of the target altitude before calling it, failing loudly if the
vehicle never climbed.

Worth knowing: the failure is silent in the direction that matters. Zeros look
like data. The first run of that script measured a braking distance of 0.00 m,
which in `d_safe` would have meant three machines flying inside each other.

## The Airframe Switch Did Not Switch the Airframe

Symptom:

- `OPENIPC_AIRFRAME=pavo20 scripts/check_*.sh` runs green and reports Pavo20
  numbers
- the numbers keep coming out suspiciously like the CineLog's - "the LAVA
  model's numbers to a tenth", as one log entry put it, and rate gains that
  "transfer unchanged"

Cause:

`model://` is resolved by sdformat through **SDF_PATH**, not through
GZ_SIM_RESOURCE_PATH. The dev shell in `flake.nix` exports both, and its
SDF_PATH points at `ros_ws/src/openipc_cinewhoop_gazebo/models` - the CineLog.
`gazebo.launch.py` knows this and sets SDF_PATH to the selected airframe's
directory; the fourteen shell check scripts set only GZ_SIM_RESOURCE_PATH. So
every `check_*.sh` run with `OPENIPC_AIRFRAME=pavo20` loaded the CineLog model
and flew it under the Pavo20's parameter file.

Measured, with exactly the environment those scripts build for pavo20:

```text
SDF_PATH as inherited: .../dron/models:.../openipc_cinewhoop_gazebo/models:
model actually loaded:  .../openipc_cinewhoop_gazebo/models/openipc_cinewhoop/model.sdf
```

Fix: every script that exports GZ_SIM_RESOURCE_PATH now exports SDF_PATH with
the same airframe directory in front. With that line, the same command loads
`models_pavo20/openipc_cinewhoop/model.sdf`.

What it invalidates: every pavo20 measurement taken through a shell check
before 2026-09-20 - the M0 coverage baseline, the M1 dynamic limits and so
`d_safe`, the rate sweep, guided takeoff and forward flight. Those are CineLog
numbers with a Pavo20 label. They have to be taken again.

And one thing it reveals: **the Pavo20 model has never actually flown.** Loaded
properly, with SDF_PATH pointing at it, it ramps throttle to 46 per cent and
does not leave the ground. That is now the first thing to diagnose, and it is
a real defect rather than a measurement artefact.

## A Renamed Model Does Not Turn Its Rotors

Symptom:

- a Gazebo model that flies is copied, renamed, and stops flying
- it arms, accepts a guided takeoff, and the autopilot ramps throttle to 99 per
  cent while ground truth altitude never changes and climb rate stays 0.00 m/s
- all four rotor command topics carry healthy values, the motor topic has one
  publisher and four subscribers, and the model's rotor links do not rotate:
  `rotor_0`'s orientation is identical across 0.6 s

Narrowed to, by four variants of one model file:

| variant | flies |
| --- | --- |
| unchanged, at an offset pose, in a generated world | yes |
| `<model name>` + model.config + world uri renamed to `openipc_cinewhoop_v1` | no |
| the same renamed to `alpha` | no, so it is not the chosen name |
| model directory and uri renamed, model file untouched, instance renamed with `<include><name>v1</name>` | no, 3 runs |
| **everything unchanged, only `<include><name>v1</name>` added** | **yes, 2 runs** |
| unchanged directory, byte-identical files, included by absolute path instead of `model://` | no |
| two of those, included by absolute path, one commanded | no |

**Correction, 2026-09-20.** An earlier version of this entry concluded "it is
the entity's name and not where the name came from". That is wrong, and the
fifth row is why: renaming the instance alone, with the resource untouched,
flies. The failing variants all renamed the *resource* - the directory, the
model.config `<name>` and the `model://` uri - or replaced the uri with a
filesystem path. The claim was made from a variant that changed both at once.

Ruled out, each by measurement rather than by argument: the world edit and the
offset start pose; `<robotNamespace>` (restored, with the bridge pointed at the
matching topic); the IMU lookup and the state feed (both variants report level
attitude on the ground and find `imu_link::imu`); a duplicate model in the
world; stray processes from an earlier run; the entity's name (the fifth row);
and non-determinism (3 runs failing, 2 flying, no crossover).

Also ruled out, 2026-09-20, between a flying setup and a failing one whose
model directories are byte-identical (`diff -r` clean):

- the model is fully simulated either way - teleported 1.5 m up, both fall
  back to the floor in the same 1.5 s, so nothing is pinning it;
- the entity tree is identical, down to the entity ids, so the model is not
  being nested inside another when it is included differently;
- four motor plugins load in both and log the same subscription topic at
  verbosity 4, and neither log contains a single error line;
- the motor topic has one publisher and four subscribers in both.

Two methods that measure nothing here, so that nobody repeats them:

- `joint_state` publishes no velocities at all, flying or not.
- Driving the motors with a standing Actuators command and no ArduPilot plugin
  lifts **neither** model, so it cannot separate the motor plugin from the
  autopilot's. The isolation is the thing that fails, not the model. Confirmed
  against a control case: gz-sim's own `multicopter_velocity_control.sdf`
  example does not lift either when its `/X3/gazebo/command/motor_speed` is
  driven the same way. A method that fails on upstream's own example says
  nothing about ours, so any future attempt needs a driving method that is
  demonstrated on that example first.

**Resolved, 2026-09-20, and it was a misdiagnosis.** There was no mechanism
because there was no phenomenon: `model://openipc_cinewhoop` was resolving
through SDF_PATH to the *CineLog* model every time, whatever
GZ_SIM_RESOURCE_PATH said. So every "flying" variant flew the CineLog, and
every "renamed" variant was the first time the Pavo20 model was actually
loaded. Renaming did not stop the rotors; it stopped the substitution. See
"The Airframe Switch Did Not Switch the Airframe" above, and note that the
Pavo20 model genuinely does not take off - which is the real defect this
chase was circling.

Why it mattered: three drones in one world need three distinct models, so it
blocked M2. **Cleared on 2026-09-20 and not by anything in this entry.** Once
the Pavo20 model's throttle multiplier was fixed, `check_agents_fly.sh`
passes: v1 climbs on command, v2 stays on the ground, then v2 climbs too, and
they hold 1.92 m apart. Nothing about naming had to change.

## Known Risks Before Implementation

### ROS 2 Packages on NixOS

Symptom:

- a package is missing in `nixpkgs`
- `nix develop` or `colcon build` fails on a missing dependency

Initial diagnostics:

```bash
nix develop
nix flake check
colcon build --symlink-install --base-paths ros_ws/src
```

First fix:

- use `nix-ros-overlay`
- if that is not enough, add a pinned source build or a local override

### Gazebo GUI / RViz2 Graphics

Symptom:

- the application crashes on startup
- OpenGL does not work
- the window is blank or visually broken

Initial diagnostics:

```bash
gz sim --versions
rviz2 --help
echo $DISPLAY
echo $WAYLAND_DISPLAY
```

First fix:

- add the required graphics libraries to the shell
- verify X11/Wayland environment variables
- on non-NixOS consider `nixGL`; on NixOS fix the system graphics configuration

### ArduPilot Gazebo plugin

Symptom:

- the Gazebo model loads, but SITL does not react
- SITL reports that it is waiting for the JSON backend
- motors do not react

Initial diagnostics:

```bash
gz topic -l
sim_vehicle.py -v ArduCopter --model JSON --console --map
echo $GZ_SIM_SYSTEM_PLUGIN_PATH
echo $GZ_SIM_RESOURCE_PATH
```

First fix:

- verify the `ardupilot_gazebo` build
- verify plugin paths
- run the Iris smoke test first

### Wrong Motor Mapping

Symptom:

- the drone flips during arm/takeoff
- hover is not possible
- roll/pitch/yaw reactions are swapped

Initial diagnostics:

- verify ordering of `motor_1` through `motor_4`
- verify rotation directions
- verify propeller torque signs
- compare the SDF plugin configuration with the ArduPilot quad X mixer

First fix:

- fix motor mapping in SDF
- retest takeoff at low altitude
