phageweb/dron/dps/aio/aio.kicad_pcb

## KiCad design dps/aio/aio.kicad_pcb (2026-10-19)

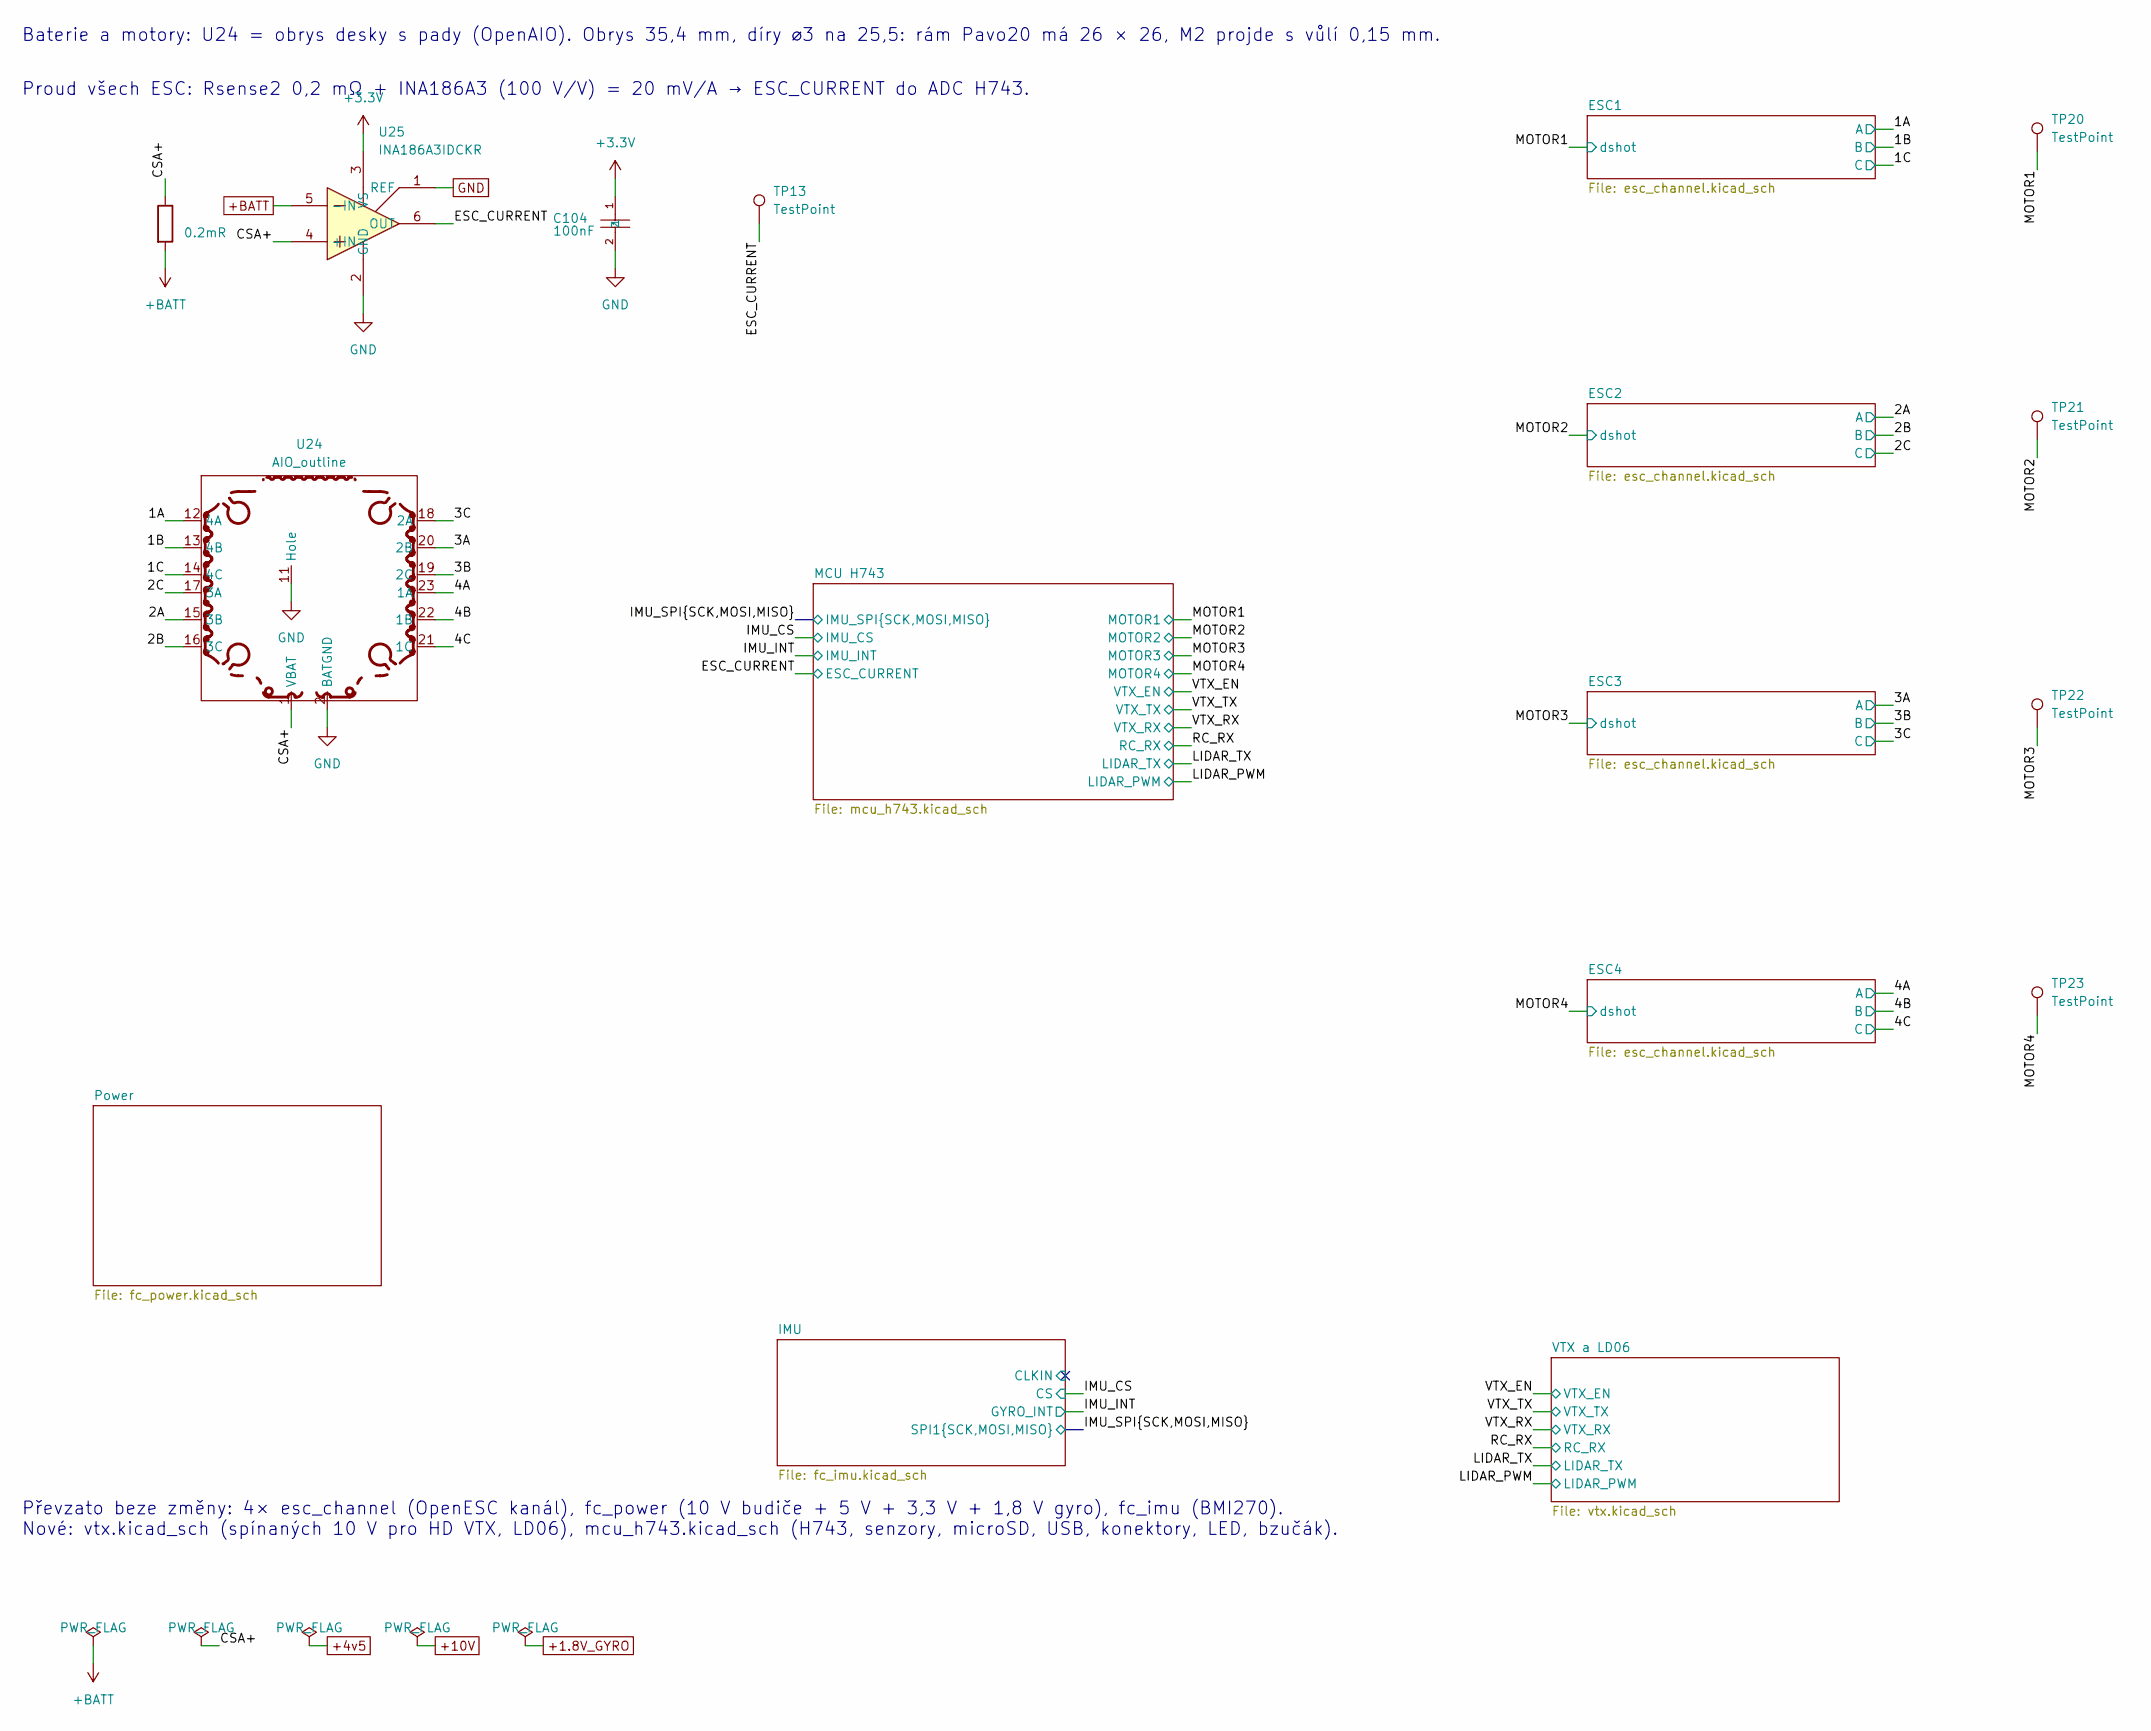
[picture p20: schematic aio.kicad_sch, AIO H743 pro Pavo20 Pro]

Parts:
C104: 100nF; C_0201_0603Metric; MPN GRM033R6YA104KE14D; LCSC C181043
Rsense2: 0.2mR; R_2512_6332Metric; MPN ASR-S-3-0.2F; LCSC C695806
TP13, TP20, TP21, TP22, TP23: TestPoint; TestPoint_Pad_D1.0mm
U24: AIO_outline
U25: INA186A3IDCKR; SOT-363_SC-70-6; MPN INA186A3IDCKR; LCSC C2058245

Connections:
+3.3V: C104.1, U25.3 (VS); also elsewhere on the board
+BATT: Rsense2.2, U25.5 (-IN); also elsewhere on the board
/1A: U24.12 (4A); also elsewhere on the board
/1B: U24.13 (4B); also elsewhere on the board
/1C: U24.14 (4C); also elsewhere on the board
/2A: U24.15 (3B); also elsewhere on the board
/2B: U24.16 (3C); also elsewhere on the board
/2C: U24.17 (3A); also elsewhere on the board
/3A: U24.20 (2B); also elsewhere on the board
/3B: U24.19 (2C); also elsewhere on the board
/3C: U24.18 (2A); also elsewhere on the board
/4A: U24.23 (1A); also elsewhere on the board
/4B: U24.22 (1B); also elsewhere on the board
/4C: U24.21 (1C); also elsewhere on the board
/CSA+: Rsense2.1, U24.1 (VBAT), U25.4 (+IN)
/ESC_CURRENT: TP13.1, U25.6 (OUT); also elsewhere on the board
GND: C104.2, U24.2 (BATGND), U24.11 (Hole), U25.1 (REF), U25.2 (GND); also elsewhere on the board

Notes on the sheet:
Baterie a motory: U24 = obrys desky s pady (OpenAIO). Obrys 35,4 mm, díry ⌀3 na 25,5: rám Pavo20 má 26 × 26, M2 projde s vůlí 0,15 mm.
Proud všech ESC: Rsense2 0,2 mΩ + INA186A3 (100 V/V) = 20 mV/A → ESC_CURRENT do ADC H743.
Převzato beze změny: 4× esc_channel (OpenESC kanál), fc_power (10 V budiče + 5 V + 3,3 V + 1,8 V gyro), fc_imu (BMI270). Nové: vtx.kicad_sch (spínaných 10 V pro HD VTX, LD06), mcu_h743.kicad_sch (H743, senzory, microSD, USB, konektory, LED, bzučák).

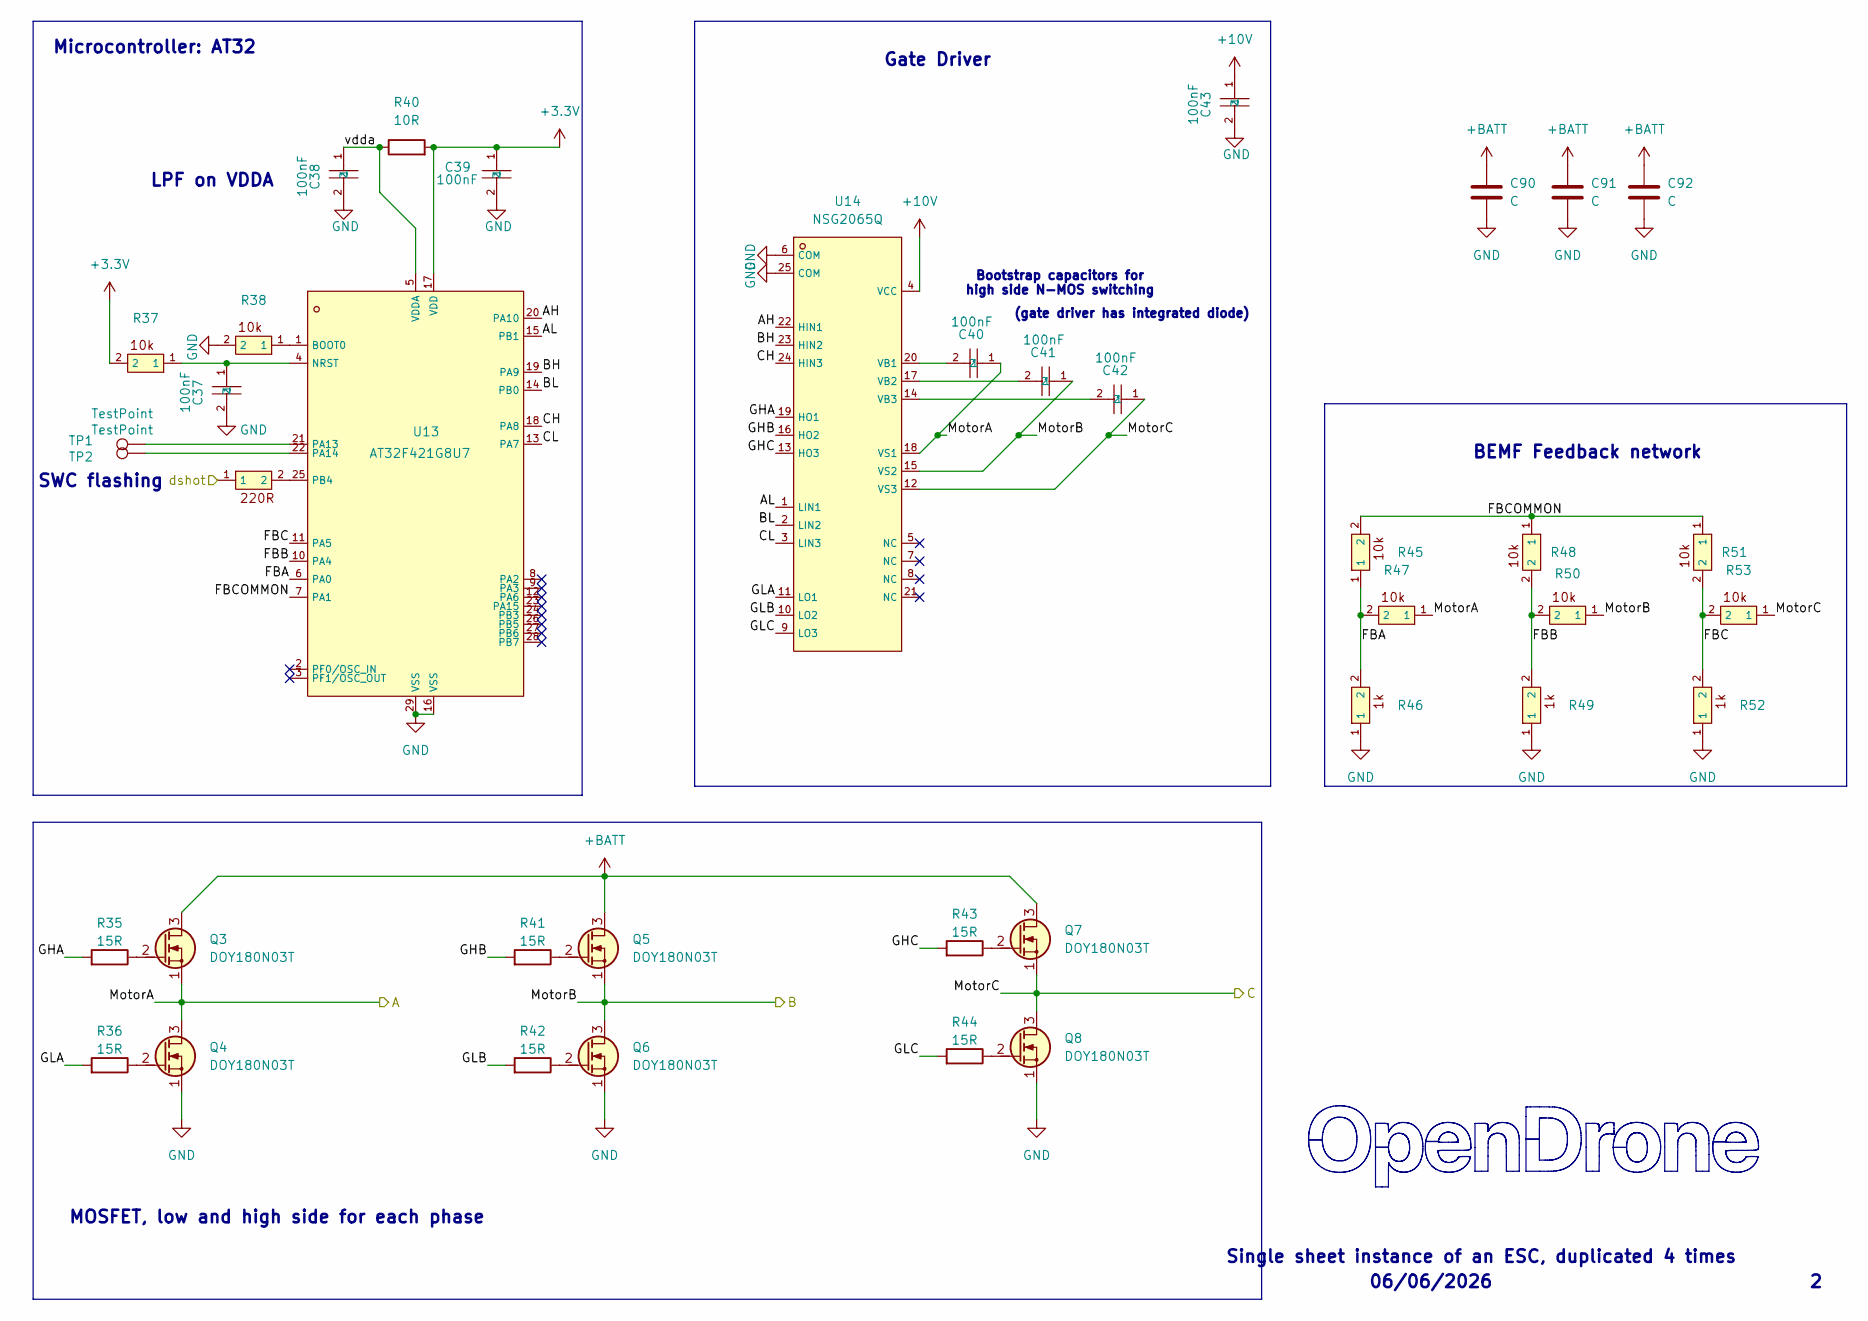
[picture p21: schematic esc_channel.kicad_sch]

Parts:
C37, C38, C39, C43: 100nF; C_0201_0603Metric; MPN GRM033R6YA104KE14D; LCSC C181043
C40, C41, C42: 100nF; C_0402_WIDE; MPN CL05B104KB54PNC; LCSC C307331
C90, C91, C92: C; C_0805_2012Metric
Q3, Q4, Q5, Q6, Q7, Q8: DOY180N03T; Diodes_PowerDI3333-8; MPN DOY180N03T; LCSC C49441966
R35, R36, R41, R42, R43, R44: 15R; R_0201_0603Metric; MPN 0201WMF150JTEE; LCSC C473542
R37, R38, R45, R47, R48, R50, R51, R53: 10k; R_0201_0603Metric; MPN RC0201FR-0710KL; LCSC C106225
R39: 220R; R_0201_0603Metric; MPN AC0201FR-07220RL; LCSC C226468
R40: 10R; R_0201_0603Metric; MPN RC0201FR-0710RL; LCSC C106226
R46, R49, R52: 1k; R_0201_0603Metric; MPN 0201WMF1001TEE; LCSC C270365
TP1, TP2: TestPoint; TestPoint_Pad_D1.0mm
U13: AT32F421G8U7; QFN-28_L4.0-W4.0-P0.40-TL-EP2.4; MPN AT32F421G8U7; LCSC C2765098
U14: NSG2065Q; QFN-24_L4.0-W4.0-P0.50-TL-EP2.8; MPN NSG2065Q; LCSC C41414478

Connections:
+3.3V: C39.1, R37.2, R40.2, U13.17 (VDD); also elsewhere on the board
+10V: C43.1, U14.4 (VCC); also elsewhere on the board
+BATT: C90.1, C91.1, C92.1, Q3.3 (D), Q5.3 (D), Q7.3 (D); also elsewhere on the board
/1A: C40.1, Q3.1 (S), Q4.3 (D), R47.1, U14.18 (VS1); also elsewhere on the board
/1B: C41.1, Q5.1 (S), Q6.3 (D), R50.1, U14.15 (VS2); also elsewhere on the board
/1C: C42.1, Q7.1 (S), Q8.3 (D), R53.1, U14.12 (VS3); also elsewhere on the board
/ESC1/AH: U13.20 (PA10), U14.22 (HIN1)
/ESC1/AL: U13.15 (PB1), U14.1 (LIN1)
/ESC1/BH: U13.19 (PA9), U14.23 (HIN2)
/ESC1/BL: U13.14 (PB0), U14.2 (LIN2)
/ESC1/CH: U13.18 (PA8), U14.24 (HIN3)
/ESC1/CL: U13.13 (PA7), U14.3 (LIN3)
/ESC1/FBA: R45.1, R46.2, R47.2, U13.6 (PA0)
/ESC1/FBB: R48.2, R49.2, R50.2, U13.10 (PA4)
/ESC1/FBC: R51.2, R52.2, R53.2, U13.11 (PA5)
/ESC1/FBCOMMON: R45.2, R48.1, R51.1, U13.7 (PA1)
/ESC1/GHA: R35.1, U14.19 (HO1)
/ESC1/GHB: R41.1, U14.16 (HO2)
/ESC1/GHC: R43.1, U14.13 (HO3)
/ESC1/GLA: R36.1, U14.11 (LO1)
/ESC1/GLB: R42.1, U14.10 (LO2)
/ESC1/GLC: R44.1, U14.9 (LO3)
/ESC1/vdda: C38.1, R40.1, U13.5 (VDDA)
/MOTOR1: R39.1; also elsewhere on the board
GND: C37.2, C38.2, C39.2, C43.2, C90.2, C91.2, C92.2, Q4.1 (S), Q6.1 (S), Q8.1 (S), R38.2, R46.1, R49.1, R52.1, U13.16 (VSS), U13.29 (VSS), U14.6 (COM), U14.25 (COM); also elsewhere on the board
unnamed: Q3.2 (G), R35.2
unnamed: Q4.2 (G), R36.2
unnamed: Q5.2 (G), R41.2
unnamed: Q6.2 (G), R42.2
unnamed: Q7.2 (G), R43.2
unnamed: Q8.2 (G), R44.2
unnamed: R38.1, U13.1 (BOOT0)
unnamed: C37.1, R37.1, U13.4 (NRST)
unnamed: TP1.1 (1_1), U13.21 (PA13)
unnamed: TP2.1 (1_1), U13.22 (PA14)
unnamed: R39.2, U13.25 (PB4)
unnamed: C40.2, U14.20 (VB1)
unnamed: C41.2, U14.17 (VB2)
unnamed: C42.2, U14.14 (VB3)

Parts of its further copies:
C44, C45, C46, C48, C50, C51, C52, C57, C58, C60, C64: 100nF; C_0201_0603Metric; MPN GRM033R6YA104KE14D; LCSC C181043
C47, C49, C53, C54, C55, C56, C59, C61, C62, C63: 100nF; C_0402_WIDE; MPN CL05B104KB54PNC; LCSC C307331
C93, C94, C95, C96, C97, C98, C99, C100, C101: C; C_0805_2012Metric
Q9, Q10, Q11, Q12, Q13, Q14, Q15, Q16, Q17, Q18, Q19, Q20, Q21, Q22, Q23, Q24, Q25, Q26: DOY180N03T; Diodes_PowerDI3333-8; MPN DOY180N03T; LCSC C49441966
R55, R60, R61, R62, R63, R73, R79, R80, R81, R82, R92, R93, R98, R99, R100, R101: 15R; R_0201_0603Metric; MPN 0201WMF150JTEE; LCSC C473542
R56, R57, R64, R66, R67, R69, R70, R72, R75, R83, R85, R86, R88, R89, R91, R94, R95, R102, R104, R105, R107, R108, R110: 10k; R_0201_0603Metric; MPN RC0201FR-0710KL; LCSC C106225
R58, R77, R96: 220R; R_0201_0603Metric; MPN AC0201FR-07220RL; LCSC C226468
R65, R68, R71, R84, R87, R90, R103, R106, R109: 1k; R_0201_0603Metric; MPN 0201WMF1001TEE; LCSC C270365
R78, R97: 10R; R_0201_0603Metric; MPN RC0201FR-0710RL; LCSC C106226
TP3, TP4, TP5, TP6, TP7, TP8: TestPoint; TestPoint_Pad_D1.0mm
U15, U17, U19: AT32F421G8U7; QFN-28_L4.0-W4.0-P0.40-TL-EP2.4; MPN AT32F421G8U7; LCSC C2765098
U16, U18, U20: NSG2065Q; QFN-24_L4.0-W4.0-P0.50-TL-EP2.8; MPN NSG2065Q; LCSC C41414478

Connections of its further copies:
+3.3V: C46.1, C53.1, C60.1, R56.2, R75.2, R78.2, R94.2, R97.2, U15.17 (VDD), U17.17 (VDD), U19.17 (VDD); also elsewhere on the board
+10V: C50.1, C57.1, C64.1, U16.4 (VCC), U18.4 (VCC), U20.4 (VCC); also elsewhere on the board
+BATT: C93.1, C94.1, C95.1, C96.1, C97.1, C98.1, C99.1, C100.1, C101.1, Q9.3 (D), Q11.3 (D), Q13.3 (D), Q15.3 (D), Q17.3 (D), Q19.3 (D), Q21.3 (D), Q23.3 (D), Q25.3 (D); also elsewhere on the board
/2A: C47.1, Q9.1 (S), Q10.3 (D), R66.1, U16.18 (VS1); also elsewhere on the board
/2B: C48.1, Q11.1 (S), Q12.3 (D), R69.1, U16.15 (VS2); also elsewhere on the board
/2C: C49.1, Q13.1 (S), Q14.3 (D), R72.1, U16.12 (VS3); also elsewhere on the board
/3A: C54.1, Q15.1 (S), Q16.3 (D), R85.1, U18.18 (VS1); also elsewhere on the board
/3B: C55.1, Q17.1 (S), Q18.3 (D), R88.1, U18.15 (VS2); also elsewhere on the board
/3C: C56.1, Q19.1 (S), Q20.3 (D), R91.1, U18.12 (VS3); also elsewhere on the board
/4A: C61.1, Q21.1 (S), Q22.3 (D), R104.1, U20.18 (VS1); also elsewhere on the board
/4B: C62.1, Q23.1 (S), Q24.3 (D), R107.1, U20.15 (VS2); also elsewhere on the board
/4C: C63.1, Q25.1 (S), Q26.3 (D), R110.1, U20.12 (VS3); also elsewhere on the board
/ESC2/AH: U15.20 (PA10), U16.22 (HIN1)
/ESC2/AL: U15.15 (PB1), U16.1 (LIN1)
/ESC2/BH: U15.19 (PA9), U16.23 (HIN2)
/ESC2/BL: U15.14 (PB0), U16.2 (LIN2)
/ESC2/CH: U15.18 (PA8), U16.24 (HIN3)
/ESC2/CL: U15.13 (PA7), U16.3 (LIN3)
/ESC2/FBA: R64.1, R65.2, R66.2, U15.6 (PA0)
/ESC2/FBB: R67.2, R68.2, R69.2, U15.10 (PA4)
/ESC2/FBC: R70.2, R71.2, R72.2, U15.11 (PA5)
/ESC2/FBCOMMON: R64.2, R67.1, R70.1, U15.7 (PA1)
/ESC2/GHA: U16.19 (HO1); also elsewhere on the board
/ESC2/GHB: R60.1, U16.16 (HO2)
/ESC2/GHC: R62.1, U16.13 (HO3)
/ESC2/GLA: R55.1, U16.11 (LO1)
/ESC2/GLB: R61.1, U16.10 (LO2)
/ESC2/GLC: R63.1, U16.9 (LO3)
/ESC2/vdda: C45.1, U15.5 (VDDA); also elsewhere on the board
/ESC3/AH: U17.20 (PA10), U18.22 (HIN1)
/ESC3/AL: U17.15 (PB1), U18.1 (LIN1)
/ESC3/BH: U17.19 (PA9), U18.23 (HIN2)
/ESC3/BL: U17.14 (PB0), U18.2 (LIN2)
/ESC3/CH: U17.18 (PA8), U18.24 (HIN3)
/ESC3/CL: U17.13 (PA7), U18.3 (LIN3)
/ESC3/FBA: R83.1, R84.2, R85.2, U17.6 (PA0)
/ESC3/FBB: R86.2, R87.2, R88.2, U17.10 (PA4)
/ESC3/FBC: R89.2, R90.2, R91.2, U17.11 (PA5)
/ESC3/FBCOMMON: R83.2, R86.1, R89.1, U17.7 (PA1)
/ESC3/GHA: R73.1, U18.19 (HO1)
/ESC3/GHB: R79.1, U18.16 (HO2)
/ESC3/GHC: R81.1, U18.13 (HO3)
/ESC3/GLA: U18.11 (LO1); also elsewhere on the board
/ESC3/GLB: R80.1, U18.10 (LO2)
/ESC3/GLC: R82.1, U18.9 (LO3)
/ESC3/vdda: C52.1, R78.1, U17.5 (VDDA)
/ESC4/AH: U19.20 (PA10), U20.22 (HIN1)
/ESC4/AL: U19.15 (PB1), U20.1 (LIN1)
/ESC4/BH: U19.19 (PA9), U20.23 (HIN2)
/ESC4/BL: U19.14 (PB0), U20.2 (LIN2)
/ESC4/CH: U19.18 (PA8), U20.24 (HIN3)
/ESC4/CL: U19.13 (PA7), U20.3 (LIN3)
/ESC4/FBA: R102.1, R103.2, R104.2, U19.6 (PA0)
/ESC4/FBB: R105.2, R106.2, R107.2, U19.10 (PA4)
/ESC4/FBC: R108.2, R109.2, R110.2, U19.11 (PA5)
/ESC4/FBCOMMON: R102.2, R105.1, R108.1, U19.7 (PA1)
/ESC4/GHA: R92.1, U20.19 (HO1)
/ESC4/GHB: R98.1, U20.16 (HO2)
/ESC4/GHC: R100.1, U20.13 (HO3)
/ESC4/GLA: R93.1, U20.11 (LO1)
/ESC4/GLB: R99.1, U20.10 (LO2)
/ESC4/GLC: R101.1, U20.9 (LO3)
/ESC4/vdda: C59.1, R97.1, U19.5 (VDDA)
/MOTOR2: R58.1; also elsewhere on the board
/MOTOR3: R77.1; also elsewhere on the board
/MOTOR4: R96.1; also elsewhere on the board
GND: C44.2, C45.2, C46.2, C50.2, C51.2, C52.2, C53.2, C57.2, C58.2, C59.2, C60.2, C64.2, C93.2, C94.2, C95.2, C96.2, C97.2, C98.2, C99.2, C100.2, C101.2, Q10.1 (S), Q12.1 (S), Q14.1 (S), Q16.1 (S), Q18.1 (S), Q20.1 (S), Q22.1 (S), Q24.1 (S), Q26.1 (S), R57.2, R65.1, R68.1, R71.1, R84.1, R87.1, R90.1, R95.2, R103.1, R106.1, R109.1, U15.16 (VSS), U15.29 (VSS), U16.6 (COM), U16.25 (COM), U17.16 (VSS), U17.29 (VSS), U18.6 (COM), U18.25 (COM), U19.16 (VSS), U19.29 (VSS), U20.6 (COM), U20.25 (COM); also elsewhere on the board
unnamed 171: Q9.2 (G); also elsewhere on the board
unnamed: Q10.2 (G), R55.2
unnamed: Q11.2 (G), R60.2
unnamed: Q12.2 (G), R61.2
unnamed: Q13.2 (G), R62.2
unnamed: Q14.2 (G), R63.2
unnamed: Q15.2 (G), R73.2
unnamed 178: Q16.2 (G); also elsewhere on the board
unnamed: Q17.2 (G), R79.2
unnamed: Q18.2 (G), R80.2
unnamed: Q19.2 (G), R81.2
unnamed: Q20.2 (G), R82.2
unnamed: Q21.2 (G), R92.2
unnamed: Q22.2 (G), R93.2
unnamed: Q23.2 (G), R98.2
unnamed: Q24.2 (G), R99.2
unnamed: Q25.2 (G), R100.2
unnamed: Q26.2 (G), R101.2
unnamed: R57.1, U15.1 (BOOT0)
unnamed: C44.1, R56.1, U15.4 (NRST)
unnamed: TP3.1 (1_1), U15.21 (PA13)
unnamed: TP4.1 (1_1), U15.22 (PA14)
unnamed: R58.2, U15.25 (PB4)
unnamed: C47.2, U16.20 (VB1)
unnamed: C48.2, U16.17 (VB2)
unnamed: C49.2, U16.14 (VB3)
unnamed 211: U17.1 (BOOT0); also elsewhere on the board
unnamed: C51.1, R75.1, U17.4 (NRST)
unnamed: TP5.1 (1_1), U17.21 (PA13)
unnamed: TP6.1 (1_1), U17.22 (PA14)
unnamed: R77.2, U17.25 (PB4)
unnamed: C54.2, U18.20 (VB1)
unnamed: C55.2, U18.17 (VB2)
unnamed: C56.2, U18.14 (VB3)
unnamed: R95.1, U19.1 (BOOT0)
unnamed: C58.1, R94.1, U19.4 (NRST)
unnamed: TP7.1 (1_1), U19.21 (PA13)
unnamed: TP8.1 (1_1), U19.22 (PA14)
unnamed: R96.2, U19.25 (PB4)
unnamed: C61.2, U20.20 (VB1)
unnamed: C62.2, U20.17 (VB2)
unnamed: C63.2, U20.14 (VB3)

Notes on the sheet:
Bootstrap capacitors for high side N-MOS switching
Gate Driver
MOSFET, low and high side for each phase
Single sheet instance of an ESC, duplicated 4 times
Microcontroller: AT32
SWC flashing
(gate driver has integrated diode)
06/06/2026
BEMF Feedback network
LPF on VDDA

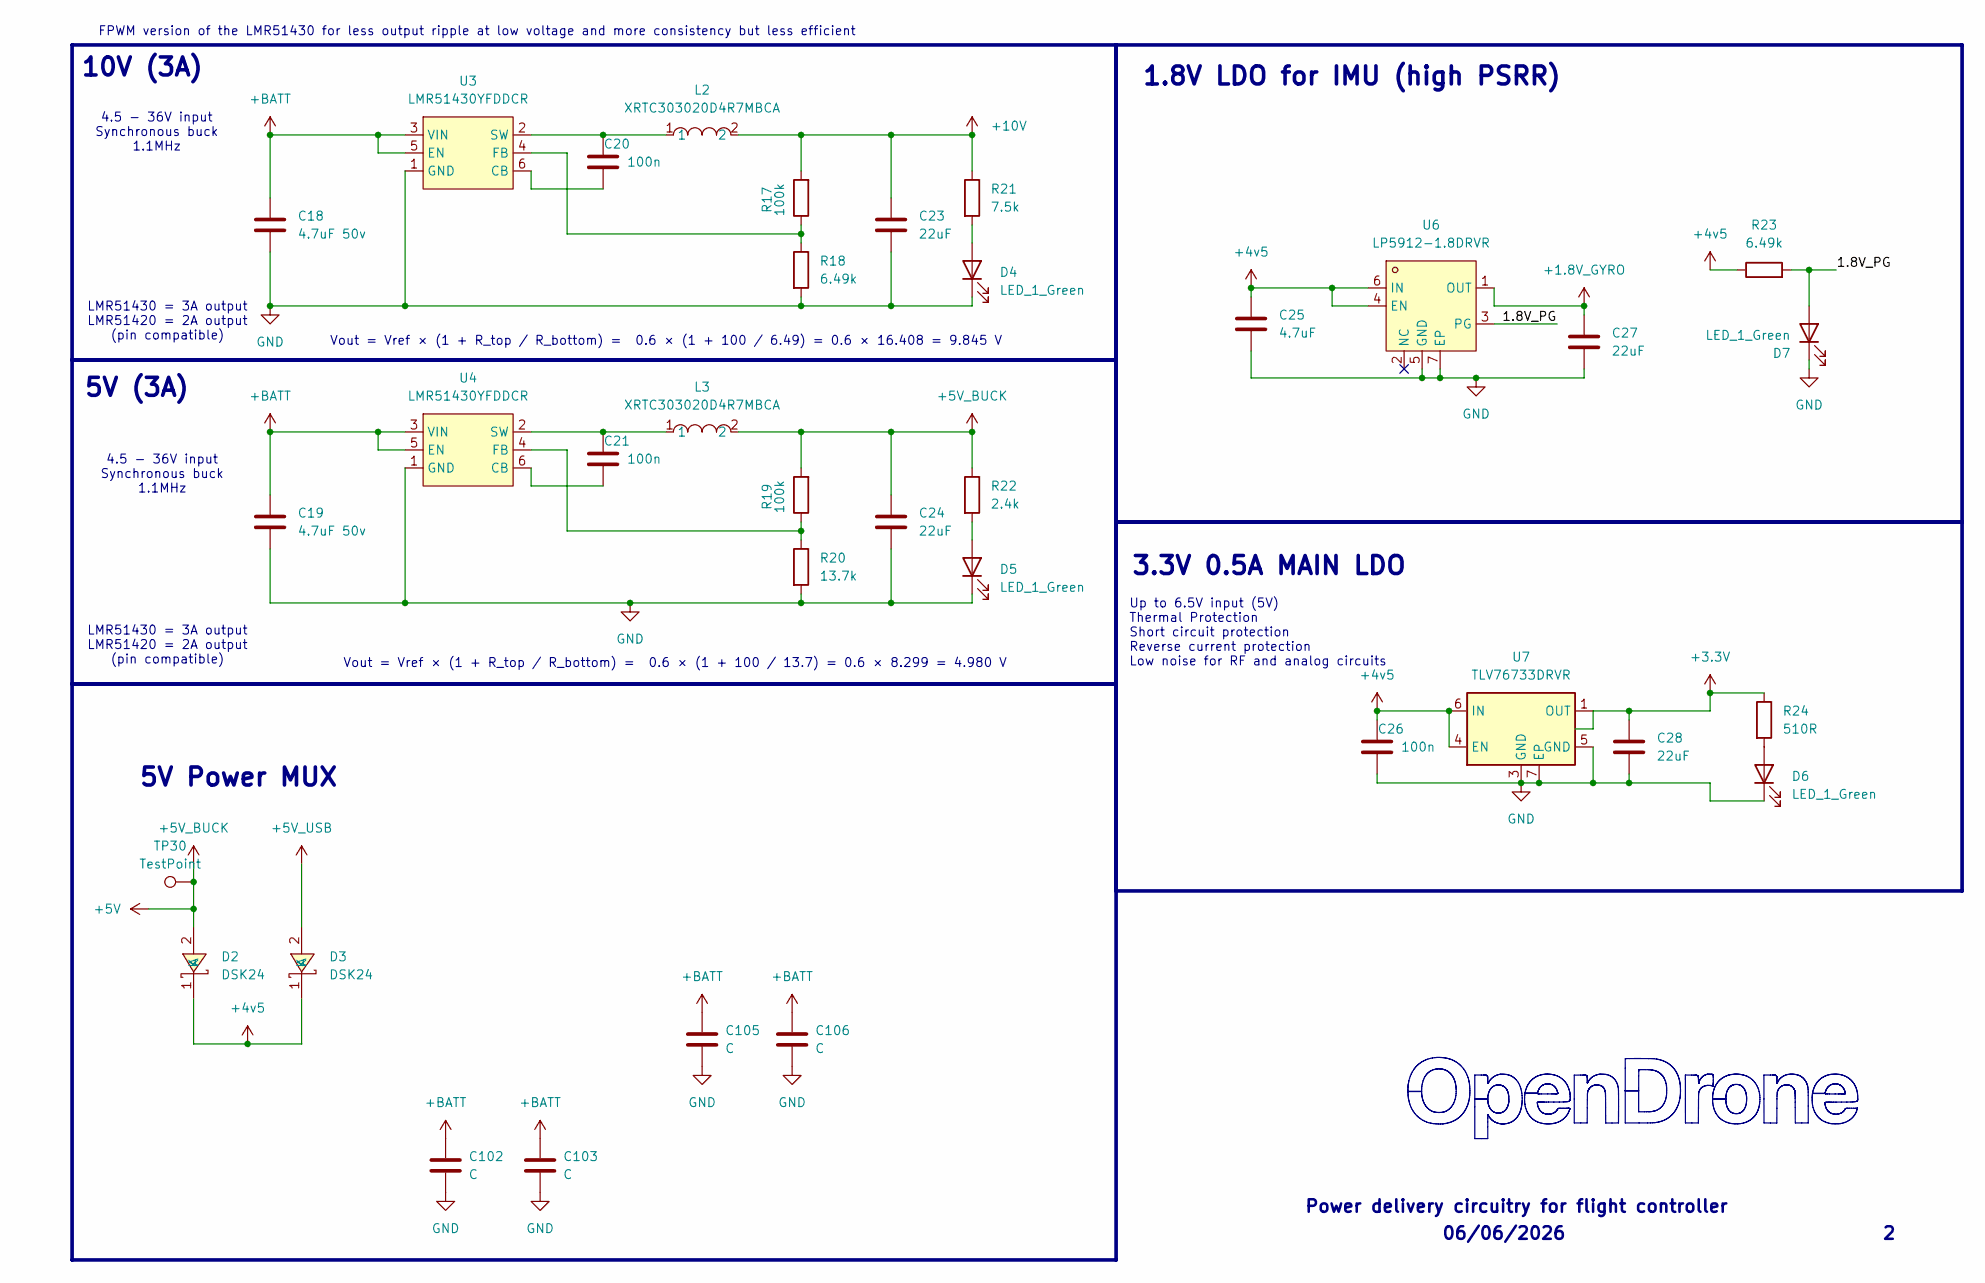
[picture p22: schematic fc_power.kicad_sch]

Parts:
C18, C19: 4.7uF 50v; C_0805_2012Metric; MPN CL21A475KBQNNNE; LCSC C98192
C20, C21, C26: 100n; C_0201_0603Metric; MPN GRM033R61E104KE14D; LCSC C76939
C23, C24: 22uF; C_0603_1608Metric; MPN CL10A226MO7JZNC; LCSC C2762594
C25: 4.7uF; C_0402_1005Metric; MPN CL05A475MP5NRNC; LCSC C23733
C27, C28: 22uF; C_0402_1005Metric; MPN GRM155R60J226ME11D; LCSC C415703
C102, C103: C; C_0805_2012Metric
C105, C106: C; C_1206_3216Metric
D2, D3: DSK24; SOD-123_L2.8-W1.8-LS3.7-RD; MPN DSK24; LCSC C64890
D4, D5, D6, D7: LED_1_Green; LED_0402_1005Metric; MPN XL-1005UGC; LCSC C965793
L2, L3: XRTC303020D4R7MBCA; IND-SMD_L3.0-W3.0_AFE303020S; MPN XRTC303020D4R7MBCA; LCSC C39846837
R17, R19: 100k; R_0201_0603Metric; MPN 0201WMF1003TEE; LCSC C270364
R18, R23: 6.49k; R_0201_0603Metric; LCSC C2107920
R20: 13.7k; R_0201_0603Metric; MPN RC-01W1372FT; LCSC C320695
R21: 7.5k; R_0201_0603Metric; LCSC C474437
R22: 2.4k; R_0201_0603Metric; LCSC C166281
R24: 510R; R_0201_0603Metric; LCSC C57784
TP30: TestPoint; TestPoint_Pad_D1.0mm
U3, U4: LMR51430YFDDCR; SOT-23-6_L2.9-W1.6-P0.95-LS2.9-BL; MPN LMR51430YFDDCR; LCSC C5219261
U6: LP5912-1.8DRVR; WSON-6-1EP_2x2mm_P0.65mm_EP1x1.6mm_ThermalVias; MPN LP5912-1.8DRVR; LCSC C2876234
U7: TLV76733DRVR; WSON-6-1EP_2x2mm_P0.65mm_EP1x1.6mm; MPN TLV76733DRVR; LCSC C2848334

Connections:
+1.8V_GYRO: C27.1, U6.1 (OUT); also elsewhere on the board
+3.3V: C28.1, R24.1, U7.1 (OUT), U7.2 (SNS); also elsewhere on the board
+4v5: C25.1, C26.1, D2.1 (K), D3.1 (K), R23.1, U6.4 (EN), U6.6 (IN), U7.4 (EN), U7.6 (IN)
+5V: C24.1, D2.2 (A), L3.2, R19.2, R22.1, TP30.1; also elsewhere on the board
+5V_USB: D3.2 (A); also elsewhere on the board
+10V: C23.1, L2.2, R17.2, R21.1; also elsewhere on the board
+BATT: C18.1, C19.1, C102.1, C103.1, C105.1, C106.1, U3.3 (VIN), U3.5 (EN), U4.3 (VIN), U4.5 (EN); also elsewhere on the board
/Power/1.8V_PG: D7.2 (A), R23.2, U6.3 (PG)
GND: C18.2, C19.2, C23.2, C24.2, C25.2, C26.2, C27.2, C28.2, C102.2, C103.2, C105.2, C106.2, D4.1 (K), D5.1 (K), D6.1 (K), D7.1 (K), R18.2, R20.2, U3.1 (GND), U4.1 (GND), U6.5 (GND), U6.7 (EP), U7.3 (GND), U7.5 (GND), U7.7 (EP); also elsewhere on the board
unnamed: D4.2 (A), R21.2
unnamed: D5.2 (A), R22.2
unnamed: D6.2 (A), R24.2
unnamed: C20.2, U3.6 (CB)
unnamed: R17.1, R18.1, U3.4 (FB)
unnamed: C20.1, L2.1, U3.2 (SW)
unnamed: C21.2, U4.6 (CB)
unnamed: R19.1, R20.1, U4.4 (FB)
unnamed: C21.1, L3.1, U4.2 (SW)

Notes on the sheet:
Vout = Vref × (1 + R_top / R_bottom) = 0.6 × (1 + 100 / 13.7) = 0.6 × 8.299 = 4.980 V
1.8V LDO for IMU (high PSRR)
4.5 - 36V input Synchronous buck 1.1MHz
5V Power MUX
10V (3A)
3.3V 0.5A MAIN LDO
Up to 6.5V input (5V) Thermal Protection Short circuit protection Reverse current protection Low noise for RF and analog circuits
Vout = Vref × (1 + R_top / R_bottom) = 0.6 × (1 + 100 / 6.49) = 0.6 × 16.408 = 9.845 V
06/06/2026
FPWM version of the LMR51430 for less output ripple at low voltage and more consistency but less efficient
5V (3A)
LMR51430 = 3A output LMR51420 = 2A output (pin compatible)
Power delivery circuitry for flight controller

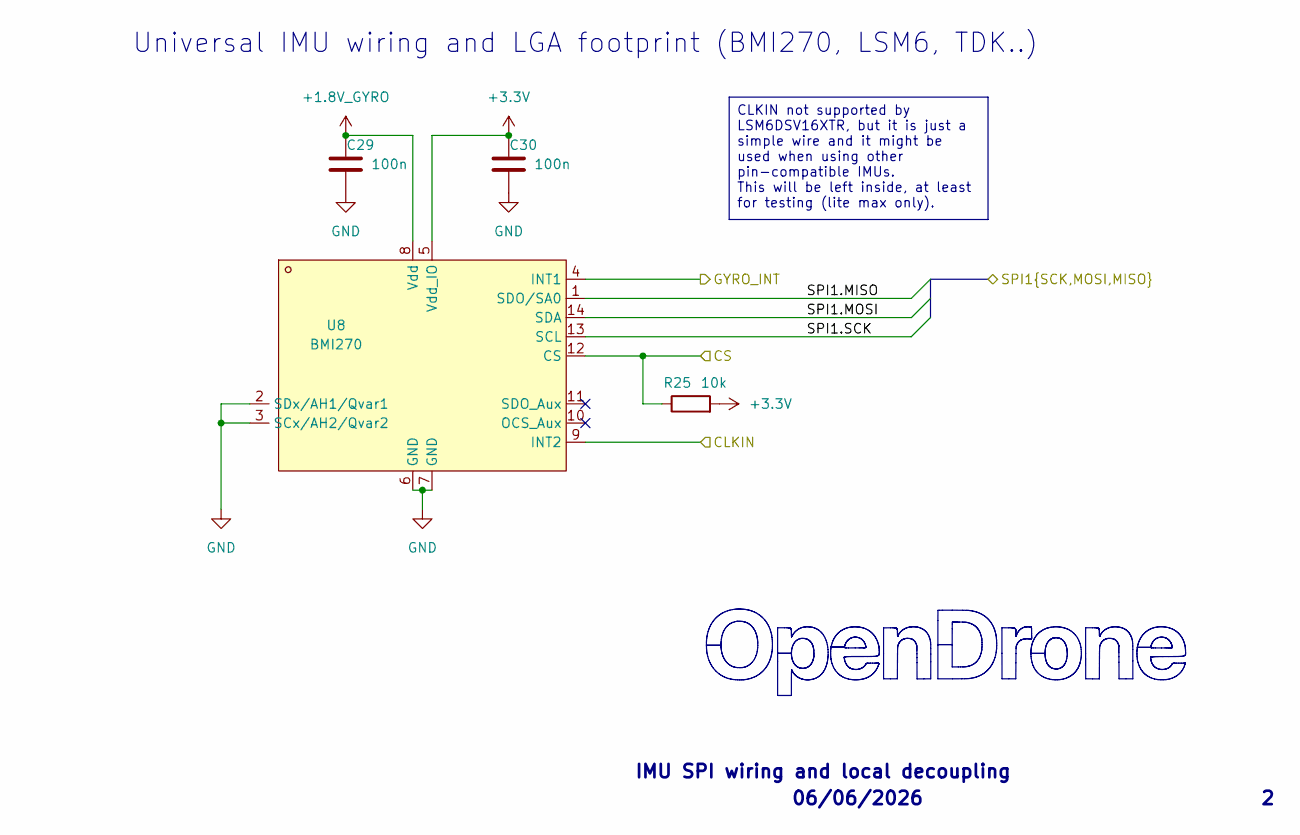
[picture p23: schematic fc_imu.kicad_sch]

Parts:
C29, C30: 100n; C_0201_0603Metric; MPN GRM033R61E104KE14D; LCSC C76939
R25: 10k; R_0201_0603Metric; MPN RC0201FR-0710KL; LCSC C106225
U8: BMI270; LGA-14_L3.0-W2.5-P0.50-BR; MPN BMI270; LCSC C2836813

Connections:
+1.8V_GYRO: C29.1, U8.8 (Vdd); also elsewhere on the board
+3.3V: C30.1, R25.2, U8.5 (Vdd_IO); also elsewhere on the board
/IMU/CLKIN: U8.9 (INT2)
/IMU_CS: R25.1, U8.12 (CS); also elsewhere on the board
/IMU_INT: U8.4 (INT1); also elsewhere on the board
/IMU_SPI.MISO: U8.1 (SDO/SA0); also elsewhere on the board
/IMU_SPI.MOSI: U8.14 (SDA); also elsewhere on the board
/IMU_SPI.SCK: U8.13 (SCL); also elsewhere on the board
GND: C29.2, C30.2, U8.2 (SDx/AH1/Qvar1), U8.3 (SCx/AH2/Qvar2), U8.6 (GND), U8.7 (GND); also elsewhere on the board

Notes on the sheet:
06/06/2026
Universal IMU wiring and LGA footprint (BMI270, LSM6, TDK..)
IMU SPI wiring and local decoupling
CLKIN not supported by LSM6DSV16XTR, but it is just a simple wire and it might be used when using other pin-compatible IMUs. This will be left inside, at least for testing (lite max only).

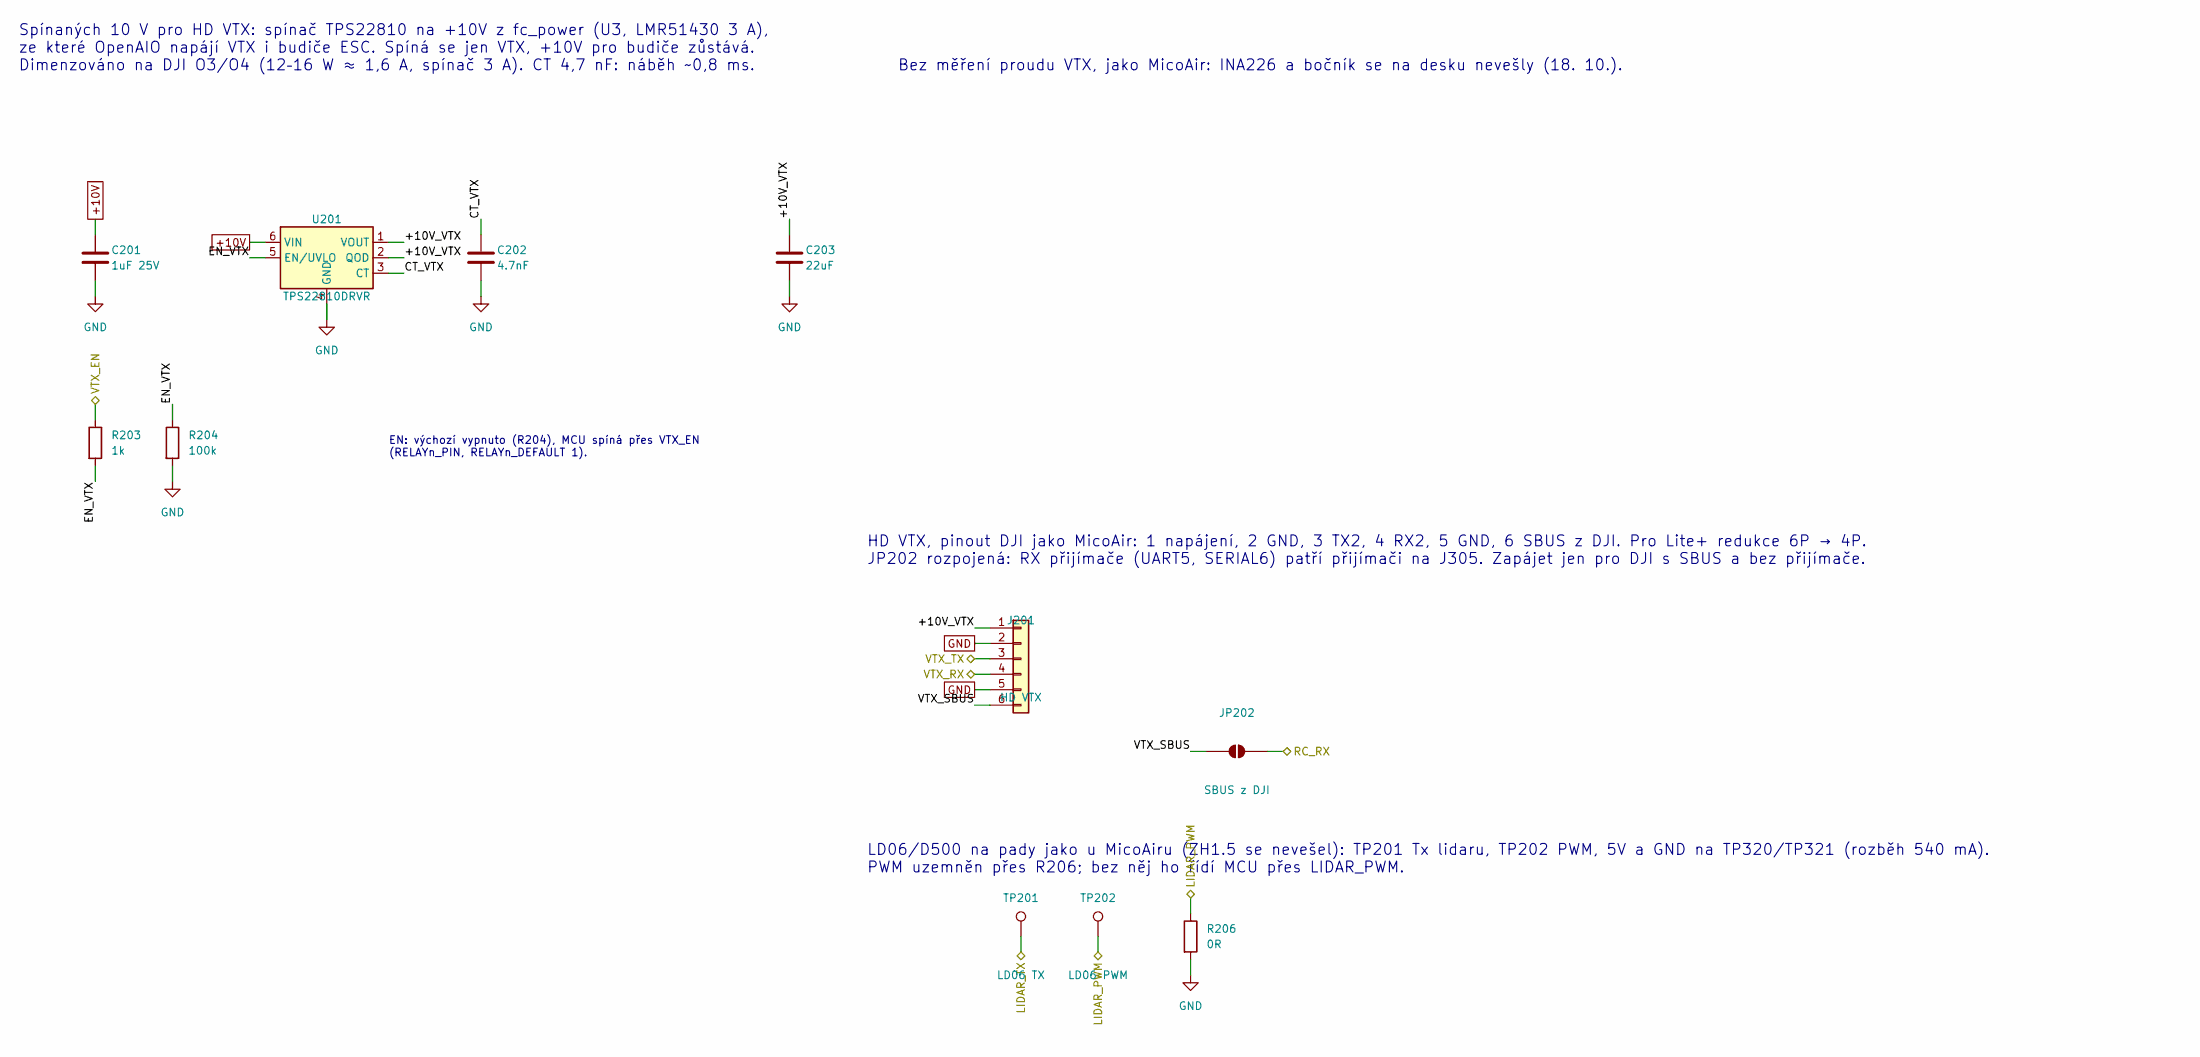
[picture p24: schematic vtx.kicad_sch, VTX a LD06]

Parts:
C201: 1uF 25V; C_0402_1005Metric
C202: 4.7nF; C_0201_0603Metric
C203: 22uF; C_0603_1608Metric; LCSC C2762594
J201: HD VTX; JST_SH_SM06B-SRSS-TB_1x06-1MP_P1.00mm_Horizontal; LCSC C160405
JP202: SBUS z DJI; SolderJumper-2_P1.3mm_Open_Pad1.0x1.5mm
R203: 1k; R_0201_0603Metric
R204: 100k; R_0201_0603Metric; LCSC C270364
R206: 0R; R_0201_0603Metric
TP201: LD06 TX; Pad_1.0x1.4mm
TP202: LD06 PWM; Pad_1.0x1.4mm
U201: TPS22810DRVR; WSON-6-1EP_2x2mm_P0.65mm_EP1x1.6mm

Connections:
+10V: C201.1, U201.6 (VIN); also elsewhere on the board
/LIDAR_PWM: R206.1, TP202.1; also elsewhere on the board
/LIDAR_TX: TP201.1; also elsewhere on the board
/RC_RX: JP202.2 (B); also elsewhere on the board
/VTX a LD06/+10V_VTX: C203.1, J201.1, U201.1 (VOUT), U201.2 (QOD)
/VTX a LD06/CT_VTX: C202.1, U201.3 (CT)
/VTX a LD06/EN_VTX: R203.2, R204.1, U201.5 (EN/UVLO)
/VTX a LD06/VTX_SBUS: J201.6, JP202.1 (A)
/VTX_EN: R203.1; also elsewhere on the board
/VTX_RX: J201.4; also elsewhere on the board
/VTX_TX: J201.3; also elsewhere on the board
GND: C201.2, C202.2, C203.2, J201.2, J201.5, R204.2, R206.2, U201.4 (GND), U201.7 (GND); also elsewhere on the board

Notes on the sheet:
Spínaných 10 V pro HD VTX: spínač TPS22810 na +10V z fc_power (U3, LMR51430 3 A), ze které OpenAIO napájí VTX i budiče ESC. Spíná se jen VTX, +10V pro budiče zůstává. Dimenzováno na DJI O3/O4 (12–16 W ≈ 1,6 A, spínač 3 A). CT 4,7 nF: náběh ~0,8 ms.
EN: výchozí vypnuto (R204), MCU spíná přes VTX_EN (RELAYn_PIN, RELAYn_DEFAULT 1).
Bez měření proudu VTX, jako MicoAir: INA226 a bočník se na desku nevešly (18. 10.).
HD VTX, pinout DJI jako MicoAir: 1 napájení, 2 GND, 3 TX2, 4 RX2, 5 GND, 6 SBUS z DJI. Pro Lite+ redukce 6P → 4P. JP202 rozpojená: RX přijímače (UART5, SERIAL6) patří přijímači na J305. Zapájet jen pro DJI s SBUS a bez přijímače.
LD06/D500 na pady jako u MicoAiru (ZH1.5 se nevešel): TP201 Tx lidaru, TP202 PWM, 5V a GND na TP320/TP321 (rozběh 540 mA). PWM uzemněn přes R206; bez něj ho řídí MCU přes LIDAR_PWM.
