phageweb/dron/dps/aio/aio.kicad_pcb

## KiCad design dps/aio/aio.kicad_pcb (continued)

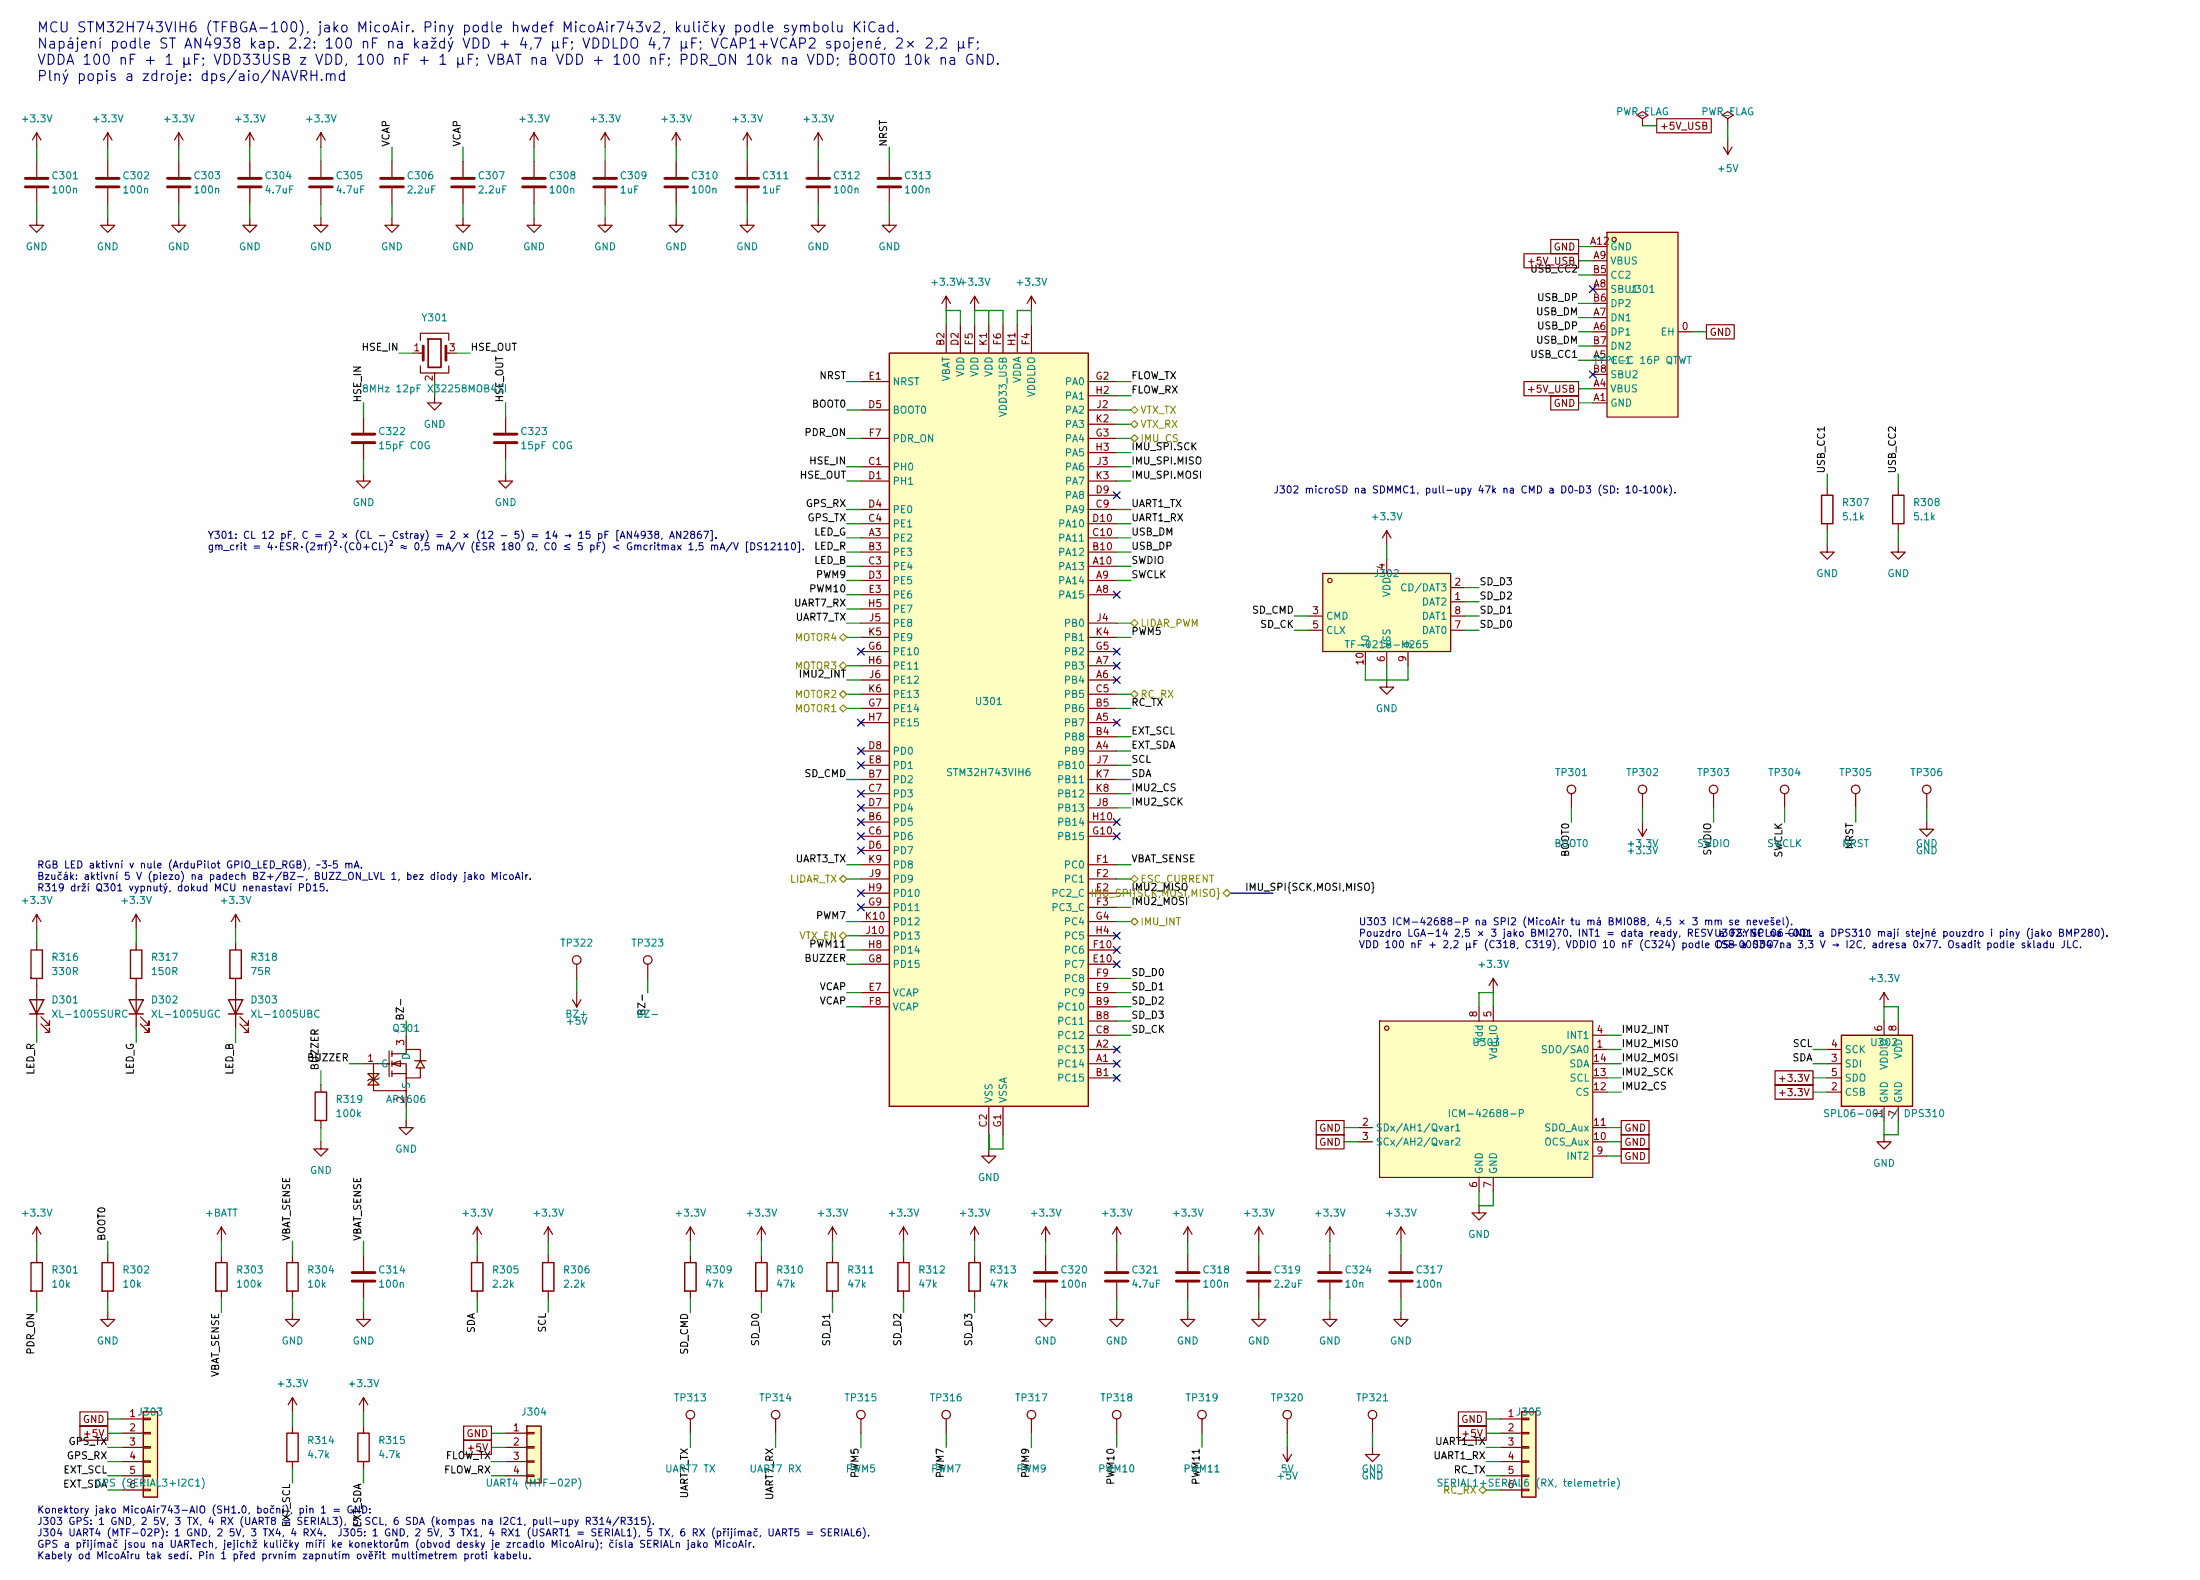
[picture p25: schematic mcu_h743.kicad_sch, MCU STM32H743]

Parts:
C301, C302, C303, C308, C310, C312, C313, C314, C317, C318, C320: 100n; C_0201_0603Metric; LCSC C76939
C304, C305, C321: 4.7uF; C_0402_1005Metric; LCSC C23733
C306, C307: 2.2uF; C_0402_1005Metric
C309, C311: 1uF; C_0402_1005Metric
C319: 2.2uF; C_0201_0603Metric
C322, C323: 15pF C0G; C_0402_1005Metric
C324: 10n; C_0201_0603Metric
D301: XL-1005SURC; LED_0402_1005Metric; LCSC C965790
D302: XL-1005UGC; LED_0402_1005Metric; LCSC C965793
D303: XL-1005UBC; LED_0402_1005Metric; LCSC C22355736
J301: TYPE-C 16P QTWT; USB-TYPE-C-SMD_TYPE-C-16P-QTWT; LCSC C5187472
J302: TF-021B-H265; TF-SMD_TF-021B-H265; LCSC C498185
J303: GPS (SERIAL3+I2C1); JST_SH_SM06B-SRSS-TB_1x06-1MP_P1.00mm_Horizontal; LCSC C160405
J304: UART4 (MTF-02P); JST_SH_SM04B-SRSS-TB_1x04-1MP_P1.00mm_Horizontal
J305: SERIAL1+SERIAL6 (RX, telemetrie); JST_SH_SM06B-SRSS-TB_1x06-1MP_P1.00mm_Horizontal; LCSC C160405
Q301: AP1606; DFN-3L_L1.0-W0.6-P0.65-BR; LCSC C2849580
R301, R302, R304: 10k; R_0201_0603Metric
R303, R319: 100k; R_0201_0603Metric; LCSC C270364
R305, R306: 2.2k; R_0201_0603Metric
R307, R308: 5.1k; R_0201_0603Metric; LCSC C270344
R309, R310, R311, R312, R313: 47k; R_0201_0603Metric
R314, R315: 4.7k; R_0201_0603Metric
R316: 330R; R_0201_0603Metric
R317: 150R; R_0201_0603Metric
R318: 75R; R_0201_0603Metric
TP301: BOOT0; Pad_1.0x1.4mm
TP302: +3.3V; Pad_1.0x1.4mm
TP303: SWDIO; Pad_1.0x1.4mm
TP304: SWCLK; Pad_1.0x1.4mm
TP305: NRST; Pad_1.0x1.4mm
TP306, TP321: GND; Pad_1.0x1.4mm
TP313: UART7 TX; Pad_1.0x1.4mm
TP314: UART7 RX; Pad_1.0x1.4mm
TP315: PWM5; Pad_1.0x1.4mm
TP316: PWM7; Pad_1.0x1.4mm
TP317: PWM9; Pad_1.0x1.4mm
TP318: PWM10; Pad_1.0x1.4mm
TP319: PWM11; Pad_1.0x1.4mm
TP320: 5V; Pad_1.0x1.4mm
TP322: BZ+; Pad_1.0x1.4mm
TP323: BZ-; Pad_1.0x1.4mm
U301: STM32H743VIH6; TFBGA-100_8x8mm_Layout10x10_P0.8mm
U302: SPL06-001 / DPS310; Bosch_LGA-8_2x2.5mm_P0.65mm_ClockwisePinNumbering; LCSC C2684428
U303: ICM-42688-P; LGA-14_L3.0-W2.5-P0.50-BR
Y301: 8MHz 12pF X32258MOB4SI; Crystal_SMD_3225-4Pin_3.2x2.5mm; LCSC C2682775

Connections:
+3.3V: C301.1, C302.1, C303.1, C304.1, C305.1, C308.1, C309.1, C310.1, C311.1, C312.1, C317.1, C318.1, C319.1, C320.1, C321.1, C324.1, J302.4 (VDD), R301.1, R305.1, R306.1, R309.1, R310.1, R311.1, R312.1, R313.1, R314.1, R315.1, R316.1, R317.1, R318.1, TP302.1, U301.B2 (VBAT), U301.D2 (VDD), U301.F4 (VDDLDO), U301.F5 (VDD), U301.F6 (VDD33_USB), U301.H1 (VDDA), U301.K1 (VDD), U302.2 (CSB), U302.5 (SDO), U302.6 (VDDIO), U302.8 (VDD), U303.5 (Vdd_IO), U303.8 (Vdd); also elsewhere on the board
+5V: J303.2, J304.2, J305.2, TP320.1, TP322.1; also elsewhere on the board
+5V_USB: J301.A4 (VBUS), J301.A9 (VBUS); also elsewhere on the board
+BATT: R303.1; also elsewhere on the board
/ESC_CURRENT: U301.F2 (PC1); also elsewhere on the board
/IMU_CS: U301.G3 (PA4); also elsewhere on the board
/IMU_INT: U301.G4 (PC4); also elsewhere on the board
/IMU_SPI.MISO: U301.J3 (PA6); also elsewhere on the board
/IMU_SPI.MOSI: U301.K3 (PA7); also elsewhere on the board
/IMU_SPI.SCK: U301.H3 (PA5); also elsewhere on the board
/LIDAR_PWM: U301.J4 (PB0); also elsewhere on the board
/LIDAR_TX: U301.J9 (PD9); also elsewhere on the board
/MCU H743/BOOT0: R302.1, TP301.1, U301.D5 (BOOT0)
/MCU H743/BUZZER: Q301.1 (G), R319.1, U301.G8 (PD15)
/MCU H743/BZ-: Q301.3 (D), TP323.1
/MCU H743/EXT_SCL: J303.5, R314.2, U301.B4 (PB8)
/MCU H743/EXT_SDA: J303.6, R315.2, U301.A4 (PB9)
/MCU H743/FLOW_RX: J304.4, U301.H2 (PA1)
/MCU H743/FLOW_TX: J304.3, U301.G2 (PA0)
/MCU H743/GPS_RX: J303.4, U301.D4 (PE0)
/MCU H743/GPS_TX: J303.3, U301.C4 (PE1)
/MCU H743/HSE_IN: C322.1, U301.C1 (PH0), Y301.1
/MCU H743/HSE_OUT: C323.1, U301.D1 (PH1), Y301.3
/MCU H743/IMU2_CS: U301.K8 (PB12), U303.12 (CS)
/MCU H743/IMU2_INT: U301.J6 (PE12), U303.4 (INT1)
/MCU H743/IMU2_MISO: U301.E2 (PC2_C), U303.1 (SDO/SA0)
/MCU H743/IMU2_MOSI: U301.F3 (PC3_C), U303.14 (SDA)
/MCU H743/IMU2_SCK: U301.J8 (PB13), U303.13 (SCL)
/MCU H743/LED_B: D303.1 (K), U301.C3 (PE4)
/MCU H743/LED_G: D302.1 (K), U301.A3 (PE2)
/MCU H743/LED_R: D301.1 (K), U301.B3 (PE3)
/MCU H743/NRST: C313.1, TP305.1, U301.E1 (NRST)
/MCU H743/PDR_ON: R301.2, U301.F7 (PDR_ON)
/MCU H743/PWM5: TP315.1, U301.K4 (PB1)
/MCU H743/PWM7: TP316.1, U301.K10 (PD12)
/MCU H743/PWM9: TP317.1, U301.D3 (PE5)
/MCU H743/PWM10: TP318.1, U301.E3 (PE6)
/MCU H743/PWM11: TP319.1, U301.H8 (PD14)
/MCU H743/RC_TX: J305.5, U301.B5 (PB6)
/MCU H743/SCL: R306.2, U301.J7 (PB10), U302.4 (SCK)
/MCU H743/SDA: R305.2, U301.K7 (PB11), U302.3 (SDI)
/MCU H743/SD_CK: J302.5 (CLX), U301.C8 (PC12)
/MCU H743/SD_CMD: J302.3 (CMD), R309.2, U301.B7 (PD2)
/MCU H743/SD_D0: J302.7 (DAT0), R310.2, U301.F9 (PC8)
/MCU H743/SD_D1: J302.8 (DAT1), R311.2, U301.E9 (PC9)
/MCU H743/SD_D2: J302.1 (DAT2), R312.2, U301.B9 (PC10)
/MCU H743/SD_D3: J302.2 (CD/DAT3), R313.2, U301.B8 (PC11)
/MCU H743/SWCLK: TP304.1, U301.A9 (PA14)
/MCU H743/SWDIO: TP303.1, U301.A10 (PA13)
/MCU H743/UART1_RX: J305.4, U301.D10 (PA10)
/MCU H743/UART1_TX: J305.3, U301.C9 (PA9)
/MCU H743/UART3_TX: U301.K9 (PD8)
/MCU H743/UART7_RX: TP314.1, U301.H5 (PE7)
/MCU H743/UART7_TX: TP313.1, U301.J5 (PE8)
/MCU H743/USB_CC1: J301.A5 (CC1), R307.1
/MCU H743/USB_CC2: J301.B5 (CC2), R308.1
/MCU H743/USB_DM: J301.A7 (DN1), J301.B7 (DN2), U301.C10 (PA11)
/MCU H743/USB_DP: J301.A6 (DP1), J301.B6 (DP2), U301.B10 (PA12)
/MCU H743/VBAT_SENSE: C314.1, R303.2, R304.1, U301.F1 (PC0)
/MCU H743/VCAP: C306.1, C307.1, U301.E7 (VCAP), U301.F8 (VCAP)
/MOTOR1: U301.G7 (PE14); also elsewhere on the board
/MOTOR2: U301.K6 (PE13); also elsewhere on the board
/MOTOR3: U301.H6 (PE11); also elsewhere on the board
/MOTOR4: U301.K5 (PE9); also elsewhere on the board
/RC_RX: J305.6, U301.C5 (PB5); also elsewhere on the board
/VTX_EN: U301.J10 (PD13); also elsewhere on the board
/VTX_RX: U301.K2 (PA3); also elsewhere on the board
/VTX_TX: U301.J2 (PA2); also elsewhere on the board
GND: C301.2, C302.2, C303.2, C304.2, C305.2, C306.2, C307.2, C308.2, C309.2, C310.2, C311.2, C312.2, C313.2, C314.2, C317.2, C318.2, C319.2, C320.2, C321.2, C322.2, C323.2, C324.2, J301.0 (EH), J301.A1 (GND), J301.A12 (GND), J302.6 (VSS), J302.9, J302.10, J303.1, J304.1, J305.1, Q301.2 (S), R302.2, R304.2, R307.2, R308.2, R319.2, TP306.1, TP321.1, U301.C2 (VSS), U301.E4 (VSS), U301.E5 (VSS), U301.E6 (VSS), U301.G1 (VSSA), U301.J1 (VSS), U302.1 (GND), U302.7 (GND), U303.2 (SDx/AH1/Qvar1), U303.3 (SCx/AH2/Qvar2), U303.6 (GND), U303.7 (GND), U303.9 (INT2), U303.10 (OCS_Aux), U303.11 (SDO_Aux), Y301.2 (G), Y301.4 (G); also elsewhere on the board
unnamed: D301.2 (A), R316.2
unnamed: D302.2 (A), R317.2
unnamed: D303.2 (A), R318.2

Notes on the sheet:
MCU STM32H743VIH6 (TFBGA-100), jako MicoAir. Piny podle hwdef MicoAir743v2, kuličky podle symbolu KiCad. Napájení podle ST AN4938 kap. 2.2: 100 nF na každý VDD + 4,7 µF; VDDLDO 4,7 µF; VCAP1+VCAP2 spojené, 2× 2,2 µF; VDDA 100 nF + 1 µF; VDD33USB z VDD, 100 nF + 1 µF; VBAT na VDD + 100 nF; PDR_ON 10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
RGB LED aktivní v nule (ArduPilot GPIO_LED_RGB), ~3–5 mA. Bzučák: aktivní 5 V (piezo) na padech BZ+/BZ−, BUZZ_ON_LVL 1, bez diody jako MicoAir. R319 drží Q301 vypnutý, dokud MCU nenastaví PD15.
Y301: CL 12 pF, C = 2 × (CL − Cstray) = 2 × (12 − 5) = 14 → 15 pF [AN4938, AN2867]. gm_crit = 4·ESR·(2πf)²·(C0+CL)² ≈ 0,5 mA/V (ESR 180 Ω, C0 ≤ 5 pF) < Gmcritmax 1,5 mA/V [DS12110].
U302: SPL06-001 a DPS310 mají stejné pouzdro i piny (jako BMP280). CSB a SDO na 3,3 V → I2C, adresa 0x77. Osadit podle skladu JLC.
U303 ICM-42688-P na SPI2 (MicoAir tu má BMI088, 4,5 × 3 mm se nevešel). Pouzdro LGA-14 2,5 × 3 jako BMI270. INT1 = data ready, RESV a FSYNC na GND. VDD 100 nF + 2,2 µF (C318, C319), VDDIO 10 nF (C324) podle DS-000347.
J302 microSD na SDMMC1, pull-upy 47k na CMD a D0–D3 (SD: 10–100k).
Konektory jako MicoAir743-AIO (SH1.0, boční), pin 1 = GND: J303 GPS: 1 GND, 2 5V, 3 TX, 4 RX (UART8 = SERIAL3), 5 SCL, 6 SDA (kompas na I2C1, pull-upy R314/R315). J304 UART4 (MTF-02P): 1 GND, 2 5V, 3 TX4, 4 RX4. J305: 1 GND, 2 5V, 3 TX1, 4 RX1 (USART1 = SERIAL1), 5 TX, 6 RX (přijímač, UART5 = SERIA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

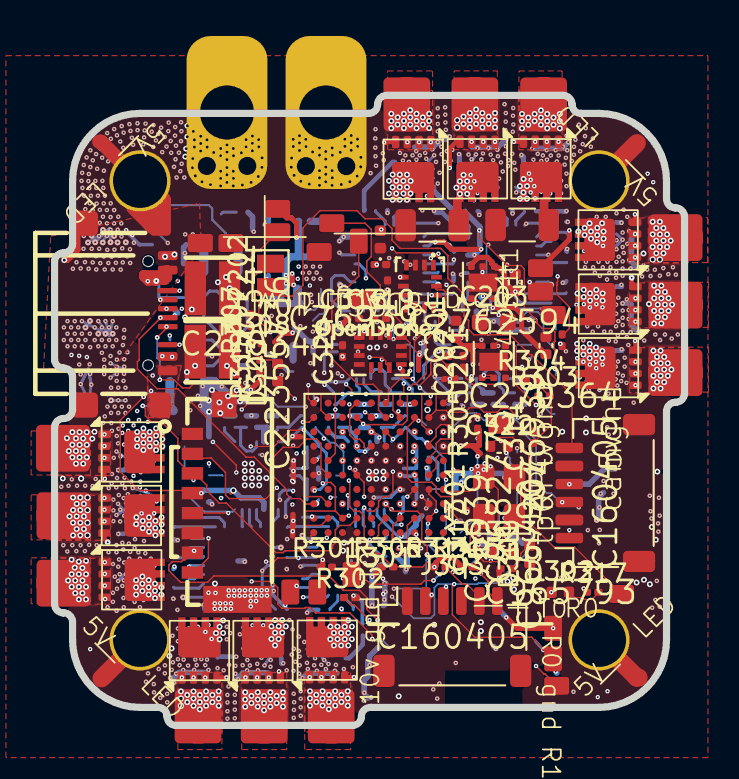
[picture p26: board aio.kicad_pcb from above]

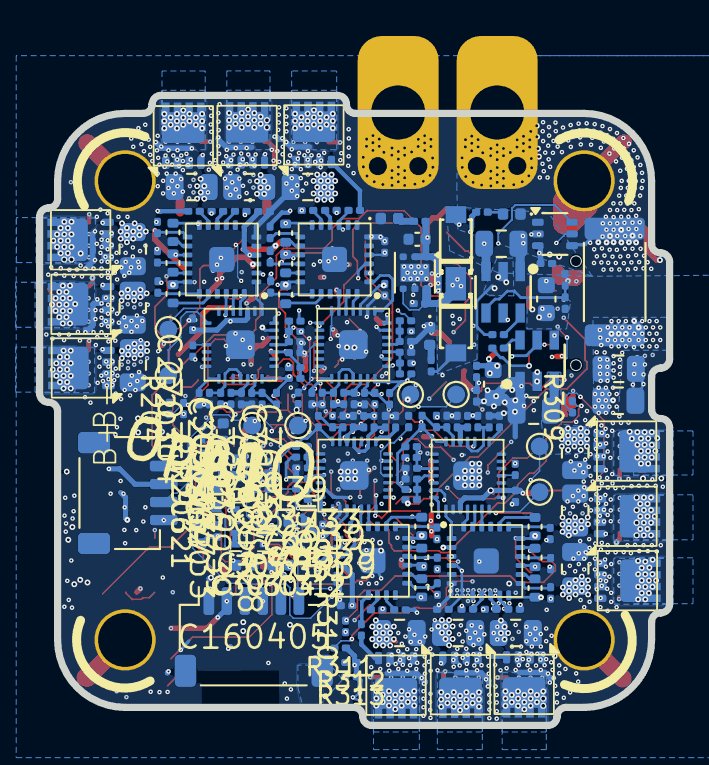
[picture p27: board aio.kicad_pcb from below]

Board: 8 copper layers, 35.0 x 35.0 mm, 280 parts (200 on the bottom side), 225 nets.

Other parts of the board:
R54, R74: 15R; R_0201_0603Metric
R59: 10R; R_0201_0603Metric
R76: 10k; R_0201_0603Metric

Their connections:
+3.3V: R59.2; also elsewhere on the board
/ESC2/GHA: R54.1; also elsewhere on the board
/ESC2/vdda: R59.1; also elsewhere on the board
/ESC3/GLA: R74.1; also elsewhere on the board
GND: R76.2; also elsewhere on the board
unnamed 171: R54.2; also elsewhere on the board
unnamed 178: R74.2; also elsewhere on the board
unnamed 211: R76.1; also elsewhere on the board
