phageweb/dron/ros_ws/src/openipc_cinewhoop_gazebo/config/ardupilot_params_pavo20.parm

FRAME_CLASS 1
FRAME_TYPE 1
MOT_PWM_MIN 1100
MOT_PWM_MAX 1900
MOT_THST_EXPO 1.0
MOT_THST_HOVER 0.53
ATC_RAT_RLL_P 0.060
ATC_RAT_RLL_I 0.060
ATC_RAT_RLL_D 0.0005
ATC_RAT_PIT_P 0.060
ATC_RAT_PIT_I 0.060
ATC_RAT_PIT_D 0.0005
ATC_RAT_YAW_P 0.023
ATC_RAT_YAW_I 0.0023
BATT_MONITOR 4
BATT_LOW_VOLT 14.0
BATT_CRT_VOLT 13.2
BATT_FS_LOW_ACT 1
BATT_FS_CRT_ACT 1
BATT_LOW_TIMER 10
