phageweb/dron/dps/aio/hwdef/Pavo20AIO/defaults.parm

# Board defaults for the Pavo20 AIO: only what follows from the wiring.

# VTX_EN on PD13 (PWM8, GPIO 57): the switched 10 V for the HD VTX, on at boot
SERVO8_FUNCTION -1
RELAY1_FUNCTION 1
RELAY1_PIN 57
RELAY1_DEFAULT 1
