phageweb/dron/dps/aio/web/obsah.py

"""Texty interaktivní stránky: bloky každého listu, co dělají, proč a odkud.

Stav bloku: prevzato | dokument | volba | otevrene (viz NAVRH.md, úroveň jistoty).
`refs` určují oblast na listu (obálka symbolů), `rect` ji dá ručně v mm listu,
`ramecek` vezme rámeček nakreslený v listu kolem dané součástky. `dalsi` jsou díly
bloku, které leží jinde na listu: patří do seznamu, ne do oblasti.
"""

ZDROJE = {
    "Z1": ("OpenAIO 986ce1e", "https://github.com/OpenDrone-hw/OpenAIO"),
    "Z2": ("OpenESC-20x20 dba7828", "https://github.com/OpenDrone-hw/OpenESC-20x20"),
    "Z3": ("OpenFC-Lite-Mini d8a10ee", "https://github.com/OpenDrone-hw/OpenFC-Lite-Mini"),
    "Z4": ("ST AN4938 rev 6, kap. 2.2, 5.2, tab. 8–9",
           "https://www.st.com/resource/en/application_note/an4938-getting-started-with-stm32h74xig-and-stm32h75xig-hardware-development-stmicroelectronics.pdf"),
    "Z5": ("ArduPilot 8b9ea70, hwdef MicoAir743v2",
           "https://github.com/ArduPilot/ardupilot/blob/master/libraries/AP_HAL_ChibiOS/hwdef/MicoAir743v2/hwdef.dat"),
    "Z6": ("TI LMR51430", "https://www.ti.com/product/LMR51430"),
    "Z7": ("TI INA226", "https://www.ti.com/product/INA226"),
    "Z8": ("TI INA186", "https://www.ti.com/product/INA186"),
    "Z9": ("MicoAir743v2-AIO-45A", "https://micoair.com/flightcontroller_micoair743v2_aio_45a/"),
    "Z10": ("KiCad 10, standardní knihovny", "https://www.kicad.org/libraries/"),
    "Z11": ("BETAFPV Pavo20 Pro II frame", "https://betafpv.com/products/pavo20-pro-ii-brushless-whoop-frame"),
    "Z12": ("spec/10_pavo20.md, termika (DJI O3 12–16 W)", ""),
    "Z13": ("spec/11_kusovnik_pavo20.md (Lite+ 3–12,6 V)", ""),
    "Z14": ("spec/15_test_linky_skenu.md (LD19, D500)", ""),
    "Z15": ("Goertek SPL06-001", "https://media.digikey.com/pdf/Data%20Sheets/Goertek%20Microelectronics%20PDFs/SPL06-001.pdf"),
    "Z16": ("Infineon DPS310", "https://files.seeedstudio.com/products/101020812/res/DPS310-datasheet.pdf"),
    "Z17": ("Bosch BMI088 rev 1.9", "https://www.bosch-sensortec.com/media/boschsensortec/downloads/datasheets/bst-bmi088-ds001.pdf"),
    "Z18": ("YXC X32258MOB4SI, JLC C2682775", "https://jlcpcb.com/partdetail/2777872-X32258MOB4SI/C2682775"),
    "Z19": ("ST DS12110, STM32H743 datasheet", "https://cdn.sparkfun.com/assets/e/4/e/c/a/STM32H743VI_Datasheet.pdf"),
    "Z20": ("MicoAir MTF-02P", "https://micoair.com/optical_range_sensor_mtf-02p/"),
    "Z21": ("Caddx WS-M181", "https://www.caddxfpv.com/products/walksnail-ws-m181gps"),
    "Z22": ("RadioMaster XR1 Nano, manuál", "https://images.amainhobbies.com/images/resources/RM-BR0157.XR1-900/Manuals/1-RM-BR0157.XR1-900_RadioMaster_XR1_Nano_Multi-Frequency_ELRS_Receiver%20-%20Manual.pdf"),
    "Z27": ("ArduPilot: MicoAir743-AIO, README a obrázek portů", "https://github.com/ArduPilot/ardupilot/tree/8b9ea70/libraries/AP_HAL_ChibiOS/hwdef/MicoAir743-AIO"),
    "Z23": ("ArduPilot AP_Notify: PixRacerLED.cpp, Buzzer.cpp", "https://github.com/ArduPilot/ardupilot/tree/8b9ea70/libraries/AP_Notify"),
    "Z24": ("XINGLIGHT XL-1005SURC, JLC C965790", "https://jlcpcb.com/partdetail/XINGLIGHT-XL1005SURC/C965790"),
    "Z25": ("AP1606, JLC C2849580", "https://jlcpcb.com/partdetail/C2849580"),
    "Z28": ("TI TPS22810 SLVSDH0C", "https://www.ti.com/lit/ds/symlink/tps22810.pdf"),
    "Z29": ("TDK ICM-42688-P DS-000347",
            "https://product.tdk.com/system/files/dam/doc/product/sensor/mortion-inertial/imu/data_sheet/ds-000347-icm-42688-p-v1.6.pdf"),
}

STAVY = {
    "prevzato": ("převzato", "zkopírované z vyrobeného návrhu beze změny"),
    "dokument": ("podle dokumentu", "nakreslené podle datasheetu, aplikační poznámky nebo hwdefu"),
    "volba": ("naše volba", "rozhodli jsme sami, důvod je u bloku"),
    "otevrene": ("otevřené", "nenakreslené, rozhodne se ručně"),
}

LISTY = [
    {
        "id": "koren", "nazev": "Kořen", "svg": "aio.svg", "soubor": "aio.kicad_sch",
        "uvod": "Vstup baterie, měření proudu všech ESC, obrys desky s pady a odkazy na ostatní listy. "
                "Klikni na rámeček listu a přejdeš na něj.",
        "bloky": [
            dict(id="obrys", refs=["U24"], stav="prevzato", nazev="Obrys desky, pady baterie a motorů",
                 kratce="U24 z OpenAIO. Pady sedí, rozměr a díry je potřeba upravit.",
                 co="Footprint `lib:AIO_outline` nese obrys desky, díry a pady: 1 baterie +, 2 GND, 11 díry na GND, 12–23 fáze motorů (1A–4C).",
                 proc="Pady jsou součást obrysu, aby seděly s převzatým layoutem ESC. Fáze vedou do listů ESC přes sítě 1A–4C.",
                 jak="Převzato z OpenAIO [Z1] beze změny: 35,4 × 35,4 mm, díry ⌀3 na 25,5 × 25,5. Rám Pavo20 má 26 × 26 [Z11], šroub M2 projde s rezervou 0,15 mm jako u MicoAiru [Z9]. Oválné díry by zasáhly 8 prokovů přívodu baterie.",
                 zdroje=["Z1", "Z9", "Z11"]),
            dict(id="proud", refs=["Rsense2", "U25", "C104", "TP13"], stav="prevzato", nazev="Proud všech ESC",
                 kratce="Shunt 0,2 mΩ a INA186A3: 20 mV/A do ADC H743.",
                 co="Rsense2 0,2 mΩ (2512) v přívodu baterie, U25 INA186A3 se zesílením 100 V/V, výstup ESC_CURRENT, testovací bod TP13.",
                 proc="ArduPilot potřebuje proud pro failsafe a odhad kapacity. 0,2 mΩ × 100 = 20 mV/A, při 3,3 V na ADC to je 165 A rozsah.",
                 jak="Převzato z OpenAIO [Z1], zapojení podle TI INA186 [Z8]. V hwdefu `HAL_BATT_CURR_SCALE 50.0` (A/V), pin PC1.",
                 zdroje=["Z1", "Z8"]),
            dict(id="tp", refs=["TP20", "TP21", "TP22", "TP23"], stav="prevzato", nazev="Testovací body DShot",
                 kratce="MOTOR1–4 na testovacích bodech pro osciloskop.",
                 co="TP20–TP23 na sítích MOTOR1–MOTOR4 mezi H743 a vstupy ESC.",
                 proc="Při oživení se na nich ověří, že H743 posílá DShot a ESC odpovídá (bidirectional DShot).",
                 jak="Převzato z OpenAIO [Z1].", zdroje=["Z1"]),
        ],
    },
    {
        "id": "esc", "nazev": "ESC", "svg": "aio-ESC1.svg", "soubor": "esc_channel.kicad_sch",
        "uvod": "Jeden kanál ESC, na desce je čtyřikrát (ESC1–ESC4, stejný list). Reference platí pro ESC1, "
                "ostatní mají vlastní čísla. Převzato beze změny z OpenAIO, původem OpenESC-20x20.",
        "bloky": [
            dict(id="at32", refs=["U13", "C37", "C38", "C39", "R37", "R38", "R40", "TP1", "TP2"], stav="prevzato",
                 nazev="Procesor ESC AT32F421 (AM32)",
                 kratce="AT32F421G8U7 s firmwarem AM32, stejný čip jako MicoAir.",
                 co="U13 AT32F421G8U7, blokování, R40 + C38 filtr VDDA, R37/C37 reset, R38 BOOT0, TP1/TP2 SWD pro nahrání AM32.",
                 proc="AM32 je otevřený firmware ESC s bidirectional DShot. MicoAir AIO má stejný procesor (firmware AM32_F4A_4IN1_F421) [Z9], OpenESC má hotový target OPENESC_20 [Z2].",
                 jak="Převzato z OpenAIO / OpenESC [Z1][Z2] beze změny.", zdroje=["Z1", "Z2", "Z9"]),
            dict(id="dshot", refs=["R39"], stav="prevzato", nazev="Vstup DShot",
                 kratce="MOTORn z H743 přes 220 Ω na PB4 AT32.",
                 co="R39 220 Ω mezi sítí MOTOR1 a PB4 procesoru ESC.",
                 proc="Sériový rezistor tlumí odrazy a chrání piny obou procesorů, když se DShot otáčí na obousměrný.",
                 jak="Převzato [Z1].", zdroje=["Z1"]),
            dict(id="budic", refs=["U14", "C40", "C41", "C42", "C43"], stav="prevzato", nazev="Budič NSG2065Q",
                 kratce="Trojfázový budič hradel, napájený z +10V.",
                 co="U14 NSG2065Q, bootstrap kondenzátory C40–C42 pro horní MOSFETy, C43 na +10V.",
                 proc="Budič potřebuje 8–20 V, proto existuje větev +10V v listu Power, a ta se nesmí vypínat [Z1].",
                 jak="Převzato [Z1][Z2].", zdroje=["Z1", "Z2"]),
            dict(id="mosfety", refs=["Q3", "Q4", "Q5", "Q6", "Q7", "Q8", "R35", "R36", "R41", "R42", "R43", "R44"],
                 stav="prevzato", nazev="Můstek 6× DOY180N03T",
                 kratce="Tři půlmosty, 30V MOSFETy, hradlové rezistory 15 Ω.",
                 co="Q3–Q8 DOY180N03T (PowerDI3333-8), R35/R36/R41–R44 15 Ω do hradel. Výstupy jsou fáze 1A, 1B, 1C.",
                 proc="Na 4S LiHV (17,4 V) mají 30V MOSFETy rezervu. Je to holý můstek bez paralelních kusů, menší už být nemůže, proto se nezmenšuje na potřebných 10 A.",
                 jak="Převzato [Z1][Z2]. OpenESC je vyrobený a v prodeji.", zdroje=["Z1", "Z2"]),
            dict(id="bemf", refs=["R45", "R46", "R47", "R48", "R49", "R50", "R51", "R52", "R53"], stav="prevzato",
                 nazev="Zpětné EMF",
                 kratce="Děliče 10k/1k z fází do komparátoru AT32.",
                 co="R45–R53: dělič každé fáze (FBA, FBB, FBC) a společný bod FBCOMMON.",
                 proc="AM32 bez senzorů pozná polohu rotoru z napětí volné fáze. Dělič ho stáhne do rozsahu 3,3 V.",
                 jak="Převzato [Z1][Z2].", zdroje=["Z1", "Z2"]),
            dict(id="bulk", refs=["C90", "C91", "C92"], stav="prevzato", nazev="Kondenzátory na +BATT",
                 kratce="Keramika u můstku, hodnota v OpenAIO nevyplněná.",
                 co="C90–C92 na +BATT u MOSFETů (0805).",
                 proc="Krátké proudové špičky můstku se berou z nich, ne z kabelu baterie.",
                 jak="Převzato [Z1]. OpenAIO u nich nemá hodnotu ani LCSC (`AGENTS.md`), doplnit.",
                 zdroje=["Z1"]),
        ],
    },
    {
        "id": "power", "nazev": "Napájení", "svg": "aio-Power.svg", "soubor": "fc_power.kicad_sch",
        "uvod": "Převzato beze změny z OpenAIO, původem OpenFC-Lite-Mini. Z baterie dělá +10V pro budiče ESC, "
                "+5V a z nich 3,3 V a 1,8 V. Spínaná větev pro VTX je v listu VTX.",
        "bloky": [
            dict(id="b10", ramecek="U3", refs=["U3", "L2", "C18", "C20", "C23", "R17", "R18", "R21", "D4"], stav="prevzato",
                 nazev="+10V pro budiče ESC",
                 kratce="LMR51430, 9,84 V, stále zapnutý.",
                 co="U3 LMR51430, L2 4,7 µH, dělič R17 100k / R18 6,49k → 9,84 V, C18 4,7 µF 50 V na vstupu, C23 22 µF na výstupu, LED D4.",
                 proc="Budiče NSG2065Q chtějí 8–20 V. Větev je stále zapnutá, protože bez ní nejedou motory. VTX z ní bere proud až za spínačem v listu VTX, takže jde vypnout sám.",
                 jak="Převzato [Z1][Z3], LMR51430 do 36 V a 3 A [Z6].", zdroje=["Z1", "Z3", "Z6"]),
            dict(id="b5", ramecek="U4", refs=["U4", "L3", "C19", "C21", "C24", "R19", "R20", "R22", "D5", "TP30"], stav="prevzato",
                 nazev="+5V, 3 A",
                 kratce="LMR51430, 4,98 V pro periferie a lidar.",
                 co="U4 LMR51430, L3 4,7 µH, dělič R19 100k / R20 13,7k → 4,98 V, C19 4,7 µF 50 V na vstupu, C24 22 µF, LED D5, TP30.",
                 proc="Napájí LD06/D500 (rozběh 540 mA [Z14]), GPS, MTF-02P, přijímač a přes +4v5 celou logiku. 3 A je víc než 2 A na MicoAiru [Z9].",
                 jak="Převzato [Z1][Z3].", zdroje=["Z1", "Z3", "Z6", "Z14"]),
            dict(id="or", ramecek="D2", refs=["D2", "D3", "C25", "C26", "C102", "C103", "C105", "C106"], stav="prevzato", nazev="USB nebo baterie → +4v5",
                 kratce="Dvě Schottkyho diody, USB napájí logiku bez baterie.",
                 co="D2 z +5V, D3 z +5V_USB (konektor v listu MCU), společně +4v5, C25/C26 blokování. V rámečku jsou i C102–C106 na +BATT (hodnota v OpenAIO nevyplněná).",
                 proc="Na stole jde H743 napájet z USB. Diody brání tomu, aby USB tlačilo proud do +5V a do periferií.",
                 jak="Převzato [Z1].", zdroje=["Z1"]),
            dict(id="ldo33", ramecek="U7", refs=["U7", "C28", "R24", "D6"], stav="prevzato", nazev="+3.3V, 1 A",
                 kratce="TLV76733 z +4v5 pro H743, AT32 a senzory.",
                 co="U7 TLV76733 (1 A), C28 22 µF, LED D6.",
                 proc="Jedna 3,3V větev pro H743, čtyři AT32F421, INA186 a IO BMI270.",
                 jak="Převzato [Z1].", zdroje=["Z1"]),
            dict(id="ldo18", ramecek="U6", refs=["U6", "C27", "R23", "D7"], stav="prevzato", nazev="+1.8V pro gyro",
                 kratce="LP5912-1.8, oddělené tiché napájení BMI270.",
                 co="U6 LP5912-1.8, C27 22 µF, R23 a D7 na PG.",
                 proc="Šum z napájení se v gyru projeví jako šum v úhlové rychlosti. Vlastní nízkošumové LDO ho odděluje.",
                 jak="Převzato [Z1].", zdroje=["Z1"]),
        ],
    },
    {
        "id": "imu", "nazev": "IMU", "svg": "aio-IMU.svg", "soubor": "fc_imu.kicad_sch",
        "uvod": "BMI270 na SPI, převzato beze změny z OpenAIO. K H743 je připojený podle hwdefu MicoAiru.",
        "bloky": [
            dict(id="bmi", refs=["U8", "C29", "C30", "R25"], stav="prevzato", nazev="BMI270",
                 kratce="Gyroskop a akcelerometr na SPI3, CS PA15, INT1 PB7.",
                 co="U8 BMI270, VDD z +1.8V_GYRO, VDDIO z +3.3V, R25 pull-up na CS. INT2 (pin CLKIN listu) je nezapojený.",
                 proc="ArduPilot BMI270 umí a MicoAir ho má jako druhou IMU [Z5][Z9]. Na SPI3 jsou stejné piny jako na MicoAiru, takže hwdef zůstane.",
                 jak="Převzato [Z1], připojení podle hwdefu [Z5]. Orientaci zapsat do hwdefu podle layoutu.",
                 zdroje=["Z1", "Z5", "Z9"]),
        ],
    },
    {
        "id": "vtx", "nazev": "VTX a LD06", "svg": "aio-VTX a LD06.svg", "soubor": "vtx.kicad_sch",
        "uvod": "Nový list: spínaných 10 V pro video vysílač dimenzovaných na DJI O3/O4, "
                "konektor HD VTX s pinoutem DJI a pady lidaru.",
        "bloky": [
            dict(id="buck", refs=["C201", "U201", "C202", "C203"], stav="dokument",
                 nazev="Spínač 10 V pro VTX",
                 kratce="TPS22810 za +10V z U3: 3 A, 79 mΩ. DJI O3 bere 1,6 A.",
                 co="U201 TPS22810DRVR (WSON 2 × 2), vstup +10V s C201 1 µF, výstup +10V_VTX s C203 22 µF, C202 4,7 nF na CT, QOD spojený s VOUT.",
                 proc="+10V z listu Power napájí budiče ESC a vypínat se nesmí, proto se odpíná jen VTX. Tak to má i OpenAIO, jen bez spínače. CT dává náběh ~0,8 ms, aby náraz do kondenzátorů VTX nesrazil +10V pod budiči. QOD vybije výstup po vypnutí. Do 18. 10. tu byla kopie bucku U3, ale s cívkou 3 × 3 mm se nevešla na desku.",
                 jak="Zapojení a tabulka náběhu podle datasheetu [Z28], tepelná ploška na GND jako na EVM TI. 10 V z U3 [Z1] je v rozsahu Lite+ [Z13] i DJI [Z12].", zdroje=["Z28", "Z1", "Z12", "Z13"]),
            dict(id="en", refs=["R203", "R204"], stav="volba", nazev="Zapínání VTX",
                 kratce="Výchozí vypnuto, H743 zapíná přes PD13.",
                 co="R204 100k stahuje EN k zemi, R203 1k z VTX_EN (PD13).",
                 proc="VTX se bez ofuku přehřívá, takže na stole má jít vypnout. V ArduPilotu `RELAY1_PIN 57`, `RELAY1_DEFAULT 1`, takže po startu je zapnutý. Propojka pro trvalé zapnutí se na desku nevešla a MicoAir ji nemá.",
                 jak="Naše volba. Práh EN 1,23 V podle datasheetu TPS22810 [Z28].", zdroje=["Z28"]),
            dict(id="j201", refs=["J201", "JP202"], stav="dokument", nazev="Konektor HD VTX",
                 kratce="SH1.0-6P s pinoutem DJI: O3/O4 přímo, Lite+ přes redukci.",
                 co="1 +10V_VTX, 2 GND, 3 VTX_TX (PA2), 4 VTX_RX (PA3), 5 GND, 6 SBUS z DJI přes propojku JP202 na RC_RX (PC7). JP202 je standardně rozpojená.",
                 proc="Stejný pinout mají MicoAir [Z5] i OpenAIO [Z1], takže sedí kabely ke všem DJI jednotkám. Lite+ má 4pinový konektor a potřebuje redukci 6P → 4P, pořadí ověřit multimetrem. RX6 patří přijímači XR1. Kdyby na něj byl natvrdo připojený i pin 6, dva vysílače by se na jedné lince praly, proto propojka.",
                 jak="Pinout DJI podle hwdefu a OpenAIO.", zdroje=["Z5", "Z1"]),
            dict(id="j202", refs=["TP201", "TP202", "R206"], stav="dokument", nazev="Pady LD06 / D500",
                 kratce="ZH1.5-4P: Tx → UART5 RX, PWM přes 0R na zem.",
                 co="TP201 Tx lidaru → LIDAR_TX (PB5), TP202 PWM, 5V a GND z padů TP320/TP321. R206 0R uzemňuje PWM.",
                 proc="Jako u MicoAiru na pady: konektor ZH1.5 se na desku nevešel. PWM musí být uzemněné, pokud se otáčky neřídí. Bez R206 je řídí H743 přes LIDAR_PWM (PB0, časovač TIM3).",
                 jak="Pinout podle manuálu LD19 [Z14].", zdroje=["Z14"]),
        ],
    },
    {
        "id": "mcu", "nazev": "MCU H743", "svg": "aio-MCU H743.svg", "soubor": "mcu_h743.kicad_sch",
        "uvod": "STM32H743VIH6 s krystalem, barometrem, druhou IMU a microSD, podle AN4938, datasheetů a hwdefu "
                "MicoAiru, konektory periferií, RGB LED a spínač bzučáku.",
        "bloky": [
            dict(id="u301", refs=["U301"], stav="dokument", nazev="STM32H743VIH6",
                 kratce="TFBGA-100, piny podle hwdefu MicoAir743v2. Klikni pro mapu pinů.",
                 co="U301, symbol a footprint ze standardní knihovny KiCadu (TFBGA-100 8 × 8 mm, rozteč 0,8 mm). Každý pin má štítek s funkcí.",
                 proc="Stejný čip i piny jako MicoAir [Z9][Z5]. Vlastní hwdef pak vznikne úpravou jeho hwdefu, ne od nuly. TFBGA se vejde na místo jádra OpenAIO, LQFP-100 ne.",
                 jak="Kuličky ze symbolu KiCadu [Z10], ne přepsané ručně. Funkce pinů z hwdefu [Z5].",
                 zdroje=["Z5", "Z9", "Z10"], piny=True),
            dict(id="blok", refs=[f"C{n}" for n in range(301, 314)], stav="dokument", nazev="Blokování napájení",
                 kratce="100 nF na každý VDD, 4,7 µF, VCAP 2× 2,2 µF, VDDA a USB 100 nF + 1 µF.",
                 co="C301–C303 100 nF (VDD D2, F5, K1), C304 4,7 µF, C305 4,7 µF (VDDLDO), C306/C307 2,2 µF (VCAP1+VCAP2 spojené), C308/C309 VDDA, C310/C311 VDD33USB, C312 VBAT, C313 NRST.",
                 proc="Přesně podle AN4938 kap. 2.2. VCAP jsou výstupy vnitřního LDO jádra a bez 2,2 µF s nízkým ESR čip nenaběhne. ERC hlásí spojené VCAP jako chybu, je to ale doporučené zapojení.",
                 jak="ST AN4938 [Z4].", zdroje=["Z4"]),
            dict(id="boot", refs=["R301", "R302"], stav="dokument", nazev="BOOT0 a PDR_ON",
                 kratce="BOOT0 10k na zem, PDR_ON 10k na 3,3 V, DFU spojením TP301–TP302.",
                 co="R302 drží BOOT0 dole (start z flash). R301 drží PDR_ON nahoře (vnitřní napěťový dozor zapnutý). Pady TP301 BOOT0 a TP302 +3.3V jsou u SWD.",
                 proc="DFU je potřeba jen pro první nahrání bootloaderu ArduPilotu. Pak se flashuje přes USB a tlačítko je zbytečná váha.",
                 jak="AN4938 kap. 5.2 a tab. 9 [Z4].", zdroje=["Z4"]),
            dict(id="swd", refs=["TP301", "TP302", "TP303", "TP304", "TP305", "TP306"], stav="dokument", nazev="SWD a DFU",
                 kratce="Pady pro ST-Link a BOOT0 pro první nahrání přes DFU.",
                 co="TP301 BOOT0, TP302 +3.3V, TP303 SWDIO (PA13), TP304 SWCLK (PA14), TP305 NRST, TP306 GND. DFU: spojit TP301 s TP302 při zapnutí.",
                 proc="Záchrana, když se nepovede bootloader, a ladění při oživení.",
                 jak="Piny podle hwdefu [Z5].", zdroje=["Z5"]),
            dict(id="vbat", refs=["R303", "R304", "C314"], stav="dokument", nazev="Napětí baterie",
                 kratce="Dělič 100k/10k do PC0, BATT_VOLT_MULT 11.",
                 co="R303 100k z +BATT, R304 10k k zemi, C314 100 nF, výstup VBAT_SENSE do PC0 (ADC1).",
                 proc="Při 25,2 V (6S) je na pinu 2,29 V, bezpečně pod 3,3 V. Pro 4S zbývá rozlišení dost. V hwdefu `HAL_BATT_VOLT_SCALE 11.0`.",
                 jak="Dělič jako OpenAIO [Z1], pin podle hwdefu [Z5].", zdroje=["Z1", "Z5"]),
            dict(id="i2c", refs=["R305", "R306"], stav="volba", nazev="Pull-upy I2C2",
                 kratce="2,2k na SDA a SCL vnitřní sběrnice.",
                 co="R305, R306 2,2k na +3.3V. Na I2C2 (PB11/PB10, v ArduPilotu bus 0) je baro.",
                 proc="I2C potřebuje pull-upy právě jednou na sběrnici. 2,2k je obvyklá hodnota pro 400 kHz s krátkými spoji.",
                 jak="Naše volba, piny podle hwdefu [Z5].", zdroje=["Z5"]),
            dict(id="usb", refs=["J301", "R307", "R308"], stav="prevzato", nazev="USB-C",
                 kratce="Konektor a 5,1k na CC z OpenAIO, D+/D− přímo na PA12/PA11.",
                 co="J301 TYPE-C 16P (C5187472), R307/R308 5,1k na CC1/CC2, VBUS → +5V_USB → D3 v listu Power.",
                 proc="5,1k na CC je podmínka, aby USB-C zdroj vůbec pustil 5 V. Sériové 30 Ω z OpenAIO jsou vynechané, patřily k RP2354, OTG_FS je nepotřebuje.",
                 jak="Převzato z OpenAIO [Z1], piny podle hwdefu [Z5].", zdroje=["Z1", "Z5"]),
            dict(id="krystal", refs=["Y301", "C322", "C323"], stav="volba", nazev="Krystal 8 MHz",
                 kratce="YXC X32258MOB4SI, CL 12 pF, kondenzátory 15 pF.",
                 co="Y301 8 MHz 3225 (C2682775) na PH0/PH1, C322 a C323 15 pF C0G k zemi.",
                 proc="ArduPilot čeká 8 MHz (`OSCILLATOR_HZ`). C = 2 × (CL − Cstray) = 2 × (12 − 5) = 14 → 15 pF. Strmost krystalu gm_crit ≈ 0,5 mA/V je pod mezí H743 1,5 mA/V. S krystalem 20 pF by vyšla přes 1 mA/V, proto nízké CL.",
                 jak="Výpočet podle AN4938 a AN2867 [Z4], mez Gmcritmax z datasheetu H743 [Z19], krystal [Z18].",
                 zdroje=["Z4", "Z18", "Z19"]),
            dict(id="baro", refs=["U302"], dalsi=["C317"], stav="dokument", nazev="Barometr SPL06 nebo DPS310",
                 kratce="Jedna ploška pro oba, I2C na 0x77. Osadí se podle skladu.",
                 co="U302 v pouzdru LGA-8 2 × 2,5 mm (symbol a footprint BMP280, stejné piny), CSB a SDO na 3,3 V → I2C s adresou 0x77, C317 blokování.",
                 proc="Obě čidla mají stejné pouzdro, piny i adresy a stejnou relativní přesnost ±0,06 hPa. DPS310 má o něco menší šum. Mají ale i stejné ID čipu, takže ArduPilot je nerozezná: v hwdefu je SPL06 (jako MicoAir), pro DPS310 se vymění jedna řádka.",
                 jak="Datasheety SPL06-001 [Z15] a DPS310 [Z16], ovladače AP_Baro [Z5].", zdroje=["Z15", "Z16", "Z5"]),
            dict(id="icm", refs=["U303"], dalsi=["C318", "C319", "C324"], stav="dokument", nazev="Druhá IMU ICM-42688-P",
                 kratce="SPI2 jako MicoAir, pouzdro 2,5 × 3 mm jako BMI270.",
                 co="U303 ICM-42688-P: SDO → MISO, CS PD4, INT1 → PC14. RESV a FSYNC na GND. VDD 100 nF + 2,2 µF, VDDIO 10 nF.",
                 proc="Dvě IMU dávají EKF zálohu. MicoAir tu má BMI088, ale ten (4,5 × 3 mm) se na desku nevešel. ICM-42688-P sedí na stejný footprint „universal IMU“ jako BMI270 a je od jiného výrobce, takže obě IMU nemají společnou vadu.",
                 jak="Piny a blokování podle datasheetu, tab. 9 a 10 [Z29], SPI2 podle hwdefu [Z5]. ArduPilot: IMU Invensensev3.", zdroje=["Z29", "Z5"]),
            dict(id="sd", refs=["J302"], dalsi=["R309", "R310", "R311", "R312", "R313", "C320", "C321"], stav="dokument",
                 nazev="microSD",
                 kratce="Slot z OpenAIO na 4bitovém SDMMC1, pull-upy 47k.",
                 co="J302 TF-021B-H265 (C498185), R309–R313 47k na CMD a D0–D3, C320 100 nF a C321 4,7 µF na napájení karty.",
                 proc="Logy se bez karty neladí. SDMMC jako MicoAir je rychlé a hwdef ho už má. Specifikace SD chce pull-upy 10–100k na CMD a datech.",
                 jak="Slot převzatý z OpenAIO [Z1], piny podle hwdefu [Z5].", zdroje=["Z1", "Z5"]),
            dict(id="periferie", refs=["J303", "R314", "R315", "J304", "J305"], dalsi=[f"TP{n}" for n in range(313, 322)],
                 stav="dokument", nazev="Konektory a pady periferií",
                 kratce="Konektory jako MicoAir: GPS, UART4, UART1+UART6. Pady UART8 a volných PWM.",
                 co="J303 GPS (1 GND, 2 5V, 3 TX3, 4 RX3, 5 SCL, 6 SDA), J304 UART4 pro MTF-02P (1 GND, 2 5V, 3 TX4, 4 RX4), J305 UART1+UART6 pro přijímač a telemetrii (1 GND, 2 5V, 3 TX1, 4 RX1, 5 TX6, 6 RX6), vše SH1.0 boční. R314/R315 pull-upy externí I2C. Pady TP313–TP321: UART8, PWM5, 7, 9, 10, 11, 5V a GND.",
                 proc="Stejné konektory a pořadí jako MicoAir743-AIO, aby seděly kabely z něj. Pin 1 = GND podle README ArduPilotu (u DJI je pin 1 = 12 V, poslední řádek tabulky). J303 a J305 se zatím na desku nevešly. Před prvním zapnutím ověřit pin 1 multimetrem.",
                 jak="Obrázek portů MicoAir743-AIO v ArduPilotu [Z27], MTF-02P [Z20], piny UARTů z hwdefu [Z5].",
                 zdroje=["Z27", "Z20", "Z5"]),
            dict(id="led", refs=["D301", "D302", "D303", "R316", "R317", "R318"], stav="dokument", nazev="RGB LED",
                 kratce="Tři LED 0402 svítící nulou, jak je ArduPilot řídí.",
                 co="D301 červená XL-1005SURC s R316 330R, D302 zelená XL-1005UGC s R317 150R, D303 modrá XL-1005UBC s R318 75R. Anody na 3,3 V, katody na PE3, PE2, PE4.",
                 proc="ArduPilot zapíná GPIO_LED_RGB nulou (HAL_GPIO_LED_ON 0), stejně jako na MicoAiru. Zelená a modrá jsou díly z OpenAIO, červená ze stejné řady. Proud 3–5 mA na barvu, mez pinu je 20 mA.",
                 jak="Polarita ze zdrojáků AP_Notify [Z23], díly XINGLIGHT [Z24].", zdroje=["Z23", "Z24"]),
            dict(id="bzucak", refs=["Q301", "R319", "TP322", "TP323"], stav="dokument", nazev="Spínač bzučáku",
                 kratce="AP1606 spíná aktivní 5V bzučák na padech BZ+ a BZ−.",
                 co="Q301 AP1606 (DFN 1,0 × 0,6 mm) mezi BZ− a zemí, hradlo z PD15, R319 100k ho drží vypnutý. Pady TP322 BZ+ (5 V) a TP323 BZ−.",
                 proc="BUZZ_ON_LVL je ve výchozím stavu 1, takže stačí spínač k zemi. Na desku se SMD bzučák nevejde, proto pady jako u MicoAiru. AP1606 je tranzistor z OpenAIO, sepne od 1,2 V; SOT-23 (AO3400A) se nevešel, 2N7002 by z 3,3 V spínal nejistě. Piezo bzučák diodu nepotřebuje.",
                 jak="Úroveň ze zdrojáků AP_Notify [Z23], MOSFET podle parametrů JLC [Z25].", zdroje=["Z23", "Z25"]),
        ],
    },
]

# odkazy z kořene na listy: název listu ve schématu → id stránky
ODKAZY = {"ESC1": "esc", "ESC2": "esc", "ESC3": "esc", "ESC4": "esc", "Power": "power", "IMU": "imu",
          "VTX a LD06": "vtx", "MCU H743": "mcu"}
