phageweb/dron/scripts/check_leaning_scan.py

#!/usr/bin/env python3
"""Assert that a leaning vehicle's front scan is the floor, and is rejected.

`scan_helpers` learned to drop returns that are really the ground, because the
LD06 is bolted to the airframe and leaning points its forward beams downwards.
That was written against unit tests. The flying check, `check_forward_flight.sh`,
cruises at 1 m with a gentle attitude, so the floor stays out of range there and
the rejection is never exercised by anything Gazebo produced.

This runs against `leaning_test.sdf`, where the model is held static at 30
degrees nose-down, 0.60 m up. It reads the scan the simulated lidar actually
publishes and asserts both halves of the property:

  * the raw forward sector is inside the demo's stop threshold, so an
    uncompensated vehicle would stop dead for the floor
  * with the attitude and the measured height applied, nothing in that sector
    is left, so the compensated vehicle has no obstacle to stop for

The second without the first would pass over an empty scan, which is why the
raw reading is asserted rather than only printed.
"""

import math
import sys

import rclpy
from geometry_msgs.msg import PoseStamped
from rclpy.node import Node
from rclpy.qos import qos_profile_sensor_data
from sensor_msgs.msg import LaserScan, Range

from openipc_cinewhoop_demo.scan_helpers import (
    compensation_height,
    nearest_in_sector,
    roll_pitch_from_quaternion,
)

SCAN_TOPIC = "/openipc_cinewhoop/scan/front"
RANGE_TOPIC = "/openipc_cinewhoop/range/down"
POSE_TOPIC = "/ap/pose/filtered"

# simple_indoor_autonomy's own defaults: 0.80 m of wanted clearance plus the
# 0.60 m it takes to stop from 0.5 m/s. A return closer than this is one the
# demo stops for.
STOP_THRESHOLD_M = 0.80 + 0.60
FORWARD_SECTOR_DEG = 60.0
GROUND_MARGIN_M = 0.25
# The demo nodes' own defaults, which check_model_consistency.py holds to the
# model: where the front lidar sits relative to the rangefinder.
LIDAR_AHEAD_M = 0.026
LIDAR_ABOVE_M = 0.066
# Nothing useful can be said about a scan taken while the vehicle is level; the
# whole point is the lean, so a pose that is not leaning is a setup failure.
# Measured as the total tilt off vertical rather than per axis, because a world
# may put the lean in roll, in pitch, or in both.
MIN_LEAN_DEG = 20.0
# How far the corrected height may sit from where Gazebo says the sensor is.
# The simulated rangefinder quantises to its 0.01 m range resolution and reads
# the nearest point of a 2 degree cone rather than a single ray, so a centimetre
# is the most the simulator can be held to.
HEIGHT_TOLERANCE_M = 0.015


class LeaningScanCheck(Node):
    def __init__(self):
        super().__init__("check_leaning_scan")
        self.scan = None
        self.slant = None
        self.pose = None
        self.create_subscription(
            LaserScan, SCAN_TOPIC, self._keep_scan, qos_profile_sensor_data)
        self.create_subscription(
            Range, RANGE_TOPIC, self._keep_range, qos_profile_sensor_data)
        self.create_subscription(
            PoseStamped, POSE_TOPIC, self._keep_pose, qos_profile_sensor_data)

    def _keep_scan(self, msg):
        self.scan = msg

    def _keep_range(self, msg):
        self.slant = (msg.range
                      if msg.min_range <= msg.range <= msg.max_range
                      else None)

    def _keep_pose(self, msg):
        q = msg.pose.orientation
        self.pose = roll_pitch_from_quaternion(q.x, q.y, q.z, q.w)

    def complete(self):
        return self.scan is not None and self.slant is not None and self.pose


def nearest_bearing(scan, sector_rad):
    """Where in the sector the nearest return is, which roll makes asymmetric.

    Printed rather than asserted: the world file says which side its floor
    arrives on, and a reader comparing the two is better served by the number
    than by this script repeating the world's own arithmetic.
    """
    best = None
    for index, value in enumerate(scan.ranges):
        if not math.isfinite(value) or not scan.range_min <= value <= scan.range_max:
            continue
        angle = scan.angle_min + index * scan.angle_increment
        angle = (angle + math.pi) % (2 * math.pi) - math.pi
        if abs(angle) > sector_rad / 2.0:
            continue
        if best is None or value < best[0]:
            best = (value, angle)
    return None if best is None else best[1]


def main():
    # Where the simulator says the downward sensor is, in metres above the floor
    # surface, passed in by the shell that has Gazebo to ask. Optional so the
    # check still runs, with that one assertion skipped, without it.
    true_height = float(sys.argv[1]) if len(sys.argv) > 1 else None
    # A world that means to test the roll term says so, so that zeroing its roll
    # fails here rather than passing as a second pitched-only run.
    min_roll_deg = float(sys.argv[2]) if len(sys.argv) > 2 else 0.0

    rclpy.init()
    node = LeaningScanCheck()
    deadline = node.get_clock().now().nanoseconds + 40e9
    while rclpy.ok() and not node.complete():
        if node.get_clock().now().nanoseconds > deadline:
            missing = [name for name, value in
                       (("scan", node.scan), ("range", node.slant),
                        ("pose", node.pose)) if value is None]
            node.destroy_node()
            rclpy.shutdown()
            sys.exit(f"No {', '.join(missing)} within 40 s.")
        rclpy.spin_once(node, timeout_sec=0.5)

    scan, slant = node.scan, node.slant
    roll, pitch = node.pose
    node.destroy_node()
    rclpy.shutdown()

    # Two things separate what the rangefinder reports from what the rejection
    # needs. It measures along its own axis, so leaning it gives slant and not
    # height; and it is not the sensor being projected - the lidar sits ahead of
    # it and above it. compensation_height undoes both, and the result is
    # checked against where the simulator says the lidar is rather than against
    # the formula that produced it.
    height, reason, _ = compensation_height(
        0.0, 0.0, 1.0, slant, roll, pitch, LIDAR_AHEAD_M, LIDAR_ABOVE_M)
    if height is None:
        sys.exit(f"No height to compensate with: {reason}.")

    sector = math.radians(FORWARD_SECTOR_DEG)
    raw_bearing = nearest_bearing(scan, sector)
    raw = nearest_in_sector(
        scan.ranges, scan.angle_min, scan.angle_increment,
        scan.range_min, scan.range_max, sector)
    compensated = nearest_in_sector(
        scan.ranges, scan.angle_min, scan.angle_increment,
        scan.range_min, scan.range_max, sector,
        roll, pitch, height, GROUND_MARGIN_M)

    print(f"  attitude: roll {math.degrees(roll):.1f} deg "
          "(banking right is positive, and drops the right wing), "
          f"pitch {math.degrees(pitch):.1f} deg (nose down is positive)")
    print(f"  rangefinder reports {slant:.3f} m of slant; the lidar is "
          f"{height:.3f} m up"
          + (f", truth {true_height:.3f} m" if true_height is not None else ""))
    if raw_bearing is not None:
        side = ("straight ahead" if abs(math.degrees(raw_bearing)) < 1.0
                else "off the left" if raw_bearing > 0 else "off the right")
        print(f"  the nearest raw return is {side}, at "
              f"{math.degrees(raw_bearing):+.0f} deg")
    print(f"  nearest in the forward {FORWARD_SECTOR_DEG:.0f} deg sector: "
          f"raw {raw if raw is None else f'{raw:.3f} m'}, "
          f"compensated {compensated if compensated is None else f'{compensated:.3f} m'}")

    if true_height is not None and abs(height - true_height) > HEIGHT_TOLERANCE_M:
        sys.exit(f"The corrected height is {height:.3f} m where the simulator "
                 f"puts the lidar {true_height:.3f} m above the floor. The raw "
                 f"reading was {slant:.3f} m; if that is the closer of the two, "
                 "the lean is not being undone, and if the gap is about 66 mm "
                 "it is the offset between the two sensors.")
    if true_height is not None and abs(slant - true_height) <= HEIGHT_TOLERANCE_M:
        sys.exit(f"The raw reading {slant:.3f} m already matches the true "
                 f"{true_height:.3f} m, so this attitude does not exercise the "
                 "slant correction and the check proves nothing about it.")

    # acos(cos roll cos pitch) is the angle between the airframe's own up and
    # the world's, which is what "leaning" means when it is spread over two axes.
    lean = math.degrees(math.acos(
        max(-1.0, min(1.0, math.cos(roll) * math.cos(pitch)))))
    if lean < MIN_LEAN_DEG:
        sys.exit(f"The vehicle is only leaning {lean:.1f} deg; this check needs "
                 "it leaning to mean anything.")
    if abs(math.degrees(roll)) < min_roll_deg:
        sys.exit(f"This run asked for at least {min_roll_deg:.0f} deg of roll "
                 f"and the vehicle is rolled {math.degrees(roll):.1f} deg. "
                 "Without roll the drop is even in the bearing and the scan's "
                 "angular handedness goes untested.")
    if raw is None:
        sys.exit("The raw forward sector is empty, so the lidar is not seeing "
                 "the floor and there is nothing here to reject.")
    if raw >= STOP_THRESHOLD_M:
        sys.exit(f"The raw forward sector reports {raw:.3f} m, past the "
                 f"{STOP_THRESHOLD_M:.2f} m the demo stops at. An uncompensated "
                 "vehicle would not have stopped for this, so the check proves "
                 "nothing; lean it further or fly it lower.")
    if compensated is not None:
        sys.exit(f"The floor survived compensation as an obstacle at "
                 f"{compensated:.3f} m.")

    print("  the floor would have stopped the demo; compensation removed it")


if __name__ == "__main__":
    main()
