phageweb/dron/scripts/nakup_calc.py

# -*- coding: utf-8 -*-
"""Nakupni kalkulace dronu: CZ/EU (vc. Allegro) vs AliExpress, s dopravou.
Kurzy CNB 11. 9. 2026."""

EUR, USD, PLN = 24.260, 20.927, 5.609

def kc(v, cur="CZK"):
    return v * {"CZK":1.0, "EUR":EUR, "USD":USD, "PLN":PLN}[cur]

# --- DOPRAVA (Kc za zasilku) -------------------------------------------
# overeno = z webu obchodu; odhad = typicka sazba, uprav podle kosiku
SHIP = {
    "Aerodrone CZ":  (99,  "odhad"),
    "Rotorama CZ":   (89,  "overeno: 89 adresa / 59 Zasilkovna, bez limitu zdarma"),
    "FPV24 DE":      (kc(9.90,"EUR"),  "odhad z jejich AT tarifu <100 EUR"),
    "RCTech DE":     (kc(12.00,"EUR"), "odhad; LiPo jen pozemni prepravou"),
    "Rotorama EU":   (kc(9.90,"EUR"),  "odhad - a nize ukazu, ze ji nepotrebujes"),
    "Import CN":     (kc(20.00,"USD"), "odhad pro LD06 ze Sunhokey"),
    "AliExpress":    (kc(3.00,"EUR"),  "odhad na prodejce; casto 0, ale pomalu"),
    "Allegro PL":    (kc(20.00,"PLN"), "odhad; nekteri prodejci do CZ draz"),
}
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
