phageweb/dron/(commit log)

2026-09-09 feat: add cinewhoop description, Gazebo and demo ROS 2 packages
    openipc_cinewhoop_description carries the URDF/Xacro model, physical
    parameters and the RViz display launch; openipc_cinewhoop_gazebo carries
    the indoor test world, the SDF model with sensors and four aerodynamic
    rotor joints, the ros_gz_bridge configuration and the SITL launch;
    openipc_cinewhoop_demo carries obstacle_monitor, trajectory_publisher
    and simple_indoor_autonomy.
    The stop/forward decision lives in scan_helpers so it is unit-testable
    without a running ROS graph.
    Claude-Session: https://claude.ai/code/session_01YXTSiePsQ1eE1swED2hvgV
    [ardupilot_params.parm, dds_smoke.parm, indoor_test.sdf, model.sdf, openipc_cinewhoop.urdf.xacro]
2026-09-09 test: add repeatable simulation, SITL and DDS smoke checks
    Baseline checks run in CI: ROS graph, TF tree and headless Gazebo with
    the bridged sensor topics.
    The remaining checks are opt-in because they need the ignored local
    upstream builds under external/: standalone and Gazebo-connected SITL,
    the Micro XRCE-DDS Agent, AP_DDS topic/service discovery, and the full
    arm/mode/takeoff service sequence on both the custom cinewhoop and the
    unmodified Iris reference.
    scripts/microxrceddsgen drops the preallocation flag that ArduPilot's
    waf rule still passes but the current generator no longer accepts.
    Claude-Session: https://claude.ai/code/se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
    [takeoff.py]
2026-09-09 docs: record progress through DDS-commanded Iris takeoff
    Log milestones 1-9, the CI/CD pipeline description and the testing
    strategy. The backlog distinguishes verified work from the two open
    items: the headless front lidar emits no scan in this environment, and
    the custom cinewhoop accepts DDS takeoff but does not gain altitude.
    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
2026-09-09 test: close front-lidar and gz topic items via GZ_PARTITION fix
    Both open observations traced back to one cause. gazebo.launch.py pins the
    simulator and bridge to GZ_PARTITION=openipc_cinewhoop, and Gazebo Transport
    only discovers peers inside the same partition, so a CLI started from an
    ordinary shell sees an empty graph: gz topic -l returns 0 topics without the
    partition and 25 with it. This was read as a headless Transport limitation.
    check_front_lidar.sh needed no change and passes; three consecutive runs each
    reported the same 1.41 m nearest obstacle, and the bridged scan carries 61
    finite ranges consistent with the world geometry. The earlier failure was an
    orphaned takeoff.py still h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
2026-09-09 fix: correct reversed cinewhoop rotors so lift is not silently lost
    Reading joint_state during an armed SITL takeoff showed all four rotors
    turning the same way at about -1958 rad/s, while the model configures
    +1600/+1600/-1600/-1600. gz-sim-lift-drag-system skips a surface whose
    blade travels opposite its <forward> vector, so the two reversed rotors
    produced exactly zero force. Roughly half the thrust disappeared with
    nothing logged as an error anywhere in the stack, which is why the
    vehicle accepted takeoff and never moved.
    The rotors did not track their command because the plugin's velocity
    loop is explicit and a 3 in propeller has ~210x less inertia than the
    Iris rotor these numbers wer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
    [model.sdf]
2026-09-09 Revert rotor damping change and correct its diagnosis
    The reversed-rotor root cause was wrong. It rested on a joint_state
    sample taken 25 s after launch, when the airframe had already flipped
    and crashed. That reading is an artefact: it reports the same +-61.8
    rad/s alternation whatever rotor speed is configured.
    A virtual thrust stand settles it. With base_link on a vertical
    prismatic joint, attitude cannot change and a measured climb means the
    whole thrust path works. The unmodified model climbs to the 60 m stop by
    t=8.5 s under real ArduPilot control; the model with the damping and
    torque-ceiling change reaches only 16 m in 13.5 s. The change was
    unnecessary and made thrust worse, so mod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
    [model.sdf]
2026-09-09 Match ArduPilot output range to the model and record tuning findings
    MOT_PWM_MIN/MAX now match the SDF's 1100-1900 servo range. ArduPilot
    defaulted to 1000-2000, so below 1100 the plugin computed a negative
    rotor speed: a disarmed vehicle sat turning itself on the floor and
    failed the compass field check. MOT_THST_EXPO is 1.0 because the
    simulated thrust curve is exactly quadratic. The thrust stand check
    still measures a 60 m climb with these.
    MOT_THST_HOVER stays at its default deliberately. Thrust-to-weight is
    only 1.13, so real hover is near 94 % throttle, and recording that would
    entrench a number that must change once rotor speed is realistic.
    Seven tuning iterations did not reach con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
    [ardupilot_params.parm]
2026-09-09 docs: add rotor simulation research and the path off the velocity PID
    Surveys how small rotors are actually simulated for ArduPilot SITL in
    Gazebo, because our own attempts kept trading one instability for
    another.
    gz-sim ships MulticopterMotorModel, which commands joint velocity
    directly and computes thrust and reaction torque analytically, with no
    velocity PID. Its rotorVelocitySlowdownSim default of 10 exists for
    exactly the numerical stability problem we hit. ArduPilotPlugin's
    COMMAND control type publishes to a topic rather than driving a joint,
    so the force loop can be bypassed without patching upstream.
    ArduPilot's tuning guide states the default gains target a 9-12 inch
    propeller v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
    [ardupilot_params.parm]
2026-09-09 fix: rotate the IMU sensor into ArduPilot's aircraft convention
    ArduPilotPlugin states in its own source that it assumes the IMU sensor
    already reports x-forward, y-right, z-down. A Gazebo body frame is
    x-forward, y-LEFT, z-UP, so without a 180 degree roll on the sensor the
    Y and Z axes of both gyro and accelerometer reach ArduPilot inverted.
    The Iris reference model carries exactly this rotation; ours never did.
    Found by control experiment: the Iris with AHRS_EKF_TYPE 10 arms at
    once, reports level, and climbs cleanly to 2.27 m, while our model
    reported itself pitched -90 degrees and refused to arm. Ground-truth
    AHRS works fine through the JSON path, so the offset was ours.
    This cannot ye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
    [model.sdf]
2026-09-09 feat: rebuild the rotor drive on MulticopterMotorModel - the cinewhoop flies
    Replaces the eight LiftDrag surfaces, the four ApplyJointForce systems
    and the plugin's joint force PID with one MulticopterMotorModel per
    rotor, driven through the plugin's COMMAND control type. Thrust is
    motorConstant * omega^2 and yaw torque is momentConstant * thrust, both
    analytic, so there is no velocity loop left to destabilise at a 3 in
    propeller's inertia.
    tools/ap_actuator_bridge adapts between the two: ArduPilotPlugin
    publishes one gz.msgs.Double per rotor, while MulticopterMotorModel
    reads a single gz.msgs.Actuators array indexed by actuator_number.
    Three consecutive guided takeoffs armed, climbed and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
    [model.sdf]
2026-09-09 feat: start the actuator bridge from sitl_gazebo.launch.py
    Without the bridge the rotors never turn, so the launch file could bring
    up Gazebo and SITL and then sit there. Adding it makes the launch a
    complete flying setup: launch, then scripts/takeoff.py arms and climbs.
    Verified end to end headless: guided mode, armed, takeoff accepted.
    Also drops the stale note about the rotor model needing calibration
    before it can fly.
    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
2026-09-10 feat: add the RViz displays the iteration plan asks for
    cinewhoop.rviz carried Grid, RobotModel, TF and the front scan, but the
    plan's phase 9 also lists the downward rangefinder, the trajectory and
    the camera. Added all three; topics match the bridge config and
    trajectory_publisher.
    Fixed frame stays base_link: nothing publishes map -> base_link in the
    standalone display launch, and wiring that up belongs with phase 12.
    The visual criteria still need a GUI to confirm.
    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
2026-09-10 fix: repair check_iris_dds_control.sh, which could not see the Agent
    micro_ros_agent has no domain option and does not follow ROS_DOMAIN_ID,
    so it always joins the default domain. The ROS_DOMAIN_ID=78 added for
    isolation moved ros2 away from the Agent and hid every /ap/ topic, so
    the check failed with "AP_DDS services did not appear". The isolation it
    needs is already there as the dedicated Agent UDP port.
    Two more faults in the same script: cleanup blocked on `wait` for an
    ArduCopter that ignores SIGINT, hanging the runner and leaving a stray
    SITL on UDP/9002; and printf '%.2f' rejected the parsed altitudes under
    a comma locale, printing "584,00" instead of the measured value.
    Now exits 0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
2026-09-10 feat: give the autonomy demo its own takeoff, and guard stale scans
    simple_indoor_autonomy now arms and climbs on its own through ArduPilot's
    ROS 2 services, as phase 11 of the iteration plan asks, instead of only
    publishing velocity and hoping something else flew the vehicle. It is a
    state machine: prearm, GUIDED, arm, a wait on /ap/status.armed, takeoff,
    climb to altitude, then cruise. ardupilot_msgs is imported lazily so the
    velocity-only mode and the unit tests still work without the opt-in DDS
    workspace.
    Also fixes a real defect. _last_scan_time was written and never read, so
    a lidar that stopped mid-flight left its last range in place and the
    vehicle would have carried on forward. sca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
2026-09-10 fix: the autonomy demo flies - a stray node was commanding cmd_vel
    Phase 11 passes end to end: the cinewhoop arms and takes off through
    ArduPilot's ROS 2 services, creeps forward and holds for the wall.
    The blocker was never in the vehicle or in AP_DDS. `ros2 run` is a
    wrapper whose child does not die with it, so every run that reached
    CRUISE left a `simple_indoor_autonomy` node alive, still publishing
    `/ap/cmd_vel`. One survivor is enough: a GUIDED velocity command
    replaces the TakeOff submode, and the position-control submodes call
    `make_safe_ground_handling()` while `land_complete` is still true, so
    throttle output stays at exactly zero while every service reports
    success. Five orphans w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
    [indoor_test.sdf]
2026-09-10 feat: bring the whole demo up from one launch
    Phase 12. `sitl_gazebo.launch.py` now starts the Gazebo world, the
    ROS/Gazebo bridge, the actuator bridge, `robot_state_publisher` with
    RViz2, the Micro XRCE-DDS Agent and DDS-enabled SITL. `rviz`, `agent`
    and `sitl` are switchable, and `sitl:=false` prints the command for a
    separate terminal.
    Two details it had to get right: SITL loads `dds_smoke.parm` alongside
    the airframe parameters, without which no `/ap/` topic appears, and the
    Agent runs through a shell that sources its own workspace, since that
    workspace carries its libraries.
    Fixed a defect the phase exposed. In `display.launch.py` the `rviz`
    argument gated `joint_state_publisher` but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
2026-09-10 feat: calibrate the rotors to real hardware and scale the gains
    The rotor constants were derived from a chosen thrust-to-weight ratio of
    3.0, not from a propeller. Recalibrated against the target hardware, 4x
    GEPRC SPEEDX2 1404 3850 KV on 4S with ducted 3 in props: maxRotVelocity
    2600 -> 3980, motorConstant 2.611e-07 -> 2.20e-07, momentConstant 0.005
    -> 0.013, and the plugin multiplier with it since that is the
    full-throttle rotor speed. Thrust to weight is now 5.9 and hover sits at
    41 % throttle instead of 94 %.
    GEPRC publish no table for that KV, so the figures come from RCINPOWER's
    same-class 1404 3850 KV and community measurements of ducted 3 in props
    on 1404 motors, cross-checked again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
    [ardupilot_params.parm, model.sdf]
2026-09-10 fix: stop the demo early enough to keep the clearance it asks for
    The demo stopped for the wall exactly as designed and still ended up
    0.16 m from it, because a velocity command is not a brake. Measured from
    Gazebo ground truth at 59 Hz, speed decays from 0.50 to 0.15 m/s over
    1.1 s, an effective 0.3 m/s^2 and nowhere near the 2.5 m/s^2
    acceleration limit: what binds is ArduPilot's horizontal motion shaping,
    PSC_NE_VEL_P 2.0 with a 5 m/s^3 jerk limit.
    That smoothness is the point on a camera platform, so the decision moves
    earlier rather than the braking getting harder. safe_forward_speed takes
    a braking distance and stops at clearance plus braking, defaulting to
    the measured 0.6 m. Clearan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
2026-09-10 fix: a RELIABLE pose subscriber never matched AP_DDS, and services were hardcoded
    Milestone 10's topic mapping was already specified, so the work was
    checking the implementation against it. Two real gaps.
    The build spec requires the ArduPilot service names to be parameters so
    that moving off SITL changes the launch rather than the algorithm. All
    four were hardcoded in simple_indoor_autonomy; they are parameters now.
    `scripts/check_topic_remap.sh` joins baseline CI and asserts each node
    honours remapped names with the defaults gone, so a node cannot quietly
    listen on both. `ros2 node info` does not list service clients, so the
    service half is verified behaviourally:
    `scripts/fake_ardupilot_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
    [fake_ardupilot_services.py]
2026-09-10 feat: make the bridged sensors present the interface hardware will
    Every sensor in the model stamped its messages with Gazebo's own scoped name,
    because none of them set gz_frame_id. Those frames are not in the tree
    robot_state_publisher serves, so RViz silently drew nothing and a real driver
    would have published different names. The lidar, rangefinder and camera now
    carry front_lidar_link, rangefinder_link and camera_optical_frame.
    The bridged IMU was the sensor ArduPilot reads, which the model deliberately
    rolls 180 degrees into aircraft convention, so it reported -9.81 on z where
    REP 103 and AP_DDS both give +9.81. Every ROS consumer would have found its y
    and z inverted on real hardware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
    [model.sdf, openipc_cinewhoop.urdf.xacro]
2026-09-10 feat: report and act on a sensor that stops answering
    obstacle_monitor only ever warned about a scan that arrived with no valid
    ranges, so a lidar that stopped entirely made it go quiet, and a monitor that
    goes quiet when its sensor dies is worse than no monitor. It has a watchdog now.
    demo.launch.py hardcoded use_sim_time true. On hardware there is no /clock, so
    those nodes would read the same instant forever, every message age would compute
    as zero, and the stale-scan guard that stops the vehicle would silently never
    fire. It is a launch argument, the same rule as the topic and service names.
    check_sensor_dropout.sh proves the safety property without a simulator at all:
    it publishes a sc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
2026-09-10 feat: enforce that the URDF and the SDF describe the same drone
    The airframe is written down twice, once as Xacro for RViz and once as SDF for
    Gazebo, and nothing linked the two files. The drift is silent when it happens:
    the simulation keeps flying and RViz keeps drawing, just not the same vehicle.
    It had already happened, with rangefinder_link pitched in one and level in the
    other.
    The check compares where each shared link sits relative to base_link, how it is
    rotated, and what the whole thing weighs. Mass needed care: the URDF lumps
    0.240 kg into base_link because it only has to look right, while the SDF spreads
    it over the links physics acts on, so only the totals are comparable. Links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
    [check_model_consistency.py]
2026-09-10 feat: measure the attitude rate gains instead of calculating them
    The gains were derived once, by dividing ArduPilot's defaults by the ratio
    between this airframe's control authority and a ten-inch quad's. That got it
    flying on the first attempt, which is evidence the number is in the right decade
    and no evidence that it is the right number.
    sweep_rate_gains.sh flies the same roll square wave at a list of gains, one
    fresh Gazebo and SITL per point, and rate_step_response.py commands the steps
    through SET_ATTITUDE_TARGET and reports overshoot, rise, settle, tracking error
    and ringing.
    Eleven gains from 0.009 to 0.14. Everything improves monotonically up to 0.044,
    then the loop falls off a c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
    [ardupilot_params.parm]
2026-09-10 feat: one command to fly the demo, in a room long enough to see it
    front_obstacle stood at x = 1.8, so its face was 1.74 m from the spawn while the
    demo decides at 0.80 m of wanted clearance plus 0.60 m of braking. The vehicle
    reached cruise and stopped almost immediately: correct, and impossible to watch.
    The room is 10 m along x now and the wall is at 4.5, which turns 0.78 m of
    forward flight into 3.37 m with 0.99 m of rotor clearance.
    check_forward_flight.sh had the wall face written into it as a constant. It
    reads the obstacle's pose out of the world file now, because a number kept in
    two places is the same defect the URDF and the SDF had.
    demo.sh starts the scene, waits until ArduPilo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
    [indoor_test.sdf]
2026-09-10 docs: settle the airframe, and write down what the build needs
    Compared three airframes rather than assuming the chosen one. Two are out: no
    OpenIPC air unit runs on 1S, and AP_DDS needs an H7, which neither the
    Meteor75's G473 nor the Pavo20's F4 is. CineLog30 V3 with the MicoAir H743 V2
    stands alone, and the project has no lightweight fallback as a result.
    The component table's useful result is not the table but the cross-check: the
    bill of materials sums to 238 g with the battery, which looks like a match for
    the 0.240 kg the model flies on, except it omits wiring, screws and TPU. The
    stock airframe's own dry weight puts the real figure nearer 264 g. The front
    obstacle sensor then decide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
2026-09-10 docs: the parked front lidar measures the floor, not the room
    Parked, the lidar sits 37 mm above the floor and the rendered fan's lowest rays
    graze it, which returns a plane of constant depth at h/phi rather than anything
    in the room. From h = 0.037 m and a depth of 1.412 m, phi is about 1.5 degrees.
    Settled by elimination: the returns lie on a plane of constant depth rather than
    at constant range; the vehicle is at the origin and level; the loaded scene has
    all four models with the wall at 4.5; the reading is the same at 5 s and 25 s;
    an obstacle moved to x = 1.0 measures exactly right at 0.867 m. Spawning the
    vehicle higher moved the plane from 1.412 m to 1.267 m instead of removing it,
    w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
2026-09-10 feat: a CAD model of the whole drone, and the parts list behind it
    The build has a bill of materials but no geometry, so nothing could answer where
    the LD06 goes. spec/realna_stavba_dronu/05_cad_dily.md separates the two: the
    component table carries masses, voltages and interfaces, this one carries
    dimensions, mounting and position, with the same X-forward Y-left Z-up
    convention as the ROS model so the numbers can move between them.
    cad_claude/drone.scad models the assembly in OpenSCAD - parametric, text, and
    diffable next to the rest of the repo. openscad is in the dev shell now so the
    renders are reproducible without a display.
    What the model already says:
    - the LD06 has to sit above th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
    [drone.scad]
2026-09-10 feat: model the electronics as boards rather than blocks
    The flight controller, video unit, receiver and flow sensor were plain cubes,
    which hid the things that actually constrain the build: where the mounting
    pattern sits, which edge the USB is on, and how tall the stack gets once
    components and standoffs are counted.
    Each board now has a substrate with its mounting holes really cut, its
    components, and its connectors. The video board stands on standoffs above the
    flight controller, so the stack height follows from them instead of a guessed
    gap. The receiver's antenna is drawn because where it ends up is a real
    constraint, and the flow sensor's optics are on the underside where they look.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
    [drone.scad]
2026-09-10 feat: model the LD06 from its datasheet instead of guessing it
    The lidar was the largest placeholder in the model and every clearance on the
    nose is measured against it, so the guess was the wrong thing to leave in. The
    mechanical drawing in LDROBOT's datasheet has all of it.
    Verified: 38.59 x 38.59 x 33.30 mm overall, a 35.29 mm rotating head 12.60 mm
    tall, mounted on a 28.20 mm square of 2.5 mm holes with two of them opened to
    4.8 mm. The optical window is a 6.0 mm band whose top sits 7.6 mm below the top
    of the unit, so its centre is 22.7 mm above the base - that is the height the
    scan actually leaves at, and the number the propeller clearance has to be argued
    against. Electrically: 4.5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
    [drone.scad]
2026-09-10 feat: take the frame's real mounting patterns from GEPRC
    The frame was the last big guess in the model. GEPRC's own V3 page gives the
    patterns: 128 mm wheelbase, 2.5 mm carbon, FC on 25.5 x 25.5, motors on 9 x 9,
    camera on 20 mm, VTX on either 20 x 20 or 25.5 x 25.5, and 78 g plus or minus 2.
    That last pair matters - the EMAX Wyvern Link's 25.5 mm pattern fits the frame
    as sold, so the video unit needs no adapter.
    It also confirms this morning's wheelbase change was right, which was worth
    checking because a retailer listing said 126 mm. That listing is for the older
    GEP-CL30, sold under a near-identical name with 126 mm between motors, 2.0 mm
    plates and a 62.6 g frame. Written into the part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
    [drone.scad]
2026-09-10 docs: check the electronics actually connect to each other
    Nothing had checked whether the parts fit together electrically, only that they
    existed. Against what the MicoAir H743 V2 provides - 2-6S in, 5 V/2 A and
    12 V/2 A out, seven UARTs, a 45 A ESC - everything fits with room to spare: the
    5 V rail carries about 360 mA of a 2 A budget, four of seven UARTs are used, and
    a 4S LiHV's 17.4 V is inside the video unit's 2-6S window.
    Three things fall out of it that are not free, and they are on the backlog:
    - the LD06's connector is a ZH1.5T-4P on 1.5 mm pitch, where AIO UART headers
    are usually JST-SH on 1.0 mm. An adapter has to be ordered with it.
    - the LD06 is a brushed motor drawing 300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
2026-09-10 feat: make the simulated front lidar an LD06, on the mast it needs
    The forward fan was 60 degrees out to 8 m, standing in for a sensor nobody had
    chosen. The LD06 is chosen, so the model is now its datasheet: the full 360
    degrees at 1 degree resolution, 10 Hz, 0.02 to 12 m. It also moved to where the
    CAD model says it has to go, 46 mm forward and 50 mm up, clear of the propeller
    discs its 38.6 mm body would otherwise meet.
    The 360 degrees is the part that matters. Taking the minimum over the whole scan
    stops the vehicle for a wall behind it, and that is not a simulation artefact -
    the real sensor reports those returns too, so the demo would have failed the
    same way on hardware and only ther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
    [drone.scad, model.sdf, openipc_cinewhoop.urdf.xacro]
2026-09-10 feat: fly the mass the bill of materials actually says
    The model flew on 0.240 kg, which was the figure the requirement asked for
    rather than one anything was weighed against. The bill of materials with the
    LD06 says 0.306 kg, so that is what it flies on now, and the lidar's 42 g sits
    on front_lidar_link rather than in base_link because Gazebo composes the body
    inertia from where the links are and the whole point is that this mass hangs on
    a mast.
    That is not a number change. 42 g at 46 mm forward and 50 mm up adds about
    1.9e-4 to pitch inertia, as much again as the entire airframe had before, taking
    roll inertia from roughly 0.00028 to 0.00045. Hover throttle moved from 0.41 to
    0.46 and th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
    [ardupilot_params.parm, model.sdf, openipc_cinewhoop.urdf.xacro]
2026-09-10 docs: where each part is actually bought
    The component table said what the parts do, not where to get them. The useful
    finding is that one Czech shop, Rotorama, carries most of the bill of materials:
    frame, flight controller, motors, propellers, receiver, flow sensor and the
    RunCam video unit. Verified prices for four of those come to 226.63 EUR.
    Two practical things fall out. The frame is listed as on the way and the motors
    are out of stock, and they are the two items nothing can start without. And the
    LD06 is the one part that cannot be bought in the Czech Republic at all - TME
    lists it as withdrawn and the local 360 degree lidars start at 110 g - so it is
    an import, and the ZH1.5T-4P to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
2026-09-10 docs: price the whole build, including what the bill of materials leaves out
    The drone itself comes to 288.58 EUR from one Czech shop, video and lidar aside.
    Prices verified today against each product page rather than estimated.
    Two things worth having found. The video unit is sold two ways: 137.99 EUR at
    Rotorama for the camera and VTX alone, or 181.50 EUR at HobbyDrone for the same
    thing plus the USB WiFi card that receives it. The extra 43.51 EUR is the ground
    station, and without it no video reaches anything, so it gets bought either way.
    And OpenIPC needs no goggles - the stream is RTSP to a laptop, which is where
    this project wants it anyway, since the image has to end up as a ROS Ima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
2026-09-10 docs: leaning the drone makes the floor look like a wall
    The parked floor-grazing case has a sibling that matters more and is not handled
    anywhere. The LD06 is bolted to the airframe, so its scan plane leans with the
    vehicle; nose down, and the forward beams return the floor at h/tan(theta).
    At the demo's 1 m cruise it takes 35 degrees of lean before that reaches the
    1.40 m stop threshold, which is a wide margin for the gentle attitude 0.5 m/s
    needs. At 0.5 m altitude it takes 20 degrees, which is not an aggressive
    manoeuvre, and the vehicle would stop for the ground.
    The real fix is to transform returns into a gravity-aligned frame through TF and
    drop what is below a height threshold - it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
2026-09-10 docs: whether the ground station can keep up with the lidar
    It can, easily, and that is not where the difficulty is. The LD06 samples a
    fixed 4500 Hz, so at 10 rev/s it is 450 points per turn: 108 kbit/s raw, or
    288 kbit/s as a ROS LaserScan, which is 3.6 per cent of an 8 Mbit/s video
    stream. SLAM Toolbox on a laptop does not notice 450 points at 10 Hz, and at
    40 to 100 ms of link latency the vehicle moves 2 to 5 cm at demo speed.
    What actually decides it:
    - there is no data path planned. ELRS telemetry carries hundreds of bytes per
    second, so the scan has to ride the OpenIPC WiFi link beside the video.
    wfb-ng has a data channel; nobody has configured or measured it.
    - attitude. SLAM a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
2026-09-11 feat: stop the demo reporting the floor when the drone leans
    The lidar is bolted to the airframe, so leaning tips its scan plane and the
    forward beams find the floor, which returns a range like a wall does. At the
    demo's 1 m cruise it takes about 45 degrees to reach the 1.40 m stop threshold,
    but at 0.5 m it takes 22, and 22 degrees is not an aggressive manoeuvre.
    Returns are now projected into a gravity-aligned frame using the pose's roll and
    pitch and dropped when they work out to be the ground. The height comes from the
    downward rangefinder, and an unknown height discards nothing - an unknown
    altitude must not start throwing away real obstacles.
    The sign is the whole problem, so the geo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
2026-09-11 feat: stop the obstacle monitor reporting the floor when the drone leans
    The autonomy node already projected the front scan into a gravity-aligned
    frame and dropped returns that work out to be the ground. The monitor did
    not, so the two would have disagreed in flight: the monitor calling the
    floor the nearest obstacle at the same moment the autonomy node correctly
    ignored it, and the log contradicting the vehicle.
    Also fix what the demo says while it is stopped. It latched the fact of
    holding rather than the reason, so whichever reason came first was the only
    one ever logged - a vehicle that stopped for a stale scan and then stayed
    stopped because a wall appeared reported a dead lidar indef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
2026-09-11 test: lean the drone in Gazebo and check it does not stop for the floor
    The attitude compensation had eight unit tests behind it and no scan Gazebo
    had ever produced. `check_forward_flight.sh` cruises at 1 m with a gentle
    attitude, so the floor never enters the lidar's range there and the
    rejection was never exercised.
    `leaning_test.sdf` holds the model static at 30 degrees nose-down, 0.60 m
    up. Static is the point: `set_pose` does not reset velocity, so a falling
    model accelerates between teleports and the scan differs every run. Frozen,
    the lidar reports the floor straight ahead at 1.175 m and at 1.352 m on the
    edge of the forward sector, both inside the demo's 1.40 m stop threshold,
    iden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
    [leaning_test.sdf]
2026-09-11 fix: stop the model pinning itself to a world called indoor_test
    Each of the model's five sensors declared its own <topic>, and the obvious
    thing to write there is the name Gazebo would have generated - which
    contains the world's name. Under any other world the sensors kept
    publishing under the written name while ArduPilotPlugin looked up the IMU
    under the real one, found nothing, and never sent SITL a state frame. SITL
    resent the same servo frame forever, printing only "No JSON sensor message
    received", which reads like a network fault.
    Found by writing a second world and bisecting: the identical file passed as
    <world name="indoor_test"> and deadlocked as <world name="ramp_test">.
    The sen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
    [model.sdf]
2026-09-11 test: check ArduPilot reports the attitude the vehicle really has
    The floor rejection projects every lidar return using roll and pitch from
    /ap/pose/filtered, and nothing checked those are the vehicle's real
    attitude in the convention the projection assumes. A flipped sign there
    discards the ceiling and keeps the floor while every other test passes.
    ramp_test.sdf parks the vehicle on a slope tilted 20 degrees in pitch and
    10 in roll - both axes, so a roll/pitch swap cannot hide behind matching
    numbers - with friction well inside the 0.41 the slope asks for, so it
    settles instead of sliding. The check then compares three numbers that must
    agree: what the world file asks for, what Gazebo says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
    [ramp_test.sdf]
2026-09-11 feat: stop the demo trusting an attitude that stopped arriving
    The front scan had a staleness guard and the two things the floor rejection is
    run with did not, although neither arrives with the scan: the attitude comes
    from the flight controller over DDS and the height from a different sensor. So
    either can stop while the lidar stays perfectly healthy, and the node goes on
    projecting scans with a lean the vehicle no longer holds.
    Mostly that over-rejects, which holds the vehicle for nothing and blames the
    lidar in the log. It can also hide an obstacle: returns are dropped on
    `range * cos(bearing)`, so a lean removes a wall straight ahead before it
    removes a farther return at the sector edge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
2026-09-11 fix: read the rangefinder as slant range, which is what it measures
    The sensor points along the airframe's own z, so leaning it reports
    h / (cos roll cos pitch) rather than the height above the floor: 0.639 m in
    leaning_test.sdf where it is really 0.551 m up, an error of 16 per cent that
    grows as 1/cos. That is precisely the attitude at which the floor rejection is
    doing its work, and the reading is what the rejection calls a height.
    height_from_slant_range undoes it and compensation_height applies it, so what
    the nodes keep from a Range message is the slant it measured rather than a
    height it never was.
    Checked against the simulator rather than against the formula.
    gazebo_link_truth.py co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
    [check_leaning_scan.py, gazebo_link_truth.py]
2026-09-11 test: bank the drone, because a pitched world cannot see the roll term
    Everything that had ever produced a real scan was pitched and nothing was
    rolled, and those two are not equally tested. The drop a lean gives a return is
    `-sin(pitch) x + cos(pitch) sin(roll) y`: the pitch term is even in the bearing,
    so it is the same on both sides of the sector and a scan indexed the other way
    round the circle gives identical numbers. The roll term is odd. leaning_test.sdf
    therefore cannot see the scan's angular handedness at all, and a unit test
    cannot either - it writes both conventions itself.
    banked_test.sdf holds the model static at 25 degrees of roll and 20 of pitch,
    two different sizes so a roll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
    [banked_test.sdf]
2026-09-11 fix: project the floor from the lidar's height, not the rangefinder's
    The rangefinder is not the sensor whose beams are being projected. It sits
    26 mm behind the front lidar and 66 mm below it, so level the rejection was
    working with a height 66 mm too low - more than a quarter of the 0.25 m margin
    that was absorbing it. Leaning it is less, because the offset is bolted to the
    airframe and rotates with it: at 30 degrees nose-down the part ahead of the
    rangefinder swings down and gives some height back, leaving 44 mm.
    body_point_height is the third row of the rotation, written once and used twice:
    for a return in the scan plane, and for the offset between the two sensors. Two
    copies of those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
    [check_leaning_scan.py, check_model_consistency.py]
2026-09-11 feat: turn at the wall and fly on, instead of stopping there
    "Shouldn't it fly round the room?" - it can now, and it is a behaviour rather
    than a test. Blocked ahead, simple_indoor_autonomy yaws towards whichever side
    has more room and carries on. nearest_in_sector took a centre_rad so the same
    windowing and the same floor rejection answer what is off each wing; the
    rejection has to apply there too, because leaning, the floor is off the wing
    exactly as much as it is in front.
    Four decisions in it, each a way it could have gone wrong. Only an obstacle is a
    reason to turn: a stale or empty scan means the vehicle cannot see, and rotating
    on that is choosing a direction out of a picture it does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
    [room_test.sdf]
2026-09-11 feat: keep the room the vehicle flew round, instead of only flying it
    The circuit produced a flight and no result: the vehicle turned at each
    wall and kept nothing. occupancy_mapper ray-casts each accepted return
    from where the lidar was and publishes a 2D occupancy grid, in log-odds
    so repeated evidence accumulates and unknown stays distinct from
    fifty-fifty - which is the only thing that says where it has not been.
    It is stricter with itself than the other two nodes. They fall back on
    holding when the pose goes stale or the floor rejection switches off;
    this stops mapping, because their failure is a transient stop and its
    failure is a wall drawn where the vehicle never was, which stays.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
    [check_model_consistency.py]
2026-09-11 feat: root the TF tree in the world, so the map has somewhere to be
    robot_state_publisher served base_link and everything bolted to it, and
    nothing said where base_link was. The occupancy grid is stamped in a map
    frame that no transform reached, so nothing could place it.
    pose_tf_broadcaster publishes map -> base_link from /ap/pose/filtered.
    That message's header.frame_id says base_link and is wrong: AP_DDS fills
    the body from get_relative_position_NED_home swapped into ENU, so the
    content is where base_link is relative to home, and a pose saying where
    base_link is cannot be expressed in base_link. The label is ignored
    deliberately rather than silently.
    REP 105's map -> odom -> base_link i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
2026-09-11 fix: correct the clock finding, which was measured through a dead probe
    Last commit recorded that Gazebo publishes no clock topic at all. It
    publishes /clock, /stats and /world/<name>/clock. The probe that found
    "nothing" was missing GZ_IP and was not talking to Gazebo — it reported
    no dynamic_pose either, which every flight check reads every run.
    The conclusion survives, the cause does not. Measured in one instant:
    /clock 22.3 s, the bridged front scan 22.3 s, /ap/pose/filtered
    1789156172. Sim time from the simulator's start on one side, ArduPilot's
    UTC on the other, permanently. Nothing compares stamps across the two,
    so nothing is broken — except a consumer looking up map -> base_lin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
2026-09-11 feat: ask the coverage question where it is a question
    An empty convex room cannot answer it: the LD06 sweeps the whole circle
    and reaches 12 m, so a vehicle that is airborne at all has seen 96 per
    cent of an 8 by 6 m room whatever path it flew.
    cluttered_room.sdf puts two things in the way that differ on purpose - a
    pillar whose shadow sweeps across the room and fills itself in, and an
    enclosure with a pocket that has to be flown to. check_room_coverage.sh
    flies the circuit and measures the enclosure's inside separately from
    the room, and records the path as well as the map: a coverage figure
    alone cannot say whether the map is good because the path was good or
    because the room was easy.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
    [cluttered_room.sdf]
2026-09-12 fix: ask what is in the way, not what is in front
    way_is_clear took the nearest return in a 60 degree cone and wanted
    1.7 m of it. A 60 degree cone at 1.7 m is 1.7 m across, so an opening
    narrower than that could never read clear however well the vehicle was
    lined up on it - and the vehicle is 0.167 m wide. check_room_coverage.sh
    caught it as an explorer that chose the enclosure's 1.6 m door eight
    times in one flight while the demo turned away from it at 1.35 to
    1.40 m, eight times. That is arithmetic, not bad luck: no rule for
    choosing where to go could have got through that door.
    nearest_in_corridor asks about the swath the vehicle actually occupies -
    the rotor tips at 0.08335 m plus corr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
    [check_model_consistency.py]
2026-09-12 feat: go and look at what has not been seen, and work out a way there
    "Turn towards whichever side has more room" is enough to fly a room and
    not enough to cover one: it circles the open middle and passes a doorway
    all day, because the open middle is always the roomier side. Measured,
    that is 80 per cent of the enclosure in cluttered_room.sdf on a flight
    that never went in.
    frontier_explorer reads the published map for cells of known floor that
    touch unknown space, groups them into openings, and says which to head
    for. simple_indoor_autonomy steers at what it publishes and is otherwise
    the node it was: it still answers "may I move" and this answers "where
    to", and with the explorer stopped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
2026-09-12 feat: price the turn, so the explorer stops flying back and forth
    Nearest-by-distance oscillates by construction: fly to an opening, the
    opening is explored and stops being one, and the nearest of what is left
    is behind you. One coverage flight spent its whole second half doing
    nothing else - turns of 133, 143, 146, 171 and 172 degrees, one after
    another - and finished with the enclosure half done and 80 per cent on
    the board.
    A turn is not free and the vehicle knows exactly what it costs. Yawing
    at 0.4 rad/s while cruising at 0.5 m/s makes a radian of turn worth
    1.25 m of flying, so turning right round costs what four metres cost.
    route_cost_m adds that to the route's length and the cheape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
2026-09-12 feat: measure what the demo makes of a table, which is four dots
    The LD06 is one plane high - the datasheet sensor, not a simplification
    of it - so everything the vehicle knows about a room is a horizontal
    slice at the height it is flying. A table is the everyday shape of what
    that misses, and table_room.sdf puts one in the usual 8 by 6 m room so
    the question can be measured instead of argued about.
    The expected story was: fly at 1.00 m, pass 0.28 m over the top, see
    nothing; fly at 0.50 m, cut the legs, see it. Written that way the check
    failed, and it was right to. At 1.00 m the map held seven cells of the
    table anyway, because the plane is the airframe's and not the world's:
    it tips with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
    [table_room.sdf]
2026-09-12 fix: make the floor rejection an error bar, not a flat clearance
    ground_margin_m was 0.25 m of anything: a return computing out lower
    than that was floor. That answers "is this return low", and the question
    is "is this return on the floor". The two part company wherever a beam
    strikes something tall near its foot, which is exactly what a leaning
    vehicle's forward beams do - nose-down 5.7 degrees at 0.55 m, a wall 3 m
    away is struck 0.25 m up its face, and that return, the only evidence of
    the wall the vehicle is about to fly into, went in the bin as ground. A
    return's height is not an obstacle's height.
    An error bar grows with range, because an attitude wrong by an angle
    puts a return at ra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
    [table_room.sdf]
2026-09-12 feat: put it down when the pack runs out, and notice that nobody was watching
    Nothing read the battery at all. ArduPilot's own failsafe sat at its
    default, which is to do nothing, so a flight that ran the pack flat
    would have gone on hovering indoors until it fell out of the air over
    whatever was underneath it.
    Two layers, and the lower one is the one that matters when things go
    wrong. BATT_FS_LOW_ACT lands the vehicle at 3.5 V per cell whether or
    not ROS is alive; the demo node lands deliberately at the same point,
    stops commanding velocity and says why, so the flight ends as a decision
    rather than as a failsafe taking over mid-turn.
    The decision latches. A pack under load sags and recove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
    [ardupilot_params.parm]
2026-09-12 docs: write the specification this could be rebuilt from
    There was no document anyone could implement this from, and the one that
    looked like it would do the job was worse than absent.
    spec/05_demo_nody.md describes five nodes: frontier_explorer and
    range_adapter are not among them, simple_indoor_autonomy is a session
    behind, and it names parameters the code never had - target_altitude_m,
    turn_duration_s. A reimplementation working from it would build the
    wrong thing and have no way to find out.
    The algorithms are worse still. Everything that decides anything lives
    in the two helper modules - the corridor, the ground error bar, the
    frontier and its routing, the log-odds map, the turn cost -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
2026-09-12 docs: research the parts list, and find the hole in it
    Went through the bill of materials asking two questions it did not
    answer: what would you buy instead of each part, and what do people who
    already own them say. The second one turned up something the first was
    never going to.
    **The scan has no way into ROS on real hardware.** AP_DDS publishes
    eighteen topics and not one of them is a LaserScan or a proximity
    message - checked against the topic table in the tree, and the search
    found no pull request adding one. The simulation hides it completely,
    because there the scan comes out of Gazebo through ros_gz_bridge and
    never touches ArduPilot. On the real vehicle, obstacle_monitor,
    occupancy_m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
2026-09-13 feat: cost the Pavo20 Pro as an airframe, and fly it in simulation
    The H7 decision recorded the Pavo20 Pro as the fallback if the mass estimate
    became a problem. It did - with the LD06 the CineLog build is 294 g - so this
    is that revision, costed and then flown.
    On 3S the Pavo20 is worse and the reason is not the frame: halving the disc
    area takes only 21 per cent off induced power while the smaller pack takes 46
    per cent off the energy. On 4S with the same class of pack the two airframes
    match, at 229 g against 294 g and about 1 500 Kc less in three shipments rather
    than six.
    models_pavo20/ holds a model of the same name as the flown one, so all seven
    worlds and gz_bridge.yaml keep workin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
    [ardupilot_params_pavo20.parm, drone.scad, model.sdf, openipc_pavo20.urdf.xacro]
2026-09-19 docs: research the swarm, then research the machine under it
    Two literature reviews written the same day, kept as two folders because they
    are two storeys of the same building rather than competing drafts.
    reserseRoju/ asks how a group of these machines would be flown. Its conclusion
    is that ROS 2 must not reach the motors over the network: each drone keeps its
    own EKF, rate loop and failsafe locally, and the swarm layer above sends bounded
    position or velocity references. Hierarchical centralised control first,
    decentralisation only after two or three machines fly without collisions. The
    implementable part is 04 - data contracts, AP_DDS namespacing verified in the
    source rather than the do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
2026-09-19 docs: set the swarm task, and find the seam it has to be built along
    Three drones map cluttered_room.sdf in simulation, and the whole of spec/roj/
    is that one task: what gets built, what gets measured, and in what order. The
    world is the one the repository already scores, so the swarm has a number to
    beat rather than a demonstration to give.
    The task is stated as a split. One layer is a single machine that does not know
    a swarm exists; the other is a ground coordinator that may assume only what the
    contract in 04_rozhrani.md lists. Going through the open questions found where
    that seam actually is, and it is not where it would have been guessed:
    simple_indoor_autonomy already subscribes to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
2026-09-19 feat: align the model with what the shopping list actually buys
    The uncommitted work from 2026-09-14, landed as one commit because it is one
    piece of work: publishing the parts lists found that the simulation and the
    bill of materials had drifted apart, and everything here follows from closing
    that gap.
    models_pavo20/ was built from the airframe study, which chose LAVA 1104 5500KV,
    an iFlight Beast H7 and a 750 mAh pack at 0.2216 kg. The costing found the LAVA
    is not sold in this country at all, so the list buys Flashhobby A1204 5200KV, a
    MicoAir H743 and an 850 mAh pack, and the machine is 0.22934 kg. The model now
    follows the list rather than the study: maxRotVelocity 5950 -> 5580, per-li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
    [ardupilot_params.parm, ardupilot_params_pavo20.parm, model.sdf, openipc_pavo20.urdf.xacro]
2026-09-19 feat: measure the baseline the swarm has to beat, and how noisy it is
    M0 from spec/roj/07_plan_a_milniky.md: three runs of check_room_coverage.sh on
    the Pavo20, all green. The room reads 94, 93 and 93 per cent, the enclosure 96,
    95 and 94, and the vehicle went inside on every run.
    The spread is the point, not the coverage. Two points on the enclosure figure,
    four on a single wall, 16 cm on how deep the machine got inside. A swarm result
    inside that band is not a result, and this is the number M0 existed to produce
    - the check's own comment about a wall reading 47, 48 and 73 per cent across
    three runs was the warning that it can be much wider than this.
    Run 1 is the row worth keeping: the b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
2026-09-19 feat: measure the three terms of d_safe that were never measured
    M1 of spec/roj/07_plan_a_milniky.md. check_dynamic_limits.sh brings up the
    stack and measure_dynamic_limits.py flies one sortie in an empty room: three
    identical steps for the latency spread, steps at 0.25, 0.5 and 1.0 m/s for the
    braking distance, a ramp for tracking, and a stationary hover for drift.
    Measured on the Pavo20, two runs in agreement: coast 0.14, 0.33 and 0.78 m from
    those three speeds, latency from command to motion 0.340 to 0.392 s, ramp
    tracking 0.096 m/s RMS, drift 0.010 m over a 60 s hover. d_safe is 1.30 m plus
    a margin at 1 m/s, 0.58 m at 0.5 m/s. The script prints the sum with its terms
    and refuses to inv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
    [measure_dynamic_limits.py]
2026-09-19 feat: two autopilots on one ROS graph, neither wearing the other's name
    The first step of M2, and deliberately the one with no flight in it:
    check_multi_instance_dds.sh runs two SITL instances against one Agent on
    SITL's own quad model. No Gazebo, no actuator bridge, no propellers.
    It answers what spec/roj/05 listed as unverified: one Micro XRCE-DDS Agent
    serves both clients. 18 topics under /ap/v1/ and 18 under /ap/v2/, no bare
    /ap/time beside them, and both publishing rather than merely existing. The
    check also covers an acceptance item of M2 on its own - killing v2 leaves v1
    publishing, v2 returns as v2, and no third identity appears.
    --wipe writes eeprom.bin into the working directory,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
2026-09-20 feat: generate a model per agent, and record why they will not yet fly
    generate_agent_models.py writes one Gazebo model and one world per swarm
    agent into build/: the model renamed, its four <robotNamespace> entries and
    four rotor <cmd_topic> entries renamed with it, and fdm_port_in set to
    9002 + 10*index. Generation rather than hand-copying because the port is read
    only from SDF, and three hand-maintained copies would drift.
    The infrastructure works. Both autopilots reach the graph as /ap/v1 and /ap/v2,
    both models spawn at the poses spec/roj/08 R15 chose, and the
    identity-to-position mapping is right.
    The flight does not, and the reason is not in this repository: a renamed
    Gazebo model d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
    [generate_agent_models.py]
2026-09-20 docs: close off a line of attack by failing its control case
    The standing-Actuators method used to try to isolate the motor plugin from the
    autopilot does not lift gz-sim's own multicopter example either, driven the
    same way. So it measures nothing about our model, and the next attempt at this
    needs a driving method demonstrated on that example before it is pointed at
    our own.
2026-09-20 feat: build the coordinator's arithmetic, which needs no simulator
    M2 is blocked on a renamed Gazebo model not turning its rotors, and none of
    M4 depends on it: merging maps, assigning targets, keeping machines apart and
    tracking staleness are arithmetic, and arithmetic can be tested without a
    simulator. New package openipc_swarm with 40 tests, plus 9 for the arbiter in
    the demo package, both suites wired into ci.sh.
    The exploration arithmetic is reused, not rewritten. Frontier detection, the
    reachability sweep and the turn-aware route cost come from grid_helpers, which
    the single-drone explorer already uses and check_room_coverage.sh already
    measures - the same cost function on both sides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
2026-09-20 docs: correct the rename finding - it is the resource, not the entity
    Yesterday's entry concluded that a renamed Gazebo model stops turning its
    rotors and that "it is the entity's name". A control run refutes the second
    half: taking the flying setup and adding <include><name>v1</name>, with the
    model directory, model.config and uri all untouched, flies - twice. The
    earlier conclusion came from a variant that renamed the resource and the
    instance at once, and attributed it to the wrong one.
    What actually separates flying from not is how the world refers to the model:
    model://openipc_cinewhoop flies, model:// any other name does not, and an
    absolute path to a byte-identical directory does not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
2026-09-20 fix: make the airframe switch actually switch the airframe
    model:// is resolved by sdformat through SDF_PATH, not GZ_SIM_RESOURCE_PATH.
    The dev shell exports SDF_PATH pointing at the CineLog models; gazebo.launch.py
    overrides it per airframe, and the fourteen shell check scripts did not. So
    every check run with OPENIPC_AIRFRAME=pavo20 loaded models/openipc_cinewhoop -
    the CineLog - and flew it under the Pavo20's parameter file.
    Measured with exactly the environment those scripts build for pavo20: the
    model that loads is models/openipc_cinewhoop/model.sdf. With SDF_PATH added,
    the same command loads models_pavo20/openipc_cinewhoop/model.sdf. All fourteen
    scripts now export it.
    This invalida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
2026-09-20 docs: mark the d_safe terms as CineLog numbers, and log the substitution
    The table in spec/roj/03 kept its Pavo20 label after the airframe switch was
    found not to switch; the geometric term is the Pavo20's and the rest is not.
    workflow/log.md carries the finding, what it invalidates, and the retraction
    of the rename chase it explains.
2026-09-20 fix: give the Pavo20 model its own throttle scale, and fly it for the first time
    The ArduPilot plugin maps full throttle onto <multiplier> rad/s. The Pavo20
    model carried 3980, inherited from the CineLog where that is also the motor
    model's maxRotVelocity; the Pavo20's own maxRotVelocity is 5580. Full stick
    therefore reached 3980 rad/s, worth 1.79 times the airframe's weight, and
    hover would have needed 75 per cent throttle against the 53 its parameter file
    assumes. That is why it sat on the ground at 46 per cent and gave up.
    5580 is right, and the arithmetic says so three ways: 6.36e-8 * 5580^2 is
    1.980 N, which is 202 g per rotor and 807 g of thrust against the bill of
    materials' 202 g an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
    [model.sdf]
2026-09-20 feat: let the consistency check catch a model that cannot lift itself
    The check compared geometry and mass and passed the Pavo20 while its throttle
    scale made hover impossible. Two more numbers now have to agree, and nothing
    in the project made them agree before:
    - <multiplier>, the rotor speed full throttle asks for, against
    <maxRotVelocity>, the speed the motor model allows. Below it the airframe
    can never reach its rated thrust; above it the top of the range is clamped.
    - the hover throttle implied by the model - the speed needed to hold its own
    weight, over the multiplier - against MOT_THST_HOVER in that airframe's
    parameter file.
    Both airframes agree to 0.005 today, so the tol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
2026-09-20 feat: sweep the real Pavo20 and give it the gains it measures
    First sweep of this airframe that actually flew this airframe. With the
    throttle scale fixed and SDF_PATH no longer substituting the CineLog:
    0.020 never left the ground, 0.01 m of a 3.00 m target
    0.030 the same
    0.040 overshoot 8.1 %, rise 0.29 s, settle 0.82 s, rms 2.10 deg, 6 changes
    0.060 overshoot 7.6 %, rise 0.31 s, settle 0.91 s, rms 1.71 deg, 6 changes
    0.080 overshoot 8.4 %, rise 0.38 s, settle 1.08 s, rms 1.50 deg, 17 changes
    At the bottom of the range the Pavo20 is the opposite of the CineLog: too soft
    a rate loop and it cannot take off at all rather than wallowing up. At the top
    its 0.080 rings but sur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
    [ardupilot_params_pavo20.parm]
2026-09-20 feat: re-measure d_safe on the Pavo20 that actually loads
    With SDF_PATH fixed and the throttle scale corrected, M1 run again on the real
    airframe: coast 0.174, 0.426 and 1.001 m from 0.25, 0.5 and 1.0 m/s, latency
    0.324 to 0.408 s, drift 0.012 m over a 60 s hover. d_safe at 1 m/s is 1.56 m,
    against the 1.30 m recorded from what was actually the CineLog.
    The braking distance is 30 per cent worse and that is the whole of the
    difference. Latency and drift hardly move, which fits - one is the command
    path, the other the estimator, and neither belongs to the airframe.
    spec/roj/02 and /03 carry the new numbers in place of the invalidation
    notices, and test_safety.py follows them: D_SAFE_M 1.56,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
2026-09-20 feat: two agents fly in one world, and M2's blocker was never naming
    check_two_agents_fly.sh passes. Both autopilots reach the graph as /ap/v1 and
    /ap/v2, both models spawn where the generator puts them, v1 is told to climb
    and v1 alone climbs - the test a crossed fdm_port_in would fail - then v2, and
    they hold 1.92 m apart against a d_safe of 1.56.
    Nothing about naming had to change. The two days spent on "a renamed Gazebo
    model does not turn its rotors" were the Pavo20's inherited throttle
    multiplier, visible only in the renamed variants because those were the only
    ones that actually loaded the Pavo20 rather than the CineLog that SDF_PATH
    was substituting. The troubleshooting entry keeps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
2026-09-20 feat: fly three agents in one world, and measure what it costs
    check_two_agents_fly.sh becomes check_agents_fly.sh and takes a count, because
    a script named for two that flies three is a lie. One agent is allowed as the
    control case.
    Three fly. Each climbs on its own command with the others staying on the
    ground, and the closest approach between any pair while all three hold is
    1.94 m against a d_safe of 1.56. Real time factor is 1.0004 with one agent,
    1.0000 with two and 0.9991 with three, so M3's open question - what gets
    switched off when the simulator cannot keep up - has the answer "nothing", on
    this machine. On a slower one it is the first thing to measure again.
    Two bugs of my own i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
2026-09-20 feat: finish M0 on the Pavo20, and find the baseline is bimodal
    Three coverage runs on the airframe that now actually loads. Runs 1 and 2 read
    room 93 per cent, enclosure 94, 16 per cent of poses inside. Run 3 read 89, 92
    and 62 per cent inside: it went into the enclosure and stayed there, and the
    room outside paid for it - the x- wall fell from 93 and 97 to 83.
    The spread is the result. This policy on this airframe either commits to the
    enclosure or circles outside it, and which mode a run lands in dominates
    everything else, so the noise floor is 4 points on the room and 14 on a single
    wall rather than the 2 the CineLog showed. A swarm result smaller than that
    cannot be told from which mod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
2026-09-20 feat: cut the guided timeout from three seconds to the half second M1 derived
    At the default 3 s a machine that stops hearing commands at 1 m/s travels 3 m
    before it begins the 1.00 m it needs to stop, in a room 8 x 6 m. The swarm
    coordinator commands at 10 to 20 Hz, so 0.5 s tolerates five to ten lost
    messages and costs 0.5 m.
    It does not shorten a takeoff: the parameter covers velocity, attitude and
    rate control, and a guided takeoff is none of those. simple_indoor_autonomy
    publishes at 10 Hz through cruise and turns and deliberately publishes nothing
    while climbing, which is what keeps the takeoff submode alive.
    Reflown on the Pavo20, all three green and none of the numbers moved: guide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
    [ardupilot_params_pavo20.parm]
2026-09-20 feat: bring the CineLog onto the same half-second guided timeout
    Same reasoning as the Pavo20 and a shorter braking distance, so if 0.5 s is
    enough there it is enough here. Reflown: guided takeoff 2.08 m at 15.5 degrees
    of tilt, forward flight held 1.36 m off the wall with 0.89 m of rotor
    clearance, room coverage 94 per cent and enclosure 95 with 16 per cent of
    poses inside. Nothing moved.
    Both airframes now stop half a second after the commands stop rather than
    three, which is the property the swarm layer's separation argument leans on.
    [ardupilot_params.parm]
2026-09-20 feat: establish that the three agents share one EKF origin
    The last open risk in M2, and it needed no manoeuvre: the agents stand 2 m
    apart, so reading where each thinks it is answers it. v1 reports (-1.98,
    +0.49), v2 (+0.00, +0.49) and v3 (+2.00, +0.49) against ground truth of
    (+0.50, -2.00), (+0.50, 0.00) and (+0.50, +2.00). Each carries its spawn
    offset rather than reading zero, so the origin is the world's rather than each
    machine's own.
    That is what the merged map rested on. Three grids centred on the frame origin
    are centred on the same physical point, so merging them cell by cell is sound
    and R16 closes - the open-questions table in spec/roj/08 is now empty.
    The numbers also show th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
2026-09-20 feat: bridge each agent's sensors under its own namespace
    P3, and the last plumbing M2 needed. generate_agent_models.py derives one
    ros_gz_bridge config per agent from the single-drone template instead of the
    template growing placeholders: it substitutes the world, the model name and
    the ROS prefix, so /openipc_cinewhoop/scan/front becomes /v1/scan/front. The
    fourteen single-drone scripts that render the same template with sed on
    @world@ keep working untouched, which is why the substitution lives in the
    generator.
    /clock goes to the first agent only - three bridges forwarding one topic are
    three publishers on it, and that is a race, not redundancy.
    check_agents_fly.sh starts a bridge per a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
2026-09-20 feat: add the coordinator node, and keep it thin
    ros2 run openipc_swarm coordinator subscribes to each agent's pose and map and
    publishes a target and a speed constraint per agent, the merged map, and the
    assignment and safety logs. Smoke-tested: the graph comes up as expected and
    the node reports the d_safe it is holding.
    Everything it decides is decided by merge, assignment, safety and tracking,
    which have no ROS in them and 45 tests between them. What is left in the node
    is wiring - which is the part unit tests cannot reach, so there is as little
    of it as the job allows.
    One piece of arithmetic landed here and is tested with the rest: velocity by
    differencing consecutive poses, because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
2026-09-20 feat: stand up the whole swarm stack and close the loop
    check_swarm_mapping.sh brings up three agents in cluttered_room, each with its
    own ros_gz_bridge, occupancy mapper, autonomy and arbiter, plus the
    coordinator, and asserts the loop closes: every agent publishes a map, the
    coordinator publishes /swarm/map, and constraints come back to the agents.
    Checked by traffic rather than by a topic merely existing.
    Three copies of the demo stack is configuration, not a fork - every topic in
    those nodes is already a parameter - and the airframe's geometry is passed
    from check_model_consistency.py the way check_forward_flight.sh does it, so a
    variant cannot quietly fly the flown airframe's corridor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
2026-09-20 feat: fly the first swarm mapping run, and report it losing to one drone
    Three agents in cluttered_room, each with its own bridge, mapper, autonomy
    and arbiter, coordinated by the swarm node. The merged map calls 83 per cent
    of the room free and 86 per cent of the enclosure, against a single-drone
    baseline of 89 to 93 and 92 to 94. So the swarm currently covers less than one
    machine does, which spec/roj/01 named as a real possibility before any of this
    was written, and which is recorded rather than tuned away.
    The merge is sound and that is a separate fact: 7105 cells known in the merged
    map against 4194, 3651 and 3191 in the agents' own maps, so the union is
    genuinely larger than any singl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
2026-09-20 fix: derive separation from the flown speed, and find the frame bug under it
    Two reasons the swarm was stopping itself, and the second corrects an answer
    this repository recorded yesterday.
    The coordinator held the 1 m/s separation numbers while flying at 0.5 m/s, so
    d_safe plus the stopping room came to 2.96 m and three machines in a room 8 by
    6 m are never all that far apart: 3366 stops and not one slowdown. It now
    derives both from the speed it may fly, using M1's measured braking table -
    0.174, 0.426 and 1.001 m are not a v^2 curve, because most of a stop is the
    controller deciding rather than the airframe slowing. At 0.5 m/s that is
    d_safe 0.78 m and a stop line of 1.41 m.
    That alone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
2026-09-20 docs: put the swarm's unfinished work in the backlog, and stop leaking bridges
    The session recorded everything in workflow/log.md and spec/roj/ and nothing
    in the backlog, which is where unfinished work is supposed to be findable.
    Milestone 12 now lists it: the two frame bugs blocking M5, the per-agent
    acceptance runs and TF prefixes left from M2, the contract tests, the
    conflict threshold R17 asks for before a scored run, and the CineLog baseline
    that needs retaking under the new guided timeout.
    Also fixes a leak the tidy-up found: the swarm checks pkill'd parameter_bridge
    by a pattern built from the run directory, but the generated bridge configs
    live under build/, so the pattern matched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
2026-10-03 feat: flash the flight controller from a flake, and write the build down
    firmware/ is its own flake, apart from the ROS shell: ArduCopter 4.7.1
    stable for MicoAir743v2, pinned by hash, with `flash` for a board that
    already runs ArduPilot and `flash-dfu` for one that does not. The board
    came with ArduPilot 4.6.2, so it went over USB serial; the factory
    parameters, the ones right after the flash and the ones after setting the
    frame to quad X are kept in firmware/params/.
    The build procedure (14_postup_stavby_pavo20.md) points step 1 at it, and
    moves the accelerometer calibration to the assembled drone: a bare 26 mm
    board on USB cannot stand on its edges, the connector props it up and
    falls ou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
    [po_flashi_4.7.1_2026-10-02.parm, ramec_quadx_2026-10-02.parm, tovarni_2026-10-02.parm]
2026-10-03 docs: record what was bought for the Pavo20, and where it differs
    13_nakoupeno.md lists the Rotorama CZ order, the Walksnail video from
    Caddx and the frame from hobbydrone.cz, with prices off the invoices and
    the published weights marked as not yet weighed. The bill of materials, the
    components, the purchase plan and the alternatives chapter follow the
    purchase: a 750 and a 550 mAh pack instead of three 850s, the Walksnail
    Lite+ instead of the Wyvern, and the LD19, D300 and D500 compared against
    the LD06.
    The backlog gains what that leaves open on the build side: weighing, the
    model that still flies the 850 mAh pack, and whether ArduPilot's LD06
    driver takes the D500's sensor.
    Co-Authored-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
2026-10-03 fix: fly the swarm in the room's frame, and unjam the stop
    AP_DDS gives each agent's pose relative to where it started, so the
    coordinator saw three machines on one point and merged three rooms laid on
    top of each other. It now moves poses and maps into the room by each
    agent's start offset and sends targets back in the agent's own frame
    (frames.py). start_offsets is required, because zero is what the earlier
    flights used without knowing it; the generator prints it from START_POSES.
    That also explained "no agent ever assigned": now one is, because the
    merged map rarely holds more than one opening reachable at flying
    clearance. And it exposed a deadlock - a stop is a speed limit of zero, so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
    [generate_agent_models.py]
2026-10-05 feat: coordinate the swarm by viewpoints, filter it by barriers, and decide which by flying
    The coordinator work of 2026-10-03 to 10-05, from reserseRoju 06/07:
    - Viewpoints instead of openings and five allocators behind `allocator`
    (allocation.py), exploration memory (exploration.py), door reservation
    (passages.py), a barrier filter with the right-hand rule
    (velocity_barrier.py, R19a), and the enclosure-entry fixes of
    workflow/enclosure_fix.md.
    - The barrier's sideways motion is checked against walls from the
    agent's own 360-degree scan (wall_half_planes), loosened to what the
    autonomy itself asked for.
    - An agent that never armed: one lost prearm_check reply over XRCE-DDS
    le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
    [cluttered_room_complex.sdf, cluttered_room_corridors.sdf, cluttered_room_narrow_doors.sdf, cluttered_room_no_pocket.sdf]
2026-10-05 feat: measure where the swarm's time goes, and make turning a setting
    - The coordinator's turn cost follows the agents' turn rate
    (turn_yaw_rate_rps, max_speed / rate metres per radian) instead of a
    fixed 1.25; the swarm check takes OPENIPC_TURN_RATE and
    OPENIPC_STEER_MAX_OFF.
    - The replay writes map.wrong_cells (wall called free, floor called
    occupied) and the batch records it; batch versions T and T8.
    - 8 paired flights: turning at 0.8 rad/s instead of 0.4 brings the
    room's T90 3-4 s sooner but not the enclosure's, and costs a point of
    room coverage; 0.4 stays. With reservation off the narrow-door world's
    enclosure T90 is 25-29 s against a median 46 s with it.
    Co-Authored-By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
    [replay_swarm_run.py, swarm_batch.py]
2026-10-06 docs: record two tries at the swarm's time that made it slower
    - Turning in place only past 45 deg instead of 20 (T45, T845): a wide arc
    misses the 1.2 m door, enclosure T90 up to 84 s or never. 20 deg and
    0.4 rad/s stay.
    - Not counting climbing and turning agents as stalled (TS): the
    accidental spread after take-off goes, and the enclosure's T90 doubles
    in every pair. Reverted.
    [swarm_batch.py]
2026-10-13 feat: model the Pavo20 Pro holder for the Lite+ camera and a removable D500
    Parametric OpenSCAD assembly with printable base, TPU camera insert and
    a top bridge for the D500, plus the clearance, mesh and balance checks
    that regenerate the STLs and reports. The 43 MB downloaded cockpit STL
    stays out of git; its source link is in model/stazene/README.md.
2026-10-14 feat: pin an ArduCopter master build for osd:write, and keep the boards' parameters
    - firmware#firmware-master / flash-master / flash-dfu-master: the official
    4.8.0-dev nightly of 12. 10. 2026 (113108b) for the MicoAir743v2, which
    has Lua osd:write, flush and draw_screen; 4.7.x does not.
    - Nightlies vanish from the server after about a month, so the README says
    how to keep the files as a gcroot and how to move the pin.
    - Parameter dumps of both boards before and after flashing master.
2026-10-14 feat: record the D500 with the phone's camera, and play it back on the web
    - android/lidarcam: Pixel 9a app that records the rear camera and the D500
    on USB-C together and plays them back side by side; parser tests on real
    D500 bytes.
    - lidar/lidar_web.py + index.html: live view of the D500 over its CP2102,
    playback of the phone's recordings synced to their video, pulling new
    ones over adb, and a floor plan from point-to-line ICP of the turns.
    - Recordings, Gradle state and nix result links stay out of git.
2026-10-14 feat: show the VRX Pro on the PC with its OSD, and bridge it into ROS 2
    - vrx/vrx.py: the VRX's UVC picture (1080p MJPEG) in a window or headless,
    recording without re-encoding, an alarm on any VRX message not marked as
    fine, glass-to-glass latency, and the VRX's and Lite+'s temperatures over
    their USB serial port (otra.py, protocol in otra_protokol.md).
    - It also reads the lidar scan out of the OSD rows and draws it as a radar
    (L), with lidar/osd/osdvideo.py.
    - ros_ws/src/openipc_vrx: vrx_bridge publishes the picture, the scan from
    MSP DisplayPort and diagnostics; detector_node finds people with YOLO11n
    in ONNX. Not run yet: ROS 2 is not built on this machine.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
2026-10-14 feat: send the lidar scan through the Walksnail OSD, and read it back from the picture
    - scan_osd.lua bins each D500 turn into 144 x 2.5 deg, 9-bit log codes,
    three 77-character frames with CRC-16 on the bottom OSD rows; osdscan.py
    reads them from MSP DisplayPort (SITL: 3.1 turns/s, 0 bad frames).
    - The Walksnail font draws s-y exactly like b, d, f, h, j, l, n, so those
    seven symbols are now < > [ ] % @ / (same values).
    - osdvideo.py reads the frames out of the VRX picture: glyph templates
    learned from the VRX, a second guess for unsure cells and the CRC, linear
    over GF(2), to choose. A 25 s clip with the new alphabet: 479 of 479
    pictures read. --session makes a VRX recording int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
2026-10-14 docs: plan the scan's link through the Walksnail OSD, and start the custom boards
    - spec 15: how to get the LD06/D500 scan to the ground with the parts
    already bought (Bluetooth and OSD), and the bench result: the OSD reaches
    the VRX's UVC and the scan reads back at 1.9 turns/s.
    - spec 09/11/14 and README: the Walksnail appendix, parts and build steps
    updated; the ToolkitRC M6AC manual in Markdown.
    - dps/: research of open PCB projects, design, sources and requirements
    for custom boards for the Pavo20 Pro.
    - backlog: Bluetooth on the AIO checked (none), both ends of the OSD link
    written, and the OSD test's outcome.
2026-10-15 fix: read the scan in any VRX font, and pin the VRX to the Betaflight one
    - After a restart on 15. 10. 2026 the VRX drew the OSD with the Betaflight
    font: other arrows on a-o, a gauge on p, a thermometer on z, slashes for
    the packed decimals, and no scan read. MSP_OPTIONS 4 makes ArduPilot say
    BTFL to the VTX and send Betaflight symbol indexes, so the OSD is clean
    and the font the same every time.
    - osdvideo.py fits an unknown font from the CRC alone: cells grouped by
    shape, which shape is which character solved over GF(2), 16 equations a
    picture. A recording that mostly does not read is fitted first, and
    vrx.py does it live after 20 unreadable pictures. 01:51 walk: 871
    pictu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
2026-10-15 feat: send the FC's heading with every turn, and stitch the turns into a floor plan
    - scan_osd.lua puts the AHRS yaw (12 bits), roll and pitch (6 bits each)
    of the moment a turn finished before the CRC; a frame is 81 characters.
    osdscan.py and osdvideo.py read both lengths, the old 77 too (on screen
    by its four blank cells). SITL: 189 frames, 0 bad, 3.1 turns/s, with
    the simulator's heading.
    - stitch.py (nix run .#lidar-map) turns a recording into map.png: each turn
    rotated by the FC's heading, point-to-line ICP for the shift against the
    last 25 turns; without a heading it guesses the rotation from the turns.
    On a made-up flat with up to 90 degree turns between turns the path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
2026-10-17 feat: start our own H743 AIO from OpenAIO, with a switched VTX rail sized for DJI O3/O4
    - dps/flake.nix: KiCad 10 for the boards; `nix run ./dps#check` clones the
    OpenDrone projects at pinned commits and runs ERC/DRC on them.
    - dps/aio: one board instead of the MicoAir AIO. The 4 ESC channels, power
    and BMI270 sheets are taken from OpenAIO unchanged; a new sheet adds a
    switched 10 V buck for the HD VTX (its own, since +10V also feeds the gate
    drivers), INA226 on the VTX current, a DJI-pinout SH1.0-6P and the LD06
    ZH1.5-4P. The H743 core sheet is left empty with its interface, to be drawn
    by hand. The OpenAIO layout is kept, linked to the schematic, for F8.
    - docs: requirements an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
2026-10-17 feat: draw the clear part of the H743 core, document the AIO, and explain it on an interactive page
    - mcu_h743: STM32H743VIH6 (TFBGA-100) with supply and decoupling per ST
    AN4938 (100 nF per VDD + 4.7 uF, VDDLDO 4.7 uF, VCAP1+VCAP2 joined with
    2x 2.2 uF, VDDA and VDD33USB 100 nF + 1 uF, VBAT 100 nF), BOOT0 and
    PDR_ON, SWD/DFU pads, USB-C from OpenAIO, battery divider 100k/10k and
    I2C2 pull-ups; every pin labelled per the MicoAir743v2 hwdef. Crystal,
    baro, logging, second IMU and peripheral connectors stay open.
    - IMU INT2 (OpenAIO's CLKIN) left unconnected, as on the MicoAir; +5V_USB
    joins the power sheet; ERC is down to 17 errors, all explained.
    - NAVRH.md: every sheet and block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
2026-10-17 feat: describe the AIO to ArduPilot, derived from MicoAir743v2
    - dps/aio/hwdef/Pavo20AIO: firmware and bootloader hwdef with the same pins
    as MicoAir743v2 (the target the MicoAir AIO 45A runs), private board ID
    25026, battery scales for our divider and INA186, external compass only,
    OSD over MSP DisplayPort without the AT7456E, SPL06 and DPS310 probed
    until the baro is chosen, IMU rotations left for the layout.
    - defaults.parm: the VTX relay on PD13 (GPIO 57, on at boot) and the INA226
    on I2C2 as BATT2.
    - ArduPilot's hwdef generator accepts both files (pins, I2C, SPI, ADC, DMA);
    the firmware run stops only for the missing bootloader binary.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
2026-10-17 feat: build the bootloader and ArduCopter from the AIO's hwdef
    - dps#firmware: a devShell with the ARM compiler, make and waf's Python;
    mkShellNoCC, because mkShell's host CC/CXX win over arm-none-eabi in waf.
    - sestav.sh builds in a hard-linked copy of external/ardupilot (its waf lock
    files removed, so the SITL build keeps its board) and copies the .apj, the
    hex with bootloader and the bootloader into build/pavo20aio/. It checks for
    the bootloader itself, since build_bootloaders.py exits 0 on failure.
    - On ArduPilot 8b9ea70 both build: bootloader 20 kB with -Werror, ArduCopter
    1.44 MB with 268 kB of flash free. Not flashed: the board does not exist.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
2026-10-17 feat: add the crystal, baro, BMI088 and microSD to the AIO's H743 sheet
    - Y301 YXC X32258MOB4SI 8 MHz, CL 12 pF, with 15 pF load caps per
    AN4938/AN2867; gm_crit ~0.5 mA/V against the H743's 1.5 mA/V limit.
    - U302: one LGA-8 footprint for SPL06-001 or DPS310 (same package, pins and
    addresses as the BMP280), I2C at 0x77. Both chips report ID 0x10, so the
    hwdef lists only SPL06; a DPS310 swaps that one line.
    - U303 BMI088 on SPI2 as on MicoAir (PS low, SDO1+SDO2 on MISO, INT1/INT3 as
    data ready); J302 microSD from OpenAIO on SDMMC1 with 47k pull-ups.
    - ERC: 18 errors, the new one the BMI088's joined SDO outputs, as its
    datasheet asks for SPI. NAVRH, README, hwdef README and the web te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
2026-10-17 feat: add the peripheral connectors to the AIO, from the makers' pinouts
    - J303 SH1.0-6P for the WS-M181 GPS in the order printed on the module
    (TX RX GND 5V SCL SDA), with 4.7k pull-ups on the external I2C for its
    IST8310; J304 SH1.0-4P for the MTF-02P (GND 5V Rx Tx, robofusion; MicoAir
    draws the same signals from the other end). Neither maker says where pin 1
    is, so both are marked to check with a meter before first power.
    - Pads for the XR1 Nano (it has castellated pads, no connector), UART1 and
    UART8, and the free PWM5, 7, 9, 10, 11.
    - J201 pin 6 (SBUS from a DJI unit) now reaches USART6 RX only through JP202,
    open by default: the XR1's TX drives that line, and MicoAir's hard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
2026-10-17 feat: draw the AIO's RGB LED and buzzer switch, and keep the schematic generator in the repo
    - D301-D303 XINGLIGHT XL-1005 0402 with anodes on 3.3 V: ArduPilot's
    GPIO_LED_RGB lights with a low (HAL_GPIO_LED_ON 0). Green and blue are
    OpenAIO's parts, red C965790 from the same series; 330R/150R/75R, ~3-5 mA.
    - Q301 AO3400A low-side switch for an external active 5 V buzzer on pads
    BZ+/BZ- (BUZZ_ON_LVL 1), R319 holds it off through reset, D304 1N4148WS
    across the buzzer. A 2N7002 (Vgs(th) up to 2.5 V) would barely open at 3.3 V.
    - dps/aio/gen/gen_aio.py writes every sheet with stable UUIDs; it now finds
    OpenAIO and KiCad's symbols on its own and only copies the board, rules,
    project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
2026-10-17 docs: keep the AIO's OpenAIO outline and 25.5 mm holes
    Slotting the holes to 25.5-26 mm puts the top-left slot into 8 of the
    ~40 /CSA+ vias that carry battery current around it (DRC tried on the
    board, then reverted). An M2 screw on the Pavo20's 26 mm pitch still
    passes a 3 mm hole on 25.5 with 0.15 mm to spare, as on MicoAir, and the
    35.4 mm outline is smaller than the 36 mm we had copied from MicoAir.
2026-10-17 feat: update the AIO board from the schematic, and give the microSD slot its DAT1/DAT2 pads
    - gen/aktualizuj_desku.sh does what F8 does, without the GUI: matches
    footprints by UUID path, removes the 145 of the dropped OpenAIO sheets,
    adds the 93 new ones off the board, sets pad nets, keeps the copper of the
    10 nets that only changed name (MOTOR1-4, CURR, the IMU bus) and removes the
    845 items of the 70 nets left on nothing.
    - OpenAIO's TF-021B-H265 footprint had no pads 1 (DAT2) and 8 (DAT1): it reads
    the card over SPI. We use 4-bit SDMMC; the part has all 8 contacts, added at
    EasyEDA's positions, into the gaps the silkscreen had left for them.
    - DRC with parity: 238 unconnected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
2026-10-17 feat: give the AIO's new parts a rough first placement
    gen/rozmisti.py (aktualizuj_desku.sh --rozmisti) puts anchors where the
    OpenAIO part they replace was: the H743 on the RP2354's spot turned 180 so
    its USB and SDMMC balls face USB-C and the slot, USB-C and the microSD on
    their identical footprints, the baro on the BMP580, J201 on the SH-6, the
    pads on the small pads. The H743's decoupling goes under it on the back,
    everything else as near as it fits to the pads it shares a net with, on a
    0.2 mm grid, without courtyard overlaps.
    J303 (GPS), J304 (MTF-02P) and J202 (LD06) do not fit: 187 + 160 mm2 are
    free but in pieces, the connectors need 66, 52 and 86 mm2 in one. They stay
    off the boar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
2026-10-17 feat: give the AIO MicoAir743-AIO's peripheral connectors
    - J303 GPS (UART3 + I2C1), J304 UART4 and new J305 UART1 + UART6, SH1.0
    side entry, in MicoAir's order with pin 1 = GND (ArduPilot's README for the
    board puts pin 1 of the DJI connector at 12 V, the last row of its tables),
    so cables from a MicoAir fit. J305 replaces the XR1 and UART1 pads.
    - The LD06 goes to pads (TP201 Tx, TP202 PWM, 5V/GND on TP320/TP321) as on
    MicoAir: the ZH1.5 connector needed 86 mm2 in one piece.
    - Symbols and sheets now get UUIDs from their names, so adding or removing a
    part no longer shifts the others and breaks their link to the board.
    - Placement: J304 fits on the back right edge as on MicoAir. J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
2026-10-17 feat: put all four MicoAir connectors on the AIO's edge and place it without the INA226
    - The edge search found four spots no kept OpenAIO part blocks, so the ESCs
    stay as they are: J201 VTX front bottom, J303 GPS front right below motor 4,
    J305 UART1+UART6 back right, J304 UART4 back bottom. Motor pads are front
    only and the battery pads take the top edge, hence not MicoAir's places.
    - Pads as on MicoAir: new lib:Pad_1.0x1.4mm (courtyard 1.2 x 1.6) instead of
    1 mm round test points with a 2 x 2 courtyard.
    - Dropped for room, none of them on MicoAir: the VTX INA226 with its shunt,
    JP201 and the buzzer diode; Q301 is OpenAIO's AP1606 in DFN 1.0 x 0.6
    instead of an AO3400A in SOT-2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
2026-10-18 feat: fit every AIO part on the board: switch the VTX off +10V and take an ICM-42688-P as the second IMU
    The VTX buck and the BMI088 did not fit; the largest free spot was 2.5 x 2.9 mm.
    The VTX now hangs on fc_power's +10V behind a TPS22810 load switch (as OpenAIO
    feeds it, but switchable), and the second IMU is an ICM-42688-P on OpenAIO's
    LGA-14 footprint. The board update now also carries values and LCSC numbers.
2026-10-18 feat: place each supply capacitor right after its IC, on the nearer side
    They used to come after every big part and ended 8-17 mm from U303 and U201;
    now they sit 0.7-3.4 mm from their IC.
2026-10-19 feat: route the AIO with its own router after laying it out like MicoAir
    The peripherals sat where OpenAIO put them for the RP2354, so about 20 signals
    left the H743's BGA on the wrong side. The connectors now sit as on MicoAir,
    mirrored, and GPS, receiver, LD06 and both IMUs move to pins whose balls face
    them; SERIAL_ORDER keeps the SERIALn numbers. New scripts escape the BGA, clear
    OpenAIO leftovers, route in several passes, stitch GND islands and place the
    USB-C D+/D- jumpers. 134 of 156 pairs are routed, 22 remain, DRC is clean.
2026-10-19 docs: hand the AIO's last 22 connections over in a backlog, with a tool to see what blocks them
    The router stops at 22 unconnected pairs: it lays one route after another and
    never moves one, and around the BGA there is no room left to go around. The
    backlog lists each pair with its ends and what is in its way, and the way to
    finish them one at a time. `--okoli` prints the copper around a point with its
    net, gap and group. The firmware builds with the remapped pins.
2026-10-19 feat: run the AIO flow automatically on a copy, with a MicoAir V2 pin profile
    aktualizuj_desku.sh --auto copies the project, checks the netlist against the
    hwdef, allows only listed ERC/parity exceptions and judges the router by real
    DRC, keeping the best board. The micoair-v2 profile moves the UARTs and IMUs
    to MicoAir743v2-AIO-45A pins and generates a matching hwdef.
2026-10-21 docs: record the bench setup of board 2, with the ESCs evened out and motor directions fixed
    The receiver, switches, failsafe and 4S battery limits are set and tested
    on the bench. GPS, compass and lidar are switched off for now, with their
    original values written down for when they are wired. SERVO_BLH_RVMASK
    does not reverse AM32 2.19, so motors B and D are reversed in the ESCs.
    The QGroundControl binary is QGroundControl, not qgroundcontrol.
2026-10-21 docs: record the motor test and bidirectional DShot on board 2, and set its first gains
    The motor test runs A-D in the right order with the stock SERVO1..4
    outputs. Bidirectional DShot works on all four ESCs, with two traps: AM32
    only picks it up at its own power-up, so changing SERVO_BLH_BDMASK needs
    the battery and USB unplugged, and with sinusoidal startup it reports 0
    RPM at low throttle. At 15 % the four motors read 5040-5510 RPM.
    MOT_SPIN_* cannot be found without props, so the defaults stay.
    The rate gains come down to the simulation's, the battery capacity to the
    750 mAh pack, the motors get LiHV voltage compensation, and the gyro is
    batch-logged for the first flight's spectrum. The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
